OckerHazelbag/FunctionalSkin/Software/Arduino code/WhatsApp Image 2026-10-22 at 13.59.02 (2).jpeg

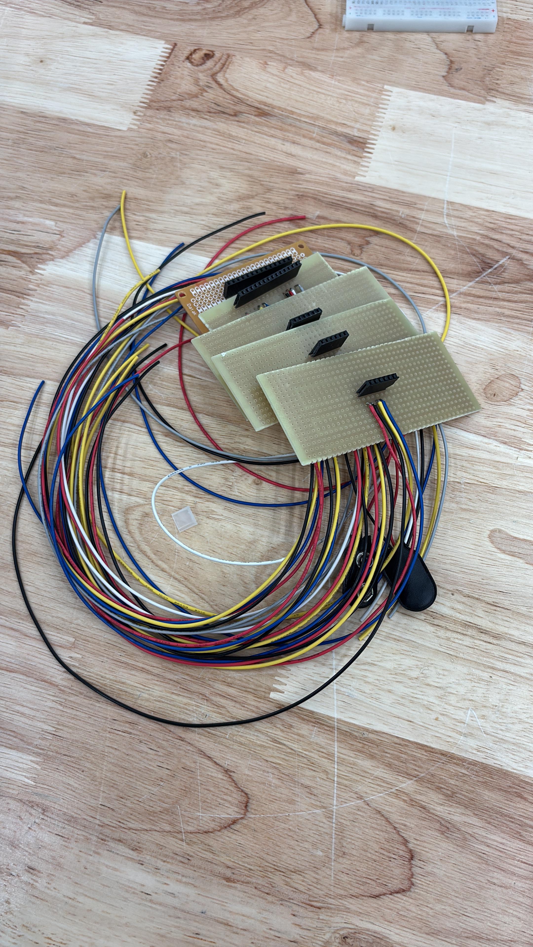
Software/Arduino code/WhatsApp Image 2026-10-22 at 13.59.02 (2).jpeg
