OckerHazelbag/FunctionalSkin/Documents/Functional Skin MIP FINAL REPORT-compressed.pdf

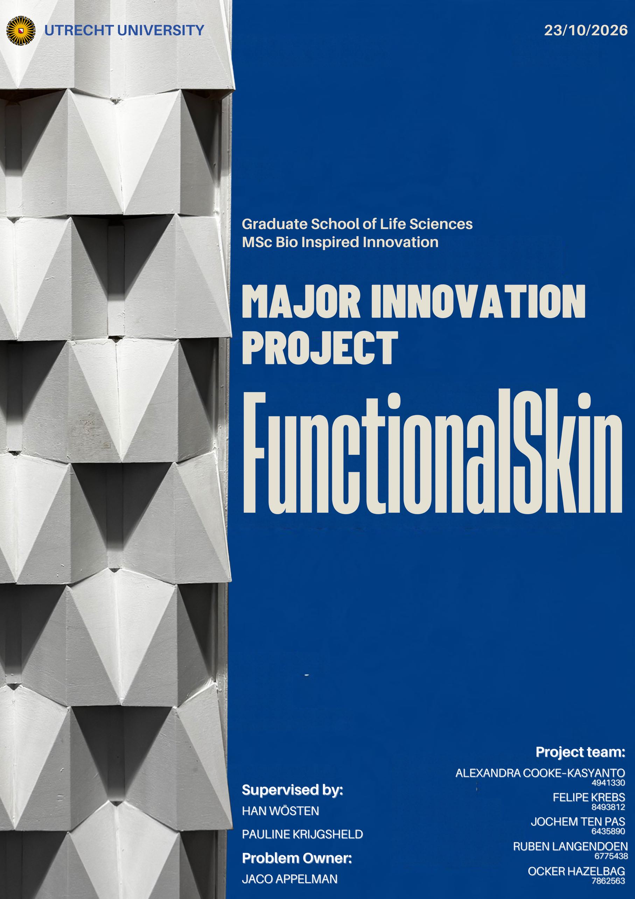
[picture p6: page 1]

FunctionalSkin | Major Innovation Project
MSc Bio Inspired Innovation | Utrecht University

## Layman summary

Urban heat stress is on the rise thanks to increasing global temperatures and inadequate cooling mechanisms in urban environments. To combat this, new methods are needed that are low energy, easy to implement and sustainable. We investigated how a modular panel installed on a building’s façade can help to passively cool the building’s outside and the immediate surrounding environment. It was found that a combination of a geometry that promotes air circulation, and a coating that combines solar reflection, with radiating its heat into space, can make for such a functioning panel.

Tests under simulated conditions of a hot Dutch summer day, showed that the temperature of the exterior wall of a building can be up to 30 °C lower with a passively cooling façade panel in front, than when fully exposed to the sunlight. The installation of such a panel could reduce active cooling energy demands and reduce temperatures in surrounding urban areas, which are the area’s most susceptible to extreme heat stress.

Furthermore, we investigated how this could be produced from biobased materials, like wood and fungal biomaterials. Some modifications, like coatings are needed to protect these natural materials from the outside conditions, like water and wind exposure. Nonetheless, it was shown through prototyping and experiments that a functioning passively cooling façade panel can be produced from these materials.

## Meet the FunctionalSkin team

We are the FunctionalSkin team from Utrecht University (left to right, top to bottom): Ruben Langendoen, Ocker Hazelbag, Jochem ten Pas, Felipe Krebs and Alexandra Cooke-Kasyanto. Our five backgrounds and perspectives come together in one shared goal: how can a building’s façade function like an urban living skin? Our façade panels help to cool buildings using similar techniques seen in nature, and do so completely passively – functioning without any need for energy!

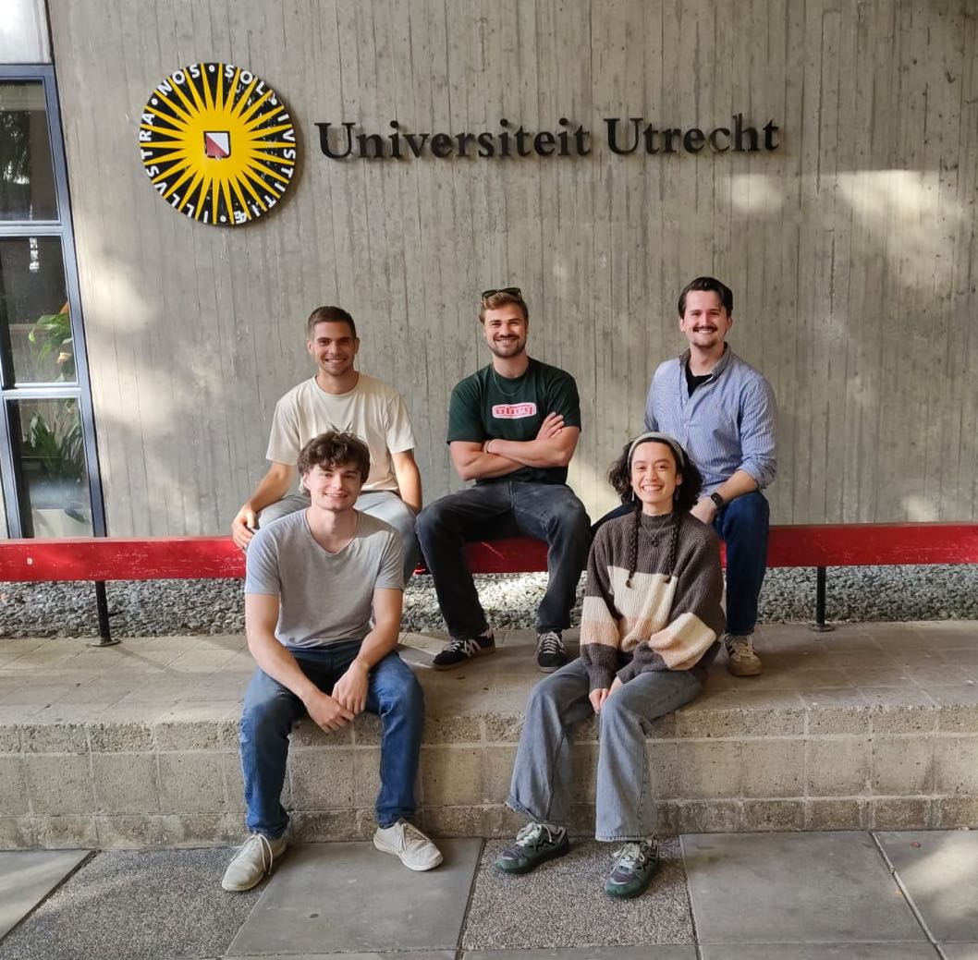
[picture p7: figure]

Index

## Abstract

Rising global temperatures intensify heat stress in urban environments and increase the need to cool down buildings in the Netherlands. This study investigates whether a façade panel can passively cool the outside of a building and its immediate surroundings. The panel combines a three-dimensional geometry, with cavities that remove hot air by convection, with a radiative cooling coating. Under simulated direct sunlight (800 W m⁻², 30 °C ambient temperature), we measured the temperature of the inner backwall behind the panel.

Compared with an unventilated bare backwall as a negative control, a flat panel with a radiative cooling coating already lowered the back-wall temperature from 64.0 °C to 46.2 °C. Adding the three-dimensional geometry and cavities reduced it further to 39.2 °C, and adding external airflow to simulate wind lowered it to 34.2 °C, only 4 °C above the ambient room temperature

Literature research and a Life Cycle Assessment (LCA) identified Douglas fir as the most suitable sustainable, biobased material, but plywood was chosen for prototyping purposes. We also tested heat-pressed mycelium-based composites (MBCs) as an alternative future material and showed that it can be formed into a three-dimensional shape. However, it needs more protection against outdoor weather conditions and less energy-intensive production before it could be implemented as a façade material.

## Graphical Abstract

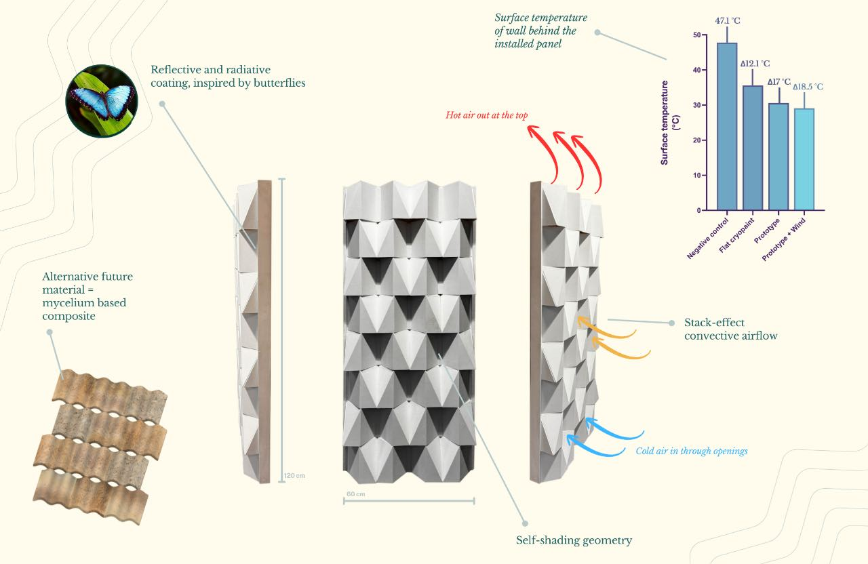
[picture p8: page 7]

## Theoretical background

Urban Heat Island effect
Rising global temperatures are impacting humanity and earth systems in many different ways. One of the challenges that arises in cities is the increasing severity of the Urban Heat Island (UHI) effect (Tong et al., 2021). This phenomenon is characterized by the difference in air-and surface temperatures between urban and rural environments. Several factors drive this mechanism, such as lack of greenery and elevated anthropogenic heat sources in cities (Jabbar et al., 2023; Masson et al., 2020). Another major contributor is the increased concentration of low-reflectivity (low-albedo) surfaces in urban areas (Andrés-Anaya et al., 2021).

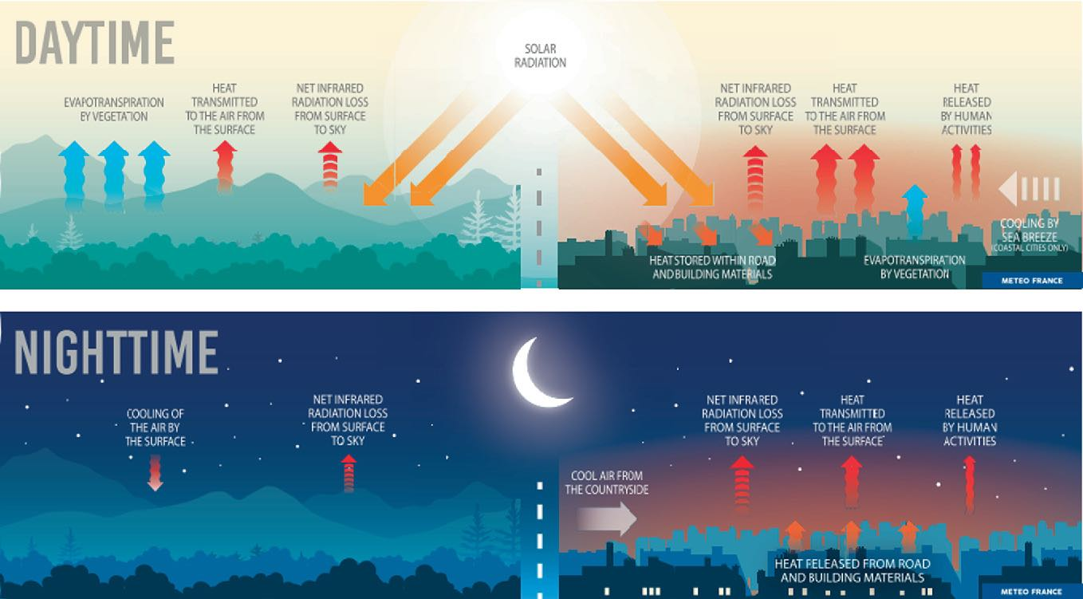
[picture p9: figure]

Figure 1: Processes driving urban heat islands during daytime and nighttime in rural (left) and urban (right) areas. Urban areas contain more surfaces that absorb solar energy during the day and release it at night, leading to higher temperatures at nighttime compared to the rural areas. Adapted from (Masson et al., 2020) Surfaces, such as roads, pavements, roofs and façades, have a low albedo, resulting in high absorption of incoming solar radiation (Ziaeemehr et al., 2023). These surfaces are often made from materials that possess a high heat capacity, such as asphalt and concrete, which can absorb more energy per degree of temperature rise than materials with a low heat capacity. This absorbed heat is then released at night, resulting in heated urban environments (Masson et al., 2020; Figure 1).

Researchers are conceptualising ways to mitigate the effects of UHIs, for example by reintroducing vegetation in urban areas, reducing the energy consumption of buildings and introducing high-albedo materials on roofs or façades (US EPA, 2014). The connection between building density and UHIs shows the opportunity that lies in redesigning buildings from drivers to barriers to elevated urban temperatures.

Retrofitting existing façades is one method to reduce the impact of buildings on urban heat, for example by introducing green walls, (retro)reflective coatings, phase change materials or thermochromic paints (Ahluwalia & Khurana, 2025; Han et al., 2015; Santamouris & Yun, 2020). A different way to approach it, is to design a façade cladding panel that also functions as a cooling panel. Currently, façade panels are mainly used for aesthetics, thermal regulation and weather protection (Thevega et al., 2022). However, by introducing an extra function within these panels, it is a possibility to create a multifunctional panel that is aesthetically pleasing, protects the building against weather conditions, and contributes to cooling the urban environment.
Passive cooling strategies
To design a panel that utilizes passive cooling strategies, it is necessary to know what passive cooling strategies exist. Nature serves as a useful guide to examine passive cooling methods. Organisms have to passively regulate their temperature, sometimes under energy constraints (Appendix B). Façade panels also have to deal with this constraint, which highlights the inspiration that can be gained from nature. Five passive cooling strategies of nature have been evaluated using scientific literature, namely evaporation, radiation, reflection, convection and conduction (Appendix B).

The most important findings from this literature research are the possible integrations of reflective, radiative and convective cooling strategies into the façade panel. An example of convection as a passive cooling strategy in nature can be found in termite mounds (King et al., 2015). Inside the mound, the air is warmer than the ambient air, resulting in the inside air rising by buoyancy while the cooler, more dense air sinks. This effect is called the stack (or chimney) effect and is already widely used in the construction industry in the form of ventilated façade systems (Girma & Tariku, 2021).

The potential integration of reflective and radiative cooling strategies into a façade panel also followed from the literature research (Appendix B). Reflection and radiation are closely related: for a surface to cool under direct sunlight, it must reflect most solar radiation, while simultaneously dissipating heat by emitting in the 8-13 µm atmospheric window. In this window, the atmosphere is almost transparent, absorbing close to zero thermal radiation (Pirvaram et al., 2022). Therefore, heat can be released to outer space without being retained in the atmosphere. Together, these two properties enable a net cooling effect during daytime.

Two other passive cooling strategies, conduction and evaporation, are present in nature, but were left out as strategy for cooling in this study. Evaporation has proven to be a successful strategy to cool buildings and the environment, as green walls and roofs have been widely implemented in architecture (Harbiankova & Manso, 2025). However, it often requires some type of active mechanism, such as watering, and is difficult to implement into a façade panel, combined with the other cooling strategies. Similarly, conduction was assessed to be outside of the scope of this project, and we therefore decided to focus on convection, reflection and radiation (Appendix B).

Previous students at Utrecht University and the HU University of Applied Sciences Utrecht have worked on creating a panel that passively cools buildings. This produced two outcomes: a conceptual design of panels inspired by tree bark (Pernice et al., 2022; Figure 2), and the design of a multi-layered panel with a specific three-dimensional geometry that employs convective cooling (Boer et al., 2025; Figure 2). However, what these projects did not assess is the possibility to combine convective cooling with radiative and reflective cooling.

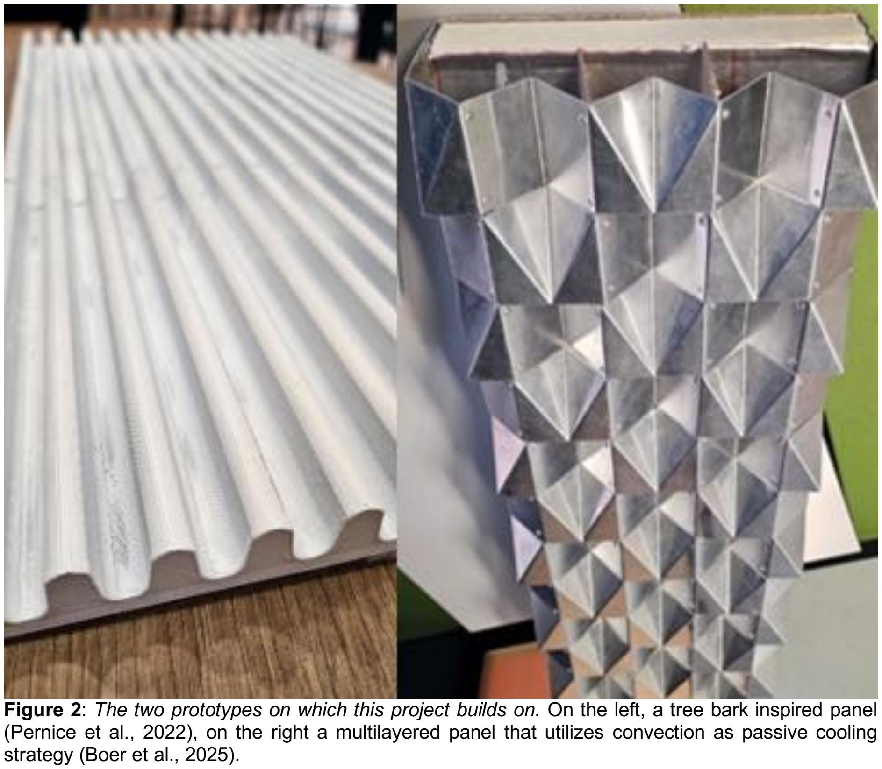
[picture p10: figure]
strategy (Boer et al., 2025).

Sustainable façade cladding materials
A cooling façade cladding panel can only contribute to a more sustainable urban environment if the material it is made from does not undo its benefits. Conventional façade systems carry a considerable environmental impact compared to their biobased alternatives (Alabdulrazzaq et al., 2026). Sustainable materials can reduce this impact, which is why their application in façade cladding is increasingly being researched (Sandak et al., 2019).

One of these materials is mycelium-based composite (MBC). MBCs consist of plant fibres, such as hemp or grass, bound together by a network of fungal hyphae, also called mycelium, which act as natural glue. MBCs have also been examined in combination with passive

Figure 2: The two prototypes on which this project builds on. On the left, a tree bark inspired panel (Pernice et al., 2022), on the right a multilayered panel that utilizes convection as passive cooling cooling. Soh et al. (2025) produced an MBC façade tile with a texture inspired by elephant skin, which retains water and thereby cools the surface.

However, this concept relies on evaporative cooling, which requires water, while moisture is precisely what limits the use of MBCs outdoors. Uncoated MBCs, such as those tested by Soh et al. (2025), have been shown to degrade after continuous exposure to weather and are therefore unsuitable for outdoor use (Ghazvinian & Gursoy, 2022; Motamedi et al., 2025). A possible intervention could be to grow a fungal skin on the MBC, which has been suggested to improve the hydrophobicity of the material (Appels et al., 2019). Moreover, the mechanical properties of MBCs can also be improved. Heat-pressing, for example, can improve the density, Young’s modulus and tensile strength of MBCs (Appels et al., 2019). Most heat-pressed MBC has resulted in flat panels and to our knowledge, heat-pressing MBCs into a three-dimensional shape has not been reported before (Andrade et al., 2026).
Research question and scope
Within our project, we set out to answer the following question: How can a façade panel, made from a sustainable material, passively cool buildings and their environment? One part of this project was therefore dedicated to producing a functioning panel with the highest cooling performance. In this part, we examined whether convection, radiation and reflection can be combined into one panel, starting with the geometry of Boer et al. (2025). We focused on innovating the outer skin by selecting a sustainable material, whose environmental impact was assessed in a Life Cycle Assessment (LCA), and by adding a reflective and radiative coating. The inner wall and insulation are considered outside the scope of this project.

The second part of our research focused on a sustainable material, MBC, and examined whether MBCs could potentially be used as a material for façade cladding panels in the future. By heat-pressing MBC into a three-dimensional shape, we investigated the possibility of producing individual MBC tiles which could be used for a façade panel. Furthermore, we tested what impact the three-dimensional shape had on the flexural strength and water resistance of the MBC. Lastly, we compared MBC to different types of wood to assess how long its lifespan should be to match their environmental performance.

The report is divided into three parts. Part A describes the design and prototyping of the panel and the choices made during this process. The first section of part B presents the outcome of the experiments which were conducted to assess the cooling performance of different panel configurations. The second section of B shows the research conducted on MBCs as a possible future façade cladding material. Part C addresses the implementation and business plan and analyses the intellectual property of our panel. Lastly, the general discussion evaluates the results of the experiments and discusses possible future integrations and research opportunities.

## Part A: Design and prototyping

In this part, the process that led to the design and development of our plywood prototype is described. This includes the requirements that were drafted for the design and material selection, the actual choice of material, the reasoning behind it and the chosen three-dimensional geometry of the panel. Lastly, the manufacturing method of the final prototype is described together with its dimensions and specifications. This part does not include the production of anything related to the MBC part of the project, which will be discussed in part B.3.
A.1. Design requirements and criteria
Façade cladding panels need to be multifunctional. As it is the outermost layer of a building, it needs to be both protective and aesthetically pleasing. In this project, we added an important functionality to the requirements: passive cooling. As convection was identified as the main passive cooling strategy, this impacted the design of the panel. The convective heat transfer is dependent on the geometry of the panel, as an increased and channelled surface area improves the buoyancy-driven airflow within the panel.

This led to three design requirements that were formulated in the Design Report (Appendix
D) (Figure 3). First, the cavity depth of the panel should be large enough to facilitate buoyancy-driven convection. The selected cavity depth ranges between 4 and 8 cm, similar to Boer et al. (2025). This is smaller than the depths of similar designs, such as solar chimneys (20 to 50 cm) or double-skin façades (70-120 cm). This reduced cavity depth offers the opportunity to examine whether convective cooling is also effective using smaller cavities.

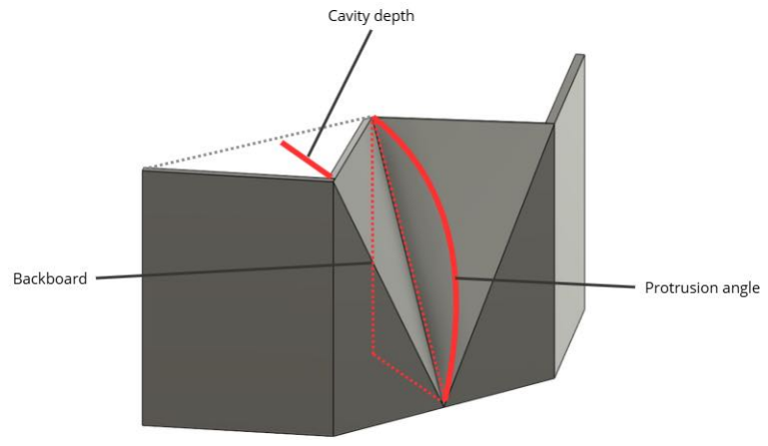
[picture p11: figure]

Second, the angle of geometric protrusions needs to improve the natural ventilation. No validated range for the angle has been established (Appendix D). The one study found, which looked different angles (0°, 30°, 45°, 60° and 80°) of venetian style blinds within a double-skin glass façade, reported that an angle of 80° promoted natural ventilation the most (by 35%) (Ji et al., 2007). The limitation of this study was that the blinds were behind glass and in windless conditions, so this study was mostly used as an indication. The precedent design by Boer et al. (2025) used an angle of 72°, which is close to the 80° found by Ji et al. (2007), and therefore also used in our design.

Figure 3: Visualization of geometric design requirements drafted in the Design Report. The protrusion angle is the angle between the protruding facet and the backboard. The cavity depth is the maximum distance between the backboard and the tile. The grey and red dashed lines indicate reference planes.

Lastly, the height of the panel must be sufficient to generate effective pressure differences to drive the chimney effect. For an optimised effect, the height of the façade should be more than two storeys (minimum of 6 m) (Appendix D). Therefore, it is important that the design of the panel allows continuous air movement through multiple panels.

These design requirements in turn impose a manufacturing requirement, namely that the individual tiles need to be formed into a specific three-dimensional geometry. Therefore, this became one of the defining criteria for the material selection, alongside several other requirements (Table 1; Appendix C). As a result of the drafted requirements, the material will need to be a thermal barrier, able to be painted or coated, lightweight and recyclable, as well as available to us and formable into the correct shape.

Table 1: Requirements on material properties. From left to right, the criterion, type of requirement (threshold or qualitative) and whether it is a hard constraint or ranking criterion. Reasoning behind certain thresholds or constraints can be found in the Material Selection Report (Appendix C).
Criterion | Threshold or qualitative | Hard constraint or ranking criterion

Thermal barrier

Thermal conductivity | Below 0.5 W m⁻¹ K⁻¹ | Hard constraint

Surface treatability

Paint/coating compatibility | Qualitative | Hard constraint

Weather resistance

UV resistance | Qualitative | Ranking criterion
Water absorption rate | Qualitative | Ranking criterion
Freeze-thaw resistance | Qualitative | Ranking criterion

Weight

Surface density | Below 10 kg m⁻² | Minimum requirement – Ranking criterion

Fire resistance

Fire resistance | Fire class B, s2, d0 | Ranking criterion

Sustainability

Recyclability | Qualitative | Hard constraint
Biodegradability | Qualitative | Ranking criterion

Biobased content | Qualitative | Ranking criterion

Formability & availability

Material availability | Qualitative | Hard constraint
Material formability | Qualitative | Hard constraint
Instrumentation availability | Qualitative | Hard constraint
Prototyping feasibility | Qualitative | Hard constraint

A.2. Material selection
The set of requirements in Table 1 was used to assess several materials that are commonly used in façade cladding systems (Appendix C). This included metals, glass, plastics, fibre-reinforced composites, Nabasco® (a commercially available bio-composite cladding material used in the Netherlands), mycelium-based composites (MBC) and wood. In the end, wood was selected as material to use for the panel, as it was available, recyclable and lightweight. Additionally, wood can be painted or coated and possessed the required thermal barrier properties (Table 2).

Table 2: Materials assessed based on the requirements from the Material Selection Report and the decisive criterion by which it was rejected.
Material / material class | Outcome | Decisive criterion
Metals | Rejected | Thermal conductivity
Glass | Rejected | Weight, formability and thermal conductivity
Plastics | Rejected | Recyclability
Fibre-reinforced composites | Rejected | Weight and recyclability
Nabasco® | Rejected | Weight, availability
Mycelium-based composites | Rejected | Weather durability
Wood | Selected | Passed all hard constraints

The next step was to assess which type of wood would then be most suitable for the façade panel. For this, the wood types most commonly used for façade cladding were assessed on natural durability classification, density, price and sustainability. Additionally, wood modification methods were discussed. Douglas fir was identified as most suitable regular wood type for the panel production, as it is durable, cheap, lightweight and available (Appendix C). A potential other type of wood was thermally modified spruce (TMS), which is more expensive but also more durable and dimensionally stable than Douglas fir (Appendix C).

At the prototyping stage, however, it became apparent that thicker cuts of wood would impose difficulties in manufacturing. The 20 mm thick planks made manufacturing with the computer numerical control (CNC) mill, which we selected for producing the grooves in the individual tiles, more time intensive and increased the weight of the façade significantly. Therefore, plywood was used to make the first prototype of the façade panel, as it is thin, cheap and available in large sheets. Although plywood (excluding exterior/marine plywood) is not suitable for outdoor conditions, the prototype was not tested on weather durability, making plywood a suitable and justified material for this prototype.

To decide on the final material for the design, the four considered types of wood (Douglas fir, indoor and outdoor plywood, TMS) were assessed on environmental impact in a cradle-to-gate LCA, where they were compared with MBCs (Appendix E). The functional unit (FU) of this LCA was 1 m² of façade coverage by the panels. This analysis was then related to the lifespan of each material to examine whether increased production impact is justified by longer durability of the material (Appendix E).

Douglas fir was calculated to have the lowest global warming potential (GWP), both in total (~ 4.02 kg CO₂e/FU) and per year (0.27-0.40 kg CO₂e/FU; Table 3). TMS had the second least yearly GWP, whilst having the highest CO₂e output in total (Appendix E). This is mainly because of the increased lifespan resulting from the thermal modification.

MBC had the second lowest GWP (~11.34 kg CO₂e/FU), less than both plywoods and TMS. This suggests that MBC has the potential to be an environmentally competitive construction material, in terms of production impact, if weather durability can be increased. As of yet, the lifespan in outdoor conditions of MBC has not been assessed (Lewandowska et al., 2025), which is why no estimation of the GWP per year is given in Table 3. MBCs need to last for 28-42 years to have the same GWP/year as Douglas fir, or 10-13 years to have a comparable yearly GWP as TMS.

Table 3: Comparison of global warming potential of each material relative to its service life. Derived from the LCA (Appendix E).
Material type | GWP (kg CO2e/FU) | Lifespan (in outdoor conditions) | GWP/year
Douglas fir | 4.02 | 10-15 years | 0.27-0.40
Indoor plywood | 13.53 | 1 year | 13.5
Outdoor plywood | 15.52 | 5-10 years | 1.55-3.10
TMS | 22.10 | 20-25 years | 0.88-1.11
Mycelium-based composite | 11.34 | Unknown | Unknown

The research on heat-pressed MBC and plywood as materials for the prototype were conducted in parallel. The development of the plywood panel is described in the next section, whereas the research on heat-pressed MBC is presented in part B.3.
A.3. Design development and selection
The concept and design of our panel started with the panel that was produced by Boer et al. (2025). This panel involved a faceted design incorporating small air gaps, or “chimneys”, to create a convective airflow that passively cools. This multifaceted design simultaneously resulted in a self-shading effect. The measured effect of this panel was small: an air speed of 0.3 m s⁻¹ in the cavity and a 3.4 °C reduction in temperature of the backwall was observed.

Studies using comparable designs showed that such faceted designs can have a cooling effect on buildings. A study in Dubai recorded a 10 °C temperature gradient between the upper and the lower part of a façade, indicating a temperature-driven airflow (Pujadas-Gispert et al., 2020). Similarly, Summa et al. (2025) found that a faceted design can reduce the temperature by 10 °C compared to a flat panel, as well as decreasing the temperature of the corresponding backwall by 1.3 °C, highlighting the self-shading effect of the design.

Based on these results, it was decided to develop a panel with the same shape. Inspiration to further innovate the design was acquired from the Cooling Mechanisms Report (Appendix B). For example, inspired by cacti, a ridged design was considered, as it could increase the self-shading potential of the panel and act as additional air channels to increase convection. When this iteration was modelled, it proved to be difficult to align the ridges at the points where they cross the facet edges (Figure 4). This could not be resolved within the timeframe into a form which could be cleanly cut by the CNC. Therefore, the ridged design was dropped from the project.

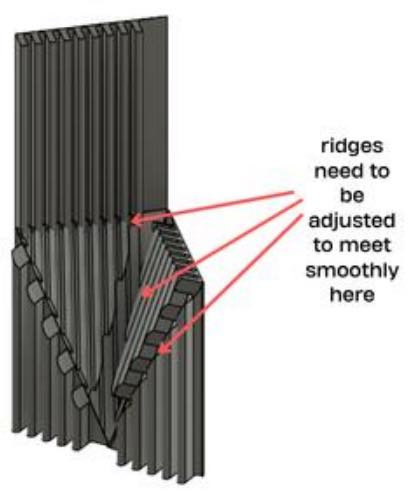
[picture p12: figure]

Additionally, reflective and radiative coatings which mimic the cooling capabilities of the Saharan silver ant were examined. The microstructures that this insect utilizes were too small to replicate at this scale, which is why different commercially available reflective and radiative coatings were tested. The outcomes of these experiments will be discussed in Part B.2.

The decision to make modular, 15 x 15 cm tiles, which together would form the larger panel, was inspired by Pujadas-Gispert et al. (2020). In this study, they created larger, 30 x 30 cm tiles of Nabasco®, which they installed onto a plywood backboard. This led us to the decision to make modular tiles of wood which we would then install on a wooden backboard.

To develop the modular, 15 x 15 cm tile, a laser-cut first prototype was assembled from scrap plywood and resulted in gaps between part of the tiles (Figure 5). Therefore, grooves were milled into individual cut plywood, while keeping the outer veneer of the plywood intact. This method, used in other woodworking practices, can result in a seamless outer layer (Steve Szell, timber specialist, personal communication, 24 April 2026). This resulted in tiles that were folded into the correct shape upon heat and steam pressure, resulting in a seamless outer layer.

Figure 4: The design of a ridged tile. The arrows indicate the points where the facet edges cross, which proved to

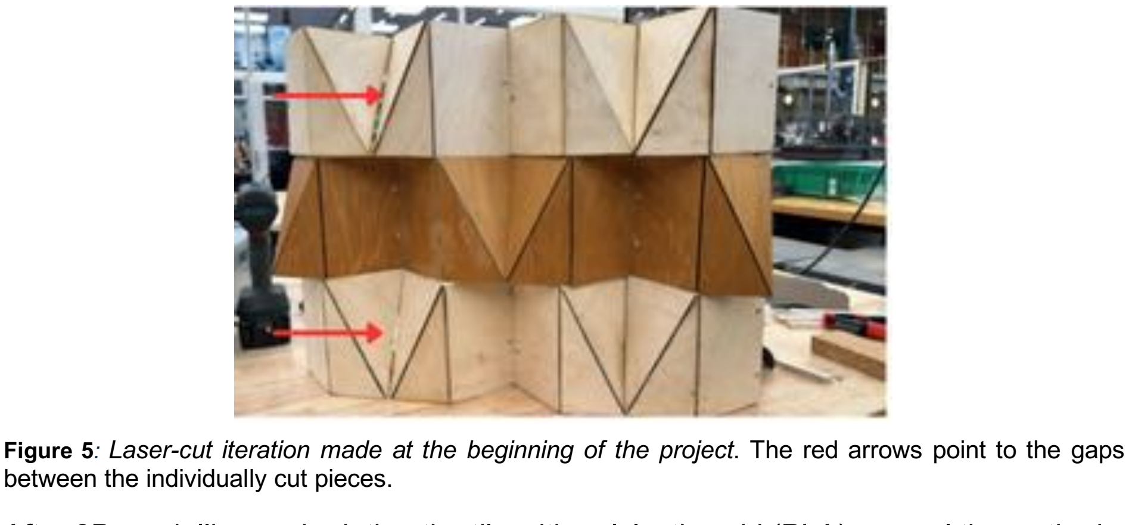
[picture p13: figure]
between the individually cut pieces.

After 3D-modelling and printing the tile with polylactic acid (PLA) several times, the best way to design the top corner joints, where the three facets meet, was determined. At first, the top corner joints did not align, which imposed difficulties with folding the tile into the correct shape. This led to a reorientation of the angles of the top corner joints, ensuring a clean fold and a 135° angle along the groove (Figure 6). These refinements resulted in the final design of the tile, which was created in Fusion 360 (Autodesk, San Rafael, CA, version 2704.1.15). From this, a toolpath to an open-source CNC router was generated, which could then be used to cut the tiles from plywood sheets using the CNC mill.

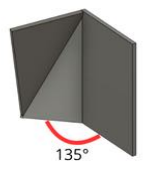
[picture p14: figure]
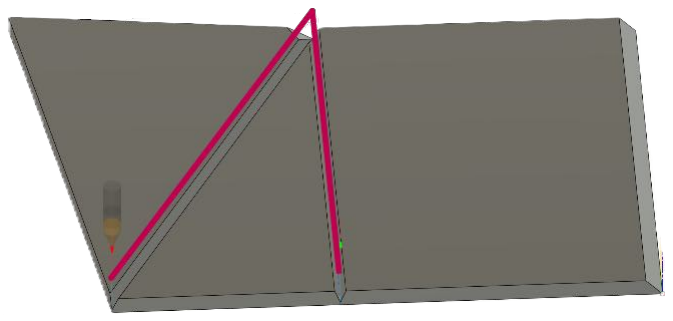
[picture p15: figure]

The final design that was used for the prototype was a 15 x 15 cm tile with the shape that was used by Boer et al. (2025). Two inverse versions of the tile were developed, sixteen of each, which would then be mounted onto a 120 x 60 cm backboard. The individual tiles were milled using the CNC and folded into the correct shape. The full manufacturing of the panel will be discussed in Part A.4.
A.4. Manufacturing and assembly
The tiles were produced using a CNC mill (CNC-Step, High-Z S720T). This ensured consistent cuts across all tiles and allowed the exact angles and depth of each groove to be set. It also could demonstrate the potential ability to scale up the production, if proven to be

Figure 6: Toolpath of 45-degree V-groove and the resulting 135° angles after folding

Figure 5: Laser-cut iteration made at the beginning of the project. The red arrows point to the gaps a successful method of manufacturing. The folding step, however, was completely manual, which could have impacted the accuracy of the folded geometry.

The created toolpath consisted of three milling operations, each with a different bit: to create the angle that needed to be mounted to the backboard, a 90° V-groove milling bit was used. A flat-top milling bit was used to trace the contour of the tiles; and a 45° V-groove milling bit was used to produce the 135° folds needed for the design (Figure 6). The 45° path was cut to a depth leaving approximately 1 mm of material, so that the plywood could be folded at that position while the outer veneer layer stayed intact.

For the two V-groove milling bits, a spindle speed of 26000 rpm was used, while for the flat-top milling bit, a spindle speed of 32000 rpm was used. By posting the toolpath in Fusion 360 (Autodesk, San Rafael, CA, version 2704.1.15) the file was converted into a G-Code file, which could be read by the CNC router. Using this G-code, six tiles at a time were milled out of 65 x 34 cm plywood sheets with a thickness of 5.5 mm (Figure 7). To get a seamless connection of the tiles on the backboard, a 5 mm strip was removed from each tile at the 45° angle by sawing.

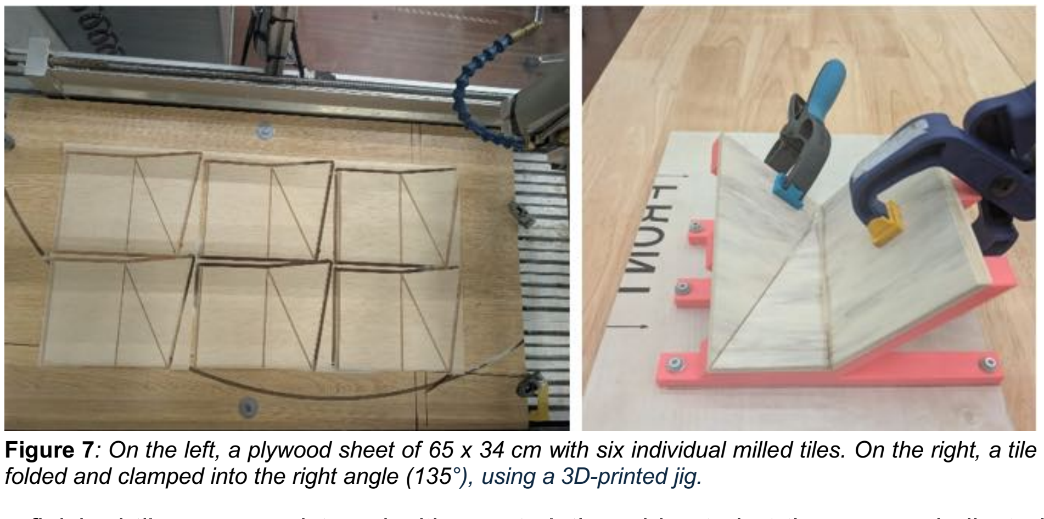
[picture p16: figure]

The finished tiles were moistened with a wet cloth and heated at the groove dedicated for bending with a handheld clothing steamer (Pure POP DT2022, Tefal) for ~ 2 min to induce flexibility of the wood fibres. Under continued heat application via the steaming iron they were folded to 135°, held in this position using a 3D-printed jig (Figure 7) and bonded using polyurethane construction adhesive (Bison Konstruktielijm, EN 204 class D4). Each tile was clamped for four hours, following the manufacturer’s manual. The exact dimensions of the panels as they were manufactured in the CNC as well as the dimensions of the 3D-printed jig can be found in the supplementary data (Appendix I).

The backboard was constructed using 48 x 22 mm spruce battens (KONSTA Vuren panlat ruw 22 x 48 x 2100 mm, Hornbach), joined with waterproof wood glue (Pattex, EN 204 class D3) and 35 mm nails using a nail gun (Bostitch Tacker SB-2IN1-E). Five battens run lengthwise and nine across, resulting in a 120 x 60 cm backboard.

Figure 7: On the left, a plywood sheet of 65 x 34 cm with six individual milled tiles. On the right, a tile folded and clamped into the right angle (135°), using a 3D-printed jig.

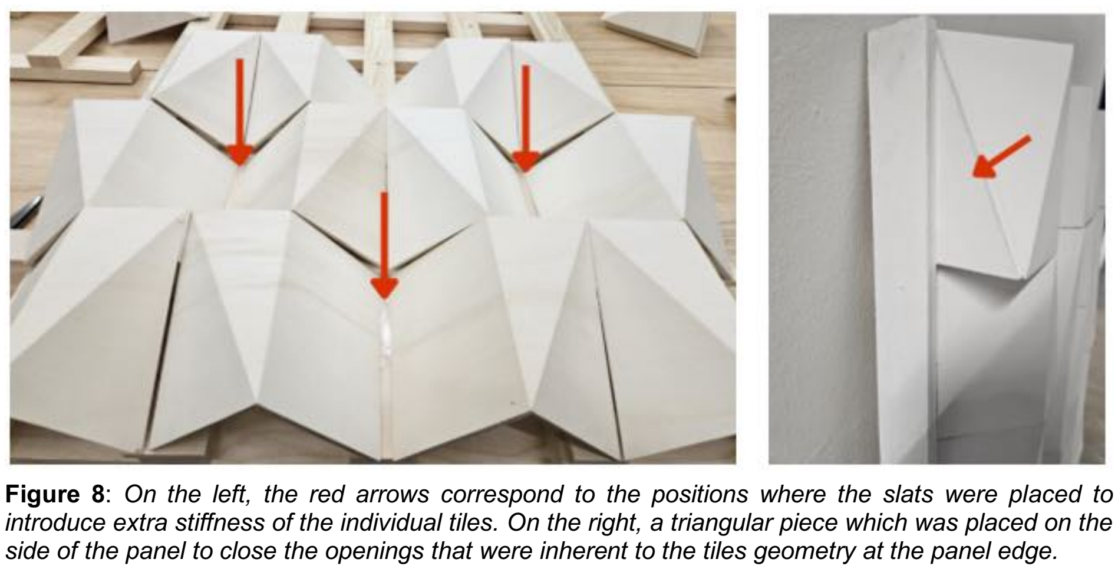
[picture p17: figure]

The tiles were attached to the backboard with wood glue (Pattex, EN 204 class D3) and 15 mm nails, using a nail gun (Bostitch Tacker SB-2IN1-E). Between each pair of inverse tiles, slats sawn at a 45° angle, were added to introduce extra stability (Figure 8). Wood glue and nails (15 mm) were also used for this application. At the sides, where the tiles left large openings, sawn triangular pieces of plywood were also added and adhered using construction glue (Bison Konstruktielijm, EN 204 class D4) (Figure 8). Seams that remained after tiles were mounted on the backboard were filled with a white acrylic sealant (Kelfort acrylkit anti-crack) (Figure 9).

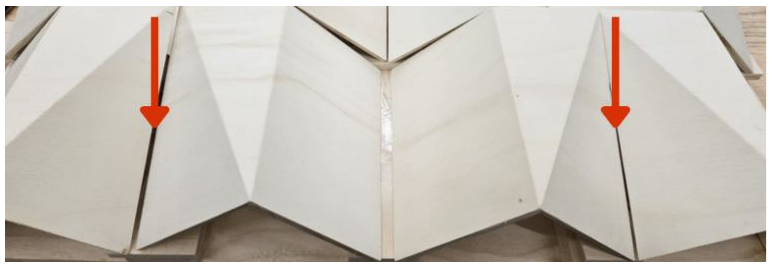
[picture p18: figure]

Finally, the panel was painted with a radiative cooling paint (CryoPaint®). This paint was selected based on the heat transfer and convection experiment reported in Section B.2. Three coating layers were applied with a brush to achieve full coverage. Every layer of applied paint was dried for at least 24 h before the next layer was applied. Only the outside facets of the panel and the sides were painted, leaving the inner cavity side uncoated.

Figure 8: On the left, the red arrows correspond to the positions where the slats were placed to introduce extra stiffness of the individual tiles. On the right, a triangular piece which was placed on the side of the panel to close the openings that were inherent to the tiles geometry at the panel edge.

Figure 9 : The seams which were caulked up using a white acrylic sealant after they

A.5. Final FunctionalSkin prototype
The process described in Part A.4 resulted in the final plywood panel (Figure 10). The maximum cavity depth was 8 cm. This closely corresponds to the design requirements drafted in Part A.1, where the desired cavity depth ranged between 4 and 8 cm. The protrusion angle in the final design was 75°. In the design requirements, it was stated that the most effective pressure differences to drive the chimney effect would be reached with a height of more than two storeys. Within the scope of this project, only one panel of 120 x 60 cm was manufactured, which is not high enough to reach the most effective pressure differences. However, if more panels are stacked onto each other, a continuous airflow could be facilitated, thereby reaching the desired effect.

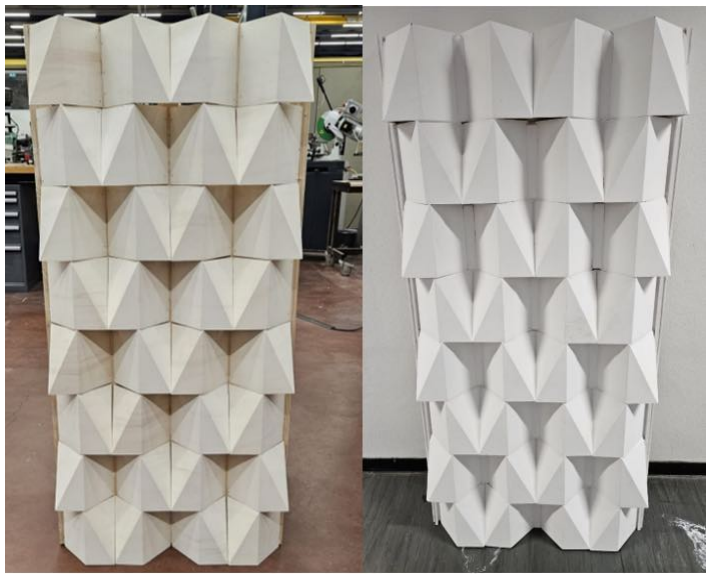
[picture p19: figure]

Figure 10: On the left, the 120 x 60 cm FunctionalSkin panel after mounting the individual tiles onto the backboard. On the right, the final panel with slats between the tiles, caulked up seams and painted with radiative cooling paint.

## Part B: Experiments and material testing

B.1. Introduction to experimental foci
To investigate the design, materials and functionality of the FunctionalSkin façade panel, the experimental procedure was undertaken two-fold. Firstly, a timber façade was tested for its ability to transfer heat via convective flows, with iterative tests to seek the best formulation of material and processing. Secondly, the novel 3D heat-pressing of MBC was explored as a potential future material to broaden the future scope of the project. Together, this multidimensional investigation explored the potential of biobased products while maintaining functional capabilities and pushing for boundary exploration.

B.2. Heat transfer and convection

B.2.1. Introduction
The objective of this study was to evaluate the thermal performance of several ventilated façade panel configurations under controlled laboratory conditions. The experimental work focused on quantifying the thermal behaviour of the FunctionalSkin façade panel by measuring surface temperature, cavity air temperature, airflow velocity and simulated solar irradiance. Attention was given to the influence of façade geometry, material thickness and surface treatment on the development of buoyancy-driven airflow within the ventilated cavity.

Each ventilated façade panel consisted of an exterior cladding layer, a naturally ventilated air cavity and an interior plywood wall. When exposed to simulated solar radiation, the exterior cladding absorbed thermal energy, increasing its surface temperature. Heat was subsequently transferred to the air inside the cavity, creating vertical temperature gradients. These temperature differences generated buoyancy forces that induced upward airflow through the cavity, drawing cooler ambient air into the lower opening while exhausting warmer air through the upper opening. This natural ventilation mechanism reduces heat transfer towards the inner wall and improves passive cooling performance (Moran et al., 2010; Picallo-Perez & Sala-Lizarraga, 2023).

To characterise these processes, air temperature was measured at multiple locations within the cavity, together with airflow velocity, at the cavity inlet and outlet. Surface temperature of the façade components was continuously monitored, while infrared thermography was used to visualise the spatial temperature distribution across the exterior façade surface. The resulting data were used to quantify temperature gradients, airflow characteristics, and transient thermal behaviour of the ventilated façade panels (Figure 11).

The insights gained from the rectangular shafts informed the design and testing of a full-scale bio-inspired prototype façade panel inside a walk-in environmental climate chamber. The climate chamber experiments evaluated the performance of the complex three-dimensional folded prototype panel, coated with CryoPaint®, against a flat CryoPaint® reference and a bare unventilated control. Additionally, this setup tested the façade under a fixed ambient summer temperature baseline (30 °C) both with and without the presence of an external airflow stream, resolving whether ambient wind reinforces internal cavity convection and enhances building skin cooling.

B.2.2. Materials and methods

B.2.2.1 Materials and methods: Rectangular shafts
A combination of contact sensors, air probes and non-contact thermal imaging equipment is used to measure airflow within the cavity, cavity air temperature and surface temperature of the outer façade panel and the inner layer.

Ventilated façade panels
Eight ventilated façade panel configurations were investigated (Table 4). Unless noted otherwise, all configurations had nominal dimensions of 600 mm (height) × 300 mm (width) with an 80 mm cavity depth and were mounted on an identical 12 mm plywood backboard.

Airflow velocity measurements
Airflow velocity within the ventilated cavity was measured using a Testo 410i vane anemometer (Testo, Titisee-Neustadt, Germany). Velocity measurements were performed near the lower and upper outlet openings of the ventilated cavity to quantify the magnitude of buoyancy-induced airflow generated during heating.

Table 4 Structural, Material, and Surface Specifications of the Evaluated Ventilated Façade Panel Configurations. Unless otherwise specified, all panels measured 600 mm × 300 mm and contained an 80-mm ventilated cavity mounted on a 12-mm plywood backboard. CryoPaint® refers to the radiative cooling surface treatment, whereas the albedo coating refers to the high-albedo reflective coating.

Ventilated facade panel configuration | Description of configuration
Standard panel | Constructed entirely from 5.5 mm plywood with an 80 mm ventilated cavity.
Deep cavity panel | Identical to the standard configuration except for an increased cavity depth of 160 mm.
9 mm panel | Identical geometry to the standard panel but manufactured from 9 mm plywood.
12 mm panel | Identical geometry to the standard panel but manufactured from 12 mm plywood
Negative control | Identical to the standard configuration except that the lower cavity opening was sealed, preventing natural air intake while maintaining the upper cavity opening.
albedo-coated panel | Standard panel coated with four layers of high-albedo reflective paint (Arcareflect 1198, Arcane Industries, Aubagne, France).
CryoPaint®-coated panel | Standard panel coated with three layers of radiative cooling paint (CryoPaint®, Cryo X Co., United States).

Air temperature measurements
Air temperature within the panel cavity was measured using two Testo 605i thermo-hygrometers (Testo, Titisee-Neustadt, Germany). Air temperature data were recorded using the Testo Smart App on an iPad Pro (Apple Inc., model 2020) and exported as comma-separated value (CSV) files. The probes were positioned at the lower and upper sections of the cavity to capture the vertical temperature profile associated with buoyancy-driven airflow. The lower sensor measured the incoming air temperature, and the upper sensor measured the outlet air temperature. These measurements enabled the determination of the cavity temperature gradient and the temperature increase experienced by the air while flowing through the cavity.

Surface temperature measurements
Temperature of the outer and inner surface of the exterior cladding (called STFO and STFI respectively), the inner backwall surface temperature (STBI) and the backwall surface of the plywood backwall (STBB) were measured using a Pico Technology TC-08 thermocouple data logger (Pico Technology Ltd., Cambridgeshire, United Kingdom) connected to Type K thermocouples. The thermocouples were attached to the measurement surfaces using thermally conductive adhesive to ensure good thermal contact and minimise contact resistance. Temperature data were recorded using PicoLog software (Pico Technology Ltd., Cambridgeshire, United Kingdom) on a MacBook Pro (Apple Inc., model 2019) and exported as CSV files for further analysis.

Spatial temperature distributions of the exterior façade surface were recorded using a Testo 860i infrared thermal camera (Testo Titisee-Neustadt, Germany). Infrared images were obtained during heating and after the heat source had been switched off to visualise temperature distributions and cooling behaviour of the different façade configurations (for schematic of sensor placement see Figure 11).

Simulated radiation measurements
Irradiation was simulated using two 1000 W halogen construction lamps (Fenon R7s, Keraf, Rotterdam, Netherlands) positioned at a distance from the façade panel to expose the surface of the cladding with 800 W m⁻² of light. The simulated solar irradiance on the façade surface was measured using a pyranometer (SL 200 Solarimeter, Kimo Instruments) prior to each experiment to verify light exposure.

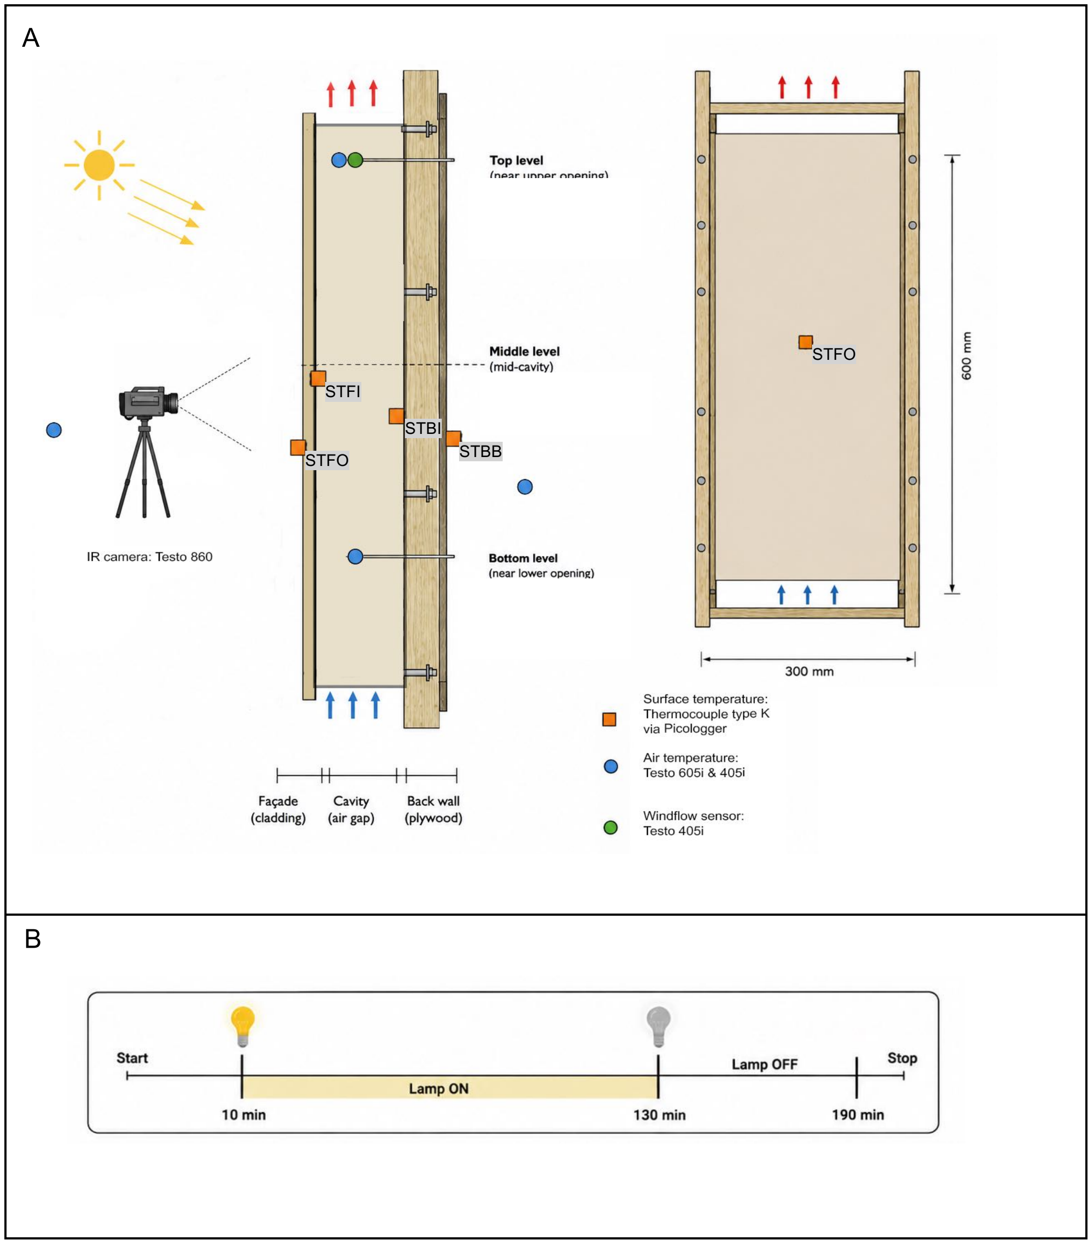
[picture p20: figure]
STFO; STBI; STFI; STBB

Figure 11: Schematic layout of the experimental set up and timeline. (A) Cross-sectional and front elevations of the ventilated façade test panel showing principal dimensions (600×300 mm) and sensor placement. Instrumentation includes Type K thermocouples for surface temperature (STFO, STFI, STBI, STBB), Testo 605i thermo-hygrometers for vertical cavity air temperature (Ttop, Tbottom), hot-wire anemometers (Testo 405i) for cavity airflow velocity, and an infrared thermographic camera. Red arrows denote buoyancy-driven convection. (B) Chronological protocol illustrating the initial ambient baseline (0–10 min), the active heating phase under simulated solar irradiance (10–130 min), and the post-exposure cooling phase (130–190 min).

Data preprocessing and time synchronisation
All data processing and statistical analyses were performed in R. Raw data exported from the Testo and PicoLog software were imported into R. Non-numeric metadata and summary rows contained in the exported files were automatically removed during preprocessing. Since the Testo logger recorded absolute timestamps whereas the PicoLog software stored elapsed measurement times, all datasets were synchronised using the Testo logger as the common temporal reference. Sensor measurements were subsequently converted to elapsed experimental time relative to the start of each experiment. To facilitate comparison between sensors with different sampling frequencies, all datasets were resampled onto a common 10-second time grid. For measurements recorded at higher sampling frequencies, observations within each 10-second interval were averaged before merging the datasets into a single time series.

Phase identification
The thermal response of each ventilated façade panel was divided into three phases: the heating phase, during which temperatures and airflow increased following activation of the heat source; the quasi-steady-state plateau phase, during which the measured variables approached stable values while the heat source remained active; and the cooling phase, which began after the heat source was switched off.

The onset of the plateau phase was identified independently for each sensor using the Kneedle knee-detection algorithm (Satopaa et al., 2011) the algorithm was applied to the transient heating segment, from the start of heating to the peak measured value to identify the knee point based on the deviation of the response curve from a linear reference. This approach accounts for the differences in the thermal response of individual measurement points arising from their location, thermal mass, and measurement principle. As a result, the identified onset of the plateau phase was sensor-specific and did not necessarily occur at the same time for surface temperatures, cavity air temperatures and airflow velocity.

For each measured variable, the mean value was calculated using the datapoints recorded during its identified plateau phase. These mean values were used to compare the thermal and aerodynamic performance of the different façade configurations. In addition, the time required for STBI to reach is identified plateau phase was displayed as tplateau in Table 5. The sensible heat transport rate (Q̇ air) was calculated using the mean values of the sensor measurement over their respective sensor-specific plateau phase intervals. Because the plateau phase was identified indecently for each sensor, this interval did not exactly coincide. The calculated sensible heat transport rates should therefore be interpreted as approximate comparative estimates.

Thermal analysis
The thermal measurements were combined with a dynamic energy and exergy analysis methodology adapted from Picallo-Perez et al. (2023). To this end, sensor data were used to quantify the following parameters that have an influence of the cooling capacity of the ventilated façade.

Vertical air temperature gradient was calculated using formula (1).

(1)

Where Tbottom and Ttop are the air temperatures (°C) measured at the lower and upper cavity openings, respectively. This change in air temperature was determined to evaluate whether a higher difference in air temperature along the vertical gradient of the tube would result in an increased wind speed.

The heat removed by natural ventilation within the cavity was estimated from the sensible heat transported by the airflow:

(2)

Where Q̇ air is the sensible heat transport rate (W), ṁair is the air mass flow rate (kg s⁻¹
), cp is
the specific heat capacity of the air (J kg⁻¹ K⁻¹), and ΔTcavity is the air temperature difference (°C) between the upper and lower cavity measurement points as described above.

The air mass flow rate (ṁair) was calculated as:

(3)

where vair is the measured air velocity (m s⁻¹), Acav is the cavity cross-sectional area (m²), and ρair is the air density (kg m⁻³).

B.2.2.2 Prototype panel
To evaluate convective cooling performance under representative summer ambient conditions, experiments were conducted inside a climate chamber (Lectoraat Nieuwe Energie in de Stad, HU University of Applied Sciences Utrecht) maintained at a constant dry-bulb temperature of 30.0 ± 0.5 °C and 50-60 % relative humidity. The testing frame accommodated three primary test configurations mounted vertically to a 12 mm plywood backwall: (i) an unventilated negative control representing an exposed bare wall without cladding, (ii) a flat panel coated with radiative cooling CryoPaint® and (iii) the prototype panel coated with CryoPaint®. This coated prototype was evaluated under natural convection

(quiescent chamber air, < 0.2 m s⁻¹) and forced convection with a continuous ambient wind field (2 - 4 m s⁻¹) directed across the façade surface.

Solar irradiation was provided by three fixed halogen lamps of the same type as those described in Section B.2.2.1. Irradiance at the exterior panel surface was maintained at approximately 800 W m⁻² and monitored using a calibrated solar pyranometer. Surface temperatures (STFO, STFI, STBI and STBB) was recorded using the thermocouple system described in Section B.2.2.1 to Type K thermocouples.

As shown in Figure 12, the climate-chamber setup differed from the rectangular-shaft setup (Figure 11) by incorporating the three-dimensional folded prototyped and paired airflow sensors positioned near the lower inlet and upper outlet of the prototype. These two testo 405i thermal hot-wire anemometers positioned recorded both airflow velocity and air temperature at these locations. Two additional testo 605i thermos hygrometers monitored the ambient air temperature in the climate chamber and the indoor-side air temperature behind the backwall.

Data logging, time synchronisation, resampling to a common 10-second time grid, and phase identification followed the procedures described in Section B.2.2.1.

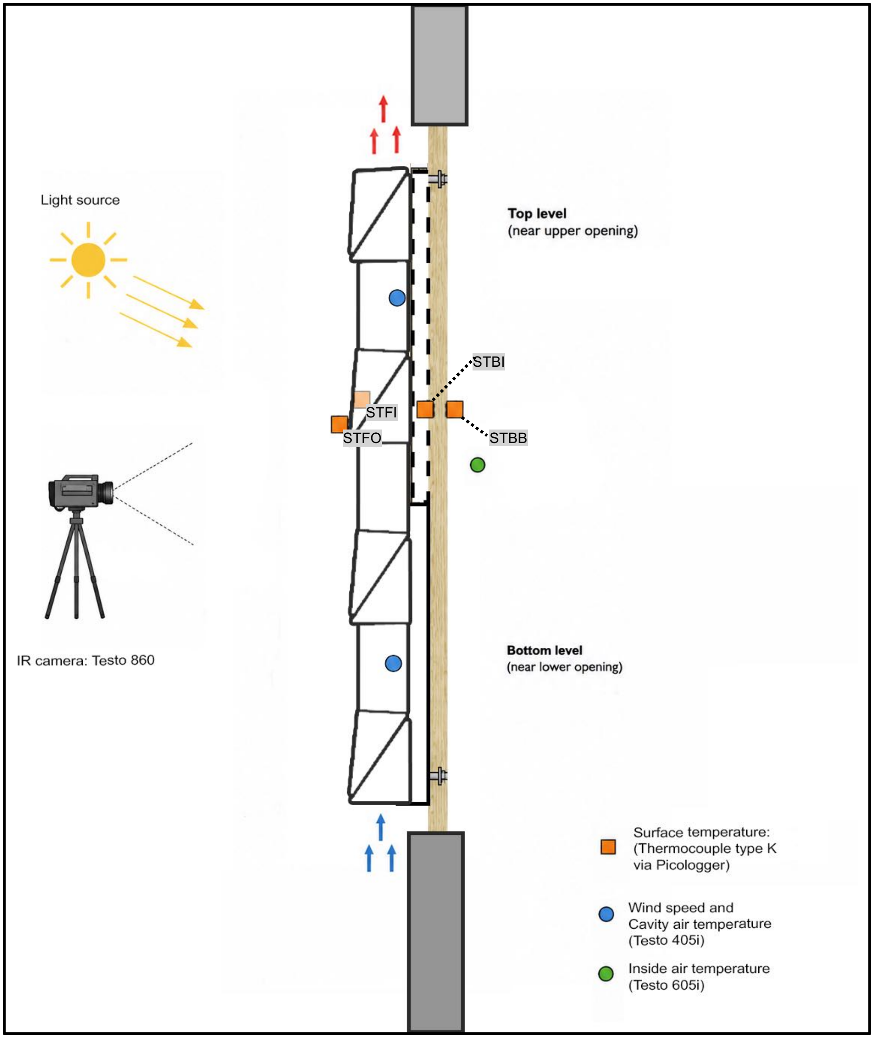
[picture p21: figure]
STFO; STBI; STFI; STBB

Figure 12: Schematic layout of the climate-chamber experimental setup for the prototype façade panel. The schematic shows the three-dimensional folded façade prototype mounted on a plywood backwall within the climate chamber. Type K thermocouples measured surface temperatures, while Testo 405i probes measured cavity airflow velocity and air temperature near the upper and lower openings. A Testo 605i probe measured indoor air temperature behind the backwall. Arrows indicate the expected direction of buoyancy-driven airflow, and the light source represents the simulated solar irradiance applied to the façade.

B.2.3. Results
B.2.3.1 Results: Rectangular shafts

Simulated solar Irradiance measurements
Simulated solar irradiance was broadly comparable across all experimental runs, ranging between 772 W m⁻² and 820 W m⁻² with an average value of 790.7 ± 17.6 W m⁻². The specific irradiance value during the plateau phase per experiment is shown in Table 5. Because solar input was held under near-identical boundary conditions, observed differences in thermal performance, airflow velocities, and temperature distributions can be attributed to the specific façade panel configurations rather than variations in incident solar radiation.

Airflow velocity
In the negative control, sealing the lower opening of the tube restricted air intake, yielding a lower mean velocity of 0.452 m s⁻¹ dominated by local turbulent recirculation rather than an upward movement of air. Once the lower opening was opened in the standard panel, a steady buoyancy-driven draft of 0.707 m s⁻¹ was established. Expanding the cavity depth to 160 mm in the deep cavity configuration resulted in the highest wind speed observed across all configurations, reaching 0.789 m s⁻¹ (an 11.6% increase relative to the standard panel). Modifications to cladding thickness and surface treatment had negligible influence on the chimney wind velocity; the 9 mm plywood panel (0.714 m s⁻¹), 12 mm plywood panel (0.701 m s⁻¹), albedo-coated panel (0.691 m s⁻¹), and CryoPaint® panel (0.721 m s⁻¹) all displayed velocity values that were within a narrow range of ±4% of the standard panel. Graphical representation of these results can also be found in Figure 13.

Thermal air gradient and inner backwall surface temperature

Table 5: Measured and calculated thermal, aerodynamic parameters during the quasi-steady-state plateau phase. Values represent the average of measurements (n = 1) obtained during the quasi-steady-state plateau phase. ΔTcavity = vertical cavity air temperature difference; vair = cavity exit air velocity; Q̇ air = sensible heat transport rate; STBI = inner backwall surface temperature; tplateau = elapsed time to reach thermal equilibrium.
Variable | Negative control | Standard panel | Deep cavity panel | 9 mm panel | 12 mm panel | albedo-coated panel | CryoPaint®-coated panel
(°C) | 0.6 | 7.2 | 7.4 | 9.3 | 8.1 | 7.3 | 8.1
(m s⁻¹) | 0.452 | 0.707 | 0.789 | 0.714 | 0.701 | 0.691 | 0.721
(W) | 5.9 | 111 | 254.8 | 143.4 | 123 | 109.5 | 126.4
(°C) | 44.3 | 39.8 | 33.9 | 37.9 | 35.0 | 37.5 | 36.3
(h) | 1.2 | 0.96 | 1.77 | 1.43 | 1.35 | 1.04 | 0.97
Irradiance (W m⁻²) | 800 | 778 | 774 | 820 | 804 | 772 | 787

The time required for STBI to reach the plateau phase varied considerably between configurations. The standard panel reached the plateau fastest (0.96h). The deep cavity panel showed the longest time to reach the plateau (1.77 h). Thus, the configuration with the highest calculated sensible heat transport rate, reached the plateau phase latest. The plateau phase STBI values showed clear differences between configurations. The negative control reached the highest STBI (44.3 °C), whereas the deep cavity panel showed the lowest value (33.9 °C).

The degree of passive cooling achieved by each façade panel was assessed through the vertical cavity air temperature differential (formula 1) and the plateau phase of STBI. Because ΔTcavity = Ttop – Tbottom, the positive value indicates that the upper cavity air temperature was higher than the lower cavity air temperature in all tested configurations (Table 5). In the sealed negative control, the absence of continuous wind flow suppressed the vertical air temperature gradient to 0.60 °C, leading to thermal accumulation and a backwall temperature of 44.3 °C. Enabling natural ventilation in the standard configuration generated a thermal air temperature gradient of 7.2 °C and reduced STBI to 39.8 °C, resulting in an immediate 4.54 °C benefit. The deep cavity configuration produced a comparable vertical air gradient of 7.4 °C but provided the most effective overall cooling, resulting in a STBI to 33.86 °C (a reduction of 10.48 °C compared to the negative control and 5.94 °C compared to the standard panel). Increasing cladding thickness also reduced backwall (STBI) heating, with the 9 mm and 12 mm panels recording backwall temperatures of 37.91 °C and 35.0 °C while sustaining high vertical gradients of 9.3 °C and 8.1 °C, respectively. Surface treatments similarly reduced backwall heating; the albedo coating and CryoPaint® yielded plateau phase STBI values of 37.5 °C and 36.3 °C alongside cavity gradients of 7.3 °C and 8.1 °C, respectively.

Sensible heat transport
The rate of heat removed by natural convection through the cavity (Q̇ air) exhibited divergence across the tested panel configurations. In the negative control, convective energy transport was negligible at 5.9 W due to the lack of mass throughput. The standard panel displayed a Q̇ air value of 111 W, representing an eighteen-fold increase over the sealed baseline. The deep cavity panel displayed the highest heat removal capacity of all tested assemblies at 254.8 W, representing an increase of 129.5% relative to the standard panel. This increase stemmed from the combined influence of an increased channel cross-sectional area and elevated airflow velocity, which together expanded the cavity mass flow rate (ṁair). Among the remaining assemblies, the 9 mm panel evacuated 143.4 W (+29.2% over standard), primarily driven by its pronounced ΔTcavity. The 12 mm panel extracted 123 W, while the CryoPaint® configuration evacuated 126.4 W (+13.9% over standard). The albedo coating evacuated 109.5 W, displaying convective cooling closely comparable to the standard configuration.

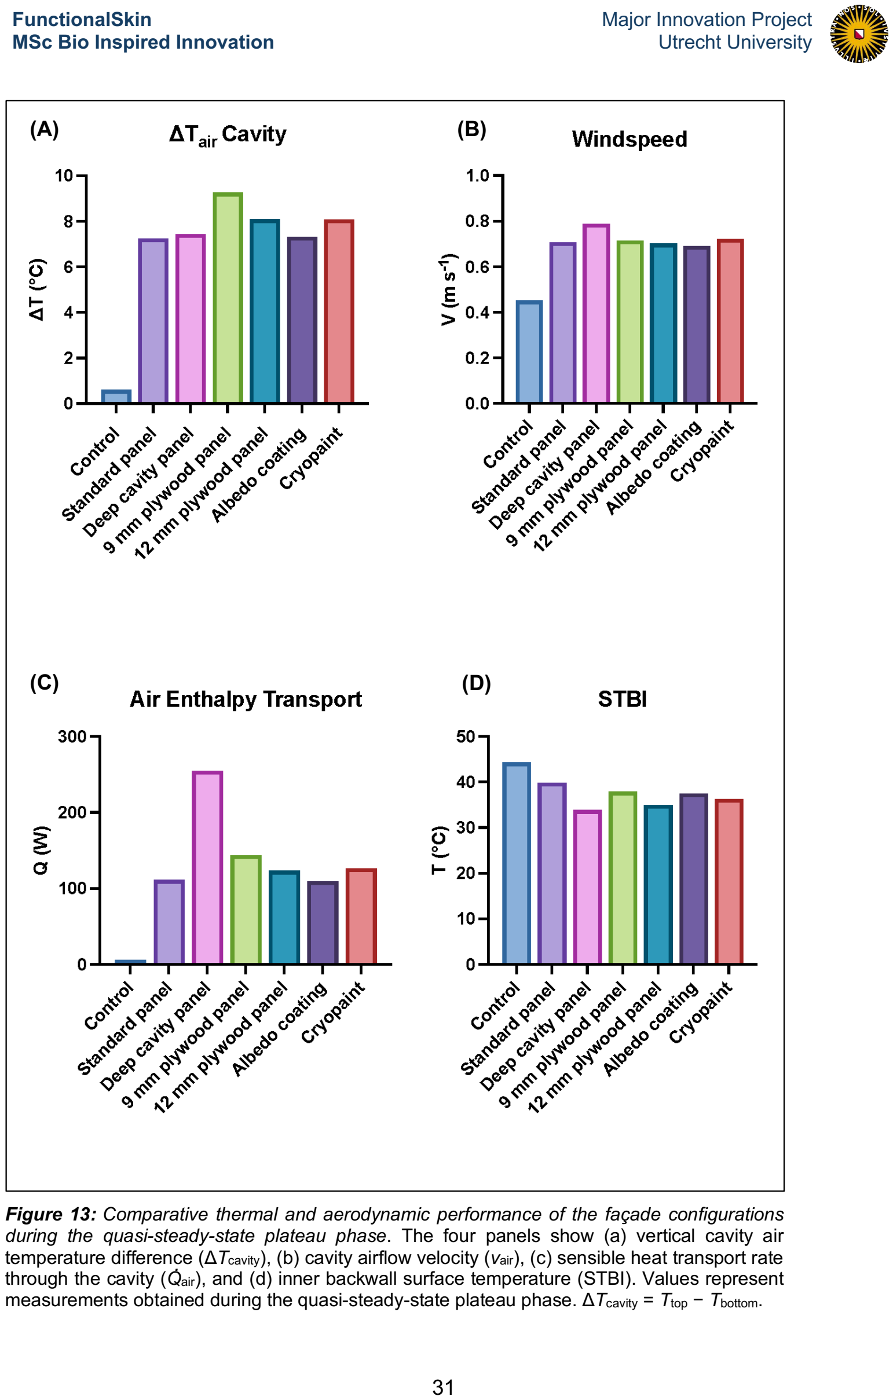
[picture p22: page 32]

Figure 13: Comparative thermal and aerodynamic performance of the façade configurations during the quasi-steady-state plateau phase. The four panels show (a) vertical cavity air temperature difference (ΔTcavity), (b) cavity airflow velocity (vair), (c) sensible heat transport rate through the cavity (Q̇ air), and (d) inner backwall surface temperature (STBI). Values represent measurements obtained during the quasi-steady-state plateau phase. ΔTcavity = Ttop − Tbottom.

(A) (B)
(C) (D)

B.2.3.2: Results: prototype in climate chamber
Thermal and aerodynamic parameters measured during the climate chamber experiment are summarized in Figure 14 and the individual time-series segmentation plots (Supplementary figures; Appendix I). Across all trials, steady-state plateau conditions were successfully achieved within 1.5 - 2 h of continuous irradiation in the controlled climate chamber.

In the prototype under natural convection, buoyancy forces produced an entry airspeed of 0.29 m s⁻¹ at the bottom and an exit velocity of 0.47 m s⁻¹ at the upper aperture. Cavity air entered at 40.0 °C and exited at 45.5 °C, establishing a vertical thermal gradient of ΔTcavity =5.5 °C. When external wind was introduced (Prototype + Wind), cavity aerodynamics were profoundly altered. The air velocity at the upper cavity exhaust accelerated nearly fourfold to 1.77 m s⁻¹, while the lower inlet registered 0.32 m s⁻¹. This increase in air movement in the cavity removed accumulated heat, depressing cavity air temperatures to 34.7 °C at the inlet and 35.5 °C at the outlet collapsing the vertical air gradient to ΔTcavity =0.8 °C.

The STBI served as the benchmark for building thermal protection. The unventilated negative control reached severe overheating at STBI=64.0 °C and a backwall backside surface temperature (STBB) of 47.5 °C. Installing the flat CryoPaint® panel lowered STBI to 46.2 °C (Δ=−17.8 °C vs. control) and STBB to 35.4 °C. The prototype panel under natural convection provided superior shielding, further depressing STBI to 39.2 °C (Δ=−24.8 °C vs. control; −7.0 °C vs. flat CryoPaint®) and STBB to 30.5 °C. Finally, the addition of external wind to the prototype suppressed STBI to 34.2 °C (approaching the 30 °C climate chamber baseline) and STBB to 29.0 °C.

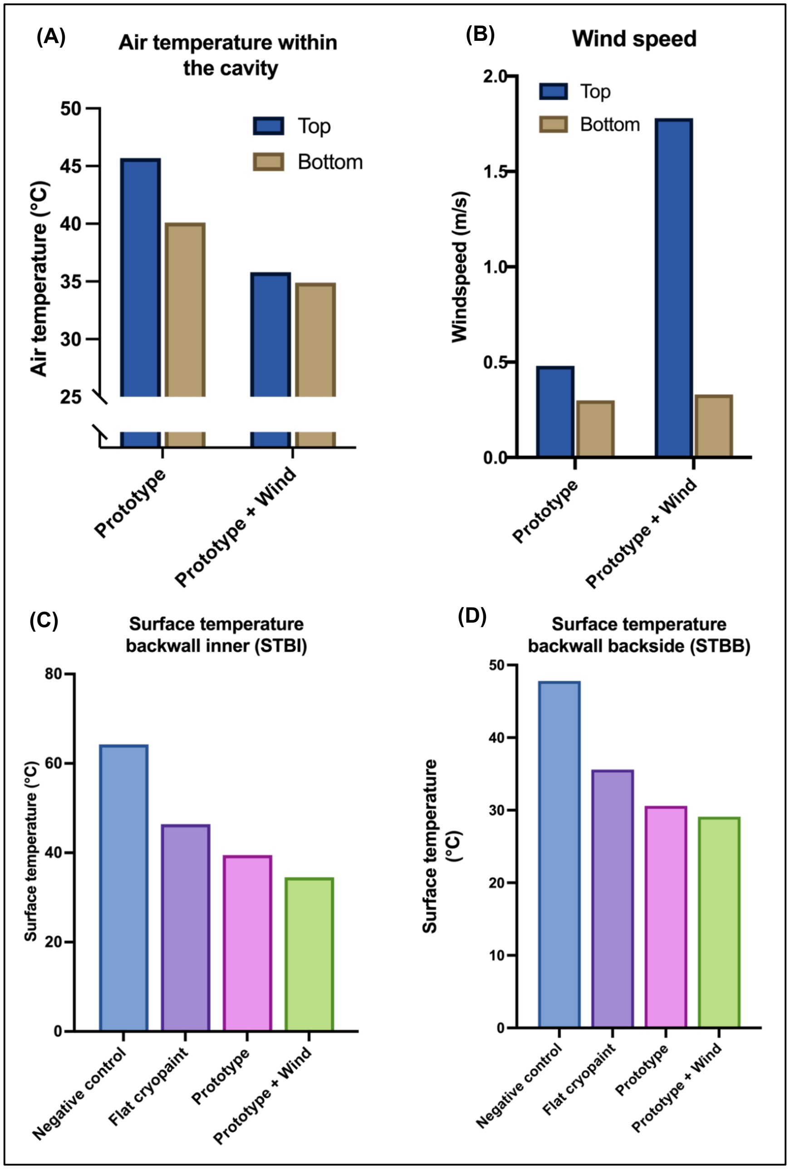
[picture p23: figure]

Figure 14: Thermal and aerodynamic performance of the folded prototype façade under natural and forced convection. The panels show (a) cavity air temperature at the upper and lower measurement locations, (b) airflow velocity at the upper and lower cavity openings, (c) inner backwall surface temperature (STBI), and (d) backside backwall surface temperature (STBB). Comparisons are shown for the folded prototype under natural convection and external wind conditions, together with the negative control and flat CryoPaint® reference where applicable. Cavity temperature and airflow measurements were obtained during the quasi-steady-state phase of the climate-chamber experiments.

B.2.4. Discussion
The findings of this study demonstrate the potential of integrating passive radiative coatings with a specific ventilated cavity geometry to limit heat transfer through a building envelope. Across both experimental campaigns, ventilation provided a mechanism for transporting sensible heat away from the façade cavity. In the rectangular shaft experiments, the ventilated configurations exhibited airflow velocities of approximately 0.69–0.79 m s⁻¹, with calculated sensible heat transport rates ranging from approximately 109 to 255 W. The deep cavity configuration achieved the highest calculated heat transport rate (254.8 W) and the lowest STBI (33.9 °C). These findings indicate that cavity geometry can strongly influence the thermal performance of ventilated façades. Previous research on naturally ventilated double-skin façades has similarly identified cavity geometry and external environmental conditions as important determinants of ventilation and thermal performance (Barbosa & Ip, 2014). However, although the dept cavity exhibited higher airflow velocity and calculated sensible heat transport than the standard configuration, the internal airflow distribution and pressure differences were not measured directly. Therefore, the results are consistent with reduced flow resistance in the deeper cavity, but this mechanism could not be confirmed.

The effects of cavity depth differed from those of cladding thickness and surface treatment. Increasing the plywood thickness reduced the inner backwall temperature, with STBI values of 37.9 °C for the 9 mm panel and 35.0 °C for the 12 mm panel, compared with 39.8 °C for the standard panel. In contrast, airflow velocities for the panels with different thicknesses and coatings remained within approximately 4% of the standard configuration. This suggests that the improved thermal performance of the thicker panels was primarily associated with increased conductive resistance rather than a substantial change in ventilation. Nevertheless, the relationship between material thickness and calculated sensible heat transport was not linear, because heat transport depends on both the air mass flow rate and the temperature difference between the inlet and outlet air. The results therefore indicate that airflow velocity alone is insufficient to describe the thermal performance of a ventilated façade.

Surface treatment also affected the observed thermal response. The albedo-coated and CryoPaint®-coated panels reached STBI values of 37.5 °C and 36.3 °C, respectively, while maintaining airflow velocities like that of the standard panel. The lower backwall temperature of the CryoPaint®-coated configuration suggests that its surface properties contributed to the observed thermal benefit. Research on radiative cooling identifies solar reflectance and thermal emittance as important properties affecting surface cooling performance (Mandal et al., 2020a). However, because the spectral reflectance and thermal emittance of the coatings used in this study were not independently measured, their individual contributions cannot be isolated. The observed differences may reflect the combined effects of radiative properties, heat transfer to the cavity air, and conductive resistance through the façade assembly.

The climate chamber experiments demonstrated that the specific three-dimensional geometry and external airflow can further influence façade thermal performance. Under quiescent chamber conditions, the folded prototype reduced STBI to 39.2 °C, compared with 46.2 °C for the flat CryoPaint® reference, corresponding to a difference of 7.0 °C. The addition of external wind further reduced STBI to 34.2 °C and STBB to 29.0 °C. These findings suggest that the folded geometry and wind-enhanced ventilation can provide complementary thermal benefits. The folds change the orientation of the external surfaces relative to incident radiation and increase the effective surface area available for heat transfer within the cavity. External wind also increased the measured outlet airflow velocity, while the cavity air temperature difference decreased from 5.5 °C under natural convection to 0.8 °C under forced convection. The smaller temperature difference should not, by itself, be interpreted as reduced cooling performance, because the amount of sensible heat transported also depends on the mass flow rate. Nevertheless, the individual contributions of surface orientation, increased heat-transfer area, buoyancy and wind-driven flow cannot be separated from the present experiments.

Research on termite mounds has demonstrated that mound geometry, porosity, internal structure and diurnal temperature fluctuations can interact to generate passive ventilation (King et al., 2015). The relevant similarity is the use of geometry and environmental temperature differences to facilitate airflow without relying exclusively on mechanical ventilation. However, termite mounds and building façades differ substantially in scale, material properties, opening configurations and environmental boundary conditions. Their absolute airflow velocities should therefore not be compared directly without a consistent basis for measurement. The biological system provides a useful design principle but does not by itself demonstrate that the prototype reproduces the same ventilation mechanism or achieves equivalent performance.

Several experimental and instrumentation limitations should therefore be considered when interpreting the results. First, the shaft experiments relied on a single-point velocity measurement at the upper outlet. This introduces uncertainty into estimates of the mean cavity velocity, air mass flow rate (ṁair), and consequently sensible heat transport (Q̇ air). In addition, the absence of measurements at the lower inlet prevented direct verification of mass continuity between the intake and exhaust streams. Although the observed increase in velocity and thermal performance with cavity depth is consistent with reduced flow resistance, the internal velocity distribution cannot be established from the available measurements. Future experiments should therefore employ multi-point or spatially resolved anemometry across both the inlet and outlet cross-sections, ideally complemented by measurements at several heights within the cavity. This would allow the development of the buoyant boundary layer and the relationship between cavity geometry, flow resistance, and mass transport to be quantified more directly.

Second, the upper cavity air temperature sensor (Ttop) in the shaft experiments may have been affected by radiation from the solar simulator. Radiative heating of the sensor body directly by the irradiance of the lamps could have caused an overestimation of the measured upper air temperature, thereby affecting the calculated cavity temperature difference and sensible heat transport. The magnitude of this bias cannot be determined retrospectively. Although the experimental conditions were maintained as consistently as possible between configurations, the extent to which this potential error influenced relative differences remains uncertain. Future experiments should use black-bulb temperature sensor to measure the air temperature and the radiant heat in the environment.
An additional limitation concerns the calculation of the sensible heat transport rate (Q̇ air) Because the mean temperature and airflow values were obtained from independently identified, sensor-specific plateau intervals, the values used in the calculation did not necessarily represent simultaneous measurements. This temporal mismatch introduces additional uncertainty into the calculated heat transport rates and limits the interpretation of their absolute magnitudes and differences between configurations. For future experiments, it is recommended to define a common plateau phase time interval based on one representative sensor, such as the plateau phase for STBI, which reflects the thermal response of the façade. The mean values of all relevant sensors, including cavity air temperatures and airflow velocity, should then be calculated over this same interval. This approach would ensure that the input variables used to calculate the sensible heat transport rate correspond to the same period of the experiment, reducing the uncertainty associated with combining averages from different sensor-specific plateau intervals.

Finally, the controlled climate-chamber conditions limit the direct applicability of the results to real building façades. A constant ambient temperature of 30 °C provides a controlled warm-condition baseline, but outdoor façades experience changing wind speeds, wind directions, solar irradiance and atmospheric turbulence. External wind pressure can either reinforce or oppose buoyancy-driven flow, depending on façade orientation and opening configuration. Future research should therefore examine the prototype under dynamic wind conditions and realistic outdoor exposure. Independent measurements of the optical properties, conductive resistance and airflow characteristics would also help separate the contributions of radiation, conduction and convection.

Among the rectangular shaft configurations, the deep cavity panel demonstrated the strongest overall thermal performance, combining the highest calculated sensible heat transport rate (254.8 W) with the lowest STBI (33.9 °C). However, it also required the longest time to reach the quasi-steady-state plateau (1.77 h). In the climate-chamber experiments, the folded prototype under external wind achieved the lowest STBI (34.2 °C) and STBB (29.0 °C) among the tested climate-chamber configurations. As the two experimental campaigns differed in geometry and boundary conditions, their best-performing panels cannot be ranked directly against one another. Further development should focus on optimising cavity depth, fold angle, and inlet and outlet geometry to improve ventilation while minimising material use and structural complexity. The prototype should also be tested under varying wind directions and outdoor conditions to establish whether the observed thermal benefits persist in realistic environments.

Further development should focus on optimising cavity depth, fold angle and inlet and outlet geometry to enhance ventilation while limiting material use and structural complexity. Ventilated rainscreen and double-skin façade systems provide relevant existing technologies against which the prototype could be benchmarked. However, the present experiments do not establish whether the proposed design is competitive with commercial alternatives. A meaningful comparison would require equivalent testing of thermal performance in the case of whole-wall coverage, ventilation effectiveness, durability, moisture management, structural integration, cost and life-cycle environmental impact.

Overall, the findings support the potential of passive ventilated façades as a means of limiting heat accumulation within the building envelope. Establishing their practical value requires validation of the calculated heat transport, further separation of the underlying heat-transfer mechanisms and testing under realistic outdoor conditions.

B.3. Mycelium-Based Composites: Heat-pressing and mechanical properties

B.3.1. Introduction
In the search for a sustainable material for the cooling panel, MBCs were tested as a possibility. For the plywood prototype, individual tiles were produced, which were assembled and formed a final panel. For MBCs, we examined whether we could form individual tiles by heat-pressing into a three-dimensional shape. In investigating this, there were two key questions to consider: can it be heat-pressed into shapes that mimic the bio-models (and timber prototype); and can it function as a material in an urban context?

The design of these tiles was different from the plywood tiles. The sharper angles that were included in the design of the plywood tile were suggested to cause major cracking during heat-pressing the MBC (dr. Jordi Pelkmans, dr. Pieter Kooijman). Therefore, a smoother, waved-shaped design was chosen for the MBC tiles, as it would allow a more evenly distributed pressure over the MBC and therefore have a greater chance of success - so a custom aluminium mould was made (Figure 15). The dimensions of the heat-press were 10 x 10 cm, which resulted in the production of MBC tiles of the same size. The wider angle of the waves also meant that a standard cubic MBC block could be pressed, rather than growing the blocks in a similar, predetermined 3D-shaped mould to match the aluminium press mould. This makes the tests easier to replicate and to scale up in the future. Additionally, heat-pressing was chosen over cold-pressing, as it has been shown that heat-pressing enhances the homogeneity and strength of MBCs (Appels, et al., 2019). After heat-pressing, signs of cracking, change in colour and thickness were assessed to determine what pressing temperature and duration are most effective in achieving the desired shape in a reproducible way.

After MBC blocks were successfully heat-pressed into shape, a series of experiments was conducted to determine flexural strength and water resistance of the material. These tests were undertaken to assess the potential of the tiles to be used for façade panels, which are exposed to wet, windy weather conditions. The outcome of these experiments was intended to indicate which coatings or maintenance might be necessary.

The change in white value (an indication of reflectivity) was also assessed to determine if the heat-pressing affects the natural cooling properties of the fungal skin. It is known that black coloured materials heat up more than their white counterparts because white reflects more wavelengths (visible and solar), and studies show that white roofs can stay cooler than darker roofs in direct sunlight (Berdahl & Bretz, 1997). Therefore, by measuring the change in white value of the MBC blocks after heat-pressing, the change in reflective ability can be estimated. However, white value only covers the visible light and is not a measured reflectivity.

B.3.2. Materials and methods
Species choice
The choice of mycelium species can be further understood in the Material Selection Report (Appendix C). Briefly, the similar Fomes fomentarius and Fomes inzengae (Cristini et al., 2025; Pohl et al., 2022) are relatively new and promising species used in MBC material research. Of which, Fomes inzengae was readily available for this project along with expert guidance.

Growth conditions
Fomes inzengae was first inoculated on Potato Dextrose Agar (PDA) plates and then grown in cellulose (Recell, Groningen). This was used to inoculate hemp shives (Welkoop, NL), in which it was grown for 13 days in acrylic moulds of 10 x 10 x 3 cm in an incubator set to 30°C. Following this, they were removed from the moulds to grow a skin in the same incubator. After 7 days the samples were set to air dry (unobstructed on 5/6 sides) at ambient room humidity (50-60%) and temperature (20-22 °C) over two and a half weeks. After this time the blocks were dry to the touch and slightly shrunken. This drying method was chosen due to its low energy (passive) demand and advice from fungal experts.

Heat-pressing
The MBC blocks were pressed for 5 or 20 min at 115 kN at 150 °C and 190 °C using a heat press (Carver, USA) and aluminium mould (Figure 15). The aluminium mould was used to heat-press a flat square shape, and additional aluminium, CNC milled, three-dimensional inserts (positive and negative parts, measuring 100 x 100 mm) were used to achieve the 3D-pressed MBC tiles. Digital callipers were used to measure thickness after heat-pressing at Ha and Hb (Figure 16). The two thicknesses vary slightly due to the geometry of the mould design.

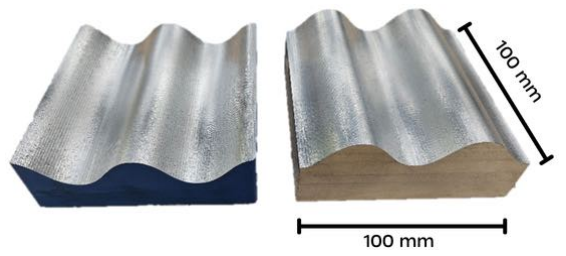
[picture p24: figure]

Figure 15: Aluminium press mould; left is the top, right is the bottom.

Figure 16: Side view of pressed block where the thickness was measured at Ha and Hb.

White value
The flat faces (underside) of the dried blocks were scanned (Epson Perfection V370 Photo) before and after heat-pressing (flat-pressed only) to determine any change in white value. ImageJ (Fiji, NIH Image) was used to measure this change after scanning. Measured region is within the boundaries of the block (avoiding the background interfering with the measurement).

Water contact angle
Six samples were tested for water contact angle. This included four 3D-pressed tiles (two each of 150 °C and 190 °C heat-pressed), and two flat-pressed tiles. Six drops of 5 µl demineralised water were placed on each of the 2 faces of the 3D-pressed tiles (four drops per face used on flat tiles due to their surface being more uniform). These 12 drops were placed one-by-one, and of which, a photo was taken at 1 sec, 1 min and 5 min following drop placement. The left and right angles were measured and averaged using ImageJ (plugin Drop Analysis – DropSnake).

Water absorption
Weight and thickness of six samples were recorded before submerging in demineralised water using a weight to keep them down. The weight and thickness were then recorded after 10, 30, and 60 min and after 2, 4, 24, 49 h. When measuring, the excess water was blotted with filter paper, and sample measured within 10 sec of removing from water.

Flexural strength testing
Twelve samples of heat-pressed tiles were tested for flexural strength in a tensile testing machine (Lloyd, Amtek) at the HU University of Applied Sciences Utrecht. Four tiles were heat-pressed flat, while eight had been 3D-pressed. Additionally, a 10x10 cm plywood tile (5.5 mm thickness) was tested to compare. The machine was set to 5 N mm⁻² s⁻¹. Each tile was separately loaded into the machine, and value was recorded at failure point. Failure criterion was indicated by a force drop right after achieving peak value (sample fail due to fracture). RStudio (Posit PBC) was utilised to analyse results by generating stress-strain curves and calculating Young’s modulus (= E = !
" where σ is stress, and ε is strain) after manually selecting for the linear region of each sample’s stress-strain curve.

Assembled panel prototype
A final prototype panel was assembled using heat-pressed MBCs (Fomes inzengae) which were initially waste from another student’s research (blocks provided courtesy of Zachary Leopold). This was due to the difficulty growing enough blocks needed, and priority was given to experimental testing for the ones grown during this project. Using the waste MBCs provided, they were heat-pressed for 10 min at 190 °C and assembled in a 3 x 3 tile configuration. These were then nailed and glued (polyurethane construction adhesive (Bison Konstruktielijm, EN 204 class D4)) to a pine timber frame.

B.3.3. Results
Heat-pressing
MBC blocks of Fomes inzengae and hemp shives were grown in 100 x 100 x 30 mm moulds. These blocks were allowed to grow a fungal skin before drying, after which the average thickness of the dried blocks was measured to be 25 mm (reduced from 30 mm due to shrinkage after drying). Important to note, is the choice of growing a fungal skin on all samples. This was decided after initial tests with MBC both with and without skin determined that samples held shape more effectively after heat-pressing when a fungal skin was present. Samples without skin were prone to crumbling edges of substrate and a less uniform surface after heat-pressing. It was however observed that after heat-pressing in a three-dimensional shape, tears along the surface occurred at points of stress at the “peaks” of the design. This was not observed in the flat-pressed MBCs (Figure 17).

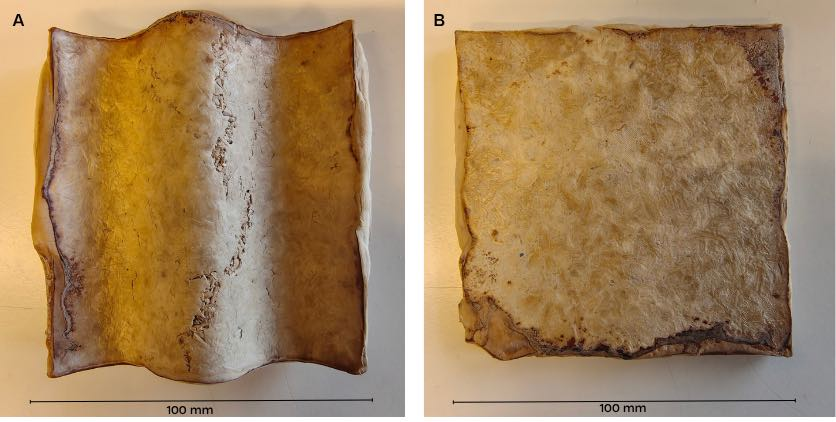
[picture p25: figure]

Using aluminium moulds (flat and 3D-shaped), it was observed that heat-pressing at a higher temperature of 190 °C resulted in thinner tiles, with the thinnest average measuring 4.5 mm (Standard Deviation (SD) = 0.3) after 20 min of heat-pressing and 4.8 mm (SD = 0.6) after only 5 min of heat-pressing (Table 6). This result is reflected in the 3D-pressed samples with the thinnest tile average of 4.3 mm (SD = 0.8) after heat-pressing for 20 min at 190 °C and the thickest measuring 5.3 mm (SD = 1.1) after 5 min at 150 °C (Table 8). For the flat tiles however, the thinnest average thickness of 4.8 mm was measured after heat-pressing for 190 °C for 20 min, and 150 °C for 5 min, and the thickest was after heat-pressing for 5 min at 190 °C (Table 7).

Figure 17: Fungal skin tear at peak of block #13 after pressing (A). This occurred on all 3D pressed samples and did not occur on the flat pressed samples, such as block #21 (B).

White value
After heat-pressing MBC blocks, the white value for every sample decreased. For samples heat-pressed at 150 °C there was an average decrease in whiteness of 14%, and for samples heat-pressed at 190 °C this was 22%. The mean change between pre and post heat-pressing is quite variable, however (Table 9). The visual change can clearly be identified in Figure 18 below.

Table 6: Comparison of temperature and time pressing (regardless of shape) on the MBC thickness after pressing.
Temperature (°C) | Minutes pressed | n | Thickness (mm) | SD
150 | 5 | 4 | 5.2 | 0.3
190 | 5 | 4 | 4.8 | 0.6
150 | 20 | 6 | 5.0 | 1.3
190 | 20 | 5 | 4.5 | 0.3

Table 7: Flat pressed MBC tiles and their thickness after heat pressing.

Temperature (°C) | Minutes pressed | n | Thickness (mm) | SD
150 | 5 | 1 | 4.8 | n/a
190 | 5 | 1 | 5.3 | n/a
150 | 20 | 3 | 4.9 | 1.3
190 | 20 | 2 | 4.8 | 0.0

Table 8: Thickness of 3D pressed MBC tiles only.

Temp (°C) | Mins pressed | n | (mm) Ha | SD | Hb (mm) | SD | Average (Ha & Hb) (mm) | SD
150 | 5 | 3 | 6.2 | 0.3 | 4.3 | 0.2 | 5.3 | 1.1
190 | 5 | 3 | 5.4 | 0.8 | 3.9 | 0.6 | 4.7 | 1.0
150 | 20 | 3 | 5.9 | 1.6 | 4.0 | 1.4 | 5.0 | 1.7
190 | 20 | 3 | 5.0 | 0.3 | 3.6 | 0.3 | 4.3 | 0.8

| Pre-pressing | Post-pressing

Block #2. -6% change

Block #6. -33% change

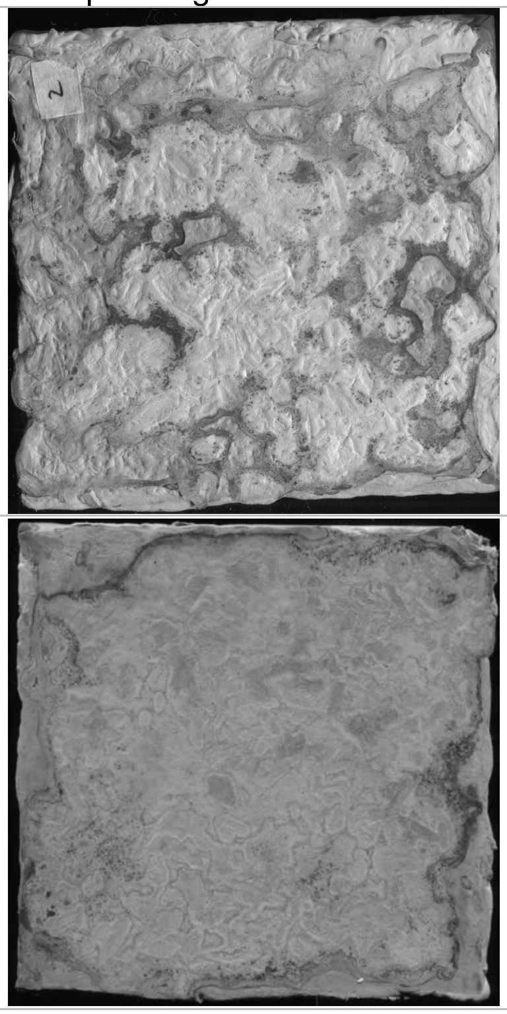
[picture p26: figure]
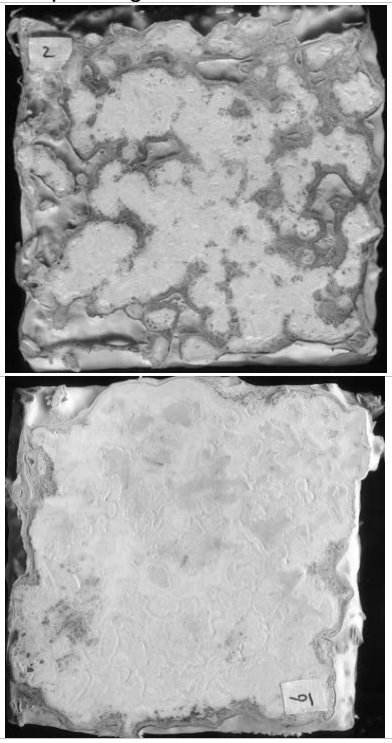
[picture p27: figure]

Figure 18: Scanned images showing biggest and smallest change in white value on MBC samples before and after heat-pressing. Note that black #2 began with less white area than block #6.

Table 9: Measurement of white value before and after heat-pressing MBC blocks (using ImageJ, value of 0 = black, 255 = white).
| Pre-pressed | Pressed
Temp pressed | Press time (min) | Block # | mean value | min | max | mean value | min | max | % change
150 | 20 | 2 | 164.15 | 36 | 255 | 154.03 | 33 | 255 | -6%
150 | 20 | 4 | 193.15 | 48 | 255 | 154.78 | 22 | 255 | -20%
150 | 20 | 5 | 194.31 | 35 | 255 | 168.22 | 32 | 255 | -13%
190 | 20 | 6 | 197.62 | 48 | 255 | 131.86 | 34 | 255 | -33%
190 | 5 | 19 | 198.24 | 37 | 255 | 171.69 | 50 | 255 | -13%
190 | 5 | 21 | 188.35 | 49 | 255 | 151.58 | 29 | 255 | -20%
190 | 20 | 3 | n/a | n/a | n/a | 131.83 | 19 | 255 | n/a

Water contact angle
The water contact angle on every sample recorded at 1 s were greater than 90° which can be defined as hydrophobic (Figure 19). However, every water drop was absorbed by the material (longest remained for ~30 min) eventually. The sample which retained the greatest number of drops after 5 min was block #9 3D-pressed at 150 °C for 5 min (Figure 20), which retained half of the drops placed. The sample which saw the absorption of the most drops at this point was block #15 3D-pressed for 190 °C for 5 min, of which only 1 of 12 drops remained. Block #12 (3D-pressed at 150 °C for 20 min) had the smallest contact angle compared with all other 3D-pressed tiles, and this was also consistent in both its peaks and valleys (see Figure 21). In the 3D-pressed samples, it was observed that there was a 3° difference in angle (at 1 sec) between the peaks (109.99°, SD = 17.75) and valleys (106.63°, SD = 20.29) (Table 11). It’s important to note that the material is curved, which may be the cause for this difference in contact angle. For this reason, the flat samples are not compared with the 3D-pressed samples as this discrepancy is again a likely influence on the data. The flat-pressed samples were very consistent with each other despite their different heat-pressing temperatures. Both samples had water contact angles of 114° (150 °C SD = 26, 190 °C SD = 12) and 13 % of drops were maintained at 5 min (Table 10).

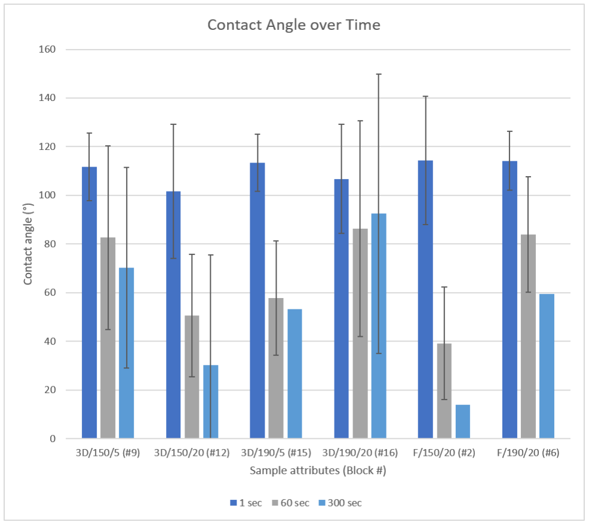
[picture p28: figure]

Figure 19: Water contact angle change over 5 min on heat-pressed MBCs.

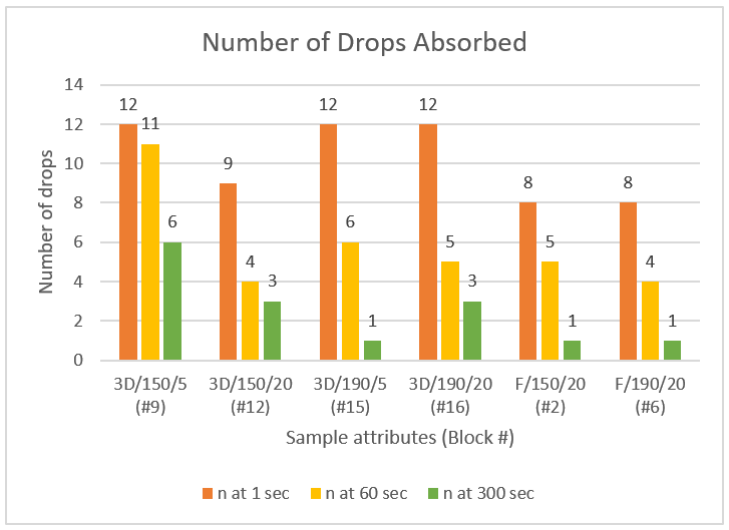
[picture p29: figure]

Figure 20: Number of water drops (n) absorbed over time for each sample. Tile attributes described as: shape (3D or flat) / temperature (°C) / Minutes heat-pressed.

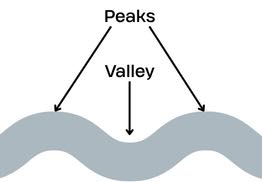
[picture p30: figure]

Figure 21: Grey object is the heat-pressed MBC block from the front view, showing where the measurements were taken as “peaks” and “valleys” of the design.

Table 10: Water contact angle of water drops per MBC sample at 1 second, 60 seconds and 300 seconds after placement. Data corresponding to Figure 19.

Block # | Attributes | 1 sec (°) | n | SD | 60 sec (°) | n | SD | 300 sec (°) | n | SD
9 | 3D/150/5 | 111.71 | 12 | 14 | 82.61 | 11 | 38 | 70.28 | 6 | 41
12 | 3D/150/20 | 101.54 | 9 | 28 | 50.57 | 4 | 25 | 30.15 | 3 | 45
15 | 3D/190/5 | 113.39 | 12 | 12 | 57.66 | 6 | 23 | 53.24 | 1 | n/a
16 | 3D/190/20 | 106.74 | 12 | 22 | 86.26 | 5 | 44 | 92.50 | 3 | 57
2 | F/150/20 | 114.36 | 8 | 26 | 39.18 | 5 | 23 | 13.92 | 1 | n/a
6 | F/190/20 | 114.18 | 8 | 12 | 83.89 | 4 | 24 | 59.34 | 1 | n/a

Water absorption
The starting thickness of the heat-pressed MBC blocks was somewhat variable, with the thinnest being ~ 4.3 mm and the thickest ~ 6.7 mm. The 3D-pressed sample at 150 °C for 20 min maintained the largest thickness throughout the experiment, having a thickness of 19.17 mm after 49 h submerged in water. The sample heat-pressed flat at 190 °C for 20 min (block #6) maintained a smaller thickness over the duration of the experiment and saw a change in thickness less than its thicker counterparts (increase of 85% over 49 h in water), the largest increase in thickness was seen in the 3D-pressed sample at 150 °C for 5 min (block #9) of which an increase of 214% (Figure 24) thickness was observed. In assessing the change of thickness over time, the largest changes were seen in the initial 10 min of the experiment (Figure 22) which slowed considerably after 2 h.

Table 11: Water contact angle of 3D-pressed samples only at 1 sec, comparing the peak and valley.
Block # | Attributes | Peak (°) | SD | Valley (°) | SD
9 | 3D/150/5 | 109.12 | 13.43 | 114.31 | 15.14
12 | 3D/150/20 | 100.13 | 26.06 | 102.67 | 31.76
15 | 3D/190/5 | 119.89 | 7.70 | 106.89 | 11.81
16 | 3D/190/20 | 110.81 | 23.81 | 102.66 | 22.45
| Average | 109.99 | 17.75 | 106.63 | 20.29

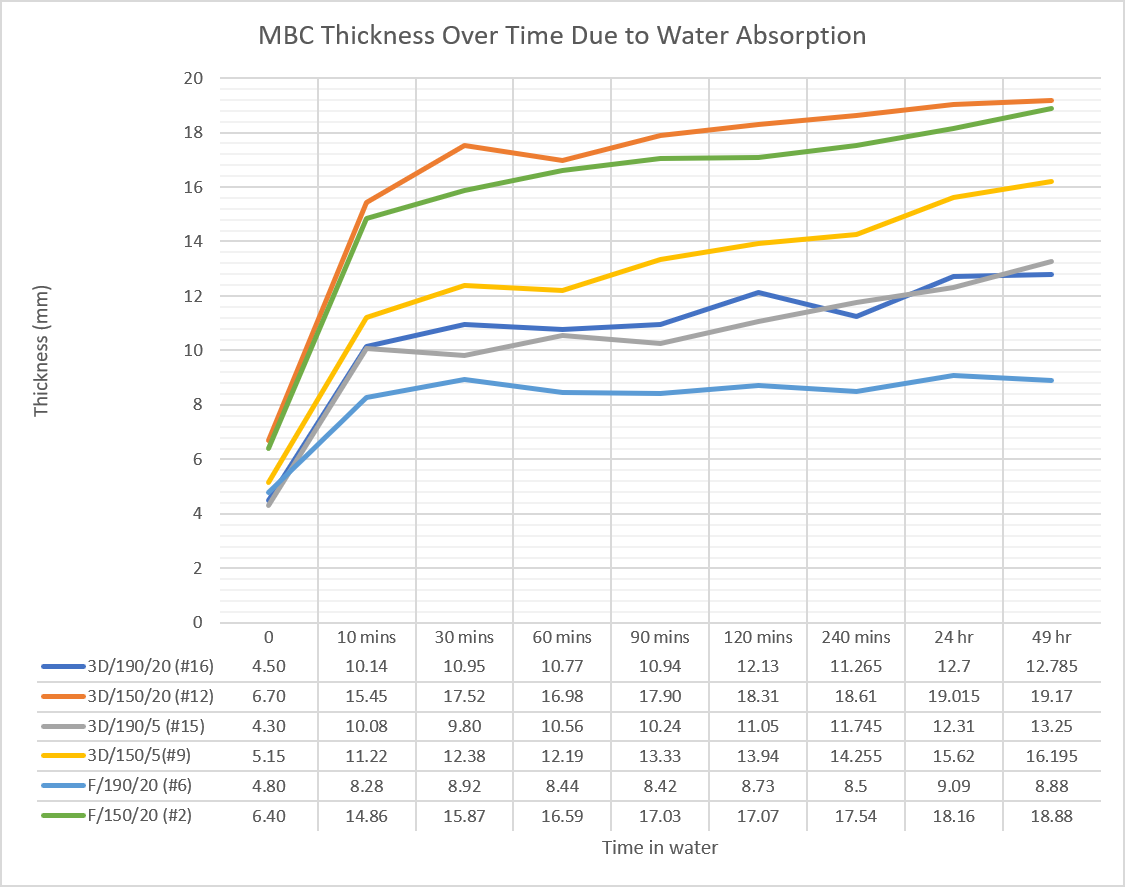
[picture p31: figure]

Figure 22: MBC thickness in mm over time due to water absorption.

Weight change of samples while submerged in water was also assessed. The highest increase in weight was observed in the first 10 min of submersion (Figure 23). The largest increase in weight was observed in the sample that was flat-pressed at 150 °C for 20 min (block #2) which saw an increase of 890 % since its dry measurement (Figure 24). The smallest change in weight was observed in the sample heat-pressed flat at 190 °C for 20 min (block #6). The three samples heat-pressed at 190 °C (#16, #15, #6) increased in weight collectively less than the three samples heat-pressed at 150 °C. During the experiment, it was observed that block #16 took on water weight at a slower pace than blocks #9 and #15 after initially absorbing more than them in the first 10 min. Comparing #16 and #15, the block which was heat-pressed for a shorter time took on more weight.

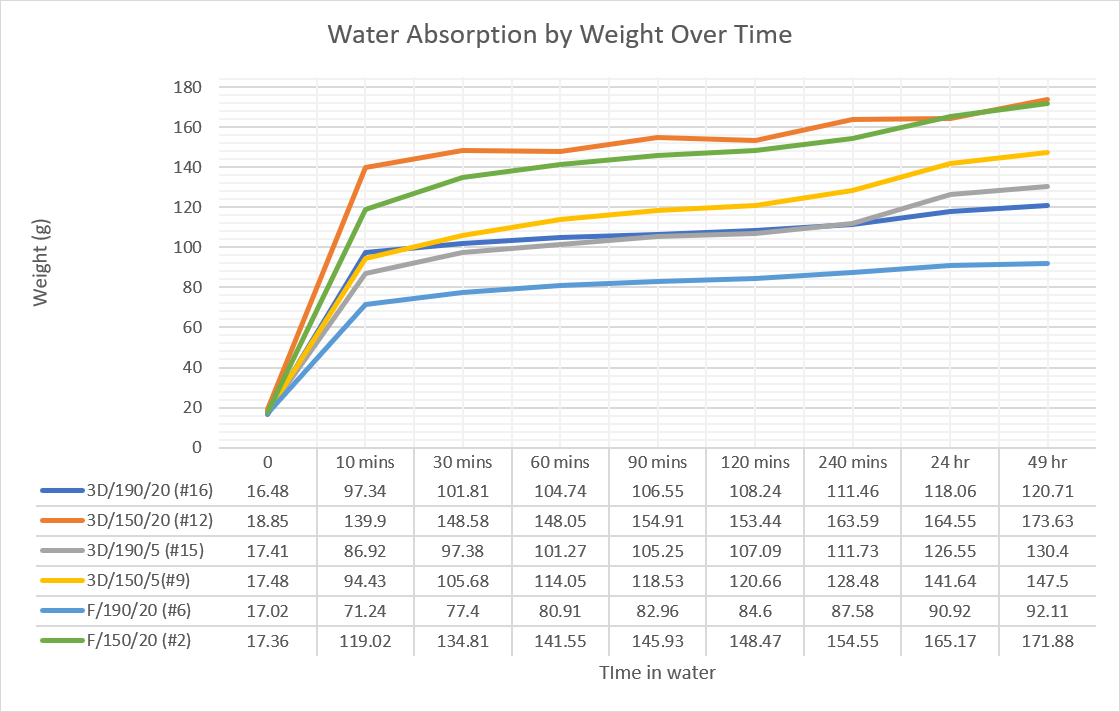
[picture p32: figure]

Figure 23: Water absorption by weight in g over 49 hours.

Comparing the uptake of water by the heat-pressed MBC samples via weight and thickness showed some variations (Figure 24). Block #9 had a higher (in comparison with the other samples) change in thickness but a lower change in weight. This was observed contrarywise in block #2 which saw the highest weight increase of 890% yet only 195% increase in thickness. A trend can also be identified in that the samples heat-pressed at a lower temperature absorbed more water weight, and samples heat-pressed for only 5 min saw the largest increases in thickness. The sample heat-pressed flat at 190 °C for 20 min showed the smallest change in both weight and thickness, additionally it also had the smallest difference between the two changes (difference of 356%).

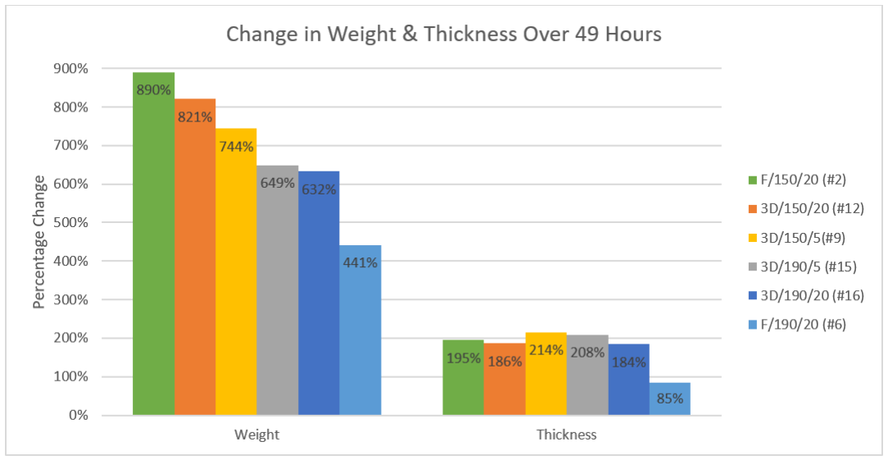
[picture p33: figure]

Figure 24: Change in weight and thickness of heat-pressed MBC blocks from 0 min to 49 h while submerged in water.

Maintenance of shape from water absorption was observed despite the increase in thickness of all samples. Every 3D-pressed MBC did maintain their shape, including the sample heat-pressed for only 5 min at 150 °C (Figure 25). However, in handling the samples, it was observed that the now thicker MBCs were more delicate and prone to breaking into two pieces, especially along the tear lines that were formed during heat-pressing.

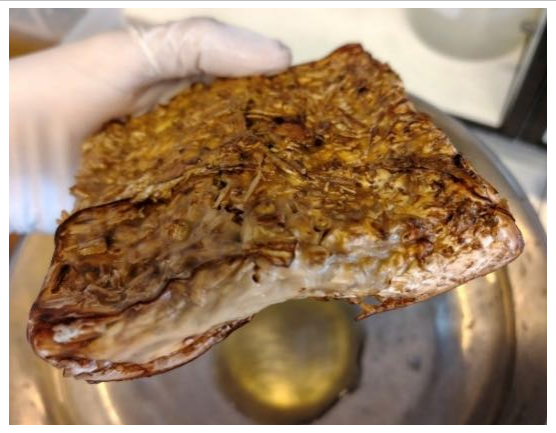
[picture p34: figure]
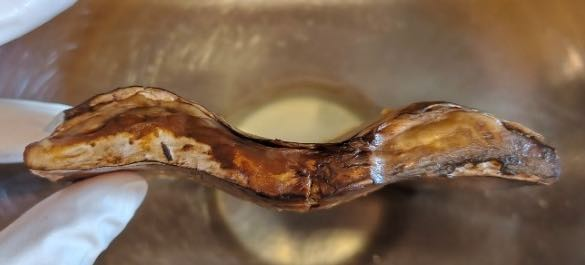
[picture p35: figure]

Block #16 (3D/190/20) | Block #9 (3D/150/5)

Figure 25: The shape of the 3D-pressed MBC blocks after 24 h of water absorption.

Flexural strength
The way that each 3D-pressed tile deformed was consistent amongst samples. The middle peak which took force from above (Figure 26) deformed whilst the sides of the sample slid outwards and upwards. The skin on the underside tore underneath the failure point but the whole sample remained in one piece. After the test, the blocks also maintained their changed state indicating plastic deformation.
A | B

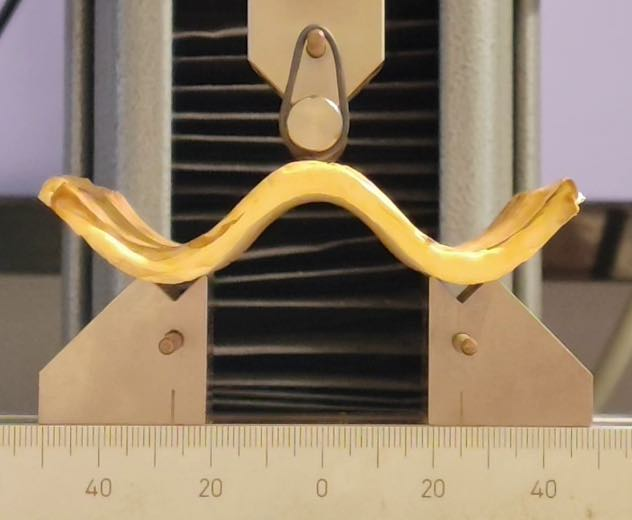
[picture p36: figure]
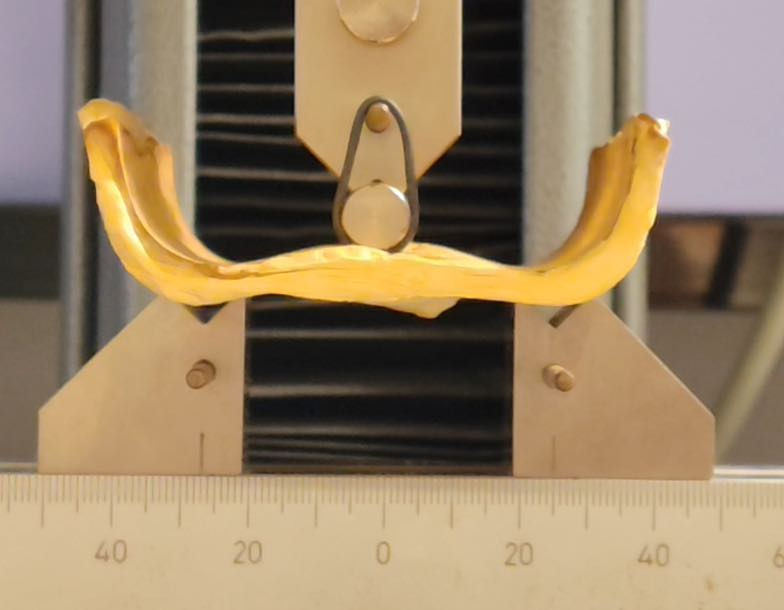
[picture p37: figure]

C | D

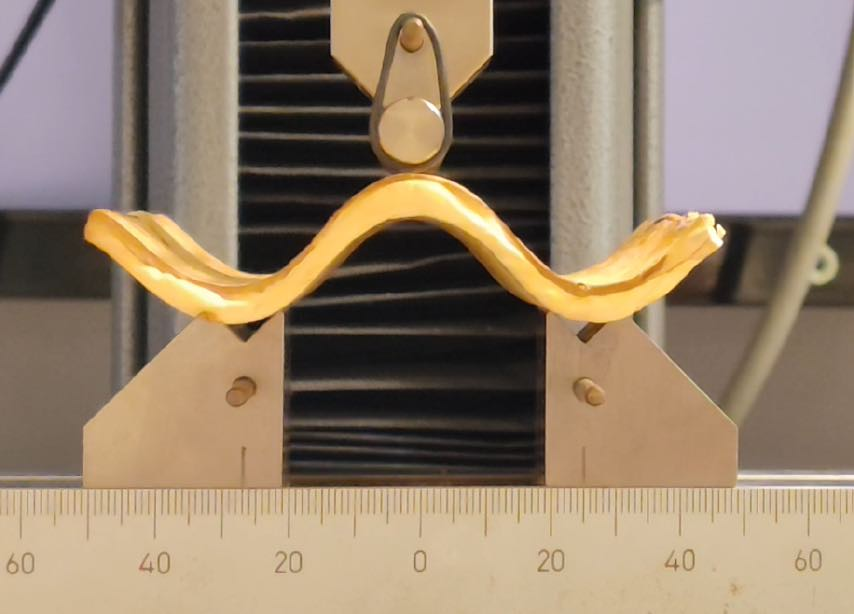
[picture p38: figure]
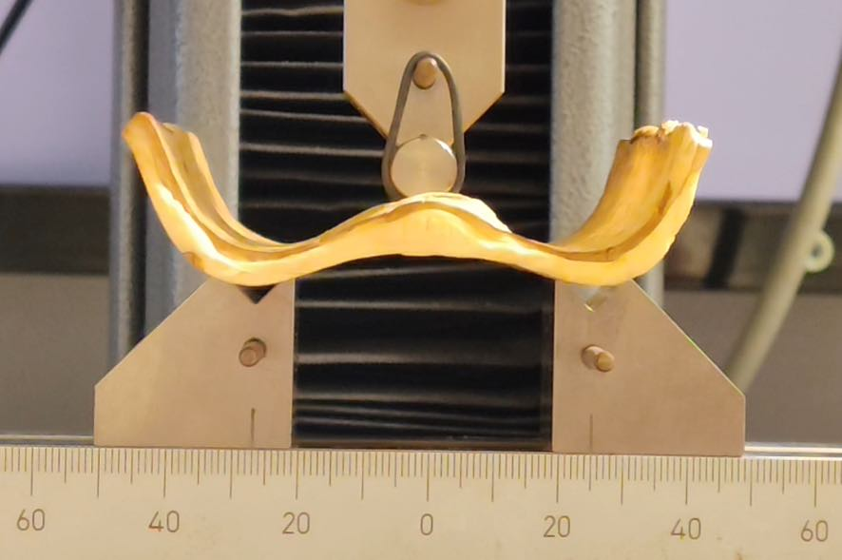
[picture p39: figure]

E | F

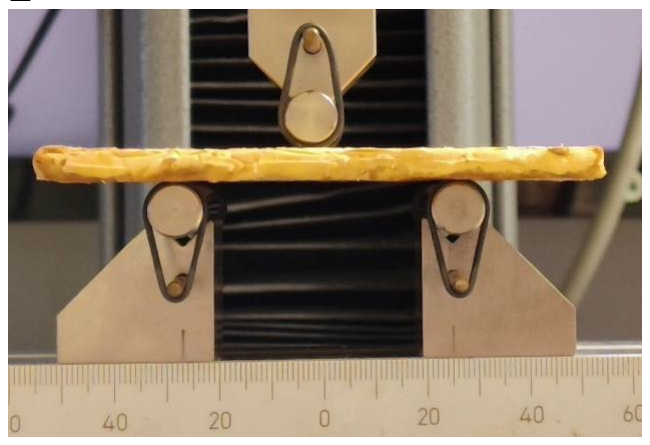
[picture p40: figure]
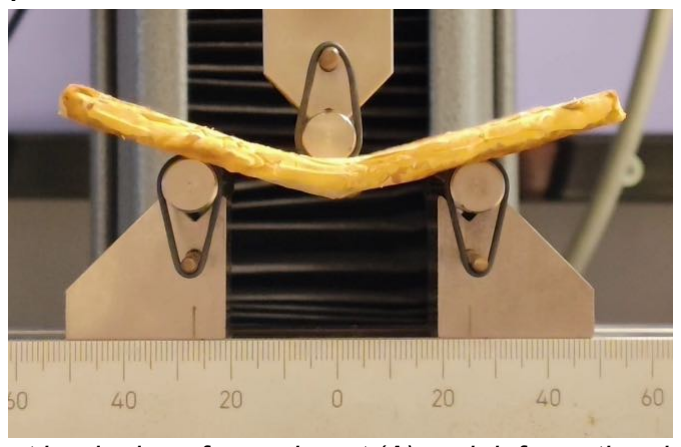
[picture p41: figure]

Figure 26: Images showing block#18 (3D/190/20) at beginning of experiment (A) and deformation during failure (B); block #14 (3D/190/5) before test (C) and at failure point (D); also block #3 (Flat/190/20) at beginning of experiment (E) and deformation at failure (F).
Of the 3D-pressed samples, the highest flexural strength was 2.88 MPa (pressed at 190 °C for 5 min (Figure 27)). Whilst amongst the flat samples, the highest flexural strength was achieved by the sample heat-pressed at 150 °C for 20 min. Interestingly, the 3D-pressed sample (pressed 190 °C for 5 min) which achieved the best flexural strength has a lower

Young’s modulus (54.65 MPa) than its runner up (sample 3D/150/20 with Young’s modulus of 84 MPa). The sample 3D-pressed at 190 °C for 20 min had a similar result: flexural strength was in a similar range to its flat-pressed counterpart (3D = 1.89 MPa, flat = 2.04 MPa), whereas the Young’s modulus was then lower in comparison (3D = 41.1 MPa, flat = 59 MPa).

The maximum load that could be applied before fracture were lowest for samples heat-pressed both in 3D and flat at 150 °C for 5 min (Table 12), however important to note is the unreliability of the 3D-pressed sample in this instance (3D/150/5), whereby the sample initially slipped during the run and needed repositioning (that is, some force had been applied before this measured result was recorded). Table 12 also shows the number of samples per test which is lower than initially planned for due to hurdles growing the MBC. Therefore, these results are only indicative and further testing is required. Looking at the extension, the 3D-pressed samples are each larger than the flat-pressed, indicating much more movement/deformation before failure of the material.

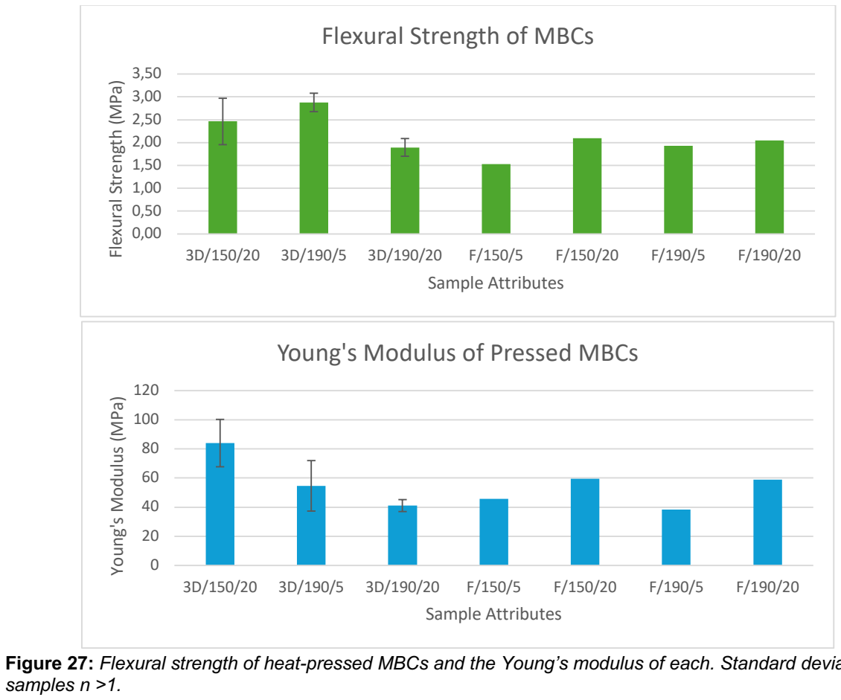
[picture p42: figure]
samples n >1.; Flexural Strength (MPa); Sample Attributes; Flexural Strength of MBCs; Young's Modulus (MPa); Young's Modulus of Pressed MBCs

Figure 27: Flexural strength of heat-pressed MBCs and the Young’s modulus of each. Standard deviation for

Flexural strength can be further investigated using the below stress-strain curves (Figure 28). Looking at the graphs below, samples 10 and 11 seem to have an obvious initial yield in the material, before failure under a slightly higher stress. The flat samples have a very clean curve, achieving maximum stress before decline. The 3D-pressed samples experience a prolonged strain with the deformation of the material and its shape. The overlapping stress-strain curves in Figure 29 depict a similar linear incline amongst samples until about 0.5 MPa, at which point the samples begin to behave differently from each other. It’s interesting to note that there looks to be some grouping of when the flexural stress begins to increase, however no correlation with sample types can be reasonably determined from this set of data.

Table 12: Three-point flexural test results for heat-pressed MBCs, showing highest load (N), flexural strength (MPa) and the maximum extension (mm), and Youngs Modulus (MPa). Highest load value, flexural strength and extension was recorded directly from calibrated testing machine/computer. Young’s modulus calculated using RStudio. *Note, data missing from sample 3D/150/5 due to unreliability of sample.

Tile Attributes | n | Highest Load (N) Value & (SD) | Flexural Strength (MPa) & (SD) | Extension At Max Load (mm) & (SD) | Young’s Modulus (MPa) & (SD)
3D/150/5 | 1 | 43.95 | n/a* | 10.60 | n/a*
3D/150/20 | 2 | 78.91 (16.26) | 2.46 (0.51) | 11.47 (1.85) | 84 (16.26)
3D/190/5 | 2 | 92.26 (6.46) | 2.88 (0.2) | 13.68 (1.26) | 54.65 (17.32)
3D/190/20 | 2 | 60.72 (6.21) | 1.89 (0.19) | 14.34 (0.67) | 41.1 (4.1)
F/150/5 | 1 | 48.99 | 1.53 | 8.59 | 45.8
F/150/20 | 1 | 67.28 | 2.10 | 8.21 | 59.4
F/190/5 | 1 | 61.69 | 1.92 | 8.30 | 38.3
F/190/20 | 1 | 65.45 | 2.04 | 6.25 | 59

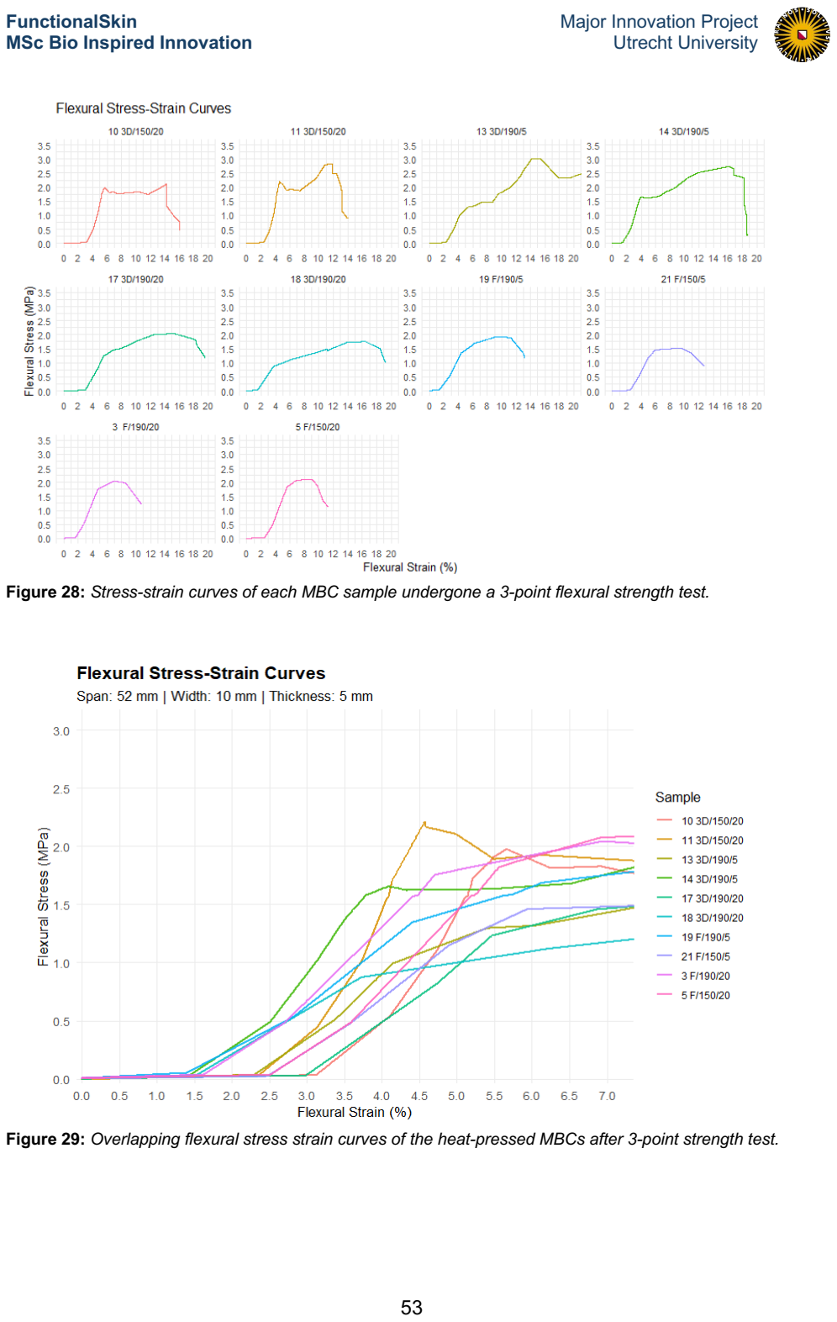
[picture p43: page 54]

Figure 28: Stress-strain curves of each MBC sample undergone a 3-point flexural strength test.

Figure 29: Overlapping flexural stress strain curves of the heat-pressed MBCs after 3-point strength test.

Assembled panel prototype
The heat-pressed MBC tiles were assembled in a 3 x 3 tile configuration and attached to a timber frame to determine how they would look and fit together as a panel prototype. This proved successful as the tiles provide air spaces thanks to the curved design allowing airflow to pass through, and the construction conveys a much more biophilic aesthetic (Figure 30). However, this prototype is uncoated and as such would require storage/display indoors in dry environments to avoid moisture absorption.

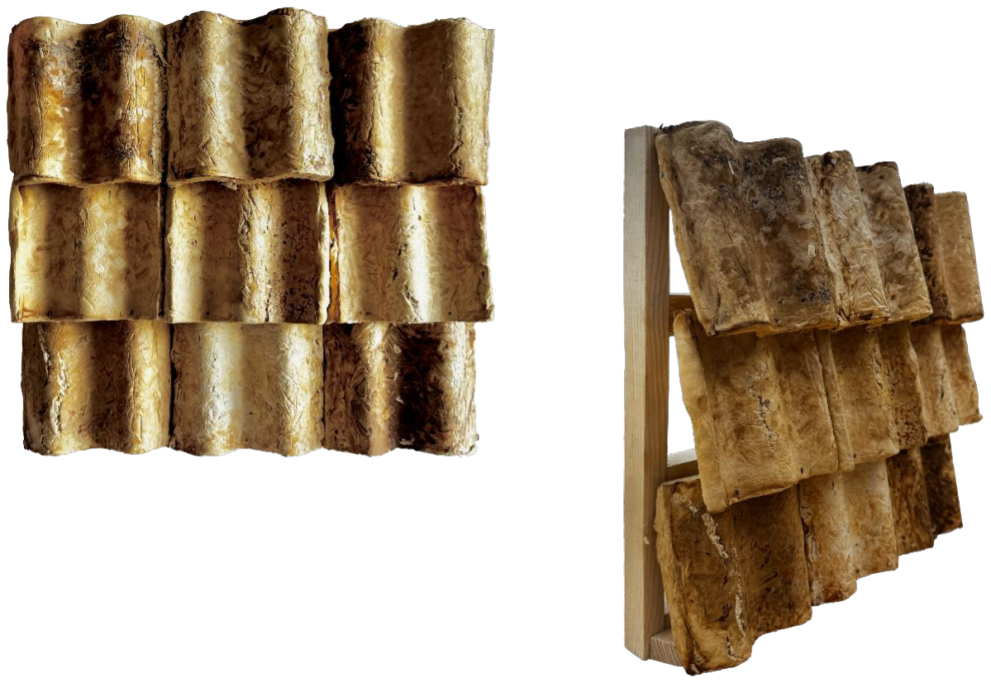
[picture p44: figure]

Figure 30: Final prototype made from assembled heat-pressed MBC tiles on a timber frame (approx. 30 x 30 cm). Left: front view, right: angled side view with timber frame visible.

B.3.4. Discussion
Material tests performed on the MBC blocks garnered some indications of the weatherability of the material, as well as proved that they can be heat-pressed into a three-dimensional shape from a cubic starting shape. Heat-pressing the MBC blocks at a higher temperature of 190° and for a longer time of 20 min reduces the average thickness of the material considerably (from 25 mm pre-pressing to 4.5 mm after heat-pressing). Therefore, depending on the desired outcome, one could tailor the method of heat-pressing to achieve it. More importantly, the blocks held the shape they were heat-pressed into, even with observed tearing of the skin at the peak area of the block. This is likely because the block was grown in a cubic shape, which requires some deformation of the surface to meet the three-dimensional form. This could be avoided by either growing the block in a matching three-dimensional form or heat-pressing into a three-dimensional shape with smaller deviations from the initial cubic form and surface.

Heat-pressing did reduce the white value of all samples which was to be expected (average decrease across samples of 20%). This would indicate a reduction in reflectivity which detracts from the desired cooling function this project is aiming towards but highlights this aspect as a topic for further study as there are other factors such as differing white values before heat-pressing per sample. Additionally, since the surface does not maintain a white colour after heat-pressing, a coating is necessary to optimise reflective cooling. In an outdoor context, the heat-pressed blocks would likely have difficulty maintaining form and function due to wet weather, as indicated by the water tests. Water contact angle tests showed that the untreated material is initially hydrophobic, but this is short lived - after 5 min all samples saw the absorption of drops occur, with the best performing attributes being seen on the sample 3D-pressed at 150 °C for 5 min. This is likely due to the least change of the natural mycelium surface (which is normally quite hydrophobic) in comparison with the other samples.

Interestingly, the opposite effect was seen when investigating water absorption of the heat-pressed MBC blocks. On all accounts, these samples absorbed more than what has been seen in previous studies , however this is likely due to the method of testing and difference in density/thickness. This highlights the need for density tests to be undertaken in conjunction with absorption tests; as well as a more standardised method of comparison testing as also outlined by Andrade, et al. (2026). Due to these samples being three-dimensional (without a flat surface), they were submerged in water – this method was undertaken to achieve an even water exposure over the entire sample. The subsequent tests revealed that the sample heat-pressed flat at 190 °C for 20 min showed the smallest change in both weight and thickness (441% weight increase, 85% thickness swelling). The same can be said for the block heat-pressed into a three-dimensional shape for the same time and temperature in comparison with the other 3D-pressed blocks. These observations indicate the material is better able to resist water absorption if it is heat-pressed under these conditions, likely due to the improved bonding during the heat-pressing process .

In testing the material’s flexural strength and deformation behaviour there was much to observe. Among the 3D-pressed samples, the strongest was heat-pressed at 190 °C for 5 min and showed a lower Young’s modulus; while among the flat samples, the strongest sample was heat-pressed for 150 °C for 20 min and maintained a higher Young’s Modulus than its counterparts. This indicates a potential effect of the geometry of the heat-pressed MBCs for enhancing the flexibility of the material while maintaining strength. More broadly, the flexural strength of the flat samples is similar to the range seen in other studies with various species/substrate combinations (Appels, et al., 2019; Liu et al., 2019; Shakir, et al., 2020). Due to the nature of the 3-point test, it is difficult to distinguish the relationship between the three-dimensional shape bending with the force applied, and the strength of the material itself. Nonetheless, it did give insight into the deformation behaviour, as it could be observed how the shape changed, and in what directions. For the design of the façade panel, it can now be predicted that the tile can deform in one central area, while the adjoining sides maintain shape (which can in turn affect neighbouring tiles in the larger panel configuration) which was observed in every sample tested. Interestingly, recent researched has indicated semi-wet (30-50%) heat-pressing of MBC has improved flexural strength (Song, et al., 2025), highlighting a possible improved method. However, there is still a lack of research into 3D-pressed forms beyond the variation of flat-pressed studies (Andrade, et al., 2026) due to the large variation in species, substrate and testing protocols. To form a conclusive answer to which heat-pressing methods are best in the context of 3D-shaped pressed samples, more tests of this kind should be undertaken in combination with necessary discussions amongst fellow researchers in this field to improve standardisation for the long-term progress of this biomaterial.

Regarding the tests performed on these MBC blocks, it must be concluded that further testing is required. Results are also influenced by species and substrate choice (Appels et al., 2019; Liu et al., 2019; Shakir et al., 2020). Further research could include tests of reflectivity, UV degradation, long term testing in context, and large-scale prototype testing (convection) in synchronicity with the broader goal of this project. For the purposes of this project, the key goal of determining if heat-pressing into a three-dimensional shape is possible was indeed achieved. And the accompanying tests performed indicate that there are certainly differences in material quality based on how the material is processed. MBC could be integrated into the project panel as heat-pressed MBC in the future, but not in the current state. These experiments revealed that the three-dimensional shape is indeed a viable option and can be assembled into a larger panel, but the importance of surface treatment for outdoor conditions is currently lacking in these samples. These tests proved the concept of heat-pressing rectangular MBC blocks into a three-dimensional shape, which paves the way for a variety of applications beyond this project scope (such as packaging, building materials, and more). Investigating the range of shapes possible would reveal to what extent these applications might be, and improving the strength of the material in these shapes would also enhance this.

## Part C: Product Development and Implementation

To successfully translate an innovation into a product that produces real- world change a concrete business and implementation plan is necessary. The following section examines how the façade panel can be turned into a product, which through its technological features reduces energy consumption and mitigates the UHI effect.

To achieve said goal a possible business model, Intellectual property (IP) strategies and implementation strategies are analysed. The section is a summary of three individual reports, all of which can be found in greater detail in their respective reports (Appendices F-H).

C.1. Business Model Analysis
The primary customer base for the FunctionalSkin is believed to be professional clients (Appendix F2), rather than individual homeowners. Based on this customer profile it is possible to create a value proposition canvas which highlights how the products and services provided translate into created gains and relieved pains for the customer (Figure 31).

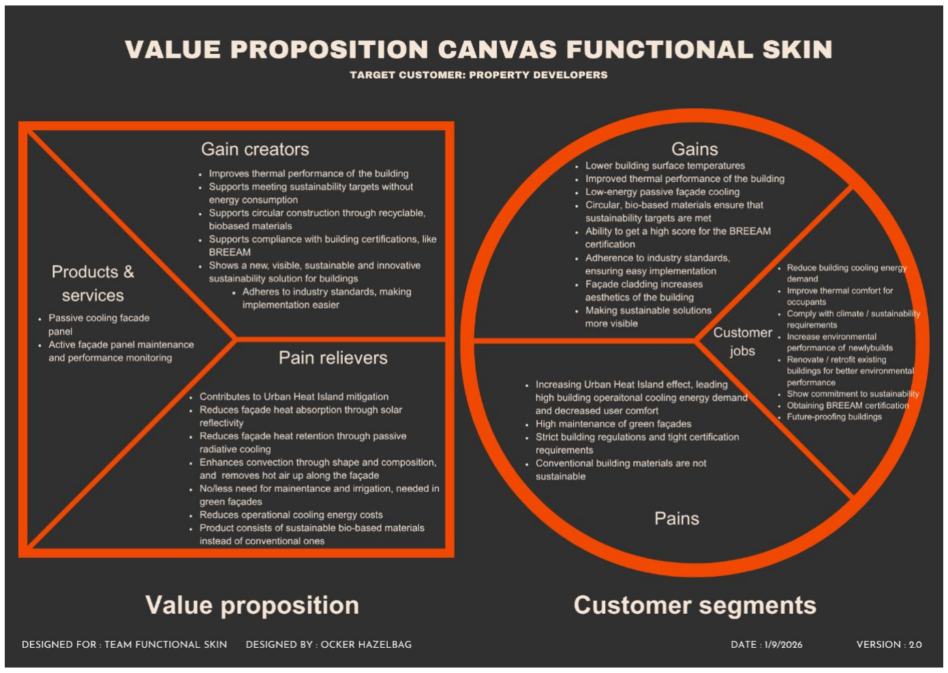
[picture p45: figure]

Figure 31: Value Proposition Canvas with property developers represented as target customer group
Apart from the primary customers there are other groups whose interest are indirectly represented through the customer. The residents as well as architects or construction workers tasked with installing the panel each give demands to the target customer which he needs to comply with. To fulfil the target customer’s needs, it is therefore important to address the needs of these additional stakeholder groups as well.

In the industry of façade cladding systems with a market share of 270.5 billion USD (Grand View Research, 2026), ventilated façade make up a share of 21.74 billion USD (WiseGuyReports, 2026). The biggest market advantages the FunctionalSkin has in this industry is its reliance on sustainable building materials and the passive cooling mechanism. They allow the panel to pass sustainable building regulations and reduce the time and costs needed for maintenance, compared to an active cooling mechanism.

When compared to other passive cooling façades, the FunctionalSkin would rank somewhere between a conventional ventilated façade and a living green wall in terms of both instalment and maintenance costs. Its cooling function is more sophisticated than that of a conventional ventilated façade panel. Similar to a Living green wall, its embodied carbon is low if biobased materials are used for its production (Table 13).

Table 13: Market comparison of the FunctionalSkin panel, a conventional ventilated façade, and a Living Green Wall.
Criterion | FunctionalSkin | Ventilated Façade | Living Green Wall
Installed cost | €150 - € 200 (assumption) | €50 - €120 (Kurian & | €450 - €1500 (Cost
per m² | | Karthi, 2022) | Comparison of Different
Types of Green Facades,
z.d.)
Maintenance
costs per m² per
year
€4 - €6 (assumption) | Low, optional cleaning | €50 - €150
Cooling function | Reflects solar heat, | Cavity ventilation | Shading and
| radiates absorbed heat into | | evapotranspiration by plants
space, channels warm air
upwards
Energy and
water input
None | None | Irrigation system required
Embodied | Low (biobased materials in | Higher (often non- | Low
carbon | use) | biobased materials in
use)

The main revenue streams for the product is the sale of façade panels to the customers. Maintenance services and performance monitoring services can generate additional revenues. IP Licensing is not a viable revenue stream for our product (Appendices F, G). The business model canvas combines activities, interactions with partners and customers, created values as well as costs and revenues into a concise infographic (Figure 32).

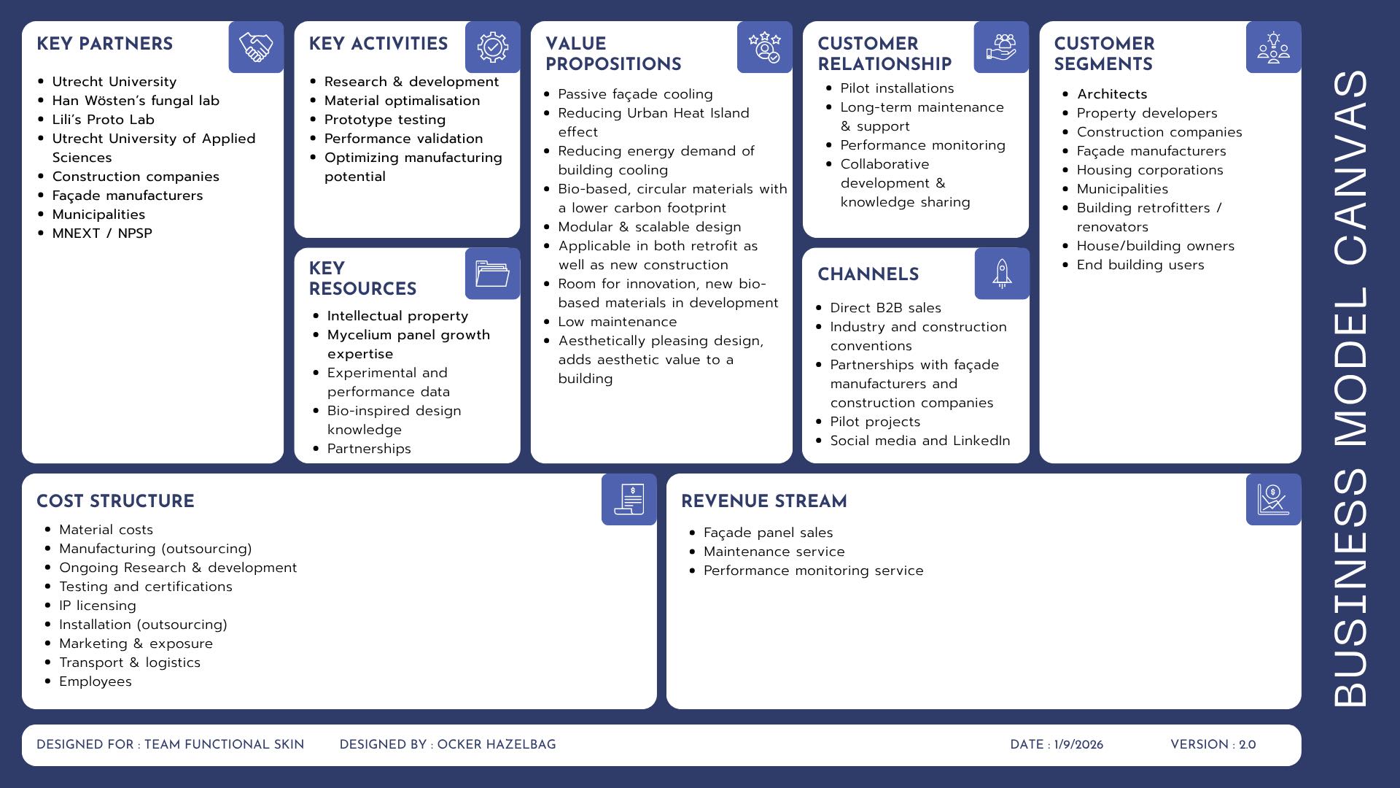
[picture p46: figure]

Figure 32: Business Model Canvas
C.2. Intellectual Property Analysis
One potential resource that was paid particular attention to is Intellectual Property (IP). An IP analysis serves the purpose of both identifying risks of IP infringement and chances of obtaining IP of our own. A preliminary search has not revealed IP infringements from the FunctionalSkin. However, this preliminary search is not equal to a full freedom to operate analysis, which could be used in communication with investors.

The relevance of our product components within the patent landscape are underlined in the quantitative patent analysis findings. Over the observed time of twenty years almost all categories which apply to the FunctionalSkin have seen a continuous increase in patent activity - with the sole exception of wood and wood based cladding systems, which had slightly less patents published in from 2022 to 2025 than during the previous four-year period (Appendix G). The highest increase in patent publications over the observed periods were patents on mycelium materials and forms of passive cooling, each having a three to fourfold increase in patents filed from 2022 to 2025 compared to the baseline of 2006 to 2009. Nonetheless, especially in the application of façade panels, wood-based inventions number almost 500 times higher than patent publications using mycelium materials. Most passive cooling façades focused on cooling via convection, while reducing solar heat gain via reflection and radiative cooling (also included in our prototype) were sparsely represented in new patent publications (Appendix G).

From a business model perspective these gaps can be interpreted as unoccupied niches in the market giving us opportunity to set our product apart and obtain an advantage over competitors. On the other hand, using wood as a material and utilising natural convection for passive cooling offers more established alternatives, while maintaining the sustainability advantages of using biomaterials and energy free cooling mechanisms (Appendix G).

For our own IP strategy, we decided not to invest money and time into obtaining a patent of our own. This decision is based on consultancy with an expert in IP, Maud Kerstholt and a representative of a company active in the field, Naud van der Padt from Leafy. Both experts suggested that obtaining and enforcing a patent is in many cases not a viable option for small startups (Appendix A). Furthermore, the developed product likely would not meet the requirements needed for a patent, as the design is not new (Pujadas-Gispert et al., 2020). Instead, the focus will be to obtain forms of IP that can be obtained by default. While copyright does not apply for our technologically defined product, information we do not publish can constitute a trade secret if we take some protective measures (Appendix G). Nonetheless we consider our commitment to open science and scientific transparency as more important than an optimal IP strategy.
C.3. Implementation Plan
On a technological level there are also multiple hurdles that need to be addressed to convert the prototype into a finished, commercial product. One of the steps required is an attachment mechanism to the façade. The attachment mechanism needs to support the structural load of the panel, which is primarily influenced by wind pressure and secondarily influenced by the weight of the panel. It also needs to be flexible to the dimensional changes of wooden panels which occur through moisture and temperature changes. It should leave the outer portion of the panel uninterrupted to ensure optimal functioning of the cooling mechanisms, resulting in a continuous reflective surface and unobstructed airflow. Lastly for maintenance purposes, the panel should be easily (de-) mountable.

Façade panels which leave the outer portion of the panel uninterrupted are classified as concealed systems. Point fixing systems are generally suitable for thin wall panels, as they do not create areas at which pressure on the panels becomes too great and support movement of the panel, without risk of breaking. The NV3 system by NVELOPE (SFS Benelux) is such a point fixed concealed system and fulfils all given requirements and can therefore be treated as a general recommendation. However, depending on local conditions like higher wind speeds, different mechanisms might be needed.

Another hurdle is the longevity of the product. The current prototype is made only of indoor plywood, which would have a lifespan of around one year in outdoor conditions (Van den Bulcke et al., 2010). For a commercially viable product a longer lifespan is needed, which can be achieved by using more resistant wood and treating the wood. For the FunctionalSkin douglas fir will be used (Appendices C, E). Viable treatment options for increased longevity include thermal modification and acetylation (Aro et al., 2014; Candan et al., 2012; Lovrić et al., 2017; Slabohm et al., 2022). The most ecofriendly alternative is impregnation with natural oils or waxes; however, this protective layer would need to be reapplied regularly (Jebrane et al., 2017). In general, to make the product attractive for customers, some form of maintenance should be offered as a service (Appendices C, F, H). This can also serve as an additional revenue stream for us. In the case of a wooden panel, gentle washing instead of high-pressure cleaning is required (Gustavsen et al., 2026).

A key hurdle that must be addressed is ensuring fire safety, otherwise, the entire panel would be unusable. For application in a high rise building the panel needs to adhere to the Euro-fire class B and in any case at the minimum fire class D has to be reached (EOTA, 2012). This poses a challenge, as the FunctionalSkin has multiple features which make it susceptible to fire. Both materials of wood and mycelium are flammable (M. Jones, Bhat, Kandare, et al., 2018; X. Li et al., 2024) and the chimney-like structure that utilizes upward convection of warm air to remove heat from the façade, could serve to supply a fire with more oxygen and transport it upward the façade quickly (Appendix H). Therefore, fireproofing mechanisms like fireproof coatings and fire barriers will be necessary (Fire Protection Association, 2023), as the in the end the whole façade needs to adhere to the fire class, even if components of the façade would have different individual classifications (Kaukanen, 2026).

Other considerations to be measured for the final panel is degree of thermal and acoustic insulations, which according to the Besluit Bouwwerken Leefomgeving (BBL), should insulate at least 20 dB of sound and have an Rc value of at least 4.7 (Rijkswaterstaat, n.d.). Lastly the manufacturing process needs to be scaled up to reduce the cost of a single panel, and an eco-friendly end of life plan should be provided (Appendix H).

Each technological challenge requires additional time and money to develop and produce a solution. Furthermore, for each technology introduced there is an additional risk of patent infringement. From a business perspective it might therefore be an attractive option to either license another company’s technology or collaborate with another company to arrange for parts of the product preproduced by them.

C.4. Technological Readiness Level and Development Roadmap
At the beginning of this project the client expressed the wish of bringing the product to a Technology Readiness Level (TRL) 5. This following section will investigate to which extent we succeeded in this endeavour, and which steps would be necessary to advance the product further on the technological readiness scale.

The TRLs are a scale originally developed by NASA used to define the status of technological products. There are multiple iterations of the TRL scales, the definitions that will be used for this paper are taken from the European Commission’s criteria to evaluate EU funded projects (Bruno et al., 2020). It ranges from the observation of basic principles (TRL 1) all the way to a fully established product on the market, proven in an operational environment (TRL 9).

This project continued a previous project initiated in 2025 by another group of students, who established an experimental proof of concept for the technology (Boer et al., 2025), corresponding to a TRL 3 product. Due to differences in testing methodology, it was not possible to continue working on the same prototype and advance it to higher TRL stages. Instead, building on their work, the design was improved further, effectively returning the project to TRL 2. Subsequently, an experimental proof of concept, using temperature and wind-speed measurements in simplified chimney models was established, thereby advancing the project to TRL 3. Finally, a functioning prototype was developed and tested under laboratory conditions, advancing the project to TRL 4.

The goal of a TRL 5 product, according to the European Commission’s definition, is a functioning prototype of a product component that has been tested in a relevant environment. What this translates to in the context of the FunctionalSkin would be a panel installed to an outside wall of a building. Testing in outdoor conditions can be a realistic goal for future research groups continuing the FunctionalSkin project. It would not require the covering of an entire façade, as this would already correspond to TRL 6. Finally, successfully carrying out all of the propositions of the implementation plan and integrating the product in the proposed business model is what would allow the product to reach the final TRLs of 7-9 (Bruno et al., 2020).

## General Discussion and Conclusion

This Major Innovation Project investigated how a façade panel can passively cool buildings and the surrounding urban environment, using nature as a source of inspiration. Several literature studies have been carried out, finding bio-models for passive cooling, analysing material properties and choosing materials, and finding the most suitable shape and design. Also, experiments were carried out to address the research question and validate the performance of the panel, consisting of modular 15 x 15 cm tiles made of 5.5 mm thick plywood, coated in CryoPaint®. Lastly, the business case was strengthened by developing a business model, assessing intellectual property options, and drafting an implementation plan

The panel demonstrated passive cooling properties in the experiments, demonstrating that the design, and material functioned as hypothesized under experimental conditions. Analysing the results, convective airflow was observed within the test setup with the simplified shaft, as well as the final design, being substantially higher than the negative controls. Both a greater panel thickness (5.5 – 9 mm vs 12 mm) and a radiative cooling coating lowered the temperature of the backwall. Thus, subject to conditions, indicating the highest passive cooling properties.

When testing the final design in the climate chamber under a 30 °C summer baseline, the CryoPaint®-coated prototype lowered the STBI to 39.2 °C under natural convection. This is a 24.8 °C reduction compared to the unventilated control (64.0 °C) and 7.0 °C lower than the flat CryoPaint® reference (46.2 °C), which substantiates the effect of the added geometry. When introducing an external wind field (2–4 m s⁻¹), the upper cavity exhaust velocity accelerated nearly fourfold, from 0.47 m s⁻¹ to 1.77 m s⁻¹, suppressing STBI further to 34.2 °C and backwall backside temperature (STBB) to 29.0 °C, below the 30 °C ambient chamber baseline. This demonstrated the feasibility of integrating multiple complementary passive cooling strategies into a single façade panel. Although these strategies contribute to UHI mitigation, the effect of the panel on building cooling demand and local urban air temperature was not quantified in this project and requires further real-world assessment.

Currently, heat-pressed MBCs as a façade material are only at TRL 3, as its main value lies in its potential as a future material. The MBC blocks can be heat-pressed into a rounded, three-dimensional shape using a mould, but the current mechanical and moisture-related properties prevent the material from being considered for façade application. The heat-pressed blocks were tested for white value, water contact angle, water absorption and flexural strength. These tests revealed the need for a surface coating for use in wet weather and to optimise surface reflectivity. An added coating could also improve the flexural strength of the material, which showed improvements in comparison with its flat-pressed counterparts, potentially due to the rounded three-dimensional shape.

Thermal performance

In previous research, the thermal performance of façades with the same geometry was assessed using different materials (Nabasco® 8010 and aluminium), under both experimental and real-world conditions (Boer et al., 2025; Pujadas-Gispert et al., 2020).

Pujadas-Gispert et al. (2020) evaluated the thermal performance of their ventilated façade in Dubai, finding that the temperature and air velocity in real-world measurements showed upward airflows that contributed to heat dissipation along the façade during the daylight hours. Upward airflow velocities of up to 8 m s⁻¹ were achieved within the façade during daytime hours, with a difference of about 4 m s⁻¹ between the top and bottom. In addition, a relation between outdoor wind speeds and cavity air velocity was found. This relation was tested under Dutch climate conditions in the climate chamber. The addition of a wind stream (2–4 m s⁻¹) increased cavity air velocity from 0.47 m s⁻¹ to 1.77 m s⁻¹, moving accumulated thermal energy out of the cavity, reducing the vertical cavity temperature differential from 5.5 °C to 0.8 °C, and lowering STBI from 39.2 °C to 34.2 °C. This agrees with the results of Boer et al. (2025) and Pujadas-Gispert et al. (2020): both indicate that ambient wind adds to buoyancy forces to drive upward convective airflow within the façade cavity, rather than causing aerodynamic blockage or stagnation.

Pujadas-Gispert et al. (2020) found a temperature difference of up to 15 °C between the outer panel and apartment outside wall in 40 °C weather. This was attributed to the shading, insulation and airflow provided by the façade layers. But the airflow claim was not evaluated using negative controls, leaving room for further research. In this Major Innovation Project (MIP), the effect of convective airflow on the panel’s cooling properties was evaluated using a simplified shaft, showing that sealing the lower intake in the negative control resulted in stagnant recirculation, a vertical air gradient of only 0.60 °C, and an elevated backwall temperature (STBI) of 44.3 °C. By contrast, opening the bottom inlet to allow natural buoyancy-driven airflow established a vertical cavity gradient of 7.2 °C and reduced the backwall temperature by 4.54 °C (to 39.80 °C) in the 8 cm deep panel, and by 10.48 °C (to 33.86 °C) in the 16 cm deep panel.

However, Pujadas-Gispert et al. (2020) showed a variation in air velocity between lower and upper parts of the façade, claiming that the airflows within the façade were disjointed and non-continuous. This is likely because the individual tiles were mounted directly onto a backboard, closing off an extra cavity behind that wall. In the final prototype in the MIP, a framework was constructed that ensured that a continuous flow of air could be generated along the façade, in the cavity between the panel and the backwall, leading to larger air velocities throughout the whole cavity. Boer et al. (2025) support this choice, as they showed experimentally that air velocity, and thus the passive cooling capacity, was highest when lamellae were placed and shafts were formed. This suggests that continuous vertical shafts reduce flow disruption within the panel and sustain higher air velocities than segmented cavities.

Although these previous experiments by other universities were done under different conditions, they support the panel’s expected thermal performance, even in the Middle Eastern climate of Dubai (Pujadas-Gispert et al., 2020). However, the findings in this project in the first setup, as well as the climate chamber, cannot directly be translated to performance on an existing façade.

First, different temperatures, humidity levels, wind speeds, rain, and UV exposure should all be tested in real-world installations as well as controlled environments. It can then be determined what effect the application of such a façade panel actually has over the course of a whole year, and whether it only offers benefits in summer under ideal conditions. Furthermore, the weather resistance of the final chosen material should be evaluated over longer periods of time, finding out if the performance of the panel deteriorates as the panel wears down. The panel has so far only been tested under conditions simulating a hot summer day, so its performance in other seasons or weather conditions remains unknown.

Compared to Boer et al. (2025), who reported a 3.4 °C reduction in the STBI temperature comparing a configuration with the panel to one without it, the prototype tested in this MIP achieved a reduction of up to 24.8 °C under natural convection alone, rising to almost 30 °C with added wind. While a direct comparison with Pujadas-Gispert et al. (2020), who reported a 15 °C difference between the panel’s outer layer and inner wall in Dubai, is limited by differing metrics and climates, the scale of reduction in this MIP indicates that the design’s passive cooling capacities are at least competitive with, or even exceed, those of previously studied panels.

Material requirements

Based on the panel’s requirements and the Material selection report findings, plywood was selected as the prototyping material (Appendix C). Its possible use was also included in the LCA (Appendix E). However, the Material selection report concluded that Douglas fir would be the most suitable wood type for the project. Further analysis and expert interviews showed that Douglas fir would be too thick for the design of the prototype, which is why plywood was chosen (Appendices A, C). Increasing the panel dimensions from 15 x 15 cm to 30 x 30 cm (following the tile size used by Pujadas-Gispert et al., 2020), could already enable the use of thicker, solid timber replacing the plywood. Plywood should therefore be regarded as a prototyping material, rather than the final optimal material for the panel, as it is not suitable for outdoor façade applications without an extra durable coating. At higher TRLs, the required thickness, durability and manufacturing process may instead favour solid timber or a biobased composite.

In addition, the results of the LCA showed a GWP of 4.02 kg CO₂e/FU for Douglas fir, while outdoor plywood had a GWP of 15.52 kg CO₂e/FU (Appendix E). When corrected for annual lifespan, the difference increased further. This suggests that the environmental impact of the panel made from plywood could potentially be reduced significantly by replacing it with raw Douglas fir timber, if the required panel thickness increases. The potential of a thicker panel was substantiated in the simplified shaft experiments, where the 12 mm thick panel showed substantially higher thermal insulation and delayed thermal breakthrough, reducing the inner backwall temperature to 35.0 °C (compared to 39.80 °C for the 5.5 mm standard panel) while extending the time to reach thermal equilibrium (tplateau = 1.35 vs. 0.96 h) and dissipating 123 W of convective heat.

Additionally, heat-pressed MBCs were chosen as a possible future biomaterial for the panel. Literature review in the Material selection report showed that heat-pressed MBCs have not yet been extensively tested for outdoor durability, which presented a research gap that could be investigated (Appendix C). The literature review also showed that a cubical MBC had not yet been heat-pressed in a three-dimensional shape, using a mould. Through testing and consultation of mycelium experts dr. Jordi Pelkmans and Fran Ortega Exposito (Appendix A), it was shown that heat-pressing into a desired shape was possible using only a heated aluminium mould and 115 kN of force for 5 min. However, the cubical blocks repeatedly showed signs of tearing at the middle bulge, implying that the flexural strength of the MBC was too low in this area. Future development could involve growing the MBCs directly into the required shape, decreasing the flexural tension in these locations. Another option could be to repair the torn MBCs after heat-pressing, by regrowing that part. However, this option seems less viable at larger manufacturing scale.

To test the properties needed for possible panel application, the whiteness, flexural strength, water contact angle and water absorption were tested. From these tests, the materials were observed to darken in colour and show inadequate water resistance indicating the need for a coating for outdoor weather exposure due to the material deforming and swelling with water. Upon flexural strength testing, the 3D-pressed MBCs had similar or higher strengths than their flat counterparts (and broader literature (Appels, et al., 2019; Liu, et al., 2019; Shakir, et al., 2021)) and gave insight into the behaviour of the three-dimensional shape under bending stress. With the 3D-samples showing similar flexural strengths with larger material deformations, this could indicate a more durable material under bending stress thanks to the geometry of the round design (due to distribution of pressure). The prototypes show potential as a façade panel, however further testing and iterations are necessary to determine further applicability especially in an outdoor context, as well as more standardised methods in accordance with the highly variable, broader literature (Andrade, et al., 2026) especially in terms of opening a new avenue of research into novel heat-pressing into three-dimensional shapes.

MBCs have also been included in the LCA, with a GWP of 11.34 kg CO₂e/FU, which is slightly lower than indoor plywood and about three times as high as Douglas fir. The GWP of the MBC was not corrected per year of the lifespan, as the outdoor durability is currently unknown. Recent research has shown that MBCs can be grown over diurnal temperature cycles, eliminating the need for an incubator (Livne et al., 2024). Livne et al. (2024) found that the incubator accounts for 73% of the embodied energy and more than 40% of the CO2 emissions, this type of production could drastically reduce the GWP of MBCs.

Scalability and manufacturability

The current production process is developed primarily for prototype production and therefore does not reflect the requirements for large-scale manufacturing. Currently, the prototypes are cut into shape using a small-scale CNC mill, and must be steamed, curved and glued one by one. Realistically, this process is not suitable for large-scale production, as building one 120 x 60 cm panel already took more than a full day of labour.

At larger production volumes, the fabrication time per panel could be decreased by processing in larger batches, reducing average setup time per panel, and increasing process refinement. However, the steps to be carried out for each individual panel would still take the same amount of time even when upscaling. By identifying the bottlenecks, the process could be streamlined for large-scale production. For example, the process of CNC milling is well suited to the current stage of prototyping, as it allows the plywood to be cut with high precision. However, the use of a CNC mill for processing a high number of panels becomes a limiting factor. As CNC milling is a subtractive process, each panel must be cut individually. The steaming, curving and gluing are likewise done one at a time, which means that this part of the processing time will increase linearly with the production volume.

Pujadas-Gispert et al. (2020) used an alternative manufacturing approach, heat-pressing the raw material (Nabasco® 8010) directly into a mould. This type of manufacturing would be more suited for large-scale production, as the wanted geometry of the panel can be made in one step, instead of several. In addition, the number of panels that can be made at once is limited by the size of the press and the number of moulds that are available. Within that constraint, however, several panels can be pressed simultaneously. This can both reduce the processing time per panel and make the manufacturing process easier to scale. Naturally, future research should investigate the manufacturing process together with the final material, rather than optimising these independently.

Bio-models / bio-inspiration

At the start of the project an analysis was carried out, where nature’s passive cooling strategies were listed (Appendix B). Next, suitable bio-models were analysed and evaluated for application in the façade panel. The bio-models of the Archaeoprepona demophon butterfly, silkworm and Saharan silver ant seemed most promising because of the nanostructures that can perform radiative cooling (Lee et al., 2022; Ling et al., 2023; Shi et al., 2015). Moreover, a combination of the simplified Insubark corrugated prototype and the cactus bio-model inspired the implementation of ridges onto the design, but it was decided that this fell outside the scope of the project (Henrion & Tributsch, 2009; Lewis & Nobel, 1977).

Looking back, the bio-models served mostly as a source of inspiration rather than as direct blueprints for the final solution. This is an important distinction, as the resulting cooling strategies may have been developed through conventional engineering solutions. This shows the risk of forced or backwards bio-inspiration, where biological analogies are applied to solutions that are already there, or could have been identified without the use of bio-models.

The bio-models for a bio-inspired radiative cooling coating showed most potential for integration in the product. Although it can be hypothesized that this coating could be used in the final product, CryoPaint®, a commercial radiative cooling coating was purchased for the experiments, as the bio-model could not be recreated within the scope of the project. This allowed the same passive cooling principle to be tested, but without implementing the bioinspired solution, leaving open whether bio-inspiration would offer any advantage over the conventional coating. It would require evaluating whether the biological mechanism could then be translated into a scalable, durable and weather-resistant material, instead of simply sourcing the non-bioinspired coating from another company.

Sustainability

At the start of the project, a number of sustainability objectives were set out for the panel: the panel must passively cool building façades without any operational energy required, the panel must be made from recyclable, biobased and eventually circular materials, the panel must be made out of modular, easily replaceable components, and the panel must have reduced environmental impact in comparison to its (in)direct competitors. Although design choices were made with the intention to improve the sustainability of the product, meeting these objectives does not necessarily result in lower environmental impact. This leads to the central question: To what extent does the proposed panel represent an environmentally sustainable solution when considering both its environmental impact and its potential cooling benefits?

In the LCA, it is addressed that the cooling power, or reduction in cooling energy demand of the product, is not included in the analysis. This represents a significant limitation, as this would provide a direct way to justify the environmental impact of its production. Future research should try to calculate under what conditions the operational benefits of the façade panel could outweigh its environmental impacts. Susca & Pomponi (2020) propose two approaches to incorporate the interactions between the built environment and the local climate, such as the passive cooling properties of a façade panel, into an LCA. The paper proposes site specific climate modelling (Approach A) or simplified physical relationship calculations (Approach B). Approach A seems promising, but would require the use of site-specific climate data, which would mean that the product’s LCA needs to be assessed for each specific location of use. However, Approach B would be less demanding, but also less accurate, because of the simplified nature of the calculation. Approach A would be more suitable, as the passive cooling effect of the panel is extremely dependent on local environmental conditions, such as solar radiation, surrounding buildings, and local wind speeds. Future services offered by the company could therefore include modelling the panel’s performance for a specific location and conducting an environmental cost-benefit analysis. This enables the company to communicate the sustainable nature and benefits of the panel to future customers in a transparent manner.

Consequently, the central question asked at the start of this paragraph cannot yet be answered conclusively. Although the LCA quantifies the environmental costs, it remains unclear if the cooling benefit can offset these costs. Whether the panel is truly an environmentally sustainable option, should be determined in future research through the ways described above.

## Recommendations for future product development

Future product development should primarily focus on further optimalisation of the panel under realistic real-world conditions. Outdoor testing across different weather conditions and seasons would provide more insight into the long-term thermal performance and the weather resistance. Future research could use urban-scale UHI mitigation modelling to generate more data on the panel’s performance in different scenarios. Afterwards, including the urban cooling benefits into the LCA would allow the environmental impacts of the panel to be weighed against the potential operational and urban cooling benefits.

Simultaneously, long-term weathering tests of the different wood species and MBCs, together with further investigation in heat-press and mould manufacturing of eventual other biobased materials, and investigation of larger panel dimensions to enable the use of a thicker solid timber, are needed to assess the durability, manufacturability and scalability. And, to make a final choice on the optimal material of the panel.

At last, future research should investigate whether the panel geometry could be simplified while maintaining the convective cooling capacities, and if a bio-inspired alternative to CryoPaint® can provide comparable radiative cooling performance.

## AI Statement

This paper used GenAI (ChatGPT, Claude & Gemini) responsibly for the following components: brainstorming, grammar correction, sentence reforming, calculations, feedback. DeepL was used for translation purposes.

## Acknowledgments

We would like to express our gratitude to dr. Pauline Krijgsheld and prof. dr. Han Wösten for their guidance during the project. We extend this appreciation to dr. Jordi Pelkmans and the fungal lab, and Lili’s Proto Lab from Utrecht University, who provided access to essential instrumentation and facilities needed for our project.

Additionally, we would like to specifically thank Marcel de Reeder, who gave us the opportunity to test our prototype in a climate chamber, Zachary Leopold, who gifted us waste MBC blocks to make our fungal prototype with, and Jeroen van den Brandhof, who provided valuable insights on the working and possibilities of Arduino.

We would also like to acknowledge financial support from Utrecht University that made this project possible.

## Statement of Contribution

This report was co-authored and as such both their contributions here and throughout the project can be described and attributed below.

- Alexandra Cooke-Kasyanto:
research and reporting on convection-based cooling mechanisms and their bio-models research and writing of design report; digital modelling of heat-pressing mould and previous prototype iterations; CNC assistance for aluminium mould fabrication at LPL (with Felipe); mycelium experimental planning and design; conducting fungal experiments at the UU fungal laboratories with Ruben (and consulting with expert dr. Jordi Pelkmans when needed); mycelium experimental results analysis and writing of mycelium section; research and writing parts of implementation plan (with Ruben); interviews with experts Arne Hendriks and Naud van der Padt (together with Felipe).
- Felipe Krebs:
Research and reporting on conduction and evaporation based cooling mechanisms; data collection, analysis and reporting on the Life cycle assessment for mycelium materials; data collection and reporting on the Intellectual property analysis; writing of report section C, abstract and Lay summary; expert interviews with Maud Kerstholt, Naud van der Padt; 3D-modelling in Autodesk Fusion, for models such as the basic façade panel, the ridge design, the source file for CNC milling, and other designs featured in the design report, such as a simplified block design; manufacturing of the aluminum mould used for heat-pressing the mycelium panel, milling and folding, gluing of the individual wooden tiles needed to produce the wooden panel.
- Jochem ten Pas:

Literature research on radiative cooling and its biomimetic models, and writing the corresponding mini-report (WP1); developing, constructing and carrying out simplified shaft and climate chamber experimental setups together with Ocker (WP4); writing the complete experimental report on the simplified shaft and climate chamber experiments (WP6), including developing the theoretical framework for data analysis and performing the data analysis in R; booking and coordinating workspace for the duration of the MIP; 3D-modelling in Fusion 360 of jigs to aid prototype construction; learning to program Arduino-based sensors, including system setup and soldering, for the experimental setup, although it was ultimately not used; assisting with mycelium-based composite laboratory work under Alex's lead; contributing to the construction of both the wooden and mycelium-based prototypes, including constructing the wooden batten framework and assembling the prototype onto it, designing and laser-cutting mycelium moulds, laser-cutting components for the first proof-of-concept wooden panel, and heat-pressing mycelium into a corrugated shape for the mycelium panel; preparing and conducting an interview with Peter Oei on MBCs; preparing and conducting interviews with Willem Böttger and Fran Ortega Exposito together with Ocker.
- Ocker Hazelbag:
Literature research on and writing about natural and conventional reflective cooling mechanisms, the possible integration section and the conclusion (WP1); literature research on and writing the section about mycelium-based composites (WP2); thorough analysis of all sections and writing a discussion and the final recommendations for the final report (WP6); writing most of the expert interview section in final report; final formatting and layout, title page, Zotero check final report; developing, constructing and carrying out simplified shaft & climate chamber experimental setups together with Jochem (WP4); finishing final prototype for climate chamber testing together with Jochem; thinking out an Arduino-based sensor setup, learning (simple) Arduino code, system design, troubleshooting and soldering of the final setup, although it was ultimately not used; conducting a business model analysis, including a value proposition and business model canvas (WP5); preparing and delivering final presentation together with Ruben; preparing and conducting interviews with Willem Böttger together with Jochem and Fran Ortega Exposito.
- Ruben Langendoen:
Literature research on and writing the material report, besides the MBC part (WP2); Conducting and writing the four types of wood part of the LCA (WP2); Researching and writing of parts of the implementation plan (Attachment requirements, attachment methods and recommendations, weathering of timber, timber treatment, maintenance) (WP5); Writing the theoretical background and part A of the final report; do terminology check of the final report(WP6); preparing and delivering all three presentations during the project (with Felipe, Alex and Ocker respectively); Assembling and constructing the final panel together with Felipe and Jochem; involved in the process of growing the fungal blocks and heat-pressing them into a three-dimensional shape; helped conducting the fungal experiments (Alex had the lead).

## References

Abid, U., & Abid, A. (2023). A parametric analysis of wind effects on tall buildings according to European, American, and Australian standards. TechRxiv. https://doi.org/10.31224/3183
Adhikari, S., & Ozarska, B. (2018). Minimizing environmental impacts of timber products through the production process “From Sawmill to Final Products”. Environmental Systems Research, 7(1), Article 6.https://doi.org/10.1186/s40068-018-0109-x
Ahluwalia, J., & Khurana, L. (2025). Building envelopes and the urban heat island effect: A review of mitigation strategies through advanced façade and roofing materials. Journal of Interior Designing and Regional Planning, 10(1),25–31. https://doi.org/10.46610/JoIDRP.2024.v010i01.003
Alabdulrazzaq, H., Gasparri, E., Attia, S., & Brambilla, A. (2026). Comparative study of conventional and emerging façade systems: Pathways to reducing embodied carbon and enhancing circularity in buildings. Energy and Buildings,367, Article 117778. https://doi.org/10.1016/j.enbuild.2026.117778 Aldana, J. A., Kope, H. H., & Hawkins, B. J. (2023). Western redcedar—Natural history and pathosystems, with
emphasis | on | cedar | leaf | blight. Canadian | Journal | of | Plant | Pathology, 45(4), 377–
390.https://doi.org/10.1080/07060661.2023.2198489
Alemu, D., Tafesse, M., & | Mondal, A. K. (2022). Mycelium-based | composite: The | future | sustainable
biomaterial.International | Journal | of | Biomaterials, 2022, Article
8401528. https://doi.org/10.1155/2022/8401528
Altamimi, M. M. S., Saeed, U., & Al-Turaif, H. (2023). BaSO4/TiO2 microparticle embedded in polyvinylidene
fluoride-co-hexafluoropropylene/polytetrafluoroethylene | polymer | film | for | daytime | radiative
cooling. Polymers, 15(19),Article 3876. https://doi.org/10.3390/polym15193876
Altgen, M., & Militz, H. (2017). Thermally modified Scots pine and Norway spruce wood as substrate for coating
systems. Journal | of | Coatings | Technology | and | Research, 14(3), 531–
541. https://doi.org/10.1007/s11998-016-9871-8
Andrade, L., Costa, L., & Wedderhoff Herrmann, L. (2026). Heat-pressing of mycelium-based composites: An integrative review of processing parameters and mechanical properties. Biofunctional Materials, 1– 36.https://doi.org/10.55092/bm20260003
Andrady, A. L., Heikkilä, A. M., Pandey, K. K., Bruckman, L. S., White, C. C., Zhu, M., &
Zhu, L. (2023). Effects of UV radiation on natural and synthetic materials. Photochemical & Photobiological Sciences, 1–26.https://doi.org/10.1007/s43630-023-00377-6
Andrés-Anaya, P., Sánchez-Aparicio, M., del Pozo, S., & Lagüela, S. (2021). Correlation of land surface temperature with IR albedo for the analysis of urban heat island. Engineering Proceedings, 8(1), Article 9.https://doi.org/10.3390/engproc2021008009
Appels, F. V. W., Camere, S., Montalti, M., Karana, E., Jansen, K. M. B., Dijksterhuis, J., Krijgsheld, P., & Wösten, H.A. B. (2019). Fabrication factors influencing mechanical, moisture- and water-related
properties | of | mycelium-based | composites. Materials | & | Design, 161, 64–
71. https://doi.org/10.1016/j.matdes.2018.11.027
Appels, F. V. W., & | Wösten, H. A. B. (2021). Mycelium | materials. In Encyclopedia | of
mycology (Vol. 2, pp. 710–718).Elsevier. https://doi.org/10.1016/B978-0-12-809633-8.21131-X Arepolage, T., Verdy, C., Sylvestre, T., Leray, A., & Euphrasie, S. (2024). Controlling heat capacity in a thermal concentrator using metamaterials: Numerical and experimental studies. International Journal of Heat and Mass Transfer, 220, Article 124909. https://doi.org/10.1016/j.ijheatmasstransfer.2023.124909 Armstrong, J., Armstrong, W., & Beckett, P. M. (1992). Phragmites australis: Venturi- and humidity-induced pressure flows enhance rhizome aeration and rhizosphere oxidation. New Phytologist, 120(2), 197– 207.https://doi.org/10.1111/j.1469-8137.1992.tb05655.x
Aro, M., Brashaw, B., & Donahue, P. (2014). Mechanical and physical properties of thermally modified plywood
and | oriented | strand | board | panels. Forest | Products | Journal, 64(7–8), 281–
289. https://doi.org/10.13073/FPJ-D-14-00037
Aryal, S. (2022, August 10). Potato dextrose agar (PDA)—Principle, uses, composition, procedure and colony characteristics. Microbiology Info. https://microbiologyinfo.com/potato-dextrose-agar-pda-principle-uses-composition-procedure-and-colony-characteristics/

Asare, S., Stoescu, M., Balmori, L., Allena, S., Kidando, E., & Owusu-Danquah, J. (2024). Freeze-thaw effect on the mechanical properties of different wood species: Impact of moisture content variations, microscopic morphology, and thermal modification in a selected species. Journal of Infrastructure Preservation and Resilience, 5(1), Article 14.https://doi.org/10.1186/s43065-024-00108-w
AskNature. (2017). Cactus ribs keep them cool. https://asknature.org/strategy/shape-shades-and-enhances-heat-radiation/
AskNature. (2020). Asymmetric | burrow | openings | create | passive
ventilation. https://asknature.org/strategy/asymmetric-burrow-openings-create-passive-ventilation/AskNature. (2022). How wetland plants get air to waterlogged roots. https://asknature.org/strategy/wetland-plants-get-air-to-waterlogged-roots/
Assink, P., van der Grift, A., Poelman-Kraak, B., van Weert, O., & Willemen, M. (2022). Hout heeft de
toekomst.Algemene | Vereniging | Inlands
Hout.https://www.avih.nl/administration_uploaded/80/1/Boek_AVIH_compleet_240x320mm_WEB_pdf_light.pdf
Atiganyanun, S., & Kumnorkaew, P. (2023). Effects of pigment volume concentration on radiative cooling properties of acrylic-based paints with calcium carbonate and hollow silicon dioxide
microparticles. International | Journal | of | Sustainable | Energy, 42(1), 612–
626. https://doi.org/10.1080/14786451.2023.2221082
Auffhammer, M., Baylis, P., & Hausman, C. H. (2017). Climate change is projected to have severe impacts on the frequency and intensity of peak electricity demand across the United States. Proceedings of the National Academy of Sciences, 114(8), 1886–1891. https://doi.org/10.1073/pnas.1613193114 Augustina, S., Dwianto, W., Wahyudi, I., Syafii, W., Gérardin, P., & Marbun, S. D. (2023). Wood impregnation in relation to its mechanisms and properties enhancement. BioResources, 18(2), 4332– 4372.https://doi.org/10.15376/biores.18.2.Augustina
Austin, E., Geisler, A. N., Nguyen, J., Kohli, I., Hamzavi, I., Lim, H. W., & Jagdeo, J. (2021). Visible light part I:Properties and cutaneous effects of visible light. Journal of the American Academy of Dermatology, 84(5), 1219–1231.https://doi.org/10.1016/j.jaad.2021.02.048
Bahaideen, F. B., Saleem, A. M., Hussain, M. T. K., Mohd. Ripin, Z., Ahmad, Z. A., Samad, Z., & Badarulzman, N. A.(2009). Fatigue behaviour of aluminum alloy at elevated temperature. Modern Applied Science, 3(4), 52–60.https://doi.org/10.5539/mas.v3n4p52
Baker, M. C. (1964). Thermal and moisture deformations in building materials (Canadian Building Digest No. CBD-56). National Research Council Canada. https://doi.org/10.4224/20325075
Barbosa, S., & Ip, K. (2014). Perspectives of double skin façades for naturally ventilated buildings: A
review.Renewable | and | Sustainable | Energy | Reviews, 40, 1019–
1029. https://doi.org/10.1016/j.rser.2014.07.192
Barbhuiya, S., & | Das, B. B. (2023). Life | cycle | assessment | of | construction
materials: Methodologies, applications and future directions for sustainable decision-making. Case Studies in Construction Materials, 19, Article e02326.https://doi.org/10.1016/j.cscm.2023.e02326 Barcík, Š., Gašparík, M., & Horejš, P. (2014). Influence of thermal modification on nail withdrawal strength of spruce wood. BioResources, 9(4), 5963–5975. https://doi.org/10.15376/biores.9.4.5963-5975 Bazzocchi, F., Ciacci, C., & Di Naso, V. (2022). Rainscreen system. In Sustainable buildings: Development of
low | energy | and | eco-friendly | constructions (pp. 85–104). Bialystok | University | of
Technology. https://doi.org/10.24427/978-83-67185-24-0_5
Bedon, C. (2016). Review on the use of FRP composites for façades and building skins. American Journal of Engineering and Applied Sciences, 9(3), 713–723. https://doi.org/10.3844/ajeassp.2016.713.723 Berdahl, P., & Bretz, S. E. (1997). Preliminary survey of the solar reflectance of cool roofing materials. Energy and Buildings, 25(2), 149–158. https://doi.org/10.1016/S0378-7788(96)01004-3
Bogas, J. A., de Brito, J., & Ramos, D. (2016). Freeze–thaw resistance of concrete produced with fine recycled
concrete | aggregates. Journal | of | Cleaner | Production, 115, 294–
306. https://doi.org/10.1016/j.jclepro.2015.12.065

Bonenberg, A., Sydor, M., Cofta, G., Doczekalska, B., & | Grygorowicz-Kosakowska, K. (2023). Mycelium-
based | composite | materials: Study | of | acceptance. Materials, 16(6), Article
2164. https://doi.org/10.3390/ma16062164
Born, M., Wolf, E., Bhatia, A. B., Clemmow, P. C., Gabor, D., Stokes, A. R., Taylor, A. M., Wayman, P. A., & Wilcock,W. L. (1999). Principles of optics: Electromagnetic theory of propagation, interference and diffraction of light (7th ed.).Cambridge University Press.
Bose, S. (1994). Planck’s law and the light quantum hypothesis. Journal of Astrophysics and Astronomy, 15(1), 3–7.https://doi.org/10.1007/BF03010400
Brelid, P. L. (2016). Benchmarking and state of the art for modified wood. SP Technical Research Institute of Sweden.
Britannica. (2026). Convection. In Encyclopædia Britannica. https://www.britannica.com/science/convection Bruno, I., Donarelli, A., Marchetti, V., & Schiavone Panni, A. (2020, March 11). Technology readiness revisited: A proposal for extending the scope of impact assessment of European public services. ICEGOV.https://ec.europa.eu/isa2/sites/isa/files/technology_readiness_revisited_-_icegov2020.pdf
Cabral, M. R., & Blanchet, P. (2021). A state of the art of the overall energy efficiency of wood buildings—An overview and future possibilities. Materials, 14(8), Article 1848. https://doi.org/10.3390/ma14081848
Cameron | Pimperl, L. (2009). Radiation. In Clinical | neurotoxicology (pp. 543–
565). W.B. Saunders.https://doi.org/10.1016/B978-032305260-3.50054-X
Candan, Z., Büyüksarı, U., Korkut, S., Unsal, O., & Çakıcıer, N. (2012). Wettability and surface roughness of
thermally | modified | plywood | panels. Industrial | Crops | and | Products, 36(1), 434–
436.https://doi.org/10.1016/j.indcrop.2011.10.010
Cardinali, M., Di Giuseppe, A., Castellani, B., Filipponi, M., Nicolini, A., & Rossi, F. (2022). An investigation towards the optimum design of retro-reflective materials as building envelopes for the enhancement of
optical | performance.Construction | and | Building | Materials, 358, Article
129466. https://doi.org/10.1016/j.conbuildmat.2022.129466
Carey, V. P., Chen, G., Grigoropoulos, C., Kaviany, M., & Majumdar, A. (2008). A review of heat transfer
physics.Nanoscale | and | Microscale | Thermophysical | Engineering, 12(1), 1–
60. https://doi.org/10.1080/15567260801917520
Castanié, B., Peignon, A., Marc, C., Eyma, F., Cantarel, A., Serra, J., Curti, R., Hadiji, H., Denaud, L., Girardo n, S., & Marcon, B. (2024). Wood and plywood as eco-materials for sustainable mobility: A review. Composite Structures, 329,Article 117790. https://doi.org/10.1016/j.compstruct.2023.117790 Čekovská, H., Gaff, M., Osvald, A., Kačík, F., Kubš, J., & Kaplan, L. (2016). Fire resistance of thermally modified spruce wood. BioResources, 12(1), 947–959. https://doi.org/10.15376/biores.12.1.947-959
Centrum | Hout. (n.d.-a). Houtdatabase. Houtinfo. Retrieved | April
16, 2026, from https://www.houtinfo.nl/toepassingen/houtdatabase
Centrum Hout. (n.d.-b). Houtinfo | Dennen. Houtinfo. Retrieved April 22, 2026, from https://houtinfo.nl/node/285
Centrum | Hout. (n.d.-c). Houtinfo | | | Douglas/Oregon | pine. Houtinfo. Retrieved | April
16, 2026, from https://houtinfo.nl/node/283
Centrum | Hout. (n.d.-d). Houtinfo | | | Western | red | cedar. Houtinfo. Retrieved | April
17, 2026, from https://houtinfo.nl/node/122
Chau, T., Ma, E., & Cao, J. (2015). Moisture adsorption and hygroexpansion of paraffin wax emulsion-treated
Southern | pine | (Pinus spp.). BioResources, 10(2), 2719–
2731. https://doi.org/10.15376/biores.10.2.2719-2731
Chen, H. (2026). Fungal mycelium processing: Heat pressing and additive manufacturing for enhanced material properties [Doctoral dissertation, Technische Universität Berlin]. DepositOnce. https://depositonce.tu-berlin.de/handle/11303/26264
Chen, J., Wang, Y., Cao, J., & Wang, W. (2020). Improved water repellency and dimensional stability of wood
via | impregnation | with | an | epoxidized | linseed | oil | and | carnauba | wax | complex
emulsion. Forests, 11(3), Article 271.https://doi.org/10.3390/f11030271

Cheng, X., Huang, G., Yan, B., Yang, Q., Wang, C., Li, B., & Liang, S. (2025). Influences and optimizations of vertical facades on the aerodynamic loadings for high-rise buildings. Buildings, 15(7), Article 1093.https://doi.org/10.3390/buildings15071093
Chessa, C., & Susca, T. (2023). Development of an LCA characterization factor to account UHI local effect on terrestrial ecosystems damage category: Evaluation of European Bombus and Onthophagus genera
heat-stress | mortality.Science | of | The | Total | Environment, 897, Article
165183. https://doi.org/10.1016/j.scitotenv.2023.165183
Chiticaru, E. A., & Ionita, M. (2022). Graphene toxicity and future perspectives in healthcare and biomedicine.FlatChem, 35, Article 100417. https://doi.org/10.1016/j.flatc.2022.100417
Chu, D., Hasanagic, R., Fathi, L., & Humar, M. (2023). Water absorption capacity and coating adhesion on thermally modified and not-modified spruce wood (blue stained or free of blue stained). Journal of Renewable Materials, 11(12),4061–4078. https://doi.org/10.32604/jrm.2023.043657
Collins, C. M., & | Safiuddin, M. (2022). Lotus-leaf-inspired | biomimetic | coatings: Different | types, key
properties, and | applications | in | infrastructures. Infrastructures, 7(4), Article
46. https://doi.org/10.3390/infrastructures7040046
Colmer, T. D. (2003). Long-distance transport of gases in plants: A perspective on internal aeration and radial oxygen loss from roots. Plant, Cell & Environment, 26(1), 17–36. https://doi.org/10.1046/j.1365-3040.2003.00846.x
Cordier, S., Blanchet, P., Robichaud, F., & Amor, B. (2022). Dynamic LCA of the increased use of wood in buildings and its consequences: Integration of CO2 sequestration and material substitutions. Building and Environment, 226,Article 109695. https://doi.org/10.1016/j.buildenv.2022.109695
Cristini, V., Tomšovský, M., Baar, J., Brabec, M., Rousek, R., Paschová, Z., Trifković, M., Weiss, J., & Čermák, P.(2025). A comparative study of mycelium films from nine fungal species for biocomposite applications. BioResources,20(4), 10209–10227. https://doi.org/10.15376/biores.20.4.10209-10227 Cryo X. (2024). Safety data sheet P-1340. https://www.cryox.co
Davis, K., Leavengood, S., & Morrell, J. J. (2021). Performance of exterior wood coatings in temperate climates.Coatings, 11(3), Article 325. https://doi.org/10.3390/coatings11030325
De Boer, K., Borst, M., Goedhart, R., Groeneveld, T., & Verweij, B. (2025). Adviesrapport multifunctionele gevelelementen. Hogeschool Utrecht.
De | Jonge, W. (2024). Gevelbekleding—Algemeen. Rijksdienst | voor | het | Cultureel
Erfgoed.https://kennis.cultureelerfgoed.nl/index.php/Gevelbekleding_-_algemeen
Designing | Buildings. (2022). Convection | in
buildings.https://www.designingbuildings.co.uk/wiki/Convection_in_buildings
Didari, A., & Mengüç, M. P. (2018). A biomimicry design for nanoscale radiative cooling applications inspired by Morpho didius butterfly. Scientific Reports, 8(1), Article 16891. https://doi.org/10.1038/s41598-018-35082-3
Dincer, I., & Siddiqui, O. (2018). 1.10 Heat transfer aspects of energy. In Comprehensive energy systems (pp. 422–477).Elsevier. https://doi.org/10.1016/B978-0-12-809597-3.00109-7
Dong, Y., Han, H., Wang, F., Zhang, Y., Cheng, Z., Shi, X., & | Yan, Y. (2022). A | low-cost | sustainable
coating:Improving passive daytime radiative cooling performance using the spectral band
complementarity | method. Renewable | Energy, 192, 606–
616. https://doi.org/10.1016/j.renene.2022.04.093
Dong, Y., Wang, K., Li, J., Zhang, S., & Shi, S. Q. (2020). Environmentally benign wood modifications: A
review. ACS | Sustainable | Chemistry | & | Engineering, 8(9), 3532–
3540. https://doi.org/10.1021/acssuschemeng.0c00342
Dougoud, M. (2018). Mycelium infrastructures for impermanent futures [Master's thesis, University of Washington].ResearchWorks Archive. http://hdl.handle.net/1773/41701
Dunningham, E. A., Plackett, D. V., & Singh, A. P. (1992). Weathering of chemically modified wood. Holz als Roh- und Werkstoff, 50(11), 429–432. https://doi.org/10.1007/BF02662780
ECHEMI. (2023). Understanding | the | solubility | of | barium | sulfate | in
water. https://www.echemi.com/cms/1417368.html

Effing, M. (2018). Expert insights in Europe’s booming composites market. Reinforced Plastics, 62(4), 219– 223.https://doi.org/10.1016/j.repl.2017.06.086
Elsacker, E., Vandelook, S., Brancart, J., Peeters, E., & Laet, L. D. (2019). Mechanical, physical and chemical characterisation of mycelium-based composites with different types of lignocellulosic substrates. PLOS ONE, 14(7),Article e0213954. https://doi.org/10.1371/journal.pone.0213954
EOTA. (2012). Guideline for European technical approval of kits for external wall claddings (ETAG 034, Part
1).European | Organisation | for | Technical
Assessment. https://www.eota.eu/sites/default/files/uploads/ETAGs/etag-034-1-ec-version-april-2012.pdf
Esteves, B., & Pereira, H. (2008). Wood modification by heat treatment: A review. BioResources, 4(1), 370– 404.https://doi.org/10.15376/biores.4.1.370-404
Faheem, M., & Khan, K. A. (2025). Harnessing sustainable biocomposites: A review of advances in greener
materials | and | manufacturing | strategies. Polymer | Bulletin, 82(14), 8827–
8870. https://doi.org/10.1007/s00289-025-05916-y
Falchetta, G., Cian, E. D., Pavanello, F., & Wing, I. S. (2024). Inequalities in global residential cooling energy use to 2050. Nature Communications, 15(1), Article 7874. https://doi.org/10.1038/s41467-024-52028-8 Fan, T.-T., Xue, C.-H., Guo, X.-J., Wang, H.-D., Huang, M.-C., Zhang, D.-M., & Deng, F.-Q. (2022). Ecofriendly preparation of durable superhydrophobic porous film for daytime radiative cooling. Journal of Materials Science,57(22), 10425–10443. https://doi.org/10.1007/s10853-022-07292-8
Farrahnoor, A., Sazali, N. A. A., Yusoff, H., & Zhou, B. T. (2024). Effect of beeswax and coconut oil as natural coating agents on morphological, degradation behaviour, and water barrier properties of mycelium-based composite in modified controlled environment. Progress in Organic Coatings, 196, Article 108763.https://doi.org/10.1016/j.porgcoat.2024.108763
Fartash Naeimi, E., Selvi, K. Ç., & Ungureanu, N. (2025). Exploring the role of advanced composites and biocomposites in agricultural machinery and equipment: Insights into design, performance, and sustainability.Polymers, 17(12), Article 1691. https://doi.org/10.3390/polym17121691
Fassadengrün. (2026). Cost | comparison | of | different | types | of | green
facades. https://www.fassadengruen.de/en/cost-comparison.html
Ferreira, C., Barrelas, J., Silva, A., de Brito, J., Dias, I. S., & Flores-Colen, I. (2021). Impact of environmental exposure conditions on the maintenance of facades’ claddings. Buildings, 11(4), Article 138.https://doi.org/10.3390/buildings11040138
Ferreira, C., Dias, I. S., Silva, A., de Brito, J., & Flores-Colen, I. (2021). Criteria for selection of cladding
systems | based | on | their | maintainability. Journal | of | Building | Engineering, 39, Article
102260.https://doi.org/10.1016/j.jobe.2021.102260
Fire | Protection | Association. (2023). What | is | fire | compartmentation? Fire | Protection
Association.https://www.thefpa.co.uk/advice-and-guidance/advice-and-guidance-articles/what-is-fire-compartmentation-Flamro. (2024). Fire protection for facades. https://flamro.com/no/en/fire-protection-for-facades/
Frihart, C. R., Brandon, R., Beecher, J. F., & Ibach, R. E. (2017). Adhesives for achieving durable bonds with acetylated wood. Polymers, 9(12), Article 731. https://doi.org/10.3390/polym9120731
Gagliano, A., & Aneli, S. (2020). Analysis of the energy performance of an opaque ventilated façade under
winter | and | summer | weather | conditions. Solar | Energy, 205, 531–
544. https://doi.org/10.1016/j.solener.2020.05.078
Geotti-Bianchini, F., & | Lohrengel, J. (1993). Thermal | conductivity | of | float | glass | at | room
temperature. Glastechnische Berichte, 66(6), 25–29. https://doi.org/10.34657/14011
George, K., Rodríguez-Grau, G., Manikandan, V. S., Molina, P., Sancy, M., &
Thirumurugan, A. (2026). Engineering functional mycelium-based composites: Innovations in thermal
and | acoustic | insulation. Composites | Part | B: | Engineering, 315, Article
113470. https://doi.org/10.1016/j.compositesb.2026.113470
Gérard, J., Guibal, D., Paradis, S., Vernay, M., Beauchêne, J., Brancheriau, L., Châlon, I., Daigremont, C., Dé tienne, P.,Fouquet, D., Langbour, P., Lotte, S., Thévenon, M.-F., Méjean, C., &

Thibaut, A. (2011). Tropix | 7 (Version | 7.5.1) | [Computer
software]. CIRAD. https://doi.org/10.18167/74726f706978
Ghazvinian, A., & Gursoy, B. (2022). Basics of building with mycelium-based bio-composites. Journal of Green Building, 17(1), 37–69. https://doi.org/10.3992/jgb.17.1.37
Ghosh, S. (2023). Engineering biocomposites [Doctoral dissertation, Delft University of Technology]. TU Delft Repository. https://repository.tudelft.nl/record/uuid:d9aed074-85ab-4aba-b350-afd938fbb4c4
Girma, G. M., & Tariku, F. (2021). Experimental investigation of cavity air gap depth for enhanced thermal
performance | of | ventilated | rain-screen | walls. Building | and | Environment, 194, Article
107710.https://doi.org/10.1016/j.buildenv.2021.107710
González-García, S., Krowas, I., Becker, G., Feijoo, G., & Moreira, M. T. (2013). Cradle-to-gate life cycle inventory and environmental performance of Douglas-fir roundwood production in Germany. Journal of Cleaner Production, 54,244–252. https://doi.org/10.1016/j.jclepro.2013.05.012
González-García, S., Moreira, M. T., Dias, A. C., & | Mola-Yudego, B. (2014). Cradle-to-gate | life | cycle
assessment of forest operations in Europe: Environmental and energy profiles. Journal of Cleaner Production, 66, 188–198.https://doi.org/10.1016/j.jclepro.2013.11.067
Gordon, K. (2020). 5 | principles | of | visual | design | in | UX. Nielsen | Norman
Group.https://www.nngroup.com/articles/principles-visual-design/
Grand View Research. (2026, June). Cladding market size, share & growth report, 2026– 2033.https://www.grandviewresearch.com/industry-analysis/cladding-market
Guo, N., Zhao, Z., Yan, H., & | Chen, M. (2023). Dynamic | thermal | radiation | regulation | for thermal
management. Next Energy, 1(4), Article 100072. https://doi.org/10.1016/j.nxener.2023.100072
Gustavsen, G. W., Van | Niekerk, P. B., Niklewski, J., Brischke, C., & | Alfredsen, G. (2026). Maintenance
perceptions of coated timber cladding in Norway, Sweden and Germany. Wood Material Science & Engineering, 1–11.https://doi.org/10.1080/17480272.2026.2701370
Han, Y., Taylor, J. E., & Pisello, A. L. (2015). Toward mitigating urban heat island effects: Investigating the thermal-energy impact of bio-inspired retro-reflective building envelopes in dense urban settings. Energy and Buildings, 102,380–389. https://doi.org/10.1016/j.enbuild.2015.05.040 Harbiankova, A., & Manso, M. (2025). Integrating green roofs and green walls to enhance buildings thermal
performance: A | literature | review. Building | and | Environment, 270, Article
112524.https://doi.org/10.1016/j.buildenv.2025.112524
Henrion, W., & Tributsch, H. (2009). Optical solar energy adaptations and radiative temperature control of green
leaves | and | tree | barks. Solar | Energy | Materials | and | Solar | Cells, 93(1), 98–
107. https://doi.org/10.1016/j.solmat.2008.08.009
Hernández-Pérez, I., Álvarez, G., Xamán, J., Zavala-Guillén, I., Arce, J., & | Simá, E. (2014). Thermal
performance of reflective materials applied to exterior building components—A review. Energy and Buildings, 80, 81–105.https://doi.org/10.1016/j.enbuild.2014.05.008
Hill, C., Hughes, M., & Gudsell, D. (2021). Environmental impact of wood modification. Coatings, 11(3), Article 366.https://doi.org/10.3390/coatings11030366
Hill, C., Kymäläinen, M., & Rautkari, L. (2022). Review of the use of solid wood as an external cladding material
in | the | built | environment. Journal | of | Materials | Science, 57(20), 9031–
9076. https://doi.org/10.1007/s10853-022-07211-x
Holbrook, N. M., & Zwieniecki, M. A. (2008). Transporting water to the tops of trees. Physics Today, 61(1), 76– 77.https://doi.org/10.1063/1.2835167
Hong, C., Wang, Y., Gu, Z., & Yu, C. W. (2022). Cool facades to mitigate urban heat island effects. Indoor and Built Environment, 31(10), 2373–2377. https://doi.org/10.1177/1420326X221115369
Hopperstad, O. S., Langseth, M., & Tryland, T. (1999). Ultimate strength of aluminium alloy outstands in
compression:Experiments | and | simplified | analysis. Thin-Walled | Structures, 34(4), 279–
294. https://doi.org/10.1016/S0263-8231(99)00013-0
Hossain, Md. M., & | Gu, M. (2016). Radiative | cooling: Principles, progress, and | potentials. Advanced
Science, 3(7),Article 1500360. https://doi.org/10.1002/advs.201500360
Houthandel | Jan | Sok. (n.d.). 18x145mm | Douglas | dakbeschot | (3,00mtr). Retrieved | October
15, 2026, from https://houthandeljansok.nl/producten/18x145mm-douglas-dakbeschot-300mtr

Houthandel Online. (n.d.). Multiplex Okoumé B/BB 6mm WBP Komo geschuurd. Retrieved October 15, 2026, from https://www.houthandelonline.nl/okoume-multiplex-wbp-bbb-6
Hrázský, J., & Král, P. (2014). Analysis of causes of warping the plywood sheets. Acta Universitatis Agriculturae et Silviculturae Mendelianae Brunensis, 59(3), 59–72. https://doi.org/10.11118/actaun201159030059 Huanbutta, K., Chuttong, B., Danmek, K., Sriamornsak, P., Suwanpitak, K., & Sangnim, T. (2026). Beeswax in pharmaceutical sciences: A comprehensive review of its chemical composition, functional applications, types, and formulation roles. International Journal of Molecular Sciences, 27(8), Article 3486.https://doi.org/10.3390/ijms27083486
Humar, M., Vek, V., Oven, P., Lesar, B., Kržišnik, D., Keržič, E., Hočevar, M., & Brus, R. (2022). Durability and moisture dynamics of Douglas-fir wood from Slovenia. Frontiers in Plant Science, 13, Article 860734.https://doi.org/10.3389/fpls.2022.860734
İlerisoy, Z. Y., & Çolak, B. (2018). Discovery of innovative materials in structural system design: Glass structures. In Proceedings of the 4th International Conference on Architecture and Civil Engineering (pp. 1225–1237).
Impershield. (n.d.). Bioseal | mycelium. Retrieved | October
15, 2026, from https://impershield.eu/product/bioseal-mycelium/
Intergovernmental Panel on Climate Change. (2014). Buildings. In Climate change 2014: Mitigation of climate change. Contribution of Working Group III to the Fifth Assessment Report of the Intergovernmental Panel on Climate Change(pp. 671–738). Cambridge University Press.
Ivanović-Šekularac, J., Čikić-Tovarović, J., & Šekularac, N. (2016). Application of wood as an element of façade cladding in construction and reconstruction of architectural objects to improve their energy efficiency. Energy and Buildings, 115, 85–93. https://doi.org/10.1016/j.enbuild.2015.03.047
Jabbar, H. K., Hamoodi, M. N., & Al-Hameedawi, A. N. (2023). Urban heat islands: A review of contributing factors,effects and data. IOP Conference Series: Earth and Environmental Science, 1129(1), Article 012038.https://doi.org/10.1088/1755-1315/1129/1/012038
Jančíková, V., & | Jablonský, M. (2025). Thermal | modification | of | wood—A | review. Sustainable
Chemistry, 6(3), Article 19. https://doi.org/10.3390/suschem6030019
Jandaghian, Z., Arasteh, H., Heidari, D., Ghobadi, M., Lacasse, M., & Gover, B. (2025). Cool wall claddings for a sustainable future: A comprehensive review on mitigating urban heat island effects and reducing
carbon | emissions | in | the | built | environment. Energy | and | Buildings, 336, Article
115600. https://doi.org/10.1016/j.enbuild.2025.115600
Jebrane, M., Franke, T., Terziev, N., & Panov, D. (2017). Natural weathering of Scots pine (Pinus sylvestris L.) wood treated with epoxidized linseed oil and methyltriethoxysilane. Wood Material Science & Engineering, 12(4), 220–227.https://doi.org/10.1080/17480272.2016.1160954
Jebrane, M., Pockrandt, M., Cuccui, I., Allegretti, O., Uetimane Jr., E., & Terziev, N. (2018). Comparative study of two softwood species industrially modified by ThermoWood® and thermo-vacuum process. BioResources, 13(1), 715–728.https://doi.org/10.15376/biores.13.1.715-728
Ji, Y., Cook, M., Hanby, V. I., Infield, D., Loveday, D., & Mei, L. (2007). CFD modelling of double-skin facades with venetian blinds. Building Simulation. https://strathprints.strath.ac.uk/12352/1/p753_final.pdf
Jirouš-Rajković, V., & | Miklečić, J. (2021). Enhancing | weathering | resistance | of | wood—A
review. Polymers, 13(12),Article 1980. https://doi.org/10.3390/polym13121980
Jones, D., Sandberg, D., Goli, G., & Todaro, L. (2020). Wood modification in Europe: A state-of-the-art about processes, products and applications. Florence University Press.
Jones, M., Bhat, T., Huynh, T., Kandare, E., Yuen, R., Wang, C. H., & John, S. (2018). Waste-derived low-cost mycelium composite construction materials with improved fire safety. Fire and Materials, 42(7), 816– 825.https://doi.org/10.1002/fam.2637
Jones, M., Bhat, T., Kandare, E., Thomas, A., Joseph, P., Dekiwadia, C., Yuen, R., John, S., Ma, J., &
Wang, C.-H.(2018). Thermal degradation and fire properties of fungal mycelium and mycelium— biomass composite materials.Scientific Reports, 8(1), Article 17583. https://doi.org/10.1038/s41598-018-36032-9

Joshi, K., Meher, M. K., & Poluri, K. M. (2020). Fabrication and characterization of bioblocks from agricultural waste using fungal mycelium for renewable and sustainable applications. ACS Applied Bio Materials, 3(4), 1884–1892.https://doi.org/10.1021/acsabm.9b01047
Juanicó, L. E., & González, A. D. (2017). Thermal insulators with multiple air gaps: Performance, cost and
embodied | impacts. Journal | of | Building | Engineering, 12, 188–
195. https://doi.org/10.1016/j.jobe.2017.06.005
Kapilan, N., Isloor, A. M., & | Karinka, S. (2023). A | comprehensive | review | on | evaporative | cooling
systems. Results in Engineering, 18, Article 101059. https://doi.org/10.1016/j.rineng.2023.101059 Kariuki, S. W., Wachira, J., Kawira, M., & Murithi, G. (2019). Formaldehyde use and alternative biobased
binders | for | particleboard | formulation: A | review. Journal | of | Chemistry, 2019, Article
5256897.https://doi.org/10.1155/2019/5256897
Karthäuser, J., Raskop, S., Slabohm, M., & | Militz, H. (2024). Modification | of plywood | with | phenol–
formaldehyde resin: Substitution of phenol by pyrolysis cleavage products of softwood kraft lignin. European Journal of Wood and Wood Products, 82(1), 1–11. https://doi.org/10.1007/s00107-023-02029-z
Kaukanen, K. (2026, February 27). EN 13501-1 standard for fire classification of construction materials: Overview of performance classes & criteria. Measurlabs. https://measurlabs.com/blog/en-13501-1-fire-classification-performance-classes-and-criteria/
Kellert, S. R., Heerwagen, J. H., & Mador, M. L. (2008). Biophilic design: The theory, science and practice of bringing buildings to life. John Wiley & Sons.
Kiehl, J. T., & Trenberth, K. E. (1997). Earth’s annual global mean energy budget. Bulletin of the American
Meteorological | Society, 78(2), 197–208. https://doi.org/10.1175/1520-
0477(1997)078<0197:EAGMEB>2.0.CO;2
Kijo-Kleczkowska, A., & Gnatowski, A. (2022). Recycling of plastic waste, with particular emphasis on thermal methods—Review. Energies, 15(6), Article 2114. https://doi.org/10.3390/en15062114
King, H., Ocko, S. A., & Mahadevan, L. (2015). Termite mounds harness diurnal temperature oscillations for
ventilation. Proceedings | of | the | National | Academy | of | Sciences, 112(37), 11589–
11593.https://doi.org/10.1073/pnas.1423242112
Klaassen, R., Tjeerdsma, B., & Hillebrink, R. (2018). Monitoring the performance of Accoya in different applications.SHR.
Kocaman, H. (2025). Stack | effect: | The | invisible | force | of | air | flow | in | buildings. Alkazar
Technology.https://alkazar.com.tr/blog/stack-effect-cfd/
Korb, J. (2003). Thermoregulation and ventilation of termite mounds. Naturwissenschaften, 90(5), 212– 219.https://doi.org/10.1007/s00114-002-0401-4
Korb, J., & Linsenmair, K. E. (2000). Ventilation of termite mounds: New results require a new model. Behavioral Ecology, 11(5), 486–494. https://doi.org/10.1093/beheco/11.5.486
Kurian, J., & Karthi, L. (2022). Building integrated photovoltaics—An overview. Sustainability, Agri, Food and Environmental Research, 10(1). https://doi.org/10.7770/safer-V10N1-art2495
Kutnik, M., Lepetit, S., & Nevé, S. (2011, May 9). Performance of Douglas fir in real outdoor use conditions(Document No. IRG/WP 11-10756). The International Research Group on Wood Protection.
Lalrinfela, P., Vanlalsangi, R., Lalrinzuali, K., & | Babu, P. J. (2024). Microplastics: Their effects | on | the
environment,human health, and plant ecosystems. Environmental Pollution and Management, 1, 248– 259.https://doi.org/10.1016/j.epm.2024.11.004
Laver, J., Clifford, D., & Vollen, J. (2008). High performance masonry wall systems: Principles derived from
natural | analogues. WIT | Transactions | on | Ecology | and | the | Environment, 114, 243–
252. https://doi.org/10.2495/DN080251
Lee, J., Jung, Y., Lee, M., Sik | Hwang, J., Guo, J., Shin, W., Min, J., Rok
Pyun, K., Lee, H., Lee, Y., Shiomi, J., Kim, Y.-J., Kim, B.-W., & | Hwan | Ko, S. (2022). Biomimetic
reconstruction of butterfly wing scale nanostructures for radiative cooling and structural coloration. Nanoscale Horizons, 7(9), 1054–1064. https://doi.org/10.1039/D2NH00166G
Levinson, R., Berdahl, P., Akbari, H., Miller, W., Joedicke, I., Reilly, J., Suzuki, Y., &
Vondran, M. (2007). Methods of creating solar-reflective nonwhite surfaces and their application to

residential | roofing | materials. Solar | Energy | Materials | and | Solar | Cells, 91(4), 304–
314. https://doi.org/10.1016/j.solmat.2006.06.062
Lewandowska, A., Sydor, M., & Bonenberg, A. (2025). A review of mycelium-based composites in architectural and design applications. Sustainability, 17(24), Article 11350. https://doi.org/10.3390/su172411350 Lewis, D. A., & Nobel, P. S. (1977). Thermal energy exchange model and water loss of a barrel cactus, Ferocactus acanthodes. Plant Physiology, 60(4), 609–616. https://doi.org/10.1104/pp.60.4.609 Li, H., Xian, G., Lin, Q., & Zhang, H. (2012). Freeze–thaw resistance of unidirectional-fiber-reinforced epoxy
composites. Journal | of | Applied | Polymer | Science, 123(6), 3781–
3788. https://doi.org/10.1002/app.34870
Li, L., Ye, Z., Zou, Z., Zhou, X., & Wang, J. (2025). Passive evaporative cooling performance of building walls under typical wind-driven rain of hot-humid climates. Energy and Buildings, 345, Article 116048.https://doi.org/10.1016/j.enbuild.2025.116048
Li, W., Van | Den | Bulcke, J., De | Windt, I., Dhaene, J., Mannes, D., Lehmann, E., & | Van
Acker, J. (2016). Investigating plywood behaviour in outdoor conditions. International Wood Products Journal, 7(4), 220–224.https://doi.org/10.1080/20426445.2016.1261235
Li, W., Van den Bulcke, J., De Windt, I., Dhaene, J., & Van Acker, J. (2016). Moisture behavior and structural changes of plywood during outdoor exposure. European Journal of Wood and Wood Products, 74(2), 211–221.https://doi.org/10.1007/s00107-015-0992-z
Li, X., Yue, K., Zhu, L., Lv, C., Wu, J., Wu, P., Li, Q., Xu, C., & Sun, K. (2024). Relationships between wood properties and fire performance of glulam columns made from six wood species commonly used in
China. Case | Studies | in | Thermal | Engineering, 54, Article
104029. https://doi.org/10.1016/j.csite.2024.104029
Li, Y., Lin, C., Huang, J., Chi, C., & Huang, B. (2020). Spectrally selective absorbers/emitters for solar steam
generation | and | radiative | cooling-enabled | atmospheric | water | harvesting. Global
Challenges, 5(1), Article 2000058.https://doi.org/10.1002/gch2.202000058
Liang, X., Gu, X., Myint | Paing | Hsu, M., He, Y., Zhang, R., Cai, C., & | Wang, Z. (2023). Design | and
development of composite plywood that integrates fire resistance, water resistance and wear
resistance. Journal | of | Renewable | Materials, 11(5), 2333–
2344. https://doi.org/10.32604/jrm.2023.026137
Ling, X., Osotsi, M. I., Zhang, W., Wu, Y., Jin, Q., & Zhang, D. (2023). Bioinspired materials: From distinct dimensional architecture to thermal regulation properties. Journal of Bionic Engineering, 20(3), 873– 899.https://doi.org/10.1007/s42235-022-00314-w
Lingam, D., Narayan, S., Mamun, K., & | Charan, D. (2023). Engineered | mycelium-based | composite
materials:Comprehensive study of various properties and applications. Construction and Building Materials, 391, Article 131841.https://doi.org/10.1016/j.conbuildmat.2023.131841
Liu, J., Wang, S., Peng, Y., Zhu, J., Zhao, W., & Liu, X. (2021). Advances in sustainable thermosetting resins: From renewable feedstock to high performance and recyclability. Progress in Polymer Science, 113, Article 101353.https://doi.org/10.1016/j.progpolymsci.2020.101353
Liu, J., Zhang, Y., Li, S., Valenzuela, C., Shi, S., Jiang, C., Wu, S., Ye, L., Wang, L., &
Zhou, Z. (2023). Emerging materials and engineering strategies for performance advance of radiative
sky | cooling | technology. Chemical | Engineering | Journal, 453, Article
139739. https://doi.org/10.1016/j.cej.2022.139739
Liu, R., Long, L., Sheng, Y., Xu, J., Qiu, H., Li, X., Wang, Y., & Wu, H. (2019). Preparation of a kind of novel sustainable mycelium/cotton stalk composites and effects of pressing temperature on the
properties. Industrial | Crops | and | Products, 141, Article
111732. https://doi.org/10.1016/j.indcrop.2019.111732
Livne, A., Pearlmutter, D., Gal, E., & Wösten, H. A. B. (2024). Increased CO2 fixation and reduced embodied energy of mycelium bio-composite materials grown on a mixed substrate over diurnal temperature
cycles. Construction | and | Building | Materials, 421, Article
135566. https://doi.org/10.1016/j.conbuildmat.2024.135566

Livne, A., Wösten, H. A. B., Pearlmutter, D., & Gal, E. (2022). Fungal mycelium bio-composite acts as a CO2-
sink | building | material | with | low | embodied | energy. ACS | Sustainable | Chemistry &
Engineering, 10(37), 12099–12106.https://doi.org/10.1021/acssuschemeng.2c01314
Lizana, J., Miranda, N. D., Sparrow, S. N., Wallom, D. C. H., Khosla, R., & McCulloch, M. (2026). Global gridded dataset of heating and cooling degree days under climate change scenarios. Nature Sustainability, 9(3), 470–480.https://doi.org/10.1038/s41893-025-01754-y
Lovrić, A., Zdravkovic, V., Popadić, R., & Milić, G. (2017). Properties of plywood boards composed of thermally
modified | and | non-modified | poplar | veneer. BioResources, 12(4), 8581–
8594. https://doi.org/10.15376/biores.12.4.8581-8594
Madureira, S., Flores-Colen, I., de Brito, J., & Pereira, C. (2017). Maintenance planning of facades in current
buildings.Construction | and | Building | Materials, 147, 790–
802. https://doi.org/10.1016/j.conbuildmat.2017.04.195
Malinarič, S. (2025). Measurement of the thermal conductivity and diffusivity of steel and glass using transient methods. International Journal of Thermophysics, 46(6), Article 86. https://doi.org/10.1007/s10765-025-03564-y
Mandal, J., Yang, Y., Yu, N., & Raman, A. P. (2020). Paints as a scalable and effective radiative cooling technology for buildings. Joule, 4(7), 1350–1356. https://doi.org/10.1016/j.joule.2020.04.010
Manu, T., Nazmi, A. R., Shahri, B., Emerson, N., & Huber, T. (2022). Biocomposites: A review of materials and
perception. Materials | Today | Communications, 31, Article
103308. https://doi.org/10.1016/j.mtcomm.2022.103308
Mark, M. (n.d.). Barrel | cactus [Photograph]. Encyclopædia | Britannica. Retrieved | April
2, 2026, from https://www.britannica.com/plant/barrel-cactus
Martins, A. F., Bennett, N. C., Clavel, S., Groenewald, H., Hensman, S., Hoby, S., Joris, A., Manger, P. R., & Milinkovitch, M. C. (2018). Locally-curved geometry generates bending cracks in the African elephant skin. Nature Communications, 9(1), Article 3865. https://doi.org/10.1038/s41467-018-06257-3
Mason, J. A., Smith, S., & Wasserman, D. (2011). Strong absorption and selective thermal emission from a
midinfrared | metamaterial. Applied | Physics | Letters, 98(24), Article
241105. https://doi.org/10.1063/1.3600779
Masson, V., Lemonsu, A., Hidalgo, J., & Voogt, J. (2020). Urban climates and climate change. Annual Review of Environment and Resources, 45, 411–444. https://doi.org/10.1146/annurev-environ-012320-083623 Mauri, A., de Rigo, D., & Caudullo, G. (2016). Abies alba in Europe: Distribution, habitat, usage and threats. In European atlas of forest tree species (pp. 50–52). Publication Office of the European Union. Mbang, J.-J. A. (2013). Gabon corridors performance evaluation: New strategic approach based-supply chain and transport logistics efficiency [Doctoral dissertation, Shanghai Maritime University].
Menon, R. R., Luo, J., Chen, X., Zhou, H., Liu, Z., Zhou, G., Zhang, N., & Jin, C. (2019). Screening of fungi for
potential | application | of | self-healing | concrete. Scientific | Reports, 9(1), Article
2075. https://doi.org/10.1038/s41598-019-39156-8
Mick | Pearce | Architects. (n.d.). Eastgate | Building | Harare. Retrieved | April
8, 2026, from https://www.mickpearce.com/Eastgate.html
Ministerie van Binnenlandse Zaken en Koninkrijksrelaties. (2026, March 27). Besluit bouwwerken leefomgeving.Wettenbank Overheid.nl. https://wetten.overheid.nl/BWBR0041297/2026-03-27 Mishra, B. R., Sundaram, S., & Sasihithlu, K. (2024). Cooling performance of TiO2-based radiative cooling
coating | in | tropical | conditions. ACS | Omega, 9(50), 49494–
49502. https://doi.org/10.1021/acsomega.4c07223
Moran, M. J., Shapiro, H. N., Boettner, D. D., & | Bailey, M. B. (2010). Fundamentals | of | engineering
thermodynamics(7th ed.). John Wiley & Sons.
Motamedi, S., Rousse, D. R., & Promis, G. (2025). A review of mycelium bio-composites as energy-efficient sustainable building materials. Energies, 18(16), Article 4225. https://doi.org/10.3390/en18164225 Mubarok, M., Hadi, Y. S., Hermawan, D., Arrasuli, M. H., Ramadhan, V. A., Lubis, M. A. R., Abdillah, I. B., Ilmi awati,A., Darmawan, W., Gérardin, P., & Militz, H. (2025). Adhesion performance of furfurylated plywood bonded with polyurethane and epoxy adhesives. Journal of Adhesion Science and Technology, 39(7), 971–992.https://doi.org/10.1080/01694243.2024.2433692

Mundekkad, D., & Mallya, A. R. (2025). Biomimicry at the nanoscale—A review of nanomaterials inspired by nature.Nano Trends, 10, Article 100119. https://doi.org/10.1016/j.nwnano.2025.100119
Naderi | Kalali, E., Lotfian, S., Entezar | Shabestari, M., Khayatzadeh, S., Zhao, C., & | Yazdani
Nezhad, H. (2023). A critical review of the current progress of plastic waste recycling technology in
structural | materials. Current Opinion | in | Green | and Sustainable | Chemistry, 40, Article
100763. https://doi.org/10.1016/j.cogsc.2023.100763
Nazmul, R. T., Sainsbury, B.-A., Garcez, E. O., Al-Deen, S., & Ashraf, M. (2023). Characterisation of the effects of hemp shives for internal curing of concrete. Construction and Building Materials, 409, Article 133916.https://doi.org/10.1016/j.conbuildmat.2023.133916
Nederlands Normalisatie-instituut. (2016). Duurzaamheid van hout en houtachtige producten - Beproeving en classificatie van de duurzaamheid tegen biologische aantasting van hout en houtachtige materialen (NEN-EN 350:2016 en). https://www.nen.nl/nen-en-350-2016-en-224409
Negro, F., Cremonini, C., Zanuttini, R., Properzi, M., & Pichelin, F. (2011). A new wood-based lightweight composite for boatbuilding. Wood Research, 56(2), 257–266.
Netherlands | Enterprise | Agency | (RVO). (2024, November | 20). Design | right—Intellectual
property. Business.gov.nl.https://business.gov.nl/regulations/design-right/
Netherlands | Enterprise | Agency | (RVO). (2025). Registering | a
trademark. Business.gov.nl.https://business.gov.nl/regulations/register-trademark/
Netherlands | Patent
Office. (2019). Copyright. Business.gov.nl. https://business.gov.nl/regulations/copyright/#art:when-does-copyright-apply
Nguyen, Q., Ngo, T., Mendis, P., & Tran, P. (2013). Composite materials for next generation building façade systems.Civil Engineering and Architecture, 1(3), 88–95. https://doi.org/10.13189/cea.2013.010305 Nguyen, T.-D., Sierra, E., Eguiraun, H., & Lizundia, E. (2018). Iridescent cellulose nanocrystal films: The link between structural colour and Bragg’s law. European Journal of Physics, 39(4), Article 045803. https://doi.org/10.1088/1361-6404/aab598
Nobel, P. S. (1978). Surface temperatures of cacti—Influences of environmental and morphological factors. Ecology,59(5), 986–996. https://doi.org/10.2307/1938550
NPSP. (2025a). Classification of reaction to fire performance in accordance with EN 13501-1:2018.
NPSP. (2025b, March | 26). Bio-composietafval | heroverwegen. https://www.npsp.nl/nl/news-item/Bio-
composietafval-heroverwegen
Nuclear Power. (2026). Newton’s law of cooling. https://www.nuclear-power.com/nuclear-engineering/heat-transfer/convection-convective-heat-transfer/newtons-law-of-cooling/
Oldenburger, J. (2009). Het | juiste | hout | op | de | juiste
plaats. Probos.https://www.probos.nl/images/pdf/rapporten/Rap2009_Het_juiste_hout_op_de_juiste_p laats.pdf
Op | Maat | Zagen. (n.d.). Plywood | marine | B/BB. Retrieved | October
15, 2026, from https://www.opmaatzagen.nl/en-nl/plywood-marine-b-bb?thickness=131
Ortega Exposito, F., van der Burgh, F., & Böttger, W. (2023). Biobased façade materials in Europe. In
S. Amziane, I.Merta, & J. Page (Eds.), Bio-based building materials (pp. 123–143). Springer Nature Switzerland.https://doi.org/10.1007/978-3-031-33465-8_11
Park, J., Lee, K. H., Lee, S. H., & Hong, T. (2024). Benefits assessment of cool skin and ventilated cavity skin: Saving energy and mitigating heat and grid stress. Building and Environment, 247, Article 111027.https://doi.org/10.1016/j.buildenv.2023.111027
Pawelzik, P., Carus, M., Hotchkiss, J., Narayan, R., Selke, S., Wellisch, M., Weiss, M., Wicke, B., &
Patel, M. K.(2013). Critical aspects in the life cycle assessment (LCA) of bio-based materials— Reviewing methodologies and deriving recommendations. Resources, Conservation and Recycling, 73, 211–228.https://doi.org/10.1016/j.resconrec.2013.02.006
PEFC. (n.d.). Reference density values of wood species and wood-based panels. Retrieved April 15, 2026, from https://cdn.pefc.org/furniture.pefc.org/media/2023-10/784c9eb4-2f65-4465-be6e-131b0c1d5dea/84952881-7f2f-5308-8a03-99f31860c423.pdf

Peintner, U., Pöder, R., & Pümpel, T. (1998). The iceman’s fungi. Mycological Research, 102(10), 1153– 1162.https://doi.org/10.1017/S0953756298006546
Pelaz, B., Blanco, J. M., Cuadrado, J., Egiluz, Z., & Buruaga, A. (2017). Analysis of the influence of wood cladding on the thermal behavior of building façades; characterization through simulation by using
different | tools | and | comparative | testing | validation. Energy | and | Buildings, 141, 349–
360. https://doi.org/10.1016/j.enbuild.2017.02.054
Pernice, A., Pearson, M., de Rooij, T., & Szabo-Hemmings, T. (2022). A regenerative solution for the urban heat island effect. Utrecht University.
Petcu, C., Hegyi, A., Stoian, V., Dragomir, C. S., Ciobanu, A. A., Lăzărescu, A.-V., &
Florean, C. (2023). Research on thermal insulation performance and impact on indoor air quality of
cellulose-based | thermal | insulation | materials.Materials, 16(15), Article
5458. https://doi.org/10.3390/ma16155458
Picallo-Perez, A., & Sala-Lizarraga, J. M. (2023). Energy and exergy analysis of an experimental ventilated façade.Energy and Buildings, 280, Article 112737. https://doi.org/10.1016/j.enbuild.2022.112737 Pirvaram, A., Talebzadeh, N., Leung, S. N., & O’Brien, P. G. (2022). Radiative cooling for buildings: A review of techno-enviro-economics and life-cycle assessment methods. Renewable and Sustainable Energy Reviews, 162, Article 112415. https://doi.org/10.1016/j.rser.2022.112415
Pohl, C., Schmidt, B., Nunez | Guitar, T., Klemm, S., Gusovius, H.-J., Platzk, S., Kruggel-
Emden, H., Klunker, A.,Völlmecke, C., Fleck, C., & | Meyer, V. (2022). Establishment | of | the
basidiomycete Fomes fomentarius for the production of composite materials. Fungal Biology and Biotechnology, 9(1), Article 4. https://doi.org/10.1186/s40694-022-00133-y
Pomaranzi, G., Amerio, L., Schito, P., Lamberti, G., Gorlé, C., & Zasso, A. (2022). Wind tunnel pressure data analysis for peak cladding load estimation on a high-rise building. Journal of Wind Engineering and Industrial Aerodynamics,220, Article 104855. https://doi.org/10.1016/j.jweia.2021.104855 Pujadas-Gispert, E., Alsailani, M., van Dijk, K. C. A., Rozema, A. D. K., ten Hoope, J. P., Korevaar, C. C., & Moonen,S. P. G. (2020). Design, construction, and thermal performance evaluation of an innovative
biobased | ventilated | façade.Frontiers | of | Architectural | Research, 9(3), 681–
696. https://doi.org/10.1016/j.foar.2020.02.003
Pulkrab, K., Sloup, M., & Zeman, M. (2014). Economic impact of Douglas-fir (Pseudotsuga menziesii [Mirb.]
Franco) | production | in | the | Czech | Republic. Journal | of Forest | Science, 60(7), 297–
306. https://doi.org/10.17221/27/2014-JFS
Pylkkänen, R., Werner, D., Bishoyi, A., Weil, D., Scoppola, E., Wagermaier, W., Safeer, A., Bahri, S., Baldus,
M.,Paananen, A., Penttilä, M., Szilvay, G. R., & | Mohammadi, P. (2023). The | complex | structure
of Fomes fomentariusrepresents an architectural design for high-performance ultralightweight materials. Science Advances, 9(8), Article eade5417. https://doi.org/10.1126/sciadv.ade5417
Qureshi, J. (2022). A | review | of | recycling | methods | for | fibre | reinforced | polymer
composites. Sustainability, 14(24),Article 16855. https://doi.org/10.3390/su142416855
Rabe, S., Klack, P., Bahr, H., & Schartel, B. (2020). Assessing the fire behavior of woods modified by N-
methylol | crosslinking, thermal | treatment, and | acetylation. Fire | and | Materials, 44(4), 530–
539. https://doi.org/10.1002/fam.2809
Radhi, H., Sharples, S., & Fikiry, F. (2013). Will multi-facade systems reduce cooling energy in fully glazed
buildings?A | scoping | study | of | UAE | buildings. Energy | and | Buildings, 56, 179–
188. https://doi.org/10.1016/j.enbuild.2012.08.030
Radu, I.-C., Cozorici, D.-E., Blanzeanu, E., & Zaharia, C. (2026). Exploring the recyclability of sustainable polymer composites. In L. Ravindran, A. Babu, S. Meyyarappallil Sadasivan, M. Mozetič, & S. Thomas (Eds.), Macro, micro and nanocomposites from sustainable sources: Shrinking environmental footprints (pp. 679–716). Springer Nature.https://doi.org/10.1007/978-981-95-2469-3_21
Rather, J. A., Akhter, N., Ashraf, Q. S., Mir, S. A., Makroo, H. A., Majid, D., Barba, F. J., Khaneghah, A. M., & Dar, B.N. (2022). A comprehensive review on gelatin: Understanding impact of the sources, extraction methods, and modifications on potential packaging applications. Food Packaging and Shelf Life, 34, Article 100945.https://doi.org/10.1016/j.fpsl.2022.100945

Riahinezhad, M., Hallman, M., & Masson, J.-F. (2021). Critical review of polymeric building envelope
materials:Degradation, durability | and | service | life | prediction. Buildings, 11(7), Article
299.https://doi.org/10.3390/buildings11070299
Rijkswaterstaat. (n.d.). Inhoud | Besluit | bouwwerken | leefomgeving. Informatiepunt | Leefomgeving
(IPLO). Retrieved October 15, 2026, from https://iplo.nl/regelgeving/omgevingswet/inhoud/besluit-bouwwerken-leefomgeving/
Ritchie, H., Rosado, P., & Roser, M. (2020). Breakdown of carbon dioxide, methane, and nitrous oxide emissions by sector. Our World in Data. https://ourworldindata.org/emissions-by-sector
Romano, L. (2023). Three-dimensional cladding with bio-based materials [Master's thesis, Delft University of
Technology]. TU | Delft | Repository. https://repository.tudelft.nl/file/File_340e9f92-9a3e-44a0-9f89-
d7d835868cd4
Rovers, I. C. A., & Wösten, H. A. B. (2026). Fungal diversity used to produce mycelium materials. Materials Today Communications, 52, Article 115164. https://doi.org/10.1016/j.mtcomm.2026.115164
Rowell, R., & | Bongers, F. (2015). Coating | acetylated | wood. Coatings, 5(4), 792–
801.https://doi.org/10.3390/coatings5040792
Roy, E., Pronk, M., Agugiaro, G., & Ledoux, H. (2023). Inferring the number of floors for residential
buildings.International | Journal | of | Geographical | Information | Science, 37(4), 938–
962.https://doi.org/10.1080/13658816.2022.2160454
Sailesh, R., Yuvaraj, L., Doddamani, M., Babu Mailan Chinnapandi, L., & Pitchaimani, J. (2022). Sound absorption and transmission loss characteristics of 3D printed bio-degradable material with graded
spherical | perforations. Applied | Acoustics, 186, Article
108457. https://doi.org/10.1016/j.apacoust.2021.108457
Saluena Martin, J., Wösten, H. A. B., & Pelkmans, J. F. (2026). Reclaimed cellulose as alternative spawn for the production of mycelium insulating materials. Bioresource Technology Reports, 33, Article 102592.https://doi.org/10.1016/j.biteb.2026.102592
Sandak, A., Földvári-Nagy, E., Poohphajai, F., Diaz, R. H., Gordobil, O., Sajinčič, N., Ponnuchamy, V., & Sandak, J.(2021). Hybrid approach for wood modification: Characterization and evaluation of
weathering | resistance | of | coatings | on | acetylated | wood. Coatings, 11(6), Article
658. https://doi.org/10.3390/coatings11060658
Sandak, A., Sandak, J., Brzezicki, M., & | Kutnar, A. (2019). Biobased | building | skin. Springer
Singapore.https://doi.org/10.1007/978-981-13-3747-5
Sandberg, D. (1999). Weathering | of | radial | and | tangential | wood | surfaces | of | pine | and
spruce. Holzforschung, 53(4), 355–364. https://doi.org/10.1515/HF.1999.059
Sandberg, D., Kutnar, A., & Mantanis, G. (2017). Wood modification technologies—A review. iForest -Biogeosciences and Forestry, 10(6), 895–908. https://doi.org/10.3832/ifor2380-010
Sang, Y., Liu, H., & Umar, A. (2015). Photocatalysis from UV/Vis to near-infrared light: Towards full solar-light spectrum activity. ChemCatChem, 7(4), 559–573. https://doi.org/10.1002/cctc.201402812 Santamouris, M. (2019). Mitigating the local climatic change and fighting urban vulnerability. In Minimizing energy consumption, energy poverty and global and local climate change in the built environment: Innovating to zero (pp.223–307). Elsevier. https://doi.org/10.1016/B978-0-12-811417-9.00008-8 Santamouris, M., & Yun, G. Y. (2020). Recent development and research priorities on cool and super cool
materials | to | mitigate | urban | heat | island. Renewable | Energy, 161, 792–
807. https://doi.org/10.1016/j.renene.2020.07.109
Satopaa, V., Albrecht, J., Irwin, D., & Raghavan, B. (2011). Finding a “kneedle” in a haystack: Detecting knee points in system behavior. In 2011 31st International Conference on Distributed Computing Systems Workshops (pp. 166–171).IEEE. https://doi.org/10.1109/ICDCSW.2011.20
Schultz, N., Fazli, A., Piros, S., Barranco-Origel, Y., DeLa | Cruz, P., &
Schneider, D. Y. (2024). Characterization of mycelium biocomposites under simulated weathering conditions. ACS Applied Bio Materials, 7(12), 8408–8422.https://doi.org/10.1021/acsabm.4c01192 Seim, A., Marquer, L., Bisson, U., Hofmann, J., Herzig, F., Kontic, R., Lechterbeck, J., Muigg, B., Neyses-Eiden, M.,Rzepecki, A., Rösch, M., Walder, F., Weidemüller, J., & Tegel, W. (2022). Historical spruce abundance in Central Europe: A combined dendrochronological and palynological approach. Frontiers in Ecology and Evolution, 10, Article 909453. https://doi.org/10.3389/fevo.2022.909453
SFS | Group. (n.d.-a). NV3 | installation | guide (Version | 2). Retrieved | July
23, 2026, from https://uk.sfs.com/content/files/7082%20-%20UK/Downloads%20PDFs/NVELOPE/NV3%20installation%20guide%20V2.pdf
SFS | Group. (n.d.-b). NV3 | rainscreen | subframe | system. Retrieved | July
23, 2026, from https://uk.sfs.com/systems/nvelope/nv3
Shakir, M. A., Ahmad, M. I., Yusup, Y., & Rafatullah, M. (2025). From waste to wealth: Converting rubber wood sawdust into green mycelium-based composite. Biomass Conversion and Biorefinery, 15(1), 739– 757.https://doi.org/10.1007/s13399-023-05113-9
Shakir Abbood, I., Odaa, S. aldeen, Hasan, K. F., & Jasim, M. A. (2021). Properties evaluation of fiber reinforced polymers and their constituent materials used in structures—A review. Materials Today: Proceedings, 43, 1003–1008.https://doi.org/10.1016/j.matpr.2020.07.636
Shelly, D., Lee, S., & Park, S. (2025). Hemp fiber and its bio-composites: A comprehensive review part I— Characteristics and processing. Advanced Composites and Hybrid Materials, 8(3), Article 252.https://doi.org/10.1007/s42114-025-01314-0
Shi, N. N., Tsai, C.-C., Camino, F., Bernard, G. D., Yu, N., & | Wehner, R. (2015). Keeping | cool: Enhanced
optical reflection and radiative heat dissipation in Saharan silver ants. Science, 349(6245), 298– 301.https://doi.org/10.1126/science.aab3564
Shi, N. N., Tsai, C.-
C., Carter, M. J., Mandal, J., Overvig, A. C., Sfeir, M. Y., Lu, M., Craig, C. L., Bernard, G. D.,Yang, Y., & Yu, N. (2018). Nanostructured fibers as a versatile photonic platform: Radiative cooling and waveguiding through transverse Anderson localization. Light: Science & Applications, 7(1), Article 37.https://doi.org/10.1038/s41377-018-0033-x
Shrivastava, R., & Sahu, D. L. (2024). Advancements in facade systems: A comprehensive review and analysis.International Journal of Innovative Research in Technology and Science, 12(2), 300–308. Siddique, R. H., Diewald, S., Leuthold, J., & Hölscher, H. (2013). Theoretical and experimental analysis of the structural pattern responsible for the iridescence of Morpho butterflies. Optics Express, 21(12), 14351– 14361.https://doi.org/10.1364/OE.21.014351
Silva, A., & de Brito, J. (2021). Service life of building envelopes: A critical literature review. Journal of Building Engineering, 44, Article 102646. https://doi.org/10.1016/j.jobe.2021.102646
Sivalbp. (n.d.). Wood cladding prices per square metre: Guide by wood type. Retrieved October 13, 2026, from https://www.sivalbp.fr/en/news/wood-cladding-news-what-is-the-price-of-wood-cladding/
Slabohm, M., Brischke, C., & Militz, H. (2023). The durability of acetylated beech (Fagus sylvatica L.) laminated veneer lumber (LVL) against wood-destroying basidiomycetes. European Journal of Wood and Wood Products, 81(4),911–921. https://doi.org/10.1007/s00107-023-01962-3
Slabohm, M., Mai, C., & Militz, H. (2022). Bonding acetylated veneer for engineered wood products—A review.Materials, 15(10), Article 3665. https://doi.org/10.3390/ma15103665
Smit, Y., Cameron, M., Venter, P., & | Witthuhn, R. C. (2011). Alicyclobacillus spoilage | and | isolation—A
review. Food Microbiology, 28(3), 331–349. https://doi.org/10.1016/j.fm.2010.11.008
Soh, E., Loh, N., Teoh, J. H., Jain, A., & Le Ferrand, H. (2025). Biodegradable mycelium tiles with elephant skin inspired texture for thermal regulation of buildings. Energy and Buildings, 328, Article 115187.https://doi.org/10.1016/j.enbuild.2024.115187
Sonderegger, W., & Niemz, P. (2009). Thermal conductivity and water vapour transmission properties of wood-
based | materials. European | Journal | of | Wood | and | Wood | Products, 67(3), 313–
321. https://doi.org/10.1007/s00107-008-0304-y
Song, S., Li, X., Shen, C., Li, M., Hu, X., Jin, Z., & Huang, Z. (2025). Graphene-modified C/C composites for enhanced directional thermal conductivity. Journal of Materials Research and Technology, 36, 4043– 4052.https://doi.org/10.1016/j.jmrt.2025.04.089
Song, X., Chen, S., Cai, Z., Wu, J., Zhang, Y., Na, R., Lv, H., He, C., Wu, T., & Wang, X. (2025). Optimization of semi-wet hot-pressing conditions for Salix psammophila-based mycelium-bound boards via response

surface | methodology.European | Journal | of Wood | and | Wood | Products, 83(3), Article
106. https://doi.org/10.1007/s00107-025-02259-3
SSIM. (2022). LCA of wood. Sustainability Impact Metrics. https://www.ecocostsvalue.com/lca/wood-lca-issues/
Stelzer, L., Hoberg, F., Bach, V., Schmidt, B., Pfeiffer, S., Meyer, V., & | Finkbeiner, M. (2021). Life | cycle
assessment | of | fungal-based | composite | bricks. Sustainability, 13(21), Article
11573. https://doi.org/10.3390/su132111573
Stephens, G. L., O’Brien, D., Webster, P. J., Pilewski, P., Kato, S., & | Li, J. (2015). The | albedo | of
Earth. Reviews of Geophysics, 53(1), 141–163. https://doi.org/10.1002/2014RG000449
Štěrbová, I., Oberhofnerová, E., Panek, M., Dvořák, O., & Pavelek, M. (2021). Influence of different exposition of larch wood facade models on their surface degradation processes. Central European Forestry Journal, 67(1), 45–53.https://doi.org/10.2478/forj-2020-0023
Subramaniam, S. (n.d.). Building skins: Where buildings connect with environment, people, and
culture. Rethinking | The | Future. Retrieved | October | 15, 2026, from https://www.re-
thinkingthefuture.com/architectural-community/a13609-building-skins-where-buildings-connect-with-environment-people-and-culture/
Suleiman, B. M., Larfeldt, J., Leckner, B., & Gustavsson, M. (1999). Thermal conductivity and diffusivity of wood.Wood Science and Technology, 33(6), 465–473. https://doi.org/10.1007/s002260050130
Summa, S., Tomassoni, E., Marchione, F., Di | Perna, C., & | Stazi, F. (2025). Sustainable | façade
design: Prototyping and evaluating self-shading and flat modules for thermal performance and
environmental | impact. Journal | of | Building | Engineering, 99, Article
111619. https://doi.org/10.1016/j.jobe.2024.111619
Sun, W., Tajvidi, M., Howell, C., & | Hunt, C. G. (2022). Insight | into | mycelium-lignocellulosic | bio-
composites: Essential factors and properties. Composites Part A: Applied Science and Manufacturing, 161, Article 107125.https://doi.org/10.1016/j.compositesa.2022.107125
Susca, T., & Pomponi, F. (2020). Heat island effects in urban life cycle assessment: Novel insights to include the effects of the urban heat island and UHI-mitigation measures in LCA for effective policy making. Journal of Industrial Ecology, 24(2), 410–423. https://doi.org/10.1111/jiec.12980
Svensson Meulmann, S., & Sjökvist, T. (2023). The potential of uncoated Norway spruce as a façade material— A review. Forests, 14(6), Article 1153. https://doi.org/10.3390/f14061153
Tangellamudi, S., Radhakrishnan, V., Vikraman, A., Maiti, S., & Kundu, P. (2025). Urbanization and plywood demand:Evaluating air quality, waste, and health concerns in the Indian context. Journal of The Institution of Engineers (India): Series A, 106(4), 1297–1309. https://doi.org/10.1007/s40030-025-00925-6
Teeuwen, S., Oldenburger, J., & Beerkens, G. (2023). Houtproductie en -gebruik in Nederland. Probos.
Teeuwen, S., Velthuis, J., & | Zwijgers, R. (2025, February | 24). Houtproductie | en | -gebruik | in
Nederland. Probos.https://www.probos.nl/en/publications/key-data/3849-key-data-2023-timber-production-and-consumption-in-the-netherlands-2
Thevega, T., Jayasinghe, J. A. S. C., Robert, D., Bandara, C. S., Kandare, E., & Setunge, S. (2022). Fire compliance of construction materials for building claddings: A critical review. Construction and Building Materials, 361, Article 129582. https://doi.org/10.1016/j.conbuildmat.2022.129582
Thermory. (n.d.). Spruce | cladding | | | Benchmark | series. Retrieved | September
23, 2026, from https://thermory.com/benchmark-thermo-spruce-cladding/
360 Research Reports. (2025, May 11). Thermowood market trends, size, share & growth forecast | CAGR
4.07%.https://www.360researchreports.com/market-reports/thermowood-market-200076
Tong, S., Prior, J., McGregor, G., Shi, X., & Kinney, P. (2021). Urban heat: An increasing threat to global health. The BMJ, 375, Article n2467. https://doi.org/10.1136/bmj.n2467
Trenberth, K. E., Fasullo, J. T., & Kiehl, J. (2009). Earth’s global energy budget. Bulletin of the American Meteorological Society, 90(3), 311–324. https://doi.org/10.1175/2008BAMS2634.1
Turner, J. S., & Soar, R. C. (2008). Beyond biomimicry: What termites can tell us about realizing the living building. In First International Conference on Industrialized, Intelligent Construction (I3CON) (pp. 1– 18). Loughborough

University.https://www.researchgate.net/publication/255650482_Beyond_biomimicry_What_termites_can_tell_us_about_realizing_the_living_building
Ulpiani, G., Di Perna, C., & Zinzi, M. (2020). Mist cooling in urban spaces: Understanding the key factors behind
the | mitigation | potential. Applied | Thermal | Engineering, 178, Article
115644.https://doi.org/10.1016/j.applthermaleng.2020.115644
Ulvcrona, T., Lindberg, H., & Bergsten, U. (2006). Impregnation of Norway spruce (Picea abies L. Karst.) wood by hydrophobic oil and dispersion patterns in different tissues. Forestry, 79(1), 123– 134.https://doi.org/10.1093/forestry/cpi064
US | EPA. (2014, June | 23). Guide | to | reducing | heat | islands [Reports | and
Assessments].https://www.epa.gov/heatislands/guide-reducing-heat-islands
van Blokland, J. (2020). Thermally modified timber: Novel aspects of bending behaviour towards grading and
structural | applications [Doctoral | dissertation, Linnaeus
University]. DiVA. https://urn.kb.se/resolve?urn=urn:nbn:se:lnu:diva-98135
van Blokland, J., Adamopoulos, S., & Ahmed, S. A. (2020). Performance of thermally modified spruce timber in outdoor above-ground conditions: Checking, dynamic stiffness and static bending properties. Applied Sciences, 10(11),Article 3975. https://doi.org/10.3390/app10113975
Van den Bulcke, J., Wong, A., Kim, Y., & Van Acker, J. (2010). Improved analysis of field test data related to service life prediction of tropical wood species (Document No. IRG/WP 10-20447). The International Research Group on Wood Protection.
Vancso, D., Verspreek, S., van der Laan, C., & van der Burgh, F. (2024). Agrodome EPD report: NPSP
| Nabasco | | | Facade | | | 8012
Reed. Agrodome.https://cdn.shopify.com/s/files/1/0506/2456/1325/files/20241128_EPD_EN_Agrodome_BV_Nabasco_Facade_8012_Reed.pdf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
Vašatko, H., Gosch, L., Jauk, J., & Stavric, M. (2022). Basic research of material properties of mycelium-based composites. Biomimetics, 7(2), Article 51. https://doi.org/10.3390/biomimetics7020051
Veloso, R. C., Souza, A., Maia, J., Ramos, N. M. M., & Ventura, J. (2021). Nanomaterials with high solar reflectance as an emerging path towards energy-efficient envelope systems: A review. Journal of Materials Science, 56(36), 19791–19839. https://doi.org/10.1007/s10853-021-06560-3
Verspeek, S., & van der Burgh, F. (2019). Performance of biobased facade panels. Academic Journal of Civil Engineering, 37(2), 678–683. https://doi.org/10.26168/icbbm2019.98
Virta, J., Koponen, S., & Absetz, I. (2005). Cupping of wooden cladding boards in cyclic conditions—A study of boards made of Norway spruce (Picea abies) and Scots pine sapwood (Pinus sylvestris). Wood Science and Technology,39(6), 431–438. https://doi.org/10.1007/s00226-005-0023-z
Vogel, S., Ellington, C. P., & Kilgore, D. L. (1973). Wind-induced ventilation of the burrow of the prairie-
dog, Cynomys | ludovicianus. Journal | of | Comparative | Physiology, 85(1), 1–
14. https://doi.org/10.1007/BF00694136
Volk, R., Schröter, M., Saeidi, N., Steffl, S., Javadian, A., Hebel, D. E., & Schultmann, F. (2024). Life cycle
assessment | of | mycelium-based | composite | materials. Resources, | Conservation | and
Recycling, 205, Article 107579.https://doi.org/10.1016/j.resconrec.2024.107579
Vukusic, P., Sambles, J. R., Lawrence, C. R., & Wootton, R. J. (1999). Quantified interference and diffraction in single Morpho butterfly scales. Proceedings of the Royal Society of London. Series B: Biological Sciences, 266(1427), 1403–1411. https://doi.org/10.1098/rspb.1999.0794
Wang, F., Li, C., Yang, Z., Xie, W., Li, X., Xu, Z., Yan, Y., & Cheng, Z. (2024). A double-layer radiative cooling coating that utilizes the refractive index difference between layers to achieve extremely high solar
reflectivity. Science | China | Technological | Sciences, 67(10), 3182–
3189. https://doi.org/10.1007/s11431-023-2603-2
Wang, H., Wang, W., Tao, J., Liu, S., Hou, X., & He, C. (2024). Anchoring mycelium on CNTs to make strong and smart self-regenerative composite materials. Composites Part B: Engineering, 287, Article 111861.https://doi.org/10.1016/j.compositesb.2024.111861
Wang, J., Liu, S., Meng, X., Gao, W., & Yuan, J. (2021). Application of retro-reflective materials in urban
buildings: A | comprehensive | review. Energy | and | Buildings, 247, Article
111137. https://doi.org/10.1016/j.enbuild.2021.111137

Wang, Q., Zhang, G., Li, W., & Shi, L. (2020). External wind on the optimum designing parameters of a wall solar chimney in building. Sustainable Energy Technologies and Assessments, 42, Article 100842.https://doi.org/10.1016/j.seta.2020.100842
WIPO. (2025). World intellectual property indicators 2025: Highlights—Patents highlights. World Intellectual Property Organization. https://www.wipo.int/web-publications/world-intellectual-property-indicators-2025-highlights/en/patents-highlights.html
WiseGuyReports. (2026). Ventilated | facades | market | size | & | future | growth
2035.https://www.wiseguyreports.com/reports/ventilated-facades-market
Wong, A., & Singh, A. (2005). Natural durability of tropical species with emphasis on Malaysian hardwoods— Variations and prospects (Document No. IRG/WP 05-10565). The International Research Group on Wood Protection.
Wu, Y., Liao, H., & Tang, Y. (2021). Enhanced high-cycle fatigue strength of Al–12Si–4Cu-1.2Mn-T6 cast aluminum alloy at room temperature and 350 °C. Materials Science and Engineering: A, 825, Article 141917.https://doi.org/10.1016/j.msea.2021.141917
Xiang, B., Xu, P., Chang, Y., Zhang, Y., Wu, Y., Zhong, W., Lei, W., & Zhang, R. (2023). Biodegradable radiative cooling membrane based on electrospun silk fibroin fiber. Polymers for Advanced Technologies, 34(5), 1716–1722.https://doi.org/10.1002/pat.6005
Xiao, M., Tang, L., Zhang, X., Lun, I. Y. F., & Yuan, Y. (2018). A review on recent development of cooling
technologies | for | concentrated | photovoltaics | (CPV) | systems. Energies, 11(12), Article
3416.https://doi.org/10.3390/en11123416
Xie, D., Yang, Z., Liu, X., Cui, S., Zhou, H., & Fan, T. (2019). Broadband omnidirectional light reflection and radiative heat dissipation in white beetles Goliathus goliatus. Soft Matter, 15(21), 4294– 4300.https://doi.org/10.1039/C9SM00566H
Yang, F., Ge, Q., Qin, F., Zheng, J., & Zhao, H. (2024). Analysis of thermal expansion effects and thermodynamic control strategies for super high-rise building structures. International Journal of Heat and Technology, 42(3), 886–896.https://doi.org/10.18280/ijht.420317
Yang, Y., Roderick, M. L., Guo, H., Miralles, D. G., Zhang, L., Fatichi, S., Luo, X., Zhang, Y., McVicar, T. R., T u, Z.,Keenan, T. F., Fisher, J. B., Gan, R., Zhang, X., Piao, S., Zhang, B., &
Yang, D. (2023). Evapotranspiration | on | a | greening | Earth. Nature | Reviews | Earth | &
Environment, 4(9), 626–641. https://doi.org/10.1038/s43017-023-00464-3
Zeidler, A., Borůvka, V., Černý, J., & Baláš, M. (2022). Douglas-fir outperforms most commercial European
softwoods.Industrial | Crops | and | Products, 181, Article
114828. https://doi.org/10.1016/j.indcrop.2022.114828
Zelinka, S. L., Altgen, M., Emmerich, L., Guigo, N., Keplinger, T., Kymäläinen, M., Thybring, E. E., &
Thygesen, L.G. (2022). Review | of | wood | modification | and | wood | functionalization
technologies. Forests, 13(7), Article 1004.https://doi.org/10.3390/f13071004
Zhang, J., Li, J., Jin, X., Du, S., Kaur, J., & Wang, X. (2017). Natural and highly protective composite
structures—Wild | silkworm | cocoons. Composites | Communications, 4, 1–
4. https://doi.org/10.1016/j.coco.2017.02.005
Zhang, M., Zhang, Z., Zhang, R., Peng, Y., Wang, M., & | Cao, J. (2023). Lightweight, thermal
insulation, hydrophobic mycelium composites with hierarchical porous structure: Design, manufacture
and | applications. Composites | Part | B: | Engineering, 266, Article
111003. https://doi.org/10.1016/j.compositesb.2023.111003
Zhao, X., Copenhaver, K., Wang, L., Korey, M., Gardner, D. J., Li, K., Lamm, M. E., Kishore, V., Bhagia, S., T ajvidi,M., Tekinalp, H., Oyedeji, O., Wasti, S., Webb, E., Ragauskas, A. J., Zhu, H., Peter, W. H., & Ozcan, S. (2022).Recycling of natural fiber composites: Challenges and opportunities. Resources, Conservation and Recycling, 177,Article 105962. https://doi.org/10.1016/j.resconrec.2021.105962 Ziaeemehr, B., Jandaghian, Z., Ge, H., Lacasse, M., & Moore, T. (2023). Increasing solar reflectivity of building envelope materials to mitigate urban heat islands: State-of-the-art review. Buildings, 13(11), Article 2868.https://doi.org/10.3390/buildings13112868
Zoofy. (2026, July 22). Facade cleaning costs. https://zoofy.nl/en/price-guides/facade-cleaning-costs/

## Appendix

Appendix A. Expert Meetings and their Outcomes
Interviews and informal discussions with experts from many different fields have continually shaped and guided the direction of the project. They helped to define the question behind the question, informed the final material choices and progressively refined the design. This has proven to be a continuously evolving process, moving the emphasis from trying to reinvent the wheel, to going back to the fundamental principles behind the panel’s passive cooling and its shape and trying to understand the material behaviour. During the expert talks, a few reoccurring themes came back across the different conversations: refining the scope of the project, material orientation, outdoor applicability of MBCs, coatings, shape and prototyping, and the experimental testing setup.
Name | Profession | Discussed topic
Dr. Joris Remmers | Associate professor of Composite Materials – TU Eindhoven | Mechanical Engineering
Peter Oei | Program manager Biobased materials & Circular economy – Ministry of agriculture | Constructing and shaping MBCs
Willem Böttger | Director - NPSP | Possibility of using Nabasco 8010
Dr. Pieter Kooijman | Lab Manager – Lili’s Proto Lab | Prototyping
Nico van Hijningen | Project Support – Lili’s Proto Lab | Prototyping
Dr. Jordi Pelkmans | Lab Manager and Researcher –
| Microbiology Utrecht University | Growing and heat-pressing MBCs
Steve Szell | Architect & Interior designer –
| Freelance
| Guitar builder – Szephyr guitars | Prototyping, Woodworking

Fran Ortega
Exposito

Junior researcher biobased
construction – Avans Hogeschool / MNEXT

MBC limitations and opportunities

Naud van der Padt | Founder - Leafy | Implementation plan for the panel
Maud Kerstholt | Advisor Intellectual Property –
| Netherlands Patent Office | Intellectual Property Analysis
Arne Hendriks | Artist with existing MBC
| sculptures outdoors | Building/sculpting with MBC, long
| | term material behaviour, social
| | perception with MBCs

Scoping of the project
At the start of the Major Innovation Project, there were several key areas of the panel that could be reinvented and explored. This made it more difficult to define and formulate a clear scope for the project and led to several possible approaches for the project: redesigning the original shape, changing the material, test different coatings for durability and reflection, getting the product to TLR5, and growing mycelium panels and try to get the heat-pressed mycelium into the original shape. This led to a lack in clarity on where to focus the limited time and resources of the project.

This was also reflected in the feedback that multiple experts gave throughout the first months of the project. Joris Remmers, associate professor at the department of mechanical engineering at TU Eindhoven, was the first expert to point out that the combination of figuring out different shapes, configurations and materials at once was too much, and told us to focus on one of those and really dive into that one. However, this advice was not immediately acted upon, as the scope was not refined immediately. Willem Böttger of NPSP repeated this statement, questioning if the team would be able to act out two projects simultaneously, and suggested that growing and heat-pressing the mycelium should be more of a side project and that we should focus more on currently feasible façade panel materials. This led to the mycelium project being put more on the back burner in the beginning. Lastly, Nico van Hijningen also added to this idea, emphasising that we should first shift the focus to fully understand the method of heat transfer and convection in a simplified tube, before testing on the more complex final shape.

Material orientation
At the start of the project, the MaterialDistrict convention showed how many different companies are currently developing new sustainable biobased materials for façade panels. Also notable was that mycelium materials are currently hot in the field of material innovation but are still a luxury product and mostly for indoor use, like furniture or acoustic panels. This opens up a potential niche for the development of mycelium panels for outdoor use. During the many talks with experts, there were broad explorations of many different biobased materials that could be used in façade panel context. Peter Oei introduced the broadness of biobased materials that could be used in the project, with additions of biobased binders and even a C5 sugar resin that could be a sustainable alternative to the petroleum resins currently in use. However, Nico casted doubt about the use of Douglas fir wood in 5 mm thick panels, indicating that the wood would warp, while 16 mm thick panels would probably become too thick and heavy for the wall attachment. Steve, in contrast, was very enthusiastic about the use of wood in the specific shape and context. He gave options on what types of plywood could be used and information on how individual grains of wood interact with each other in plywood.

Outdoor applicability of MBCs
There is a great deal of scepticism surrounding the use of MBCs in outdoor environments, yet there were also experts who had a much more positive view on the topic. Experts on biobased materials like Willem Böttger and Peter Oei both expressed their doubts on the topic, claiming that the panels do not handle humidity well. Willem talked about a solution, using epoxy coatings to improve the lifespan and mechanical properties of the panels. But they would still not last long. Fran Ortega, expert on façade materials and MBCs at MNEXT and the Avans Hogeschool, sees the potential of MBCs in the construction sector and façade panel usage. Fran explained that while lifespan is the most difficult property to manage in outdoor context, as the panel is highly susceptible to microbial attack and will mould when it cannot dry out anymore, that these challenges can be overcome with the right approach. He explained that heat-pressing improves the properties, and makes it less susceptible to moulding, while he strongly advised against cold-pressing for outdoor use. In addition, he pointed at UV degradation to be a concern, as prolonged exposure causes the heat-pressed to delaminate and change colour.

Despite these problems, Fran remained optimistic: “There are always ways to overcome the downsides, whether they're feasible or not is a separate question, but there are ways to protect mycelium and make it more durable. It's done with wood, and mycelium composites aren't fundamentally that different. It really depends on the production process and whether there can be more investigation into substrate combinations that would improve water resistance.”

Artist Arne Hendriks remarked that when working with living mycelium as a construction material, it is incredibly unpredictable and highly prone to changes in outdoor settings. However, it can act as a great “bio reactor” as it can attract life and increase biodiversity, as well as sparking debate and narrative amongst local community in regard to what it means to have nature as part of the urban environment. In our context, the mycelium would no longer be living, but it is an interesting point about the social aspects.

Coatings
Another topic that came up many times during interviews was the use of coatings to improve the outdoor applicability of MBCs and wooden planks. Fran Ortega explained that certain coatings can make heat-pressed and non-pressed MBCs sustain outdoor conditions, but these are often epoxy and not biobased. However, there are a few up and coming biobased coatings that come close to matching the performance of epoxy. He gave the example of the Impershield coating that is used on the Growing Pavilion. However, Fran explained that the biggest current knowledge gap in the field of MBCs is in biobased coatings that actually perform as well as non-biobased epoxies. Xyhlo was another coating that came up several times during the meetings, with Fran, Willem and Peter all mentioning the promising biobased coating. Willem indicated that the coating doesn’t work on Nabasco, as it cannot penetrate the material for the fungus to live in. Fran explained that it works on heat-pressed MBC boards and that they’re currently in advanced testing, needing to be tested still in the outdoor environment.

Another interesting option that Fran suggested is the use of pure mycelium itself as a coating. At MNEXT they are developing mycelium-based coatings using white rot fungi. If successful, this could offer a fully biobased solution that mimics the natural skin that grows on mycelium.

Prototyping
There were also tips for the prototyping part of the project, coming from multiple experts. Steve mostly helped with understanding different types of wood and their properties, explaining that grain direction is extremely important while using thin plates of wood. As non-processed woods warp because of the grain direction, plywood does not, as it’s thin slices of wood with the grains working against each other. He explained that you can CNC plywood not all the way through, so the thin outer layer acts as a membrane keeping the pieces together and it aids the convection leaving no crevices.

Fran helped with mycelium prototyping, indicating that using a positive, as well as a negative mould during heat-pressing will yield the best results, and recommended using borders in the mould for better results. Additionally, he suggested trying CNC’ing heat-pressed boards, as he had never tried it. He also noted that that heat-pressed boards can easily be stapled or nailed together.

Artist Arne Hendriks also advised getting familiar with the mycelium materials, as the there is usually diversity in the biomaterial naturally (it’s difficult to make every sample exactly the same) which was also mentioned by dr. Jordi Pelkmans. Getting more familiar would increase embodied knowledge, problem solving and foresight. Therefore, replicates would be ideal, and experiential knowledge will enhance the process along the way.

Implementation plan
To get an idea of how to get from a simple prototype to a fully developed product that is commercially viable we talked to an expert who already achieved this step: Naud van der Padt, Cofounder of the company “Leafy” based in Amsterdam.

Naud stressed the importance of collaborating with other companies, in particular other startups, when trying to establish your product on the market. For a product as complex as a building façade doing every step by yourself is in his opinion not feasible.

He gave examples of collaborations with companies focused on materials and suggested that aspects like mounting mechanisms or fire safety mechanisms, could both be solved more easily by collaborating with another company. In his experience many startups would be eager to collaborate on joint projects as it also gives them the opportunities to get their product out on the market. Façade specific challenges he told us to look out for were lifespan of the product and the end-of-life scenario, which in his opinion is best solved by making the panels modular, as a whole façade is harder to dispose of.

Intellectual property
To understand more about how Intellectual property matters work in the Netherlands, we consulted with Maud Kerstholt, an expert from the Dutch Patent Office. She gave us a breakdown of the different types of Intellectual properties there are in the Netherlands, and how we could use them for our project. She also informed us about the possibility of a freedom to operate (FTO) analysis and how we could perform a shortened version thereof to have some indication of which types of patents we need to look out for. This recommendation was given because a full FTO analysis would not be possible for us as according to her they would need to be conducted by professionals and would cost between 10000 and 50000€ depending on the scope. She urged us to pay attention to patents with general claims about mycelium materials. Sometimes patent claims can cover the use of a biological organism as a material entirely, or a common mode of growing mycelium. Even if that process used is common practice in the fungal lab of UU, it might be protected from commercial use.

A piece of advice Naud van der Padt gave us on IP is to not focus on obtaining patents in the starting phase of developing a company, as realistically a start up in that stage does not possess the resources to successfully enforce a patent, as the legal cost required to prevent competitors to use patent technology is too great. Instead, we should focus on distinguishing our product through its quality. The talk with Maud Kerstholt added the insight that with the prior published literature, obtaining a patent for our design would not be possible, which confirmed our IP strategy of not trying to obtain patents at the current stage of the project.

# Biological Cooling Mechanisms

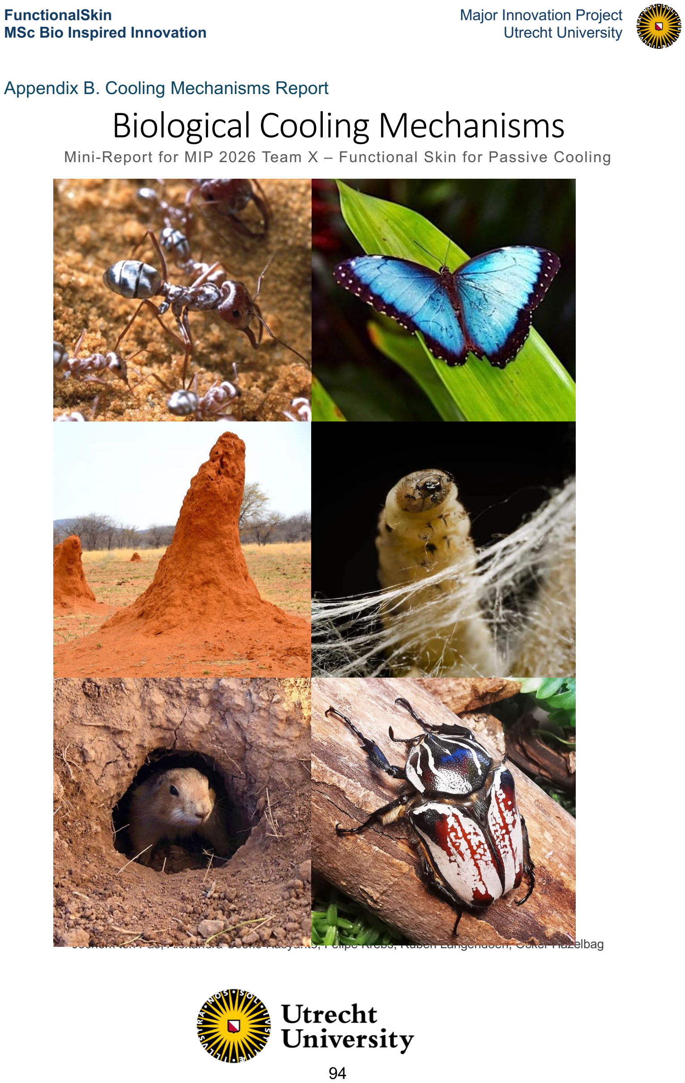
[picture p47: page 95]

Appendix B. Cooling Mechanisms Report

Mini-Report for MIP 2026 Team X – Functional Skin for Passive Cooling

Jochem ten Pas, Alexandra Cooke-Kasyanto, Felipe Krebs, Ruben Langendoen, Ocker Hazelbag

Inhoudsopgave

## Introduction

Rising global temperatures and ongoing urbanization have led to an increase in the demand for artificial cooling inside of buildings, as well as urban environments. The global population has been facing an increasing demand for cooling energy, as traditional cooling technologies, like air-conditioning, use large amounts of electricity (Auffhammer et al., 2017). Cooling systems account for nearly 20% of the global building energy use (Falchetta et al., 2024). In addition, global warming in combination with the Urban Heat Island (UHI) effect further increases the need for sustainable cooling strategies that minimize energy use (Hong et al., 2022).
To understand how cooling can be achieved more sustainably and passively, it is essential to understand how heat is transferred, dissipated and lost. Heat transfer can occur through several mechanisms in nature: reflection, radiation, convection, conduction and evaporation. The balance between these mechanisms ultimately determines the thermal state of a system (Carey et al., 2008). In urban environments, this balance is often disrupted. Urban materials, like concrete, asphalt and steel absorb and retain heat, while the dense urban environment limits airflow and thus reduces heat dissipation (Hong et al., 2022). In addition, the limited presence of vegetation in urban areas reduces the passive cooling through evapotranspiration and decreases the availability of shading. This contributes to the UHI, where heat becomes trapped in these so-called urban canyons, and accumulates there due to a lack of effective thermoregulation. One way to tackle this problem is by using façade panels on buildings that can contribute to the passive cooling of the building and its urban environment, while also reducing the amount of heat that is absorbed in the first place. Existing designs (see Appendix A) could be optimised through the exploration of mechanisms that exist in nature.
Through evolution, nature has evolved many ways to keep organisms cool, even in harsh environments. For example, in the Sahara desert, termites construct their mounds in such a way, that convective airflows cool the inside, even in the extremely hot and arid climate (Korb, 2003). Secondly, the Saharan silver ant, Cataglyphis bombycine, is able to forage during the middle of the day at harsh temperatures, due to their triangular hairs that reflect solar radiation and emit infrared light. In addition, plants cool their surrounding environment through the mechanism of evapotranspiration, which is the process where plants lose water vapor to the atmosphere though their stomata (Y. Yang et al., 2023). These biological models highlight the potential of bio-inspired or biomimetic approaches for sustainable cooling. This mini report explores how the key heat transfer strategies, reflection, radiative cooling, convection, conduction and evaporation are utilized in nature as strategies to passively cool organisms and the environment. Additionally, the underlying mechanisms of these strategies are examined to gain a deeper understanding of both the strategies and the biological models, enabling their application in the façade panel.

## Reflection

Reflection is one of the primary passive cooling mechanisms within the façade panel. Solar reflection aims to minimize solar heat gain, by reducing the fraction of incoming radiation¹ that is absorbed by a material (Hernández-Pérez et al., 2014). Solar reflectance can be expressed as ρ, or ρsolar. The ability of a surface to release the heat that is absorbed in the form of thermal radiation is called thermal emittance, or ε. Solar radiation is the primary source of heat input for solar reflection, so the ability to emit absorbed energy back to space as thermal radiation is crucial for its net cooling performance (Hossain & Gu, 2016). High values of ρ and ε enable surfaces to remain cooler under prolonged solar exposure, because less energy is absorbed and more is dissipated (Hernández-Pérez et al., 2014). These parameters play critical roles in the overall performance of the material of the façade panel.

Spectral selectivity
In addition to overall reflectance, the spectral selectivity of reflection plays a crucial role in the overall passive cooling performance of a material (Y. Li et al., 2020). Solar radiation consists of radiation in the ultraviolet (UV), visible light spectrum (Vis) and near-infrared (NIR) spectra (Sang et al., 2015). Out of all the solar energy, UV light accounts for 5% of the energy, visible light for 45% of the energy, and NIR for 50% of the energy. So, for the most efficient reflection over the full spectrum of solar radiation, the emphasis should be placed on the NIR range, as this account for the largest portion of the total solar energy. While visible light accounts for the perception of colour, high reflection in the NIR region is most important for thermal management, as it directly influences the heat gain without affecting the aesthetics of the material (Levinson et al., 2007) This is also the reason why radiative cooling has proven to be such an efficient passive cooling strategy in nature (Didari & Mengüç, 2018).
Therefore, the application of spectrally selective materials is extremely important in the field of reflection and passive cooling in facades. These materials are designed to exhibit the highest reflection in the NIR region, while also maintaining the optical properties that are desired to preserve the colour and aesthetics (Y. Li et al., 2020).

Energy balance of a surface
The thermal behaviour of a façade surface can be understood through a simplified surface energy balance (Kiehl & Trenberth, 1997; Trenberth et al., 2009). The absorbed solar energy can be expressed as:
(1 − ρ) · Iₛₒₗₐᵣ | (1)

In this equation (1 − ρ) is the solar absorption, as ρ is the fraction of the incoming energy that is reflected. The remainder is what is absorbed. The average reflection on earth is about 0.3, meaning that 70% of the solar energy is absorbed (Trenberth et al., 2009). Iₛₒₗₐᵣ is the incident solar irradiance, most often expressed in W/m².

1 Radia=on generally refers to the energy that is transmi@ed through space in the form of par=cles and waves (Cameron Pimperl, 2009).

While the emitted thermal radiation follows the Stefan-Boltzmann law:
ε · σ · T4 | (2)
In this equation, ε is the thermal emittance of the surface, as mentioned before. In addition, σ is the Stefan-Boltzmann constant (5,67 × 10⁻⁸ W·m⁻²·K⁻⁴), while T is the temperature in Kelvin of the surface that is emitting the radiation.

Cool materials
Reflective materials, also referred to as cool materials, are designed to reflect a large amount of the incoming solar radiation, while also emitting thermal radiation (Hernández-Pérez et al., 2014). These materials have been shown to reduce surface temperatures by 10 – 25 °C, in comparison to other conventional building materials. The application of these materials is therefore essential in the passive cooling of our façade panel. For these reflective materials, two main categories can be distinguished. Cool white materials exhibit high reflectance across both the visible light spectrum, as well as the near-infrared spectrum. The solar reflectance value (ρ) of these materials can reach up to 0.9, resulting in large surface temperature reductions compared to non-coated materials. By contrast, cool coloured materials might offer a more aesthetically appealing option, as they can provide colour to the façade panel. However, they reflect a smaller fraction of the visible light while reflecting a larger fraction of the NIR spectrum, when compared to a white panel. These materials can reduce the surface temp by 5 – 13 °C, in comparison to the 10 - 25 °C of cool white materials.

Reflection and albedo
Another term is often used in the concept of reflectivity is albedo. Albedo, often expressed as α, can be defined as the fraction of solar radiation that is reflected by a particular surface (Stephens et al., 2015). In theory, albedo and solar reflectance are equivalent concepts, but albedo is often used on larger scale (e.g., earth, urban surfaces), while solar reflectance is often used to describe the solar spectral reflectance of materials in construction and material science (Hernández-Pérez et al., 2014; Veloso et al., 2021). However, reflection is not solely determined by the material composition or its colour. While the average conventional material rely mostly on pigments, more recent research has shown that reflection can also be caused by micro- and nanoscale structures (Mundekkad & Mallya, 2025; Veloso et al., 2021). These materials, often inspired by biology and nature, can scatter the light that would otherwise be reflected. These mechanisms are particularly relevant for the bio-inspired design, as natural models can achieve high reflectance through structure rather than solely colour.

Retro-reflectivity
In addition to conventional reflective materials, retro-reflective materials also present another approach to improving solar reflection in the urban environment. These retro-reflective materials redirect incoming solar radiation back directly towards the original source, instead of scattering the light back in several directions, like conventional reflective materials

(Fig. 1) (J. Wang et al., 2021). This difference in reflection trajectory has large consequences for UHI mitigation, as the conventional counterparts can cause secondary heating, which is the mechanism where the reflected solar radiation is absorbed by the surrounding urban materials. This merely shifts the problem, rather than solving it.

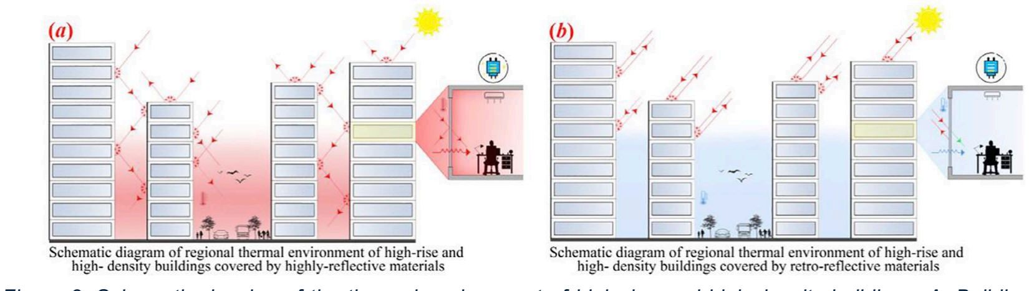
[picture p48: figure]

Figure 3: Schematic drawing of the thermal environment of high rise and high density buildings. A. Buildings covered in conventional reflective materials. B. Buildings covered in retro-reflective materials (Wang et al., 2021).
Retro-reflectivity in materials and surfaces is most often achieved through structural designs, like the application of glass beads, prism geometry or saw-tooth reflective films (Fig. 2) (J. Wang et al., 2021). When these are applied to building facades and roofs, they increase the upward solar reflection to 60-70%, in comparison to 45-55% for conventional glass. This results in reduced solar energy being trapped in the urban canyons that cause UHI. In addition, they increase the overall urban albedo by up to 36% by reducing the uptake of solar heat in these urban environments. However, these materials still have some limitations. The effectiveness depends heavily on the solar angle, the structure of the surface its is applied to and the material weathering and degradation over time (J. Wang et al., 2021). In addition, the performance of the material is hard to assess, as the reflected light is directed in the same direction as the light source.

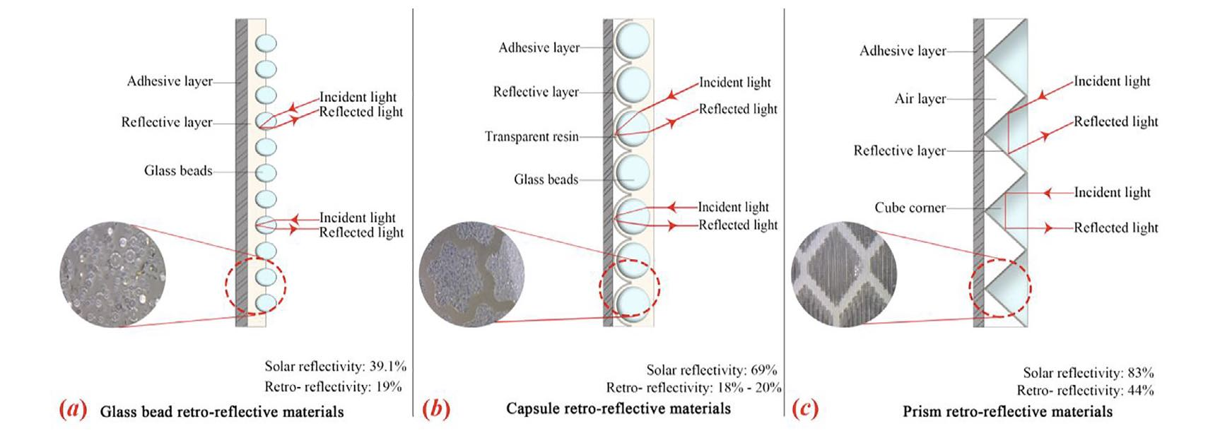
[picture p49: figure]

Figure 4: Optical mechanism and structure of the different retro-reflective materials. A. Glass beads. B. Capsulated glass beads. C. Prism-shaped saw-tooth shaped (Wang et al., 2021).
Cardinali et al. (2022) investigated the optimum design of retro-reflective materials as building envelopes, to enhance optical performance. This paper provides a framework on how to construct retro-reflective materials manually, using a combination of glass beads and a highly reflective (high albedo) paint. In this method, white pain is applied as a coating for an exterior building plaster sample (Fig. 3). The glass beads are deposited manually over the wet paint, dried and then the excess beads are removed. This would prove to be a relatively easy way to construct these retro-reflective materials ourselves. Results further show that both the size and surface density of the glass beads strongly influence the optical performance of the coating. Among the configurations that were tested, beads with a diameter of 200 μm – 300 μm proved to have the best balance between maintaining solar reflection, as well as providing the retro-reflectivity. This size range showed the most favourable angular distribution² of the reflected radiation, making it the optimal choice.

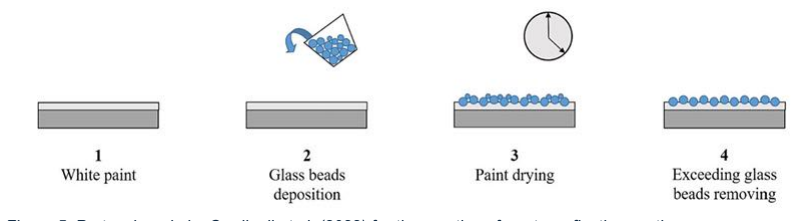
[picture p50: figure]

Figure 5: Protocol made by Cardinali et al. (2022) for the creation of a retro-reflective coating.

### Bio-models

In addition to the current conventional solutions for reflective materials, biological systems provide other interesting design principles for passive cooling, mostly through micro- and nanoscale structures that were developed through natures intricate ways in 3.8 billion years of evolution.

Archaeoprepona Demophon
One of those bio-models is the butterfly Archaeoprepona Demophon, which provides a clear example on how structures at nanoscale can achieve radiative cooling, as well as provide colour through structural colouration (Lee et al., 2022). The dorsal side of the wing of this butterfly consists of a hierarchical structure, consisting of a nanoporous matrix, combined with a periodically structured nanograting structural colouration ridge on the surface (Fig. 4). This combination of nanostructures provides the material with high visible light reflectance, reducing the heat gain by the solar rays, as well as high emissivity on the infrared spectrum, which enhances heat dissipation through the mechanism of radiative cooling. Additionally, the nanograting ridge structure provides iridescent colouring through Bragg diffraction³ (T.-
D. Nguyen et al., 2018). Because this type of colouration is structure-based rather than pigment-based, the colours do not degrade over time, and contribute to the camouflage of the butterfly in natural environments (Lee et al., 2022). By controlling the spacing of this structure, specific wavelengths can be constructively reflected, which enables structural

2 This describes how the reflected light is spread over different direc=ons, and shows how much light is actually sent back in the direc=on of the source (Cardinali et al., 2022). 3 This describes the principle where the incident light sca@er of a material in specific angles, which determines the

reflected wavelength (T.-D. Nguyen et al., 2018).

colouration that is tuneable to desire. The porous matrix is what gives the dorsal wing its radiative cooling abilities. This matrix contains nanopores that are randomly distributed and range in sizes from 200 to 800 nm, which includes the wavelengths of light in the visible spectrum, which range from 400 to 700 nm (Austin et al., 2021). These pores scatter the incoming solar radiation, which increases the overall reflection of the butterfly wings, and reduce the solar heat absorption (Lee et al., 2022).

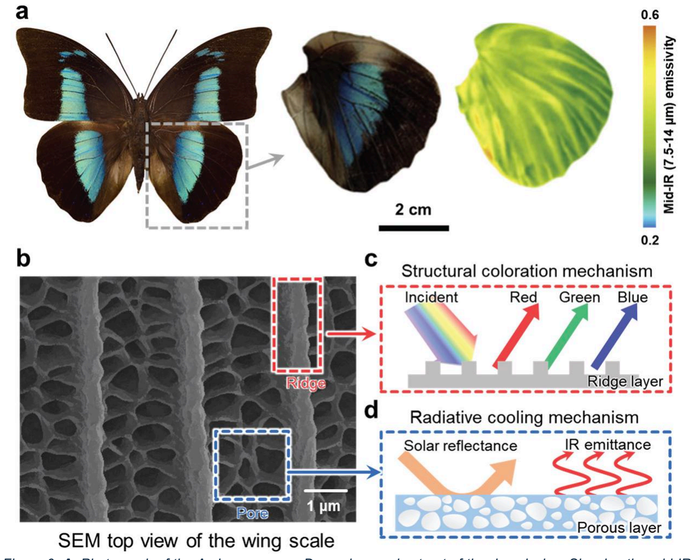
[picture p51: figure]

Figure 6: A. Photograph of the Archaeoprepona Demophon and cut-out of the dorsal wing. Showing the mid-IR emissivity of the wing structure. B. Scanning Electron Microscopy image of the Archaeoprepona demophon wing, consisting of the pores and ridges. C. Schematic figure of the structural colouration mechanism. D. Schematic image of the radiative cooling properties of the dorsal wing, caused by the nanoporous properties of the wing (Lee et al., 2022).
To replicate these functionalities, a biomimetic film was constructed by Lee et al. (2022). By drop-casting, a solution from SiO2 was transformed into a random porous structure, mimicking the pores of the dorsal wing of the A. demophon (Fig. 5). Laser interference lithography was applied to produce the nanograting structural colouring ridge. The resulting material, which was placed onto a PVDF-HFP polymer, exhibits both extremely high solar reflectance (ρ ≈ 0.94), as well as high infrared emissivity (ε ≈ 0.96). This biomimetic nanofilm achieves up to 8.45 °C reduction in temperature, compared to conventional materials, under full solar exposure. Along with the radiative cooling capability, the biomimetic film produces the structural colouring of a large colour gamut (91.8% of sRGB⁴). This shows the potential of this material in combining radiative cooling with functional colouration and aesthetics in one multifunctional film for the passive cooling façade panel.

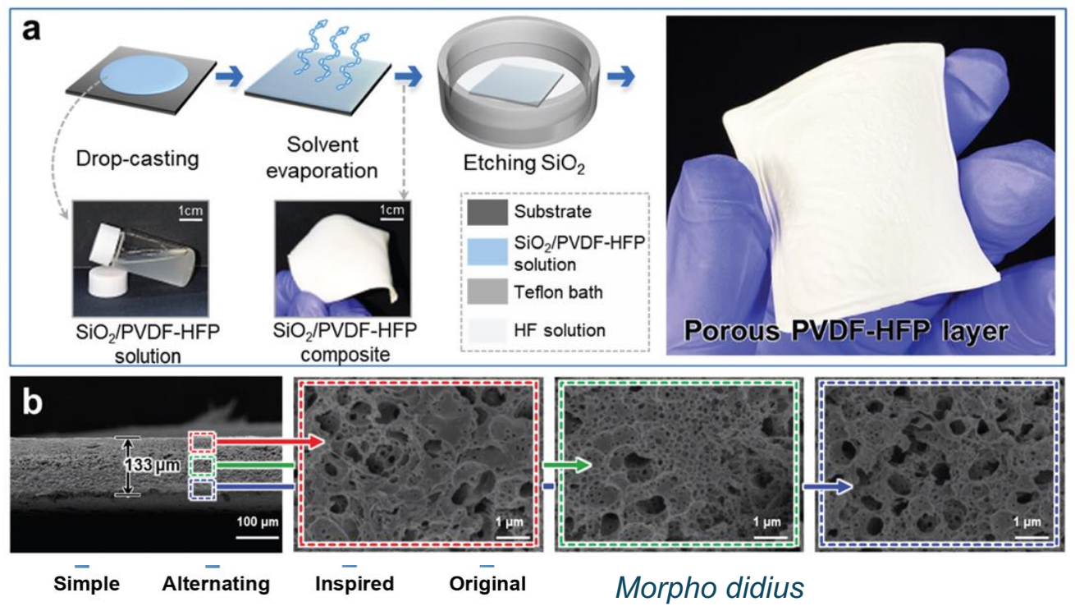
[picture p52: figure]
Morpho didius

Morpho didius is another case of biomimicry for structural colouring. This butterfly is widely known for its bright iridescent colouration. Similarly to the A. Demophon, the butterfly does not rely on pigments for its bright colour, but on the structural colouration nanostructures that manipulate and reflect the incoming light (Didari & Mengüç, 2018; Siddique et al., 2013). The wing scales of M. didius consist of these tree-like ridge structures, with a periodic arrangement of lamellae (Fig. 6). These structures act like multilayered reflectors, where variations in the refractive index between the layers cause the reflection of certain wavelengths, mostly in the blue region of the visible colour spectrum (450 - 495 nm) (Vukusic et al., 1999).

4 Interna=onal standardized colour space created for consistent colour representa=on.

Figure 7: A. The formation of the biomimetic film. B. The nanoporous structure of the man-made butterfly-inspired optical film.

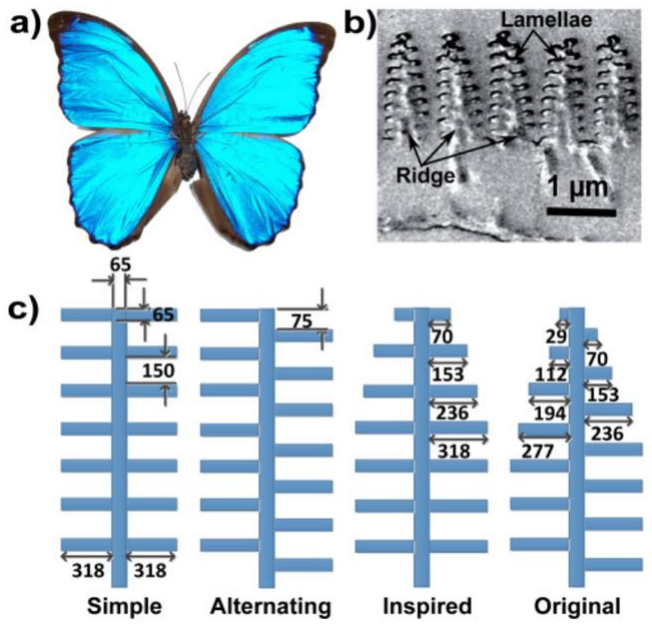
[picture p53: figure]

Next to the ordered structure of the lamellae, small irregularities within the wing and the tree-like structure diffuse reflection, which allows the colour to be visible from different angles (Didari & Mengüç, 2018). This combination of order and disorder in the wings provides both colour stability and selectivity for specific broadbands of the spectrum. In addition to the A. demophon model, this model demonstrates how these nanostructures can be optimized for specific light reflection, thus for specific colours and how to recreate them.

Silk worm fibre

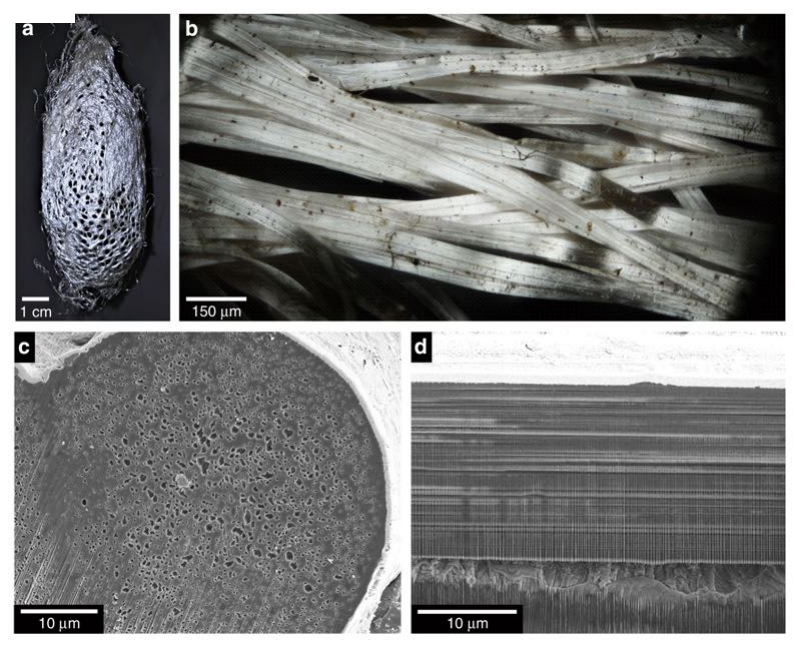
[picture p54: figure]

In nature, many other nano- and microstructures have evolved to enhance reflective properties. The silk worm, for example, constructs a cocoon made out of silk fibres to protect its pupae from the rapid temperature fluctuations and solar
radiation | from | the | environment,
allowing them to develop safely in the protective cocoon (J. Zhang et al., 2017). These cocoons can be 6-10 cm in length, and conduct optical properties that are unique from any other optical materials constructed in nature (Shi et al., 2018). The optical
properties from this material are a
result of the air voids inside of the
separate silk fibres, which have diameters similar to the wavelengths of visible and NIR light, thereby scattering incoming radiation and enhancing solar reflectance (Fig. 7). In addition, the open, randomly stacked nanofibrous network within the silk fibres, combined with the specific molecular bonds (N-H, C=O, C-O and C-O-C), maximize both the reflection of solar heat and the emission of excess thermal energy to the surrounding environment (Xiang et al., 2023). These chemical bonds exhibit strong vibrational absorption in the mid-infrared region: incident infrared radiation excites quantized stretching and bending modes of the bonds allowing them to efficiently absorb thermal energy at characteristic wavelengths. According

Figure 9: A. The silk worm cocoon, constructed out of silk fibres.
B. Image of individual silk fibres. C. Image of the air voids inside of the silk fibres that cause the solar rays to be reflected. D. Cross-section of silk fibre (Xiang et al., 2023).

Figure 8: A. Morpho didius butterfly. B. Electron microscopy image of the ridges and lamellae that provide the structural colouring. C. Simplified figure of the different configurations of the structural colouring that were tested in the paper (Siddique et al., 2013).

to Kirchhoff’s Law⁵, the absorbed energy is subsequently re-emitted as IR radiation, resulting in high MIR emissivity.
In Xiang et al. (2023), this randomly ordered nanostructure was recreated, and filaments of several nano- and microstructures were compared. In the paper, a series of procedures, including degumming, dialysis and electrostatic spinning create silk fibres which are also biodegradable. The average fibre diameter averaged from 320 nm to 2850 nm in these tests, and the silk fibres were randomly distributed and stacked on a membrane. The tests showed that loosely stacked nano fibres exhibited better daytime radiative cooling than more densely stacked micro-sized ones. Additionally, nano-sized fibres showed solar reflectance up to 96% (ρ = 0.96) and infrared immittance of up to 97% (εIR = 0.97). These optical properties led to a 6 °C decrease in surface temperature, even under high solar irradiance.

5 Kirchhoff’s Law states that a material’s emissivity (ελ) equals its (vibra=onal) absorp=vity (αλ) at thermal equilibrium. Experimentally, emissivity can therefore be obtained by accoun=ng for all incident solar radiated light. These contain the por=ons that are reflected, sca@ered (Mason et al., 2011)

## Radiative cooling

Radiative cooling is a mechanism that essentially uses the cold vacuum of outer space (3 Kelvin) as a massive heat sink. In the context of the Urban Heat Island (UHI) effect, where cities become significantly hotter than their rural surroundings due to the inability of heat to dissipate, employment of this mechanism shows potential. This cooling mechanism relies on two key principles of thermodynamics. First, Planck’s Law⁶ is relevant as it describes that every object at terrestrial temperatures (around 300 Kelvin) emit heat in the mid-infrared (MIR) spectrum (Fig. 8). The second principle is the atmospheric window, which is a wavelength interval (8-13 µm), where radiation emitted within this interval passes through the atmosphere into the cold vacuum of space. The atmospheric gases, like CO2 and water vapor, do not absorb this infrared radiation at this interval, which reduces the amount of heat that is trapped in the atmosphere.
The main challenge in obtaining passive radiative cooling is that it can only happen during the day, when sunlight is present. This is where two functions come into play: solar reflectivity and selective emissivity. In this section selective emissivity will be discussed.

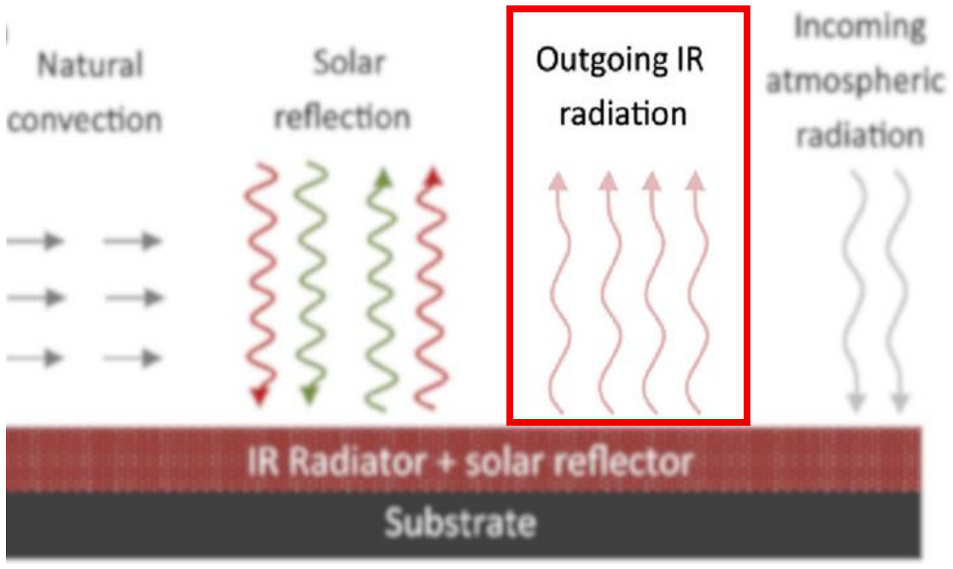
[picture p55: figure]

Selective and broadband radiators
A broadband radiator, like a blackbody, emits within the entire emission band of the atmosphere (Fig. 9), except for the main solar spectral band (AM1.5; from 300 nm to 2.5 µm) (Hossain & Gu, 2016). Broadband radiators are highly beneficial for above-ambient cooling (removing heat from objects that are already hotter than their environment), as their high emissivity across the entire infrared spectrum facilitates efficient radiative heat exchange with the ambient environment (Pirvaram et al., 2022).
To achieve temperatures below the surrounding air (sub-ambient cooling), a radiator must release heat as infrared (IR) radiation specifically through the atmospheric window, where

6 Planck’s law defines the spectral distribu=on of radia=on emi@ed by a blackbody as a func=on of temperature, showing that objects around 300k predominantly emit energy in the mid-infrared MIR range (Bose, 1994).

Figure 10: Schematic image of outgoing infrared radiation of a solar reflector.

the atmosphere allows it to escape into space. However, broadband radiators also emit heat outside of this window, where the atmosphere is opaque. In these wavelength regions, CO2 and water vapor in the atmosphere absorb the radiator’s heat and partially reflects it right back down (Hossain & Gu, 2016) This counteracts the cooling effect and prevents the broadband radiator from reaching temperatures significantly below the ambient temperature. By contrast, a selective radiator features high emissivity specifically within the 8-13 µm wavelength range and low emissivity everywhere else (Pirvaram et al., 2022). This selective property is critical for below-ambient cooling, as it maximizes the heat radiation into the cold vacuum of space, simultaneously minimizing the amount of radiation absorption and reflectance by the atmosphere.

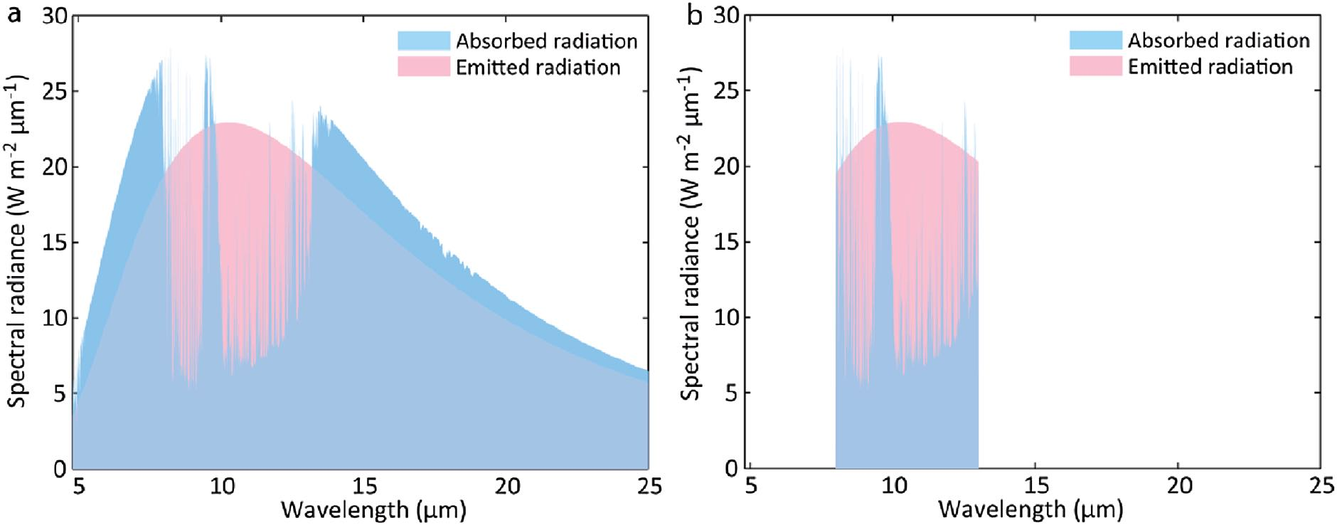
[picture p56: figure]

Figure 11: Comparison of absorbed atmospheric radiation and emitted thermal radiation for (a) broadband and (b) spectrally selective radiators, both operating at a temperature 16 °C below the ambient temperature (Tₐ) (Hossain & Gu, 2016).

### Commercial products utilizing radiative cooling (RC)

Below different commercial products will be discussed that employ radiative cooling on a surface.

Inorganic pigment paints
Traditional cooling paints have heavily relied on titanium dioxide (TiO2) due its high refractive index⁷ (n > 2.5). However, TiO2 inherently absorbs ultraviolet (UV) radiation, which limits its maximum solar reflectance to approximately 95% (ρ = 0.95) (Mandal et al., 2020b; Mishra et al., 2024). To surpass this limit, researchers have shifted to “wide-bandgap” dielectric materials (materials that become polarized when exposed to an electric field) like barium sulphate (BaSO4), aluminium oxide (Al2O3) and calcium carbonate (CaCO3). (Atiganyanun & Kumnorkaew, 2023; Dong et al., 2022). For instance, BaSO4-based acrylic paints can achieve an ultrahigh solar reflectance of 98.1% (ρ = 0.981) and high atmospheric window

7 A refrac=ve index (n) is a dimensionless quan=ty that describes how strongly a material slows down and bends (refracts) light compared to its speed in a vacuum. It is defined as the ra=o of the speed of light in vacuum to that in the material, with high values indica=ng stronger light sca@ering and reflec=on at interfaces (Born et al., 1999).

emissivity (ε = 0.89) yielding remarkable sub-ambient cooling even under direct sunlight, where a theoretical radiative cooling power at nighttime and daytime could reach 119.3 W m-2 and 94.3 W m⁻² (Dong et al., 2022). In textbox 1, the experimental setup for testing the cooling performance of a self-manufactured radiative cooling by Dong et al. (2022) is explained.

Textbox 1: Protocol Dong et al. (2022)
The outdoor cooling performance of the manufactured PDRC coating was evaluated using an experimental test system established on the rooftop of a laboratory building in Weihai, China. The characterization was based on maintaining an overall thermal balance across four distinct components: solar radiation absorption, atmospheric radiation absorption, heat dissipation to deep space via electromagnetic waves within the atmospheric transmission window, and parasitic heat losses caused by the temperature differential between the coating and the environment. The experimental apparatus consisted of a data logger, a laptop, a custom-designed test cavity, and an outdoor weather station. To minimize extraneous heat dissipation, the main body of the test cavity was constructed from polystyrene foam, with the exterior surfaces covered in aluminium foil to reflect incident solar radiation and the top aperture sealed with a transparent polyethylene (PE) film to suppress convective heat transfer. The PDRC coating was applied to an aluminium substrate with dimensions of 10 x 10 cm. Given the high thermal conductivity of the aluminium plate (237 W m⁻¹ K -1), a thermocouple was secured to the rear surface of the plate to record representative temperature variations. The cooling efficacy of the PDRC coating was demonstrated by comparing its temperature profile against both a commercial white coating and the air temperature within an empty control cavity over a continuous multi-day testing period. Furthermore, environmental variables including solar radiation intensity, relative humidity, and wind speed were monitored in real-time via the integrated weather station to correlate thermal performance with localized atmospheric conditions.

Porous polymer coatings
Polymers such as polyvinylidene fluoride (PVDF), poly(methyl methacrylate) (PMMA), and polydimethylsiloxane (PDMS) contain functional groups (e.g., C-O, C-F, Si-O) that naturally emit strongly in the mid-infrared (MIR) region (Guo et al., 2023). By introducing micro- and nano-scale air voids these polymers form sponge-like porous structures that strongly scatter and reflect sunlight without the need for metallic reflectors. These porous structures can achieve a solar reflectance of 96% (ρ = 0.96) and an IR emissivity of 97% (εIR = 0.97), thereby delivering a radiative cooling power of 93 W m⁻² (J. Liu et al., 2023a).

Bilayer and multilayer stacking
Coating performance can be further optimized by stacking layers with distinct optical properties. For example, a bouble-layer system consisting of a PVDF upper layer and a PDMS lower layer exploits the refractive index difference between the layers to enhance the backscattering of the solar spectrum, reaching 98% solar reflectance (ρ = 0.98) (F. Wang et al., 2024). Other bilayer configurations use a thick TiO2-PMMA base paint combined with a thin UV-reflective topcoat (such as BaSO4 with polyvinylideenfluoride (PVDF)) to overcome TIO2’s inherent UV absorption limitations (Altamimi et al., 2023).

Colored and fluorescent paints
Because brilliant white or silver coatings can cause severe glare and limit aesthetic architectural choices, coloured passive daytime radiative cooling (PDRC) paints have been developed. Bilayer coloured designs use a thin visible-absorbing top layer for coloration and a highly reflective underlayer to maximize NIR to SWIR (short wave infrared) reflection, significantly mitigating the heat typically absorbed by dark or coloured surfaces (Altamimi et al., 2023). Furthermore, embedding photoluminescent materials allows the coating to convert absorbed high-energy UV (visual light) into lower-energy fluorescence, thereby actively shedding heat as light rather than thermal energy (Liu et al., 2023).

Thermochromic coatings
To prevent the “winter penalty” of overcooling buildings during cold seasons, temperature-adaptive coatings utilize thermochromic materials; most notably vanadium dioxide (VO2) (Guo et al., 2023). VO2 undergoes a metal-insulator phase transition that changes its emission and absorption profiles based on the ambient temperature, passively switching the surface from a radiative cooling mode in the summer to a solar heating mode in the winter.

Superhydrophobic and self-cleaning coatings
In real-world environments, dirt, dust and rainwater can quickly degrade a coatings’ solar reflectance and PDRC’s performance (Fan et al., 2022). Applying superhydrophobic surface treatments (e.g. using PTFE composites, modified silica) imparts self-cleaning capabilities, allowing water droplets to easily roll off and carry away contaminants, which ensures long-lasting cooling efficiency of the coating (Fan et al., 2022; J. Liu et al., 2023b). This inspired by the lotus effect. This effect refers to the natural water-repellent properties of lotus leaves which arise from microscopic structures on their surface. These structures cause water to form droplets that roll off rather than adhere, preventing accumulation. As the droplets move across the surface, they pick up and remove dirt and other contaminants, resulting in a self-cleaning effect that maintains an optimal surface condition (Collins & Safiuddin, 2022).

Using structure to employ radiative cooling
This section examines the role of nano- and microstructures in facilitating radiative cooling, drawing on two biological models that are briefly introduced here (with further detail provided in the dedicated section on biological models). It then explores the biomimetic mechanisms inspired by these models.

Saharan silver ant
The Saharan silver ant forages in extreme desert environments, enduring surface temperatures up to 70 °C (Shi et al., 2015). In these extreme conditions the ant can cool its body temperature by utilizing a dense array of specialized, triangularly shaped hairs that cover the top and sides of its body. These hairs feature two corrugated top facets and a flat bottom facet facing the ant’s cuticle (Fig. 10). In the visible and NIR spectrum, where solar radiation peaks, this geometric shape significantly enhances solar reflectivity through Mie scattering and total internal reflection occurring at the flat bottom facets of the hairs. Concurrently, in the MIR range, the hair layer acts as a broadband antireflection coating that enhances the ant’s thermal emissivity. This dual-effect allows the ant to reflect intense solar heat while efficiently unloading its own excess body heat through the atmospheric window via radiative cooling (Shi et al., 2015).

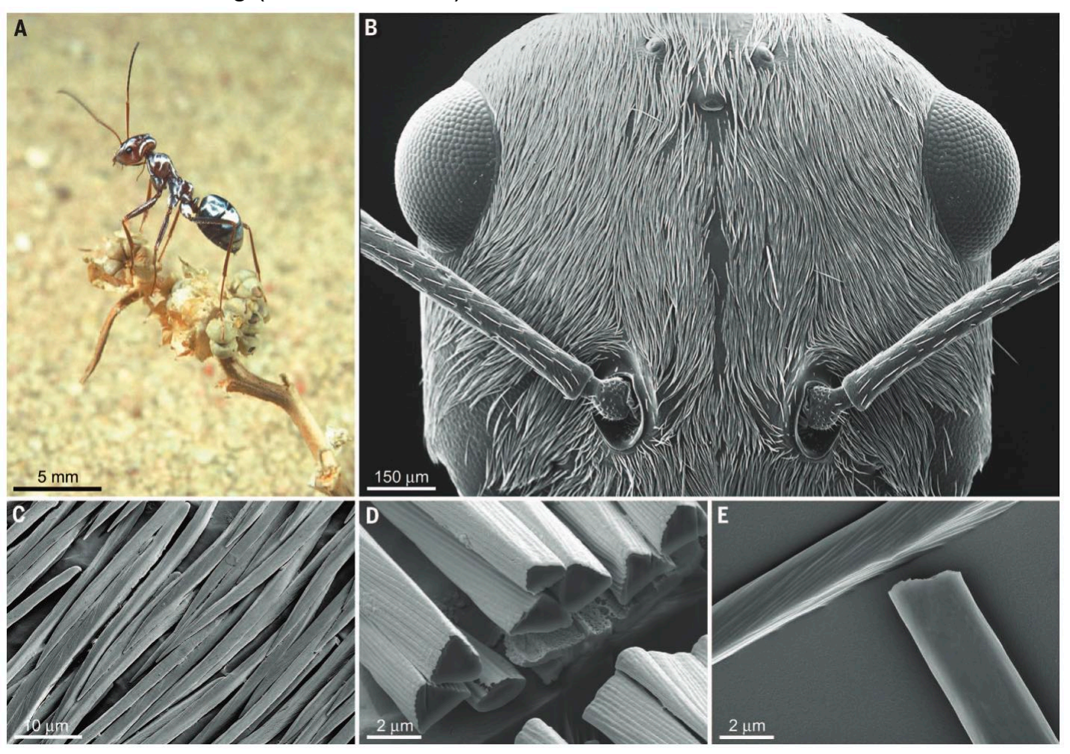
[picture p57: figure]

Figure 12: Image of the Saharan silver ant in its natural habitat. B. Scanning electron microscopy image of the head. C. SEM image of zoomed in hairs. D. FIB image where the triangular shape of the hairs is clearly visible. E. SEM image of two separate hairs (Shi et al., 2015).

Goliathus goliatus
The white beetle (Goliathus goliatus) survives high temperatures in equatorial forests by employing a unique shell/hollow cylinder structure within its dense epidermal scales (fig. 11) (Xie et al., 2019). The scales consist of an outer chitin cortex that encloses an interior packed with randomly distributed hollow cylinders and major air voids. This complex architecture achieves brilliant whiteness and broadband omnidirectional reflection in the visible spectrum.

The outer shell induces thin-film interferences for shorter wavelengths, while the internal hollow optimizes Mie resonance and total internal reflections for longer wavelengths. To facilitate heat dissipation, the scale arrays possess a sub microscopic nipple-like contour that provides a continuous refractive index gradient, acting as an antireflective layer that significantly enhances MIR emissivity and enables the beetle to passively radiate heat into the atmosphere (Xie et al., 2019).

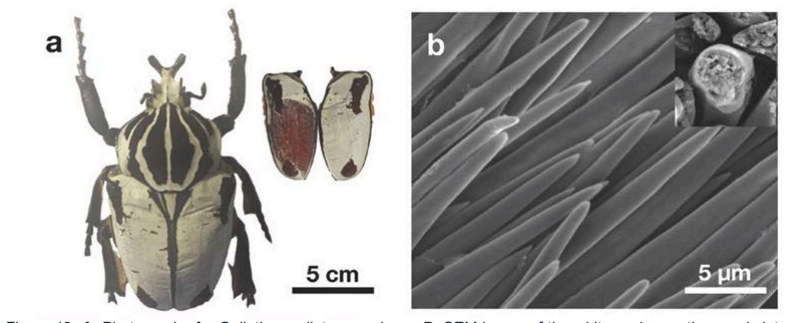
[picture p58: figure]

Figure 13: A. Photograph of a Goliathus goliatus specimen. B. SEM image of the white scales on the exoskeleton of the Goliathus goliatus (Xie et al., 2019).

## Convection

The phenomenon of convection is found throughout nature in either a forced or passive capacity. Particularly of interest is the way in which convection is utilised for cooling purposes that does not require the expenditure of energy so that it may inspire a similar mechanism in an urban setting.

Mechanism
Convection is broadly defined as the transfer of heat by movement, this occurs in a fluid such as water or air (Britannica, 2026). It is the combination of two key mechanisms: passive (diffusive) or active (advective). Passive convection refers to the natural behaviour of molecules at different temperatures. Most fluids⁸ expand when heated and thus become less dense, this means they become more buoyant and can rise in elevation. This can also happen in reverse, where the cooler molecules sink towards the ground. In the context of air, this is seen in hot air ballons, or the rising of moist air to form clouds in the sky. In an active convection context, the movement is forced by more than the buoyancy of the molecules themselves, but rather the pressure differences (or viscous entrainment (see Appendix C)) caused by factors such as wind in air, the running water of a river (imagine silt being pulled by the current of the water), or a powered mechanism such as an electric fan.

In the context of air and built structures, there are a few common effects seen when it comes to convection, one of them is the Venturi effect, which can be explained by Bernoulli’s principal (See Appendix C). The Venturi effect is the observed circulation of air in a system based on the air pressure differences; whereby warm air will move from an area of high pressure to an area of low pressure by diffusion (Design Buildings, 2022). We see examples of this when fast wind speeds up high can pull the air upwards from lower areas where the air is slow moving. In relation to this, the stack (or chimney) effect, is the passive convection of air in or around a structure that happens based only on the density (buoyancy) of the air molecules themselves (Design Buildings, 2022). Circulation of heat in air occurs due to this principle - the warm air travels up while the cool air sinks, often this is cyclical because the air cools as it gets higher with increase in density and a resultant sinking is then observed.

Measuring convection
Convection is measured by determining the difference in temperature between two points of a system such as between a fluid and a solid (e.g. a material and the air) (Newton’s Law of Cooling, 2026). The rate of heat transfer (Q) can be calculated by determining the temperature difference between the surface and the surrounding fluid (air) (T2-T1) multiplied

8 Gases in this context also behave like a fluid in terms of how heat moves around, as such the air around the material is also considered a fluid.

by the surface area (A) through which the heat is transferred and multiplied by the convective heat transfer coefficient (h). This is described in equation 3:
Q = hA(T2 − T1) | (3)

Looking at equation 3, we can deduce that there is a positive correlation between the rate of heat transfer and the other factors, whereby the higher the temperature difference, or the convection coefficient, or the surface area, the higher the rate of heat transfer. The convective heat transfer coefficient for air is usually around 1-10W/m².K for passive convection, or about 20-100 W/m².K for forced convection (Xiao et al., 2018). There are numerous factors that can affect convective heat transfer, such as geometry of the surface, properties of the fluid or solid (such as their thermal conductivity), as well as the fluid’s viscosity and velocity.

Methods of experimental testing
The rate of heat flux can be calculated using equation 3. Additionally, heat mapping of the façade can be performed using a thermal camera or thermometer to record temperature at different locations to locate hot and cold spots of the design, and changes over time influenced by convective heat movement. In a 1977 study on convection in cacti (Lewis & Nobel, 1977) the local convection coefficient was determined for each nodal level using a regression equation involving the measured change in wind speed with height. Additionally, the behaviour of airflow over designs can be observed using either an air flow mapper (clean room fogger), or by utilising computational fluid dynamics when a physical model is not possible.

Bio-Models
Looking at nature for examples of convection can be quite broad, as it is a mechanism that exists almost everywhere. When researching ways to optimise or utilise the mechanism for the benefit of cooling, there were some key examples that show promise. These are highlighted below.

Cycling air in wetland plants Wetlands plants that are tall and have hollow spaces, can utilise the flow of air and differences in pressure to passively cycle fresh and stagnant air throughout its system (Colmer, 2003). This occurs by the tall and broken stalks of the plant providing openings to the air up high, where the air is traveling at faster speeds. Meanwhile there are also broken stems down low where the air is not moving very fast. This pressure difference draws air into the lower open stalks whereby also forcing air out of the taller stalks. This process does not require any energy expenditure by the plant and is completely passive, all the while providing fresh and oxygen rich air to the lower areas of the plant such as the roots and living

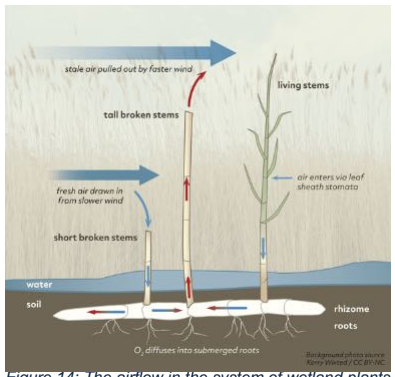
[picture p59: figure]

stems. (Colmer, 2003) (Fig. 12).

Asymmetric burrow openings

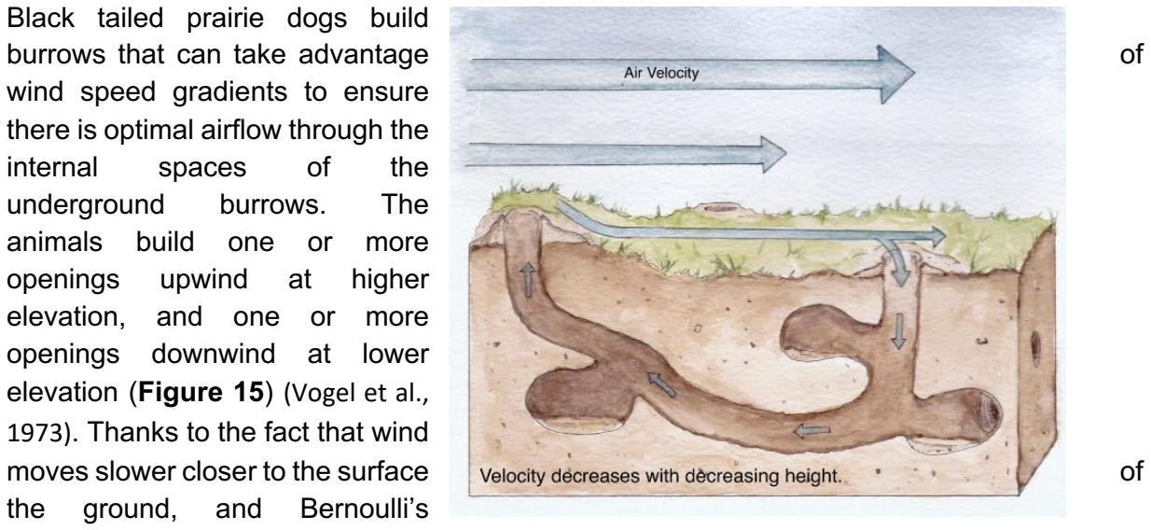
[picture p60: figure]
burrows that can take advantage; wind speed gradients to ensure there is optimal airflow through the; internal; spaces; the; underground; burrows.; The; animals build one or more; openings; upwind; higher; elevation, and one or more openings downwind at lower elevation (Figure 15) (Vogel et al., 1973). Thanks to the fact that wind; moves slower closer to the surface; ground,; and; Bernoulli’s

Black tailed prairie dogs build

principle, this results in a one-way | air
flow through the underground
tunnels. The air can rush out of the higher opening while being pulled into the lower opening, much like the wetland plants seen above.

Figure 14: The airflow in the system of wetland plants (How Wetland Plants Get Air to Waterlogged Roots, 2022)

Figure 15: Burrow openings and airflow (Asymmetric Burrow Openings Create Passive Ventilation, 2020)

Termite mounds
One of the more well-known bio models for passive cooling are termite mounds that are seen in warm environments around the world, such as Africa and Australia. Large cathedral termite mounds found in the savanna house the best examples of convective cooling (Korb & Linsenmair, 2000). Convection occurs thanks to contrasting temperature differences (between the outside ambient air, the internal spaces, and the thinner walls of the mound) and the dissipation tendencies of the warmer air molecules as described earlier. The tendency of this mechanism to work better on larger mounds is also due to the role the sun plays in heating the outer faces of the mound, providing a larger temperature gradient, thus increasing the rate of convection (Korb & Linsenmair, 2000).

In terms of design, termite mounds can either be open at the top with openings at the base of the mound (an “open chimney mound” where mounds can allow warm air to naturally rise to the top of the mound, while cool air near the base is drawn inside) or completely closed at the top, but with porous walls (“capped chimney mounds”) that allow the air exchange to occur all over the mound’s surface via small inlets (Fig. 14) (Turner & Soar, 2008). They can also be likened to a human lung, in that the convection methods used are a mix of small-scale diffusion and larger scale, forced (wind) convection as well (see appendix C). Termite mounds can also reduce unwanted convection in areas of the mound thanks to bumps and dimples to trap air on the surface, acting essentially as insulation. With all these factors in mind, termite mounds are a complicated thermoregulatory system, with a multitude of interacting mechanisms at play.

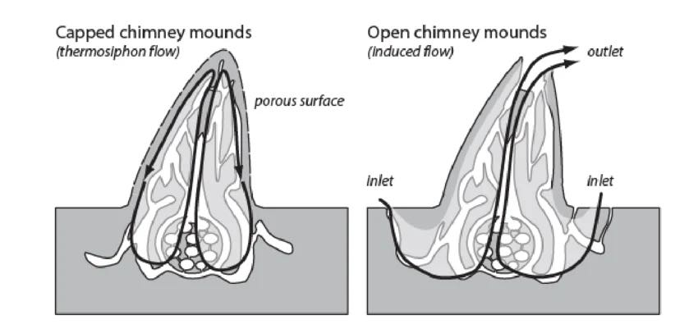
[picture p61: figure]

From what has been discussed, we can say that for a large structure, convection certainly plays a role but will not be the only driver of heat dissipation because both the solar and wind driven enhancing factors can be variable throughout the day and seasons. Therefore, the diversity of mechanisms in fact works in favour of thermoregulation in this instance. Additionally, thanks to the prevalence of these structures, easily available research and

Figure 16: Different types of termite mounds (Turner & Soar, 2008).

recent history in human-made structures, we can see current realisations of this bio-model in the construction industry in such buildings as the well-known Eastgate building in Zimbabwe by the architect Mick Pearce in 1996, and the common stack effect seen in architecture.

As a fascinating, additional mechanism, Turner and Soar (2008) also highlight the ability of some termite mounds to make use of resonant frequencies (a mound is usually between 20-30Hz) that are attuned to that of turbulent winds (10-100Hz) which, if achieved, can activate the mixing of air inside the mound, promoting gas exchange at a small scale.
Cacti
The mascot for warm environments is often the cactus, with its sharp spines and ribs. These surface qualities allow the cactus to maintain optimal temperature despite the harsh environment. Vertical ribs on the body of a cactus allow for surface shading, increased surface area to dissipate heat, and increase turbulence to enhance convective heat removal (Lewis & Nobel, 1977). The troughs of the ribs are shaded and thus cooler, allowing for more heat to be drawn out from the body of the cactus, which is turn rises towards the peaks where it can waft away (Fig. 15). Lewis & Nobel (1977) also note that with the ribs present, the convection coefficient is 44% higher than its theoretical smooth counterpart. Noting as well, that the warmer tip of a rib is 3-fold higher in convective coefficient than the cooler trough. In this assessment, the ribs can be morphologically described: rib depth ~1.9 cm; diameter of cactus at mid-height 26 cm; number of ribs 26 (see additional information in Appendix C). Additionally, they can be spaced differently on different sides of the cactus (e.g. closer together on the southwest side) for different temperature regulations based on the orientation to the sun (Lewis & Nobel, 1977).

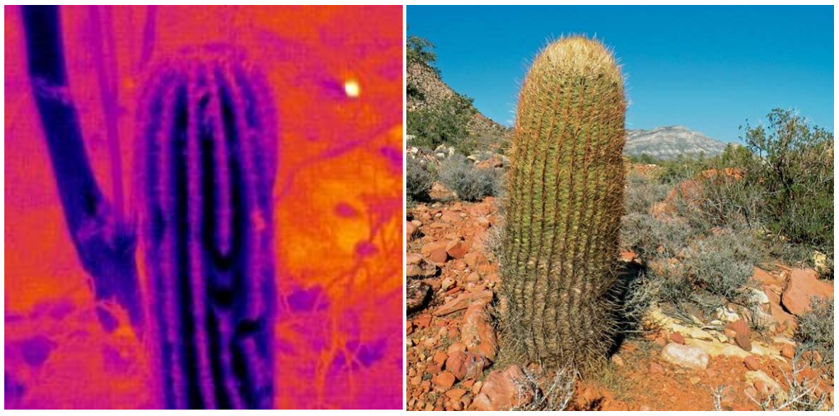
[picture p62: figure]

In species such as the barrel cactus, spines serve multiple functions: they hold back predators, collect moisture and reduce convective heat loss on the plant’s surface. Without these spines,

Figure 17: Thermal image of a cactus from Cactus Ribs Keep Them Cool, 2017; a barrel cactus photographed in
Nevada (Marketa Mark, n.d.).

the convection coefficient is 13% higher, meaning that the spined reduce convection along the surface of the plant (Lewis & Nobel, 1977). The presence of spines reduces h (heat transfer coefficient), increasing the thickness of the air boundary layer of the cactus. The barrel cactus has a higher density of spines at the apex to make for more shading and effectively eliminating convective air transport. However, lower on the cactus there is less density of the spines and wider spacing of the ribs, which does allow for convective heat transfer. In studies of barrel cacti with spines, reduced daytime temp by 2-6 °C were observed (compared to without). These spines were 1-2 cm long and shades ~62% of the surface of the cactus (for the mammillaria species) (Nobel, 1978). Therefore, it is generally concluded that the spines’ role in cooling is primarily based on shading from shortwave irradiation and reducing the outgoing net longwave radiation during the night (Lewis & Nobel, 1977). There is, however, very little empirical research on the topic of cactus and spines for the purpose of thermal regulation. Many of the other papers on this topic refer to these two key papers mentioned so far, so it is important to keep this in mind. However, there have been buildings designed after this bio-model since then, which take advantage of increased surface area and jutting shade structures like spines, for example the well-known Eastgate building in Zimbabwe with concrete “teeth” aiding in cooling the external air by 3°C (Eastgate Building Harare, z.d.).

## Conduction

Conduction is the transfer of heat within a material from one molecule to the other, without the movement of molecules themselves. In metals, which are generally among the most conductive materials, the energy is transferred mostly by free electrons in the material, but phonons are also efficient carriers of energy between the molecules of a material, especially in non-metals (Dincer & Siddiqui, 2018). Other material properties making a material highly conductive are an ordered crystal structure, tight packing off atoms and strong bonding between atoms (Dincer & Siddiqui, 2018). To reduce a building’s energy consumption by limiting heat gain from warm outdoor air and solar radiation, an effective strategy is to minimize heat conduction by selecting a material with low thermal conductivity.
Air has a low thermal conductivity, making it essential for insulation in the construction sector. In fact, without the conductive properties of air, almost all conventional insulation materials would fail (Juanicó & González, 2017). Wool, rock/ glass wool, fiberglass, EPS, and even biobased materials, including straw or mycelium materials all rely on air pockets within to material to prevent heat being conducted through the material.
With the panel, the aim is to achieve more than just insulation and cooling down the building. Therefore, relying solely on low-conductivity materials is not sufficient. Unlike the other mechanisms, conduction does not remove heat from the façade, as the net thermal energy of the object stays the same. However, by adjusting the thermal conductivity of the materials, it is possible to influence how the heat is distributed through the façade, which in turn affects where and how it can be released. An example of the use of conductivity to increase infrared emissivity, is the usage of graphene on top, or directly under, the surface of a façade. Graphene is highly conductive along the plane of the coating, but less conductive through the plane (Fig. 16) (Song et al., 2025).

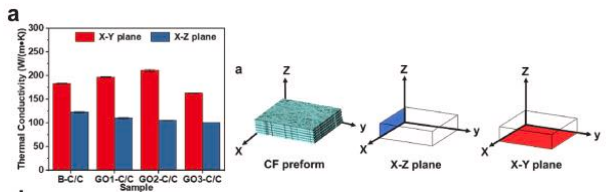
[picture p63: figure]

Figure 18: Demonstration of conductivity differences along and through a graphene sheet from (Song et al., 2025).
This means that heat can easily dissipate along the surface but not enter the core of the material. This results in the heat being concentrated at the surface, meaning the emissivity at the surface is increased. The biocompatibility and biodegradability of graphene based materials varies based on number and size of graphene layers. In many biomedical applications the material has been found to be non-hazardous, but that does not mean it is a biobased and easily degradable material (Chiticaru & Ionita, 2022).

Alternatively, to heat dissipation, it is also possible to concentrate heat at a few local hot spots, by guiding the heat flux within a material. This can be done by using so called metamaterials, usually composite materials consisting of a highly conductive material, usually a metal, and an insulative material. This allows heat to be conducted unevenly, creating local temperature differences and hotspots (Arepolage et al., 2024). Furthermore, the reliance on highly conductive materials, like metals, which need to be intricately integrated into the material, means that the entire material will not be biodegradable.

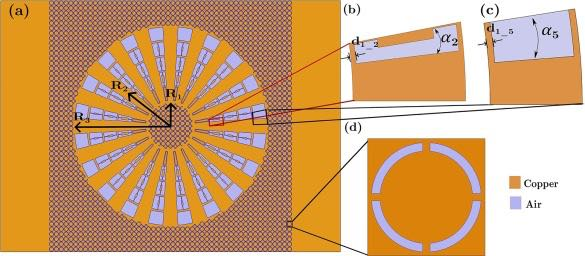
[picture p64: figure]

Figure 19: Two- dimensional design of the heat concentrator, from: (Arepolage et al., 2024).
Figures 17 and 18 demonstrate the design and resulting heat flow of a possible thermal concentrator. Because highly conductive metal components of the material point towards the centre, the heat also moves faster into the centre of the circle relatively to how it moves through the rest of the material (Arepolage et al., 2024). As the direction of heat flow cannot be changed, it also moves more easily away from the centre, which is the reason that the dark blue area is also distorted towards the centre. Nonetheless the arrangement leads to local temperature differences inside the circle even at equal distance to the heat source. Next to the possible application in radiative cooling, heat concentrators could be useful in facilitating convective cooling. As in the example of the biological model, the barrel cactus, convective airflows are shaped largely by temperature differences in the air immediately surrounding the material (Laver et al., 2008). These differences could be created if parts of the material are naturally hotter than its surroundings, as these areas would naturally emit more heat to the surrounding air layers, which creates temperature differences along the material, facilitating airflow. In the example of the barrel cactus having enhanced the relative temperature difference between the ridges and groves, by steering conductive heat flow towards the already hotter ridges, could increase the speed of

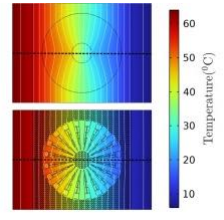
[picture p65: figure]

Figure 20: Heat distribution after heat source is applied on the left side, from: (Arepolage et al., 2024).

convective airflow around the cactus and remove even more heat from the material. To do so a simple design of spacing vertically oriented metal rods on the ridge part separated by non-conductive groves can already achieve this function. If the metal rods absorb more solar energy than the groves the heat will be dissipated mostly via the conductive material, so mostly vertically, meaning the temperature difference between ridges and grove remains. This difference in absorption is achieved by the same self-shading principle as in the cactus and can be enhanced further by using a reflective coating in the groves and absorptive material for the ridges. As long as parts of the material are exposed to solar radiation this effect would work even on parts of the panel where sunlight does not directly reach as the heat will reach these parts via conduction through the metal rod.

## Evaporative cooling

Evaporative cooling is a very effective cooling mechanism that can be used on the facades of buildings. At normal building temperatures evaporating 1 kg water results in the removal of 2,450kJ of energy, meaning that 2000 m³ air can be cooled by 1 degree from just the evaporation of one kg water (Santamouris, 2019). In real life simple evaporative cooling walls, such as walls using porous bricks can achieve temperature reductions of 1.45°C in hot humid regions (L. Li et al., 2025a). Evaporative cooling is also believed to be the main contributor to the cooling effect that green walls have (Kapilan et al., 2023). However, the dependence on water creates design problems which often jeopardize the feasibility of evaporative cooling facades. The first challenge is to obtain the water that can evaporate from the wall. In regions with high rainfall, this can be achieved by relying solely on rainwater, however that means the panels will not cool after extended periods without rain (L. Li et al., 2025b). Alternatively, water can be purposely added with irrigation mechanisms to the wall, however this method is not passive and consumes water and energy. A work around would be to use irrigation from sources that already leak water, like condensed water from air conditioning units, or other types of greywaters that form in the building. A third option to source water is to use groundwater, which can be transported upwards, without the use of external energy, thanks to the physical effect of capillary action. With the pull created from evaporation porous materials with very small pore sizes could transport water 10 meters above the ground, without energy input (Holbrook & Zwieniecki, 2008).
Another downside of evaporative cooling is that the inevitable exposure to water can drastically shorten the lifespan of the panel, especially if it is produced from a biodegradable material. Biodegradation would be more likely to already occur during use of the product if it is continuously exposed to water (Soh et al., 2025b). Coatings can be applied to mitigate this, however, they might then reduce the materials capability to take up water and would make the panel less biodegradable, if they are not also sourced from a biodegradable material. Hydrophobic coatings would also drastically reduce the water holding capacity of the material, which would then reduce evaporative cooling of the façade.
Existing bioinspired applications of evaporative cooling include elephant skin inspired tiles. Cracks on elephant skin increase the amount of water that can be held on a surface. Elephants bathe daily if they have access to water and if not usually cover themselves in cooling mud, which means evaporative cooling regulates their body temperature throughout the entire day (Martins et al., 2018). A research team from Nanyang Technological University, Singapore used this inspiration to create Mycelium based façade tiles, which, like the biological inspiration, can store five to tenfold more water than a flat surface could (Fig. 19) (Soh et al., 2025a). Nonetheless, despite applying a waterproof coating made from beeswax these biobased tiles still face the problem of biodegradation during exposure to outside weather conditions.

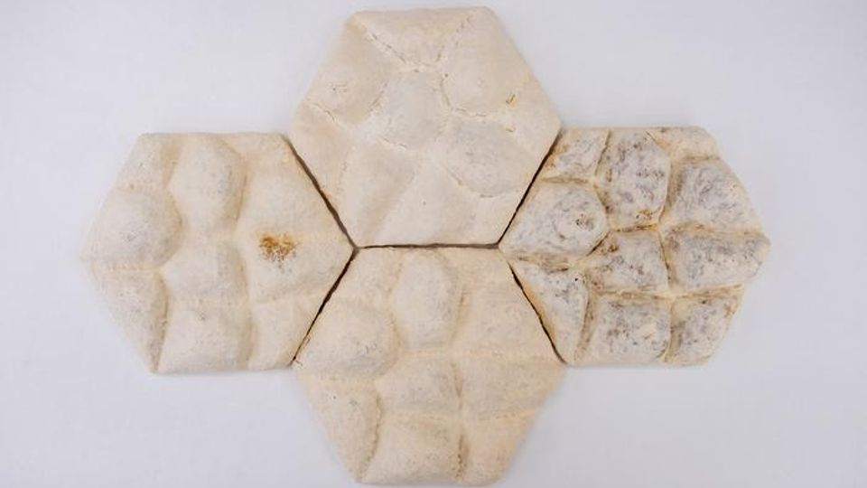
[picture p66: figure]

Figure 21: Elephant tiles by Nanyang Technological University to increase water holding capacity (Soh et al., 2025).
Another biological model that has not yet been applied in a bioinspired context is that of ants, which release bursts of water mist that evaporate almost instantly, since the tiny water droplets in air together have a much higher total surface area than just a flat surface could have. Mist driven evaporative cooling has already been tested and utilized as a possible strategy to mitigate urban heat. A study conducted in Italy showed a reduction of outside temperature surrounding the mist by as much as 7.4°C (Ulpiani et al., 2020). However, these systems are not passive as they require water to be squeezed through a small nozzle at high pressures to create the mist. While it is possible to generate pressure without additional energy supply, e.g. via air expanding when heated in a closed space, this would require a highly complex control mechanism, which would be too difficult to install in a simple façade panel. In general mist formation and droplet size are determined by the nozzle size and the pressure and speed at which water is ejected (Ulpiani et al., 2020).

## Possible integrations

In practice for the façade panel, these passive cooling mechanisms will not operate on their own, but rather as one connected system where different heat transfer mechanisms will work together to passively cool the façades of buildings. The effectiveness of the panel will therefore depend on the intertwined function of reflection, radiative cooling, convection, conduction and optionally evaporation into a coherent design.

The most obvious interaction between the mechanisms lies in the link between reflection and radiative cooling. As explained in this report, radiative cooling consists of the reflective properties, as well as the infrared emissive properties of a surface. High solar reflectance (ρ) reduces the heat gain of a surface during initial contact with the solar rays, while the thermal emissivity (ε), mostly in the 8-13 µm atmospheric window, enables the heat dissipation to the sky. These two functions should be optimized simultaneously, and several coatings and materials were named in this mini report that could be used. The bio-inspired options, like the
A. demophon inspired coating could prove to be efficient but might be hard to acquire or to recreate. Additionally, spectrally selective coatings could be used in this context as they reflect strongly over the whole solar spectrum, as well as emit in the mid-infrared range. Lastly, a retro-reflective coating could be applied, but its performance in the mid-infrared range must also be evaluated. A possible approach would be to test these three coatings against each other to determine whether the bio-inspired option performs the best.

Conduction can control heat distribution within the material and facade while it’s heating up. This mechanism creates the necessary conditions to carry heat away from the panel and the building, by distributing thermal energy within the material. Moreover, if we were to increase the heat dissipation over the surface of the material and limit the dissipation through the material (with graphene for example) this could result in a concentration of heat at the surface, meaning that the heat emissivity at the surface is increased as well, allowing for the heat to leave the building. Convection can further add to this mechanism by moving the heat that is conducted through the material into the cavity of the panel and dispersing it into the surrounding air.

Key to utilizing the mechanism of convection is increasing the material surface area or increasing the temperature gradient - promoting the heat flux away from the material and the building. Airflow should also be encouraged rather than restricted to prevent the heat from being trapped on the surface of the building. The efficiency of this mechanism will be influenced strongly by the geometry of the panel. Textured and corrugated surfaces, inspired by the biological model of the cactus and the earlier prototypes from the client, can increase surface area, create local temperature gradients and enhance the airflow and turbulence and thus enhance the convective air removal when the inside of the panel gets hot by conduction. Additionally, the macro-structure of the panel, inspired by the design challenge years ago by the biological model of bark, promotes airflow through the chimney effect and additional shading. These channels and cavities function in the same way as they do in the biological models of the termite mound and the prairie dog burrows, where the natural, buoyancy-driven convection can also be enhanced by wind. Geometry that allows for shading can also be helpful to reduce the building temperatures. In addition, the incorporation of wind to encourage more active transport of heat away from the building will be beneficial. Without this, there will still be a small amount of passive convection, based on the temperature gradients mentioned. Current designs seen in the built environments provide many possible examples and inspirations, such as the Eastgate building, solar chimneys in architecture, and the façade design seen in Appendix C by Laver et al. (2008).

Lastly, evaporation has been proven to be an effective strategy to cool buildings and the environment, both with green walls and roofs, as well as transpiring bricks and mist-driven evaporative cooling. However, all these strategies require some type of active mechanism, or active storage of water, which leaves evaporation out of scope for this project. Investigating how mist evaporative cooling can be integrated into a façade panel can nonetheless pose an interesting research question for future research. For our panel the technological restraints around water supply to the panel and the challenges around waterproofing the material, while purposely exposing it to water led us to choose against incorporating evaporative cooling in our design.

## Conclusion

The heat transfer mechanisms are highly interdependent. From a design perspective, it will be important to focus on multi-scale integration of all the mechanisms into one panel. At the micro- and nanoscale, coating composition, (structural) colour and structure determine the solar reflectance and infrared emissivity. The biological models of the Archaeoprepona demophon, Silk worm and Saharan silver ant seem most promising for the application of possible bio-inspiration into our panel. At the macroscale, panel composition and geometry cause convective airflow, heat exchange with the environment, and insulation of the façade. For most efficient convection, the biological models of the prairie dog burrows and termite mounds should be further analysed. Additionally, the application of cacti-like spikes to the surface of the existing panel could be investigated to improve convective airflow and shading. A successful passive cooling panel should therefore be designed using a holistic approach, in which material selection, structural design, and interaction with the environment are optimized harmoniously. The façade design should work together with existing relationships in urban context, such as using materials that are locally accessible and sustainable; make the city more liveable for humans, wildlife, and plant species; reduce the energy demand of the city by enabling passive thermoregulation; and enhance other cooling strategies such as increasing the airflow from green spaces thanks to increased convection capabilities, enabling the city to function as a resilient interconnected system.

For the façade panel in this project, these are the requirements for a holistic, hybrid design, combining all the heat exchange mechanisms:
- High solar and NIR reflection, together with a MIR emissivity coating or outer layer (reflection + radiative cooling)

- Controlled (and steered) thermal conductivity to guide heat towards heat dissipative structure (conduction)
- Surface geometry structures that enhance the heat transporting airflow and shading of the façade (convection)

By integrating these principles, the façade can function as a passive, adapting, cooling interface, minimizing the heat gain, maximizing the reflection, and removing the trapped heat out of the urban canyons, aiding passive mitigation of the Urban Heat Island effect.

Appendix A.
Photographs of the original façade panel designs which are to be improved upon based on this research.

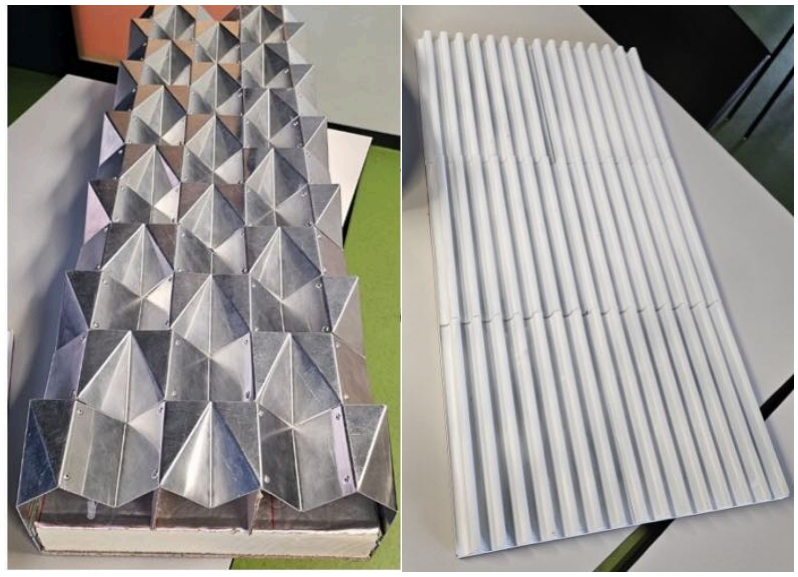
[picture p67: figure]

Appendix B.

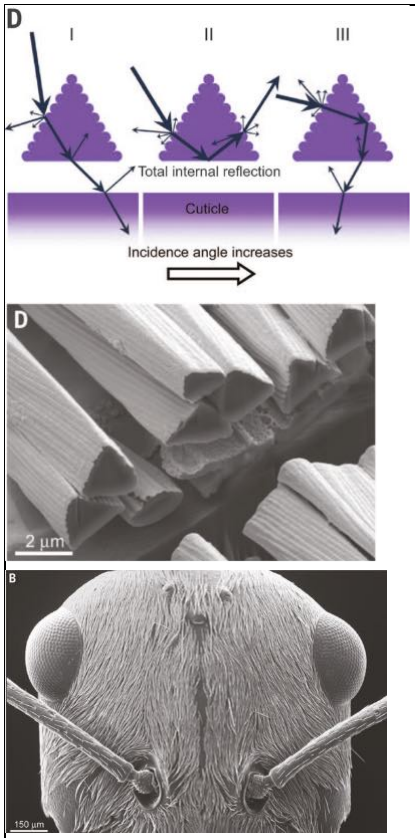
[picture p68: figure]

Triangular hairs in saharian silver ant and the solar reflection.

Mechanism
The dorsal and lateral sides of the Saharan silver ant (Cataglyphis bombycina) are covered in a dense array of hairs that gradually taper off at the tips and are locally aligned in the same direction.
These | hairs possess a | highly | specialized
triangular cross-section characterized by two corrugated top facets and a flat bottom facet facing the ant's body. This unique structural geometry protects the ant from overheating through three physical mechanisms:
- Visible and Near-Infrared (NIR) reflectivity: The triangular hairs act as a highly reflective coating against solar radiation. This is achieved through Mie scattering, where light gets trapped within the hairs and reradiates out in all directions, combined with total internal reflection occurring at the flat bottom facets of the hairs.
- Mid-Infrared (MIR) emissivity: The hair cover significantly enhances the ant's thermal emissivity in the MIR range. At wavelengths much larger than the hair dimensions, the hair structure acts as a gradient refractive index layer, giving the surface broadband, antireflective properties that allow the ant to efficiently offload excess heat back to its environment via blackbody radiation.
- Reduced absorption from the ground: The bottom surface of the ant is completely bare, which effectively reduces the radiative energy transfer between the hot desert sand and the ant, reflecting MIR radiation from the ground better than a hair-covered
| surface would.
Function | Strategy
Maintain a lower steady-state body temperature and prevent overheating beyond the ant's critical thermal maximum (53.6°C) while foraging in extreme desert temperatures. | Use precisely shaped micro-structural features (triangular hairs) to simultaneously reduce solar heat absorption and maximize the dissipation of excess body heat to the surrounding environment.

Design principles
A surface-integrated micro-structure composed of dense, triangularly shaped elements featuring corrugated upper facets and flat bottom facets can passively cool an object. This is achieved by maximizing visible and near-infrared optical reflection through Mie scattering and total internal reflection, while simultaneously acting as an antireflection layer that enhances mid-infrared thermal emissivity for highly efficient radiative heat dissipation.

Mechanism
The elytra (wing covers) of the white beetle (Goliathus goliatus) are covered in dense scales that feature a shell/hollow cylinder structure, consisting of an exterior chitin shell and an interior of packed hollow cylinders (air pockets). This specialized micro-structure protects the beetle from overheating via two mechanisms:
- Broadband omnidirectional light reflection
The scales significantly enhance reflection and minimize the absorption of solar energy (of wavelengths in the visible spectrum). High reflection of short wavelengths is achieved by the
exterior | shell | through thin-film
interference. The interior system of hollow cylinders enhances the reflection of longer
wavelengths | | through Mie
scattering (resonance).
- Mid-infrared (MIR) emissivity
The scale array significantly increases the thermal emissivity of the elytra in the MIR range. The exterior layer of shell arrays consist of a submicroscopic nipple-like contour that acts as a continuous refractive index that allows the beetle to dissipate excess heat to the cooler outer space via passive radiative cooling.

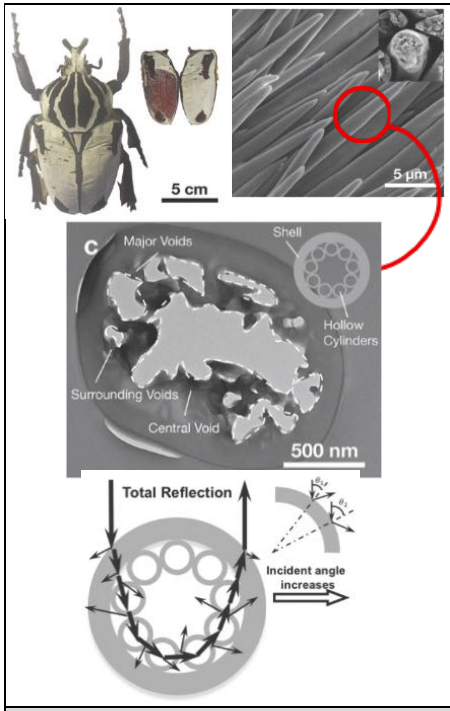
[picture p69: figure]

Function | Strategy
Maintain a lower equilibrium body temperature and prevent overheating (reducing temperature by up to 7.8 °C in air) while resting exposed to direct sunlight in high-temperature equatorial forests. | Use a specifically optimized shell/hollow cylinder micro-structure to simultaneously minimize solar energy absorption and maximize the radiation of excess body heat to the surrounding environment (passive radiative cooling).

Design principles
A surface-integrated dual functional microstructure composed of an outer thin-film shell and an interior array of hollow cylinders that can passively cool an object. This is achieved by combining the mechanisms of thin-film interference, Mie resonance and total internal reflection to maximize visible light reflection. This while simultaneously acting as an antireflective gradient-index layer that enhances MIR emissivity for highly efficient radiative heat dissipation.

Appendix C.
Relevant terms & principles (and other points of interest)
- Advection/advective transport: transfer of heat or matter by the flow of a fluid (esp. horizontally). E.g. flow of water in a river taking silt along the riverbed. Essentially another term for viscous entrainment.
- Diffusion (molecular): movement of particles from high concentration to low concentration.
- Viscous entrainment: the process where a moving viscous fluid or solid surface drags, traps, and transports surrounding fluid (usually gas) along with it. Used in leaf cutter ant nests (air moving outside pulls the still air of the nest along with it = ventilation) (Design Buildings, 2022).
- Bernoulli’s principle is a general principle of fluid dynamics based on the theory of conservation of energy, whereby an increase in pressure will mean a decrease in speed of a fluid (and vice versa) à it is that increased pressure = decreased speed and vice versa. Bernoulli’s equation
∆P = − $
% pV% | (4)
(Armstrong et al., 1992)
- Venturi effect is the demonstration of bernoulli’s principle physically.
- The stack effect (aka chimney effect) the use of convection in a building setting; making use of the differences in temperature and density of air in/outside of buildings, whereby hot air wants to rise and escape (Design Buildings, 2022).
- The Nusselt number (Nu) is defined as the ratio between convective and conduction heat transfer, indicating the efficiency of heat transfer in a fluid.
- Bonus mechanism: Resonant Acoustic Mixing (biomodel = termite mounds). The resonant frequency of a space can cause the air particles to mix quite thoroughly. Termites use this with the resonant frequency of their mound, to mix stagnant air. Could we make a panel like a flute that makes the frequency when the wind goes through it?
- Phase change materials (PCMs). Substances that absorb and release high amounts of latent heat during phase transition (usually freezing and melting) to provide thermal management. E.g. when it’s hot the material melts and stores energy, when it’s cold it then freezes and releases that energy to the microenvironment (material example is wax).

Other convection considerations

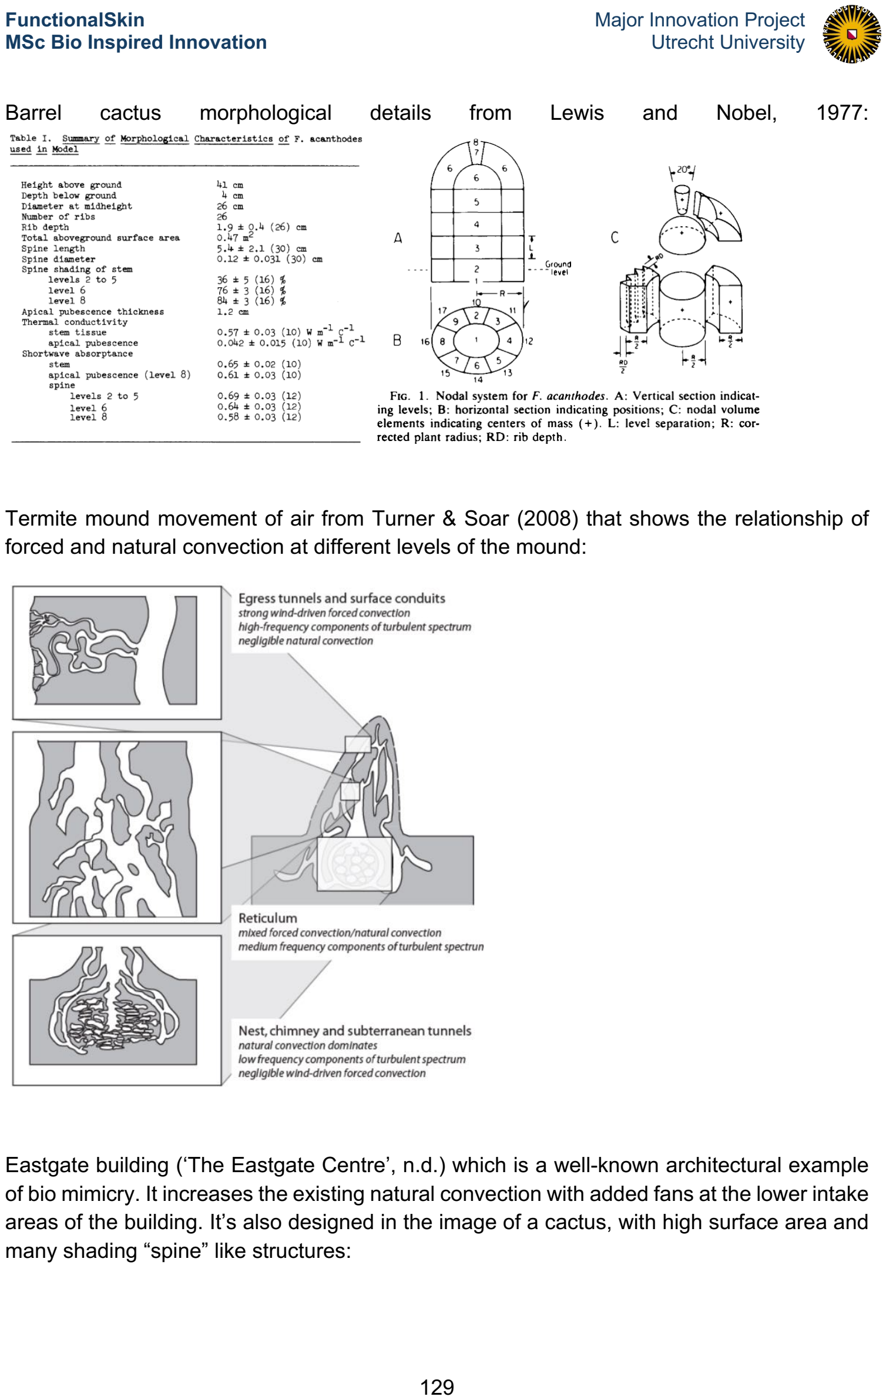
[picture p70: page 130]

Barrel | cactus | morphological | details | from | Lewis | and | Nobel, | 1977:

Termite mound movement of air from Turner & Soar (2008) that shows the relationship of forced and natural convection at different levels of the mound:

Eastgate building (‘The Eastgate Centre’, n.d.) which is a well-known architectural example of bio mimicry. It increases the existing natural convection with added fans at the lower intake areas of the building. It’s also designed in the image of a cactus, with high surface area and many shading “spine” like structures:

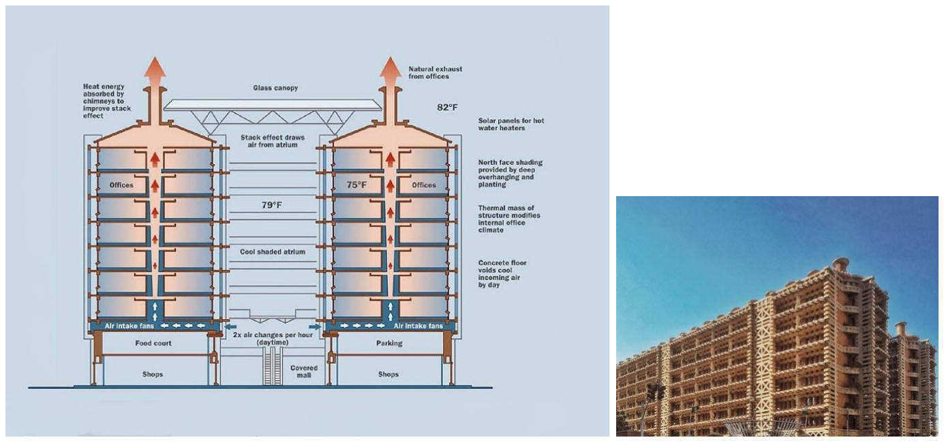
[picture p71: figure]

Stack effect can also be reversed in summer due to difference in pressure (based on ventilation design of the whole building, not just the facade) (Kocaman, 2025). Interesting detail to note is the neutral pressure plane of the building which is an especially relevant characteristic of tall buildings. Above and below this plane is the different pressure (positive or negative) whereby air always wants to travel to the low pressure side due to diffusion. Generally speaking, the area of high pressure is the warmer area because of the accumulation of air from the mentioned diffusion:

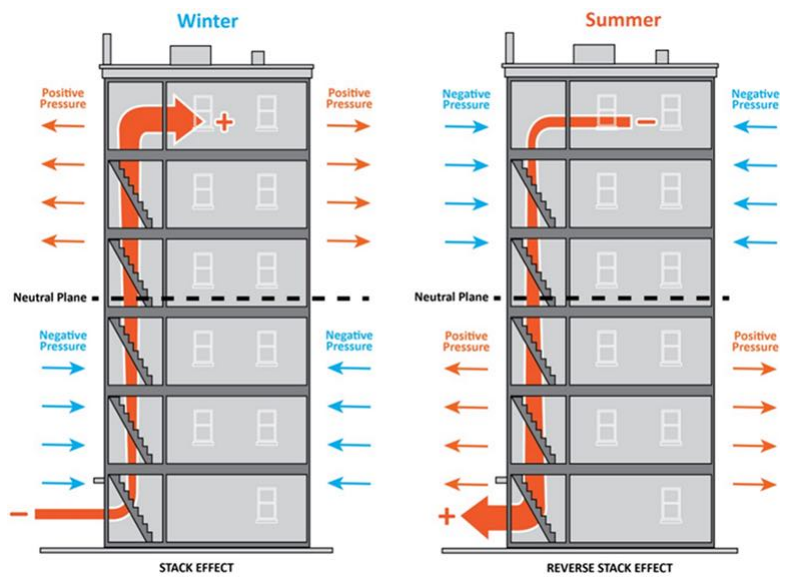
[picture p72: figure]

Other interesting designs
Modular and biophilic design from Laver et al., (2008) which incorporates both shading and air inlets:

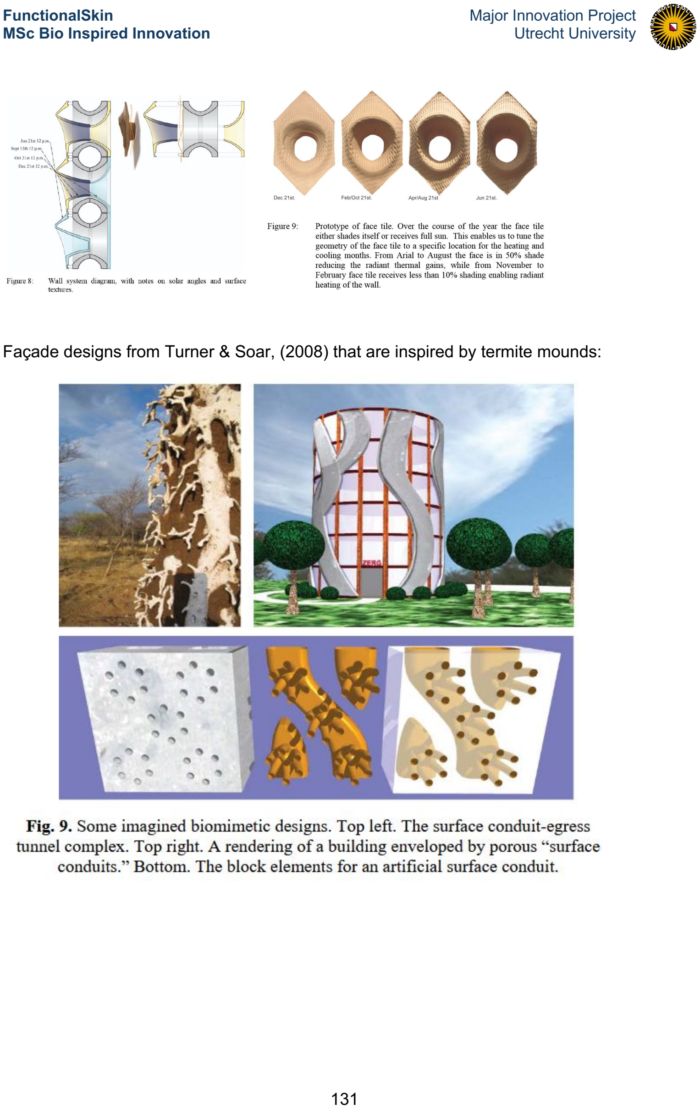
[picture p73: page 132]

Façade designs from Turner & Soar, (2008) that are inspired by termite mounds:

# Material selection: façade cooling panel

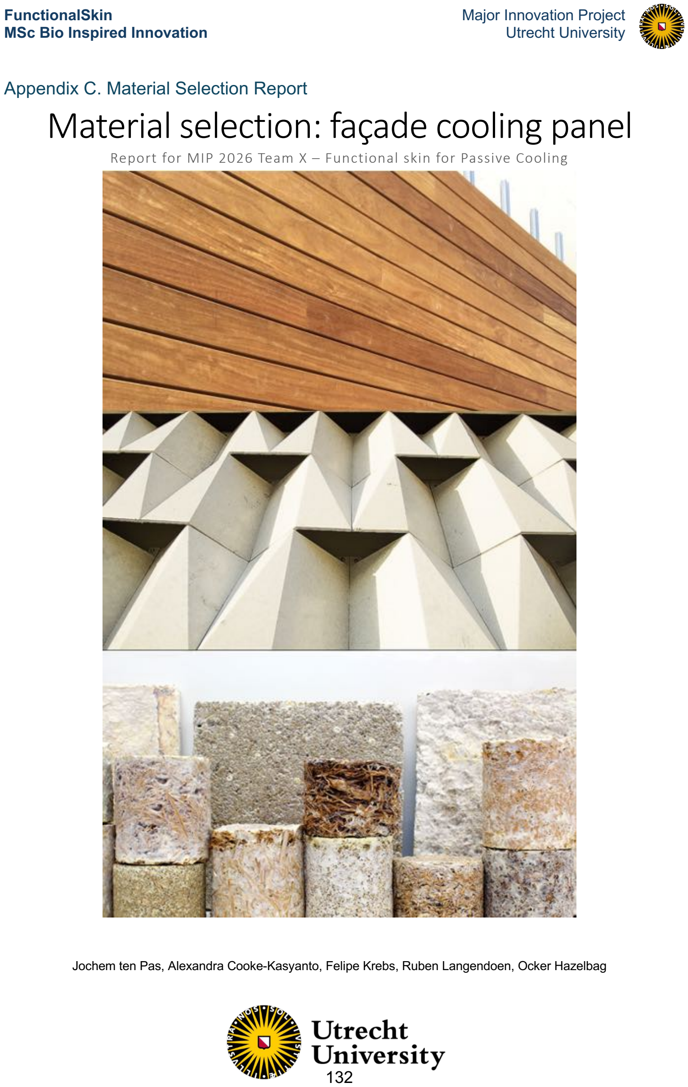
[picture p74: page 133]

Appendix C. Material Selection Report

Report for MIP 2026 Team X – Functional skin for Passive Cooling

Jochem ten Pas, Alexandra Cooke-Kasyanto, Felipe Krebs, Ruben Langendoen, Ocker Hazelbag

Table of contents

## Introduction

Façades are the barrier between the interior and exterior of a building, like a skin separating the internal body to the outside environment (Sandak et al., 2019). In the past, a façade just consisted of one layer and therefore only one material, as the inside was the same material as the outside. However, over time, façades have become more refined with multiple layers that each have their own function, showing analogy with the human skin (Fig. 1).

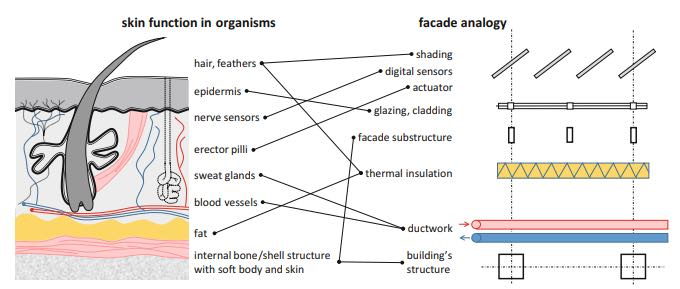
[picture p75: figure]

Façade
cladding is the outer, non-load-bearing layer of a building skin (Fig. 2). Consequently, it is exposed to all types of weather and one of its main purposes is to protect the control and structural layers against these environmental elements. Besides its protective role, façade cladding serves aesthetic purposes, as it determines the building’s appearance. Next to those

Figure 22: A comparison between the different layers of an animal skin and a building façade (Sandak et al., 2019).

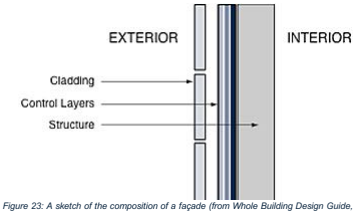
[picture p76: figure]

Figure 23: A sketch of the composition of a façade (from Whole Building Design Guide, z.d.).

two main functions, it can improve thermal or sound insulation and fire resistance (Thevega et al., 2022).

Façade cladding comes in all different type of forms, shapes and materials, depending on the façade system and its requirements. Traditionally, walls were constructed with locally resourced materials, such as stone and mud bricks. In more northern areas of Europe they started to use wood which had higher availability and offered better insulating properties (Sandak et al., 2019). In the Netherlands this was also the case and façades were a load-bearing part of a building. However, in the 1930s, concrete frame structures started to become the building standard and façades were no longer part of the load-bearing structure. In addition, other requirements started to arise for the exterior of a building (De Jonge, 2024). Aesthetics became more important and with the development of new building techniques and materials, façade systems evolved to become more advanced.

The material selection of façade cladding is vital as it impacts the aesthetic look of a building as well as its functions (Shrivastava & Sahu, 2024). The most common materials used for façade cladding are stone/brick(slips), metals, aluminium, fibre-reinforced composites (FRPs), ceramics and wood. However, there is increasing interest in biobased materials as sustainability is gaining importance in the building industry. However, most biobased materials do not yet withstand the environmental conditions these are exposed to when used as a façade cladding. Therefore, it is important to assess the different types of conventional and biobased cladding materials that are commonly used for façades. In the following section, these materials will be discussed, and their material properties will be assessed against the requirements established for these materials.

## Material requirements

Choosing the right material for façade cladding is a multi-criteria decision problem (Ferreira, Dias, et al., 2021). The façade cladding should not only have an aesthetic appeal and protect the underlying layers (Shrivastava & Sahu, 2024). Designers also consider durability and cost, need for maintenance, thermal and acoustic properties, weight, formability (the ability of a material to be formed into a desired three-dimensional shape), fire safety, and sustainability of the material (Ferreira, Dias, et al., 2021; Thevega et al., 2022). The number of criteria that need to be considered shows that material selection depends on the project context and which functionalities are the most important.

Thermal conductivity
In this project it is therefore important to narrow down the number of material properties for our cooling panel to make an informed decision on the material selection. First, the panel must have a passive cooling effect on the building as well as the environment. However, as assessed in work package 1 (WP1), the cooling properties of the panel will mainly result from the geometric design of the panel enabling convective cooling. Moreover, we aim to apply a reflective and/or radiative coating/paint. Additionally, the thickness of the panel will likely not exceed 20 mm, which limits the thermal mass contribution regardless of the specific heat capacity. Thermal mass and heat capacity will therefore be excluded from the material requirements for this project (Table 1).

However, it is still important that the material has low thermal conductivity, ideally below 0.5 W/(m∙K), as materials with high thermal conductivity would counteract the convective cooling mechanism. Thermal insulation materials typically have thermal conductivity values below 0.07 W/(m∙K) (Petcu et al., 2023), whereas the thermal conductivity values of wood, concrete and plastics, which are considered poor thermal conductors, range from 0.1-0.57 W/(m∙K) (Cabral & Blanchet, 2021; Kijo-Kleczkowska & Gnatowski, 2022). Materials that are considered thermally conductive, such as steels or metals, typically have values ranging from 50 to over 200 W/(m∙K). Together, a material with a thermal conductivity < 0.5 W/(m∙K) is preferred.

Adhesive properties
The material should have adhesive properties for applying reflective or radiative paints and/or coatings. These requirements are difficult to quantify with a specific threshold value and therefore will be considered as qualitative screening criteria: the material should be compatible with paints and/or coatings or rather, the material should not have properties that inherently prevent compatibility with paints and/or coatings.

Durability
Exterior façade cladding has an average estimated service life of 12 to 60 years, which requires the material of these panels to degrade minimally over the duration of this use phase (Silva & de Brito, 2021). As it is exposed to all the weather elements, several material properties are important for the durability. Solar radiation is one of the factors impacting materials, specifically from UV exposure, resulting in colour degradation, material brittleness or biodegradation (Andrady et al., 2023).

Additionally, moisture, especially in the Dutch climate, impacts the durability of materials (Ferreira, Barrelas, et al., 2021). Water absorption is one of the metrics to assess the moisture resistance of materials. Although there is no defined standard threshold for water absorption at material level, water resistance of façade constructions is regulated at systems level in the Dutch Besluit bouwwerken leefomgeving (Bbl), which is crafted by the Dutch government (article 4.118) (Koninkrijksrelaties, 2026). Testing procedures for this are defined in NEN 2778. As there is no standard threshold for water absorption rates for materials, a material-level threshold can not be constructed in the requirements table. Therefore, this metric will be assessed as a ranking criterion, where lower water absorption rate is preferred. However, compliance with NEN 2778 should ultimately be demonstrated in later developmental stages of the panel.

Freeze-thaw resistance
The Dutch climate also undergoes freeze-thaw cycles during winter, which can impact the mechanical properties of a material. Water can infiltrate the pores of materials and expand when it freezes, putting internal pressures on the material which can result in cracks or deformation. Upon thawing, the water leaves the material that is now deformed and has a reduced strength (Asare et al., 2024; Bogas et al., 2016; H. Li et al., 2012). Cycles of this process can lead to significant strength loss in materials, depending on their porosity and water adsorption and content (Bogas et al., 2016).

Thermal expansion
Materials also expand during exposure to high temperatures. The degree of expansion of a material is called the thermal expansion coefficient. If a material has a high thermal expansion coefficient, it can affect the appearance and structural integrity, which can lead to safety hazards in high-rise buildings (Yang et al., 2024). Ideally, a façade cladding material has a low thermal expansion to minimize the chance of deformation or degradation, however, there are ways to circumvent deformation as a result of thermal expansion in the form of fixing and jointing techniques or reinforcement (Baker, 1964). Therefore, it will not be included in the list of requirements.

Weight
Façade cladding elements are non load-bearing but should generally still be able to hold their own weight. Lightweight materials are easier to install and transport, resulting in reduced costs and environmental impact. Therefore, a lightweight material for the façade panel in this project is preferred. The weight of façade cladding panels is assessed by their density (kg/m³). However, in the construction industry, surface density (kg/m²) is used as comparing metric, as it incorporates the thickness of a panel into the weight. Some materials have a high density but can be thin, thereby reducing the overall weight of a panel. Therefore, surface density will be used as comparative metric regarding the weight.

By comparing different panels that are made from materials that are considered lightweight, such as aluminium (3 mm thick, 8.1 kg/m²), Rockpanel (stone, 8 mm thick, 9.4 kg/m²), plastic (Keralit, 17 mm thick, 7.7 kg/m²) or Thermowood (18 mm thick, 7.2 kg/m²), a surface density < 10 kg/m² can be considered a realistic target for our material.

Fire safety
According to the Bbl, new buildings or renovations should comply with EN 13501-1 that describes the fire safety of facades (Koninkrijksrelaties, 2026). Façades of a single-family home should be fire class B (very limited contribution to fire), whereas high-rise buildings have more complicated regulations. Façades between the height of 2.5 and 13 meter of a building should be fire class D (medium contribution to fire), whereas facades below 2.5m and above 13 meters should fire class B (Fig. 3). For smoke production, all materials should comply with smoke class 2 (s2, limited contribution to smoke production), as well as burning droplet production class d0 (does not produce flaming droplets). For our project, ideally a material that is inherently fire resistant is selected. However, materials that do not comply with these standards can be modified with coatings to improve their fire safety. Therefore, fire safety is considered a ranking criterion in this list of requirements.

Sustainability
Recyclability, biobased content and biodegradability are important properties that can impact the material choice. A biodegradable material would be preferred for our project, however, biodegradability often significantly impacts the durability of a material, therefore recyclability is the preferred baseline. As by ISO 140121, a material is considered recyclable if it can be recovered from a waste stream through existing processing, separating and reprocessing methods, and then converted into new products. Choosing a material that is recyclable therefore improves circularity. Biobased content is another metric of sustainability. Choosing

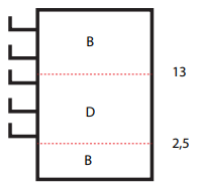
[picture p77: figure]

a material that is at least 100% biobased is preferable, however, it is considered a ranking criterion where higher biobased content is preferred.

Formability
The panel that we are planning to make has a certain 3D-geometry including cm-scale structures incorporated into it. Therefore, it is important that the material can be formed in this shape or that these structures can be easily introduced into the material.

Cost and availability
Some materials are easier to obtain given the costs, availability and contacts that we have. Apart from this, availability of equipment to shape a certain material will influence the choice of a material.

Figure 24: Visualisation of the fire resistance regulations (Bbl) for high-rise buildings.

Table 1: Overview of requirements on material properties, describing the type of requirement (threshold or qualitative) and whether it is a hard constraint or ranking criterion.

Criterion | Threshold or qualitative | Hard constraint or ranking criterion | Does the material comply

Cooling function

Thermal conductivity | Below 0.5 W/(m∙K) | Hard constraint

Paint/coating

Paint/coating compatibility | Qualitative | Hard constraint

Weather resistance

UV resistance | Qualitative | Ranking criterion
Water absorption rate | Qualitative | Ranking criterion
Freeze-thaw resistance | Qualitative | Ranking criterion

Weight

Surface density | Below 10 kg/m² | Minimum requirement – Ranking criterion

Fire resistance

Fire resistance | Fireclass B, s2, d0 | Ranking criterion

Sustainability

Recyclability | Qualitative | Hard constraint
Biodegradability | Qualitative | Ranking criterion

Biobased content | Qualitative | Ranking criterion

Formability & availability

Material availability | Qualitative | Hard constraint
Material formability | Qualitative | Hard constraint
Instrumentation availability | Qualitative | Hard constraint
Prototyping feasibility | Qualitative | Hard constraint

## Comparison of different materials

Natural stone, concrete, ceramics, glass, metals, plastics, fibre reinforced composites (FRCs) and wood are some of the most used façade cladding materials. With the use of Table 1, materials can be assessed and eliminated or ranked, depending on their assessment. If a material does not comply with a property that is a hard constraint, it can be immediately eliminated as it is not suitable for our project. For this reason, metals and in particular aluminium was eliminated as a potential material as it has a thermal conductivity that far exceeds the threshold (237 W/(m∙K)). Similarly, ceramics have a slightly higher thermal conductivity than the threshold (1.55 W/(m∙K)), as well as a far too high surface density (12mm, 27.8 kg/m²) and was therefore also eliminated.

Different types of plastics are used as cladding (PE, PP, PVC) as they possess low thermal conductivity, high flexibility, corrosion resistance and are low density and cheap (Riahinezhad et al., 2021). However, there are concerns about the weather durability of plastics. Depending on the type of plastic, different type of environmental conditions can significantly affect the durability of plastic (Riahinezhad et al., 2021). For example, UV radiation can cause photochemical degradation in several organic-based polymers, leading to micro-cracking, colour degradation, embrittlement, increasing water absorption rates and loss of strength (Andrady et al., 2023; Riahinezhad et al., 2021). In addition to the concerns about weather durability, plastics are eliminated based on their recyclability. Most plastics are technically recyclable, but require complex, multistage techniques and therefore often end up being landfilled or degraded into microplastics, which impacts the health of the soil, oceans, plants and animals (Lalrinfela et al., 2024; Naderi Kalali et al., 2023). Lastly, most plastics are considered combustible and therefore should be restricted in their application in the building industry (Sandak et al., 2019).

Glass is a common material used for the exterior layer of buildings, especially in curtain wall systems (Sandak et al., 2019). However, the thermal conductivity of different types of glass exceeds the threshold for thermal conductivity for this project. The three types of glass often used for curtain walls, float glass, heat-strengthened glass and tempered glass, all have thermal conductivity values > 0.5 W/(m∙K) (~1 W/(m∙K)) (Geotti-Bianchini & Lohrengel, 1993; Malinarič, 2025). Additionally, although it is often considered lightweight, glass actually has a high density (2200-3000 kg/m³) (İlerisoy & Çolak, 2018). A glass panel with a thickness of 10 mm would then have a surface density of 22-30 kg/m², which would exceed the threshold of 10 kg/m². As a final constraint, glass is difficult to form in the 3D-geometrical shape that is needed for our project. Additionally, we lack the instrumentation to create complicated shapes with glass and because of all these reasons, glass is also eliminated as a potential material for our project.

A wide range of materials can be categorized under fibre reinforced polymer composites (FRPCs), of which 25% is produced for the construction industry (Effing, 2018; Q. Nguyen et al., 2013). The combination of matrix of a polymer and a fibre as reinforcement offers increased mechanical, thermal and insulating properties (Bedon, 2016). Fibers can be natural, organic, metal or inorganic. As for polymers, in the building industry, three main groups can be identified, thermoplastics, elastomers and thermosets (Bedon, 2016). However, there is increasing interest towards bio-composites, which consists of natural fibres and a biological polymer (Manu et al., 2022). 99% of the composites produced are glass-fibre reinforced polymers (GFRPs) (Effing, 2018). FRPCs contain, next to the previously named properties, other properties which makes them appealing for the construction industry. They are mouldable and have excellent corrosion resistance (Qureshi, 2022). However, similarly to glass, they are often considered lightweight, while in reality GFRPs have a density ranging from 2270 to 2500 kg/m³ and carbon fibre 1700-1800 kg/m³ (Shakir Abbood et al., 2021). This would make their surface density 1.7-2.5 kg/m² per mm thickness. With a standard 6-8 mm thick façade panel, this implies that the weight is exceeding the threshold. Additionally, FRPCs are difficult to recycle, especially ones with thermoset and rubber-based matrices that are widely used, which makes it an unsuitable material for our project (Ghosh, 2023; Radu et al., 2026) .

FRPCs can also be composed of biopolymers, natural fibres and bio-fillers. When made from natural materials, they can be categorized as: fully green bio-composites and partially green composites (Shelly et al., 2025). Fully green composites use a biobased matrix in addition to natural fibres and bio-fillers. Partially green bio composites are composed of natural fibres and a petrochemical matrix. Partially green bio composites can face difficulties with recycling, depending on the type of petrochemical matrix that is used (thermoset or thermoplastic), but are still considered recyclable four to six times until a degradation of thermomechanical properties is observed (Zhao et al., 2022). Fully green bio composites however can be composted or biodegraded, offering inherent benefits sustainability-wise (Faheem & Khan, 2025; Fartash Naeimi et al., 2025).

Students at Eindhoven University of Technology developed a façade panel with a similar 3D geometry as the design of our project, using a bio-composite from the Dutch company NPSP. Nabasco® 8010, the bio composite that was used, is one of the leading biobased materials in the Netherlands that is used for façade cladding and is therefore an interesting material option for our project. It consists of flax, reed, cotton, sisal or jute, lime and a biobased polyester resin (Pujadas-Gispert, Alsailani, van Dijk (Koen), et al., 2020a; Vancso et al., 2024; Verspeek & Burgh, 2019). The product has been used in numerous projects in collaboration with many companies, such as Staatsbosbeheer, Rijkswaterstaat and Province Noord-Brabant, and has built a reputation for being a reliable bio composite for façade cladding (Ortega Exposito et al., 2023). It is reported to have similar mechanical properties and density to glass and certified with fire safety class B-s1, d0 (NPSP, 2025a; Pujadas-Gispert, Alsailani, van Dijk (Koen), et al., 2020a). Additionally, it is reported by the manufacturer to have an estimated lifespan of 50-100 years (Romano, 2023; Vancso et al., 2024), can be mechanically recycled by crushing it and reusing the residual as raw material for new panels (NPSP, 2025b) and can be formed into advanced three-dimensional shapes by using moulding techniques and hot pressing (Romano, 2023).

However, besides the observed benefits of Nabasco®, some material properties do not fulfil the requirements of our project. First, the surface density of Nabasco® 8012, a following iteration on Nabasco® 8010, has a surface density of 10.7 kg/m², which exceeds the threshold of 10 kg/m² (Vancso et al., 2024). Additionally, Nabasco® 8010/8012 is produced by a private company, which makes the material difficult to obtain within our project, and requires a steel or aluminium mould to form complex 3D-shapes, which is costly. Lastly, the paper from Pujadas-Gispert et al. ( 2020) was conducted in Dubai, a hot and dry climate, whereas the panel for our project is meant to be developed for use in the Netherlands. In that paper, the dimensions of the panels had decreased because of the hygrothermal conditions of Dubai. The Netherlands has a more demanding climate regarding moisture, which increases insecurity about the dimensional stability of Nabasco®. Additionally, some parts of the panel, such as the small flaps at the tile edges were prone for breaking, which impacted the functionality of the tiles. All these considerations decided us to not pursue Nabasco® as a material for our project.

Historically, wood is a commonly used material for façade cladding in Europe. Buildings from as far back as the Stone Age have been discovered which used wood for external walls (Hill et al., 2022). When brick became a cheaper material, popularity of wood for building façades declined. Additionally, for multi-story buildings, there were concerns regarding the durability and fire safety of wood. However, over the last 20 years, wood started a revival. Sustainability is gaining importance in the building industry and wood modification techniques are becoming more advanced (Hill et al., 2022). Wood complies with most of the requirements of our project. The thermal conductivity of wood depends on the type, as density, structure and moisture content affect the value (Pelaz et al., 2017; Sonderegger & Niemz, 2009; Suleiman et al., 1999). However, the thermal conductivity of soft- and hardwood is below the threshold of 0.5 W/(m∙K) with a safe margin (Cabral & Blanchet, 2021). Additionally, the density of most wood species and types is below 1000 kg/m³, which would make the surface density of a 10 mm thick panel below the threshold of 10 kg/m² (Gérard et al., 2011).

Wood is a material that is readily available (depending on the species), within budget and complex 3D shapes can be developed with instrumentation that is available for us, which makes it an appealing material. Additionally, wood is a sustainable material as it is inherently biodegradable, 100% biobased and recyclable. The two properties in which timber does not excel are durability and fire resistance. However, the durability depends on the type of wood that is used. Different natural durability classes of wood are provided through the EN 350 standard, whereas the natural durability is defined as the natural ability of the wood to protect itself against biological wood-destroying agents (fungi, beetles, termites and marine organisms (EN, 2016; Hill et al., 2022). Class 5 (non-durable) is the lowest, whereas 1 (very durable) is the highest (EN, 2016). Wood types considered class 3 or lower are suitable for outdoor purposes such as cladding.

Lignin within wood is susceptible to solar radiation, specifically UV light. This can result in colour change, depolymerization of lignin and cellulosic polymers, and eventually erosion within the wood (Jirouš-Rajković & Miklečić, 2021). Similarly, moisture is a common degradation agent of wood. However, both these concerns can be resolved by applying moisture and UV resistant coatings to the wood, which are readily available, or by thermally or chemically modifying the wood which alters its properties.

Overall, wood meets most of the material requirements, which is why the next section assesses which type of wood would be most suitable for our project. Different treatments and coatings are also discussed, which can be used so wood complies with all the material requirements for our project.

### Wood as a cladding material

In Europe, the tree species considered most suitable for timber cladding are larch (Siberian or European) (Larix sibirica or Larix decidua), fir (Abies spp.), Douglas fir (Pseudotsuga menziesii), spruce (Picea spp.), pine (Pinus spp.), European oak (Quercus robur) and western red cedar (Thuja plicata) (Hill et al., 2022; Ivanović-Šekularac et al., 2016; Svensson Meulmann & Sjökvist, 2023). These species can be categorized in several ways, such as natural durability classes, hard- or softwood and European native or non-native species. It is notable that some of the species (spruce, fir and pine) listed by Hill et al. (2022) are not necessarily durability class 3, as previously described needed for cladding applications. However, by treating them they are still often used as façade cladding materials. Some papers even investigated the possibility of using some of these species untreated for façade applications (Svensson Meulmann & Sjökvist, 2023).

Other notable species are European oak, as this is the only hardwood in the list, and western red cedar. Hardwoods are generally stronger and more durable than softwoods, but more difficult to process, heavier, pricier and more susceptible to shape deformation and crack formation (Hill et al., 2022; Štěrbová et al., 2021). However, because of its strength, durability, wide availability and aesthetic look, European oak is still used for façade cladding purposes despite its downsides. Western red cedar is a non-European wood type that is native to North America and therefore needs to be imported to Europe. It is however a very suitable wood type, as it is lightweight, considered durability class 2 and keeps good dimensional stability.

Plywood consists of sheets of plies (thin layers) of wood veneer, stacked and glued together. The wood veneers are stacked in such a way that the grain of each layer is perpendicular to its adjacent layers (cross laminated). This method is applied to mitigate the disadvantages of wood, such as poor dimensional stability or poor processing, and protect its advantages. Wood types often used for plywood are larch, pine, oak, fir, birch and poplar (Tangellamudi et al., 2025).

To assess which wood type is most suitable for our project, a systematic comparison is going to be made between each type by looking at the natural durability class per EN 350, density, price and the supplier (Table 2). Additionally, different types of modifications and treatments can be done to improve the properties of wood types, such as thermal modification, impregnation, acetylation, coating or surface modification. Therefore, wood types that might have worse properties than others, might be improved significantly with modification techniques and should not be disregarded as easily. In the end, a final recommendation will be made for the most suitable wood type and modification for our project based on our assessment. Siberian larch is excluded from the comparison as it is unavailable since the invasion of Ukraine by Russia.

Table 2: Comparison of wood species properties used for species selection.

Durability class (EN 350)

Density at 12% MC (kg/m³)

Price (low, medium or high)

Supplier

### Comparison of different types of wood

The data on the durability class and densities of the different types of wood is sourced from houtinfo.nl by Centrum Hout, the online version of Houtvademecum, a wood catalogue of over 250 species used by architects and constructors for information about wood types (Centrum Hout, z.d.-a). The values from this database have been cross-referenced with the CIRAD Tropix database, a French agricultural research institute (Gérard et al., 2011). This provides ranges for the durability classes and densities, which is usual as wood as a natural material varies in terms of its properties. The price for the different types of wood is qualitatively assessed based on current supplier prices, rather than specific prices, as they constantly fluctuate depending on supplier, grade, dimensions and other factors. The supply of the wood will be categorized on three levels: national, regional and continental. National means that the wood type is grown and sold in the Netherlands, regional means that it is grown and sold in Europe, whereas continental means it needs to be imported from different continents. For most species, it will be a mix, as 94.8% of all the wood in the Netherlands used for material application is imported (Teeuwen et al., 2025).

Spruce
Table 3: Material properties of spruce (Picea abies).
Durability class (EN 350) | 4
Density at 12% MC (kg/m³) | 450-460
Price | Low
Supplier | National / Regional

Spruce is a softwood which originates from a vast area in Europe, from Scandinavia to the Balkan and the alpine regions of Central Europe (Seim et al., 2022). It is low weight with relatively good strength and although it is considered durability class 4 if not treated, it can be argued that due to its pit aspiration it can perform well as cladding material (Table 3)(Hill et al., 2022). Generally, spruce wood is widely available in hardware stores in the Netherlands and is considered an inexpensive type of wood. Most of the spruce wood is imported from Northern- and Central Europe, however, 4% of Dutch forests consist of Spruce trees (Assink et al., 2022). Spruce is considered a refractory wood species; a wood type difficult to penetrate with preservatives (Gérard et al., 2011). On one hand this means that it is difficult to impregnate, but also that it naturally limits moisture uptake, in the form of liquid water, when uncoated (Hill et al., 2022). It is still, however, susceptible to vapor sorption. Spruce has a moderate volumetric shrinkage coefficient (0.37% per %), which is not a problem with proper detailing. However, spruce has a 2.1 St/Sr ratio, which means it shrinks 2.1 times as much tangentially as radially, which can lead to warping (Gérard et al., 2011).

European larch
Table 4: Material properties of European larch (Larix decidua).
Durability class (EN 350) | 3-4
Density at 12% MC (kg/m³) | 600-650
Price | Medium
Supplier | National / Regional

European larch is a tree species commonly found in the Alp mountains and Central Europe (Gérard et al., 2011). It is one of the heaviest and more durable European softwoods and commonly used for cladding (Table 4). European larch is generally slightly more expensive than spruce, pine or fir but cheaper than other hardwoods and mostly imported from other parts in Europe, although 5% of the trees in Dutch forests are larch trees (Assink et al., 2022). European larch is considered non-permeable, which makes it more difficult to impregnate but again also naturally more durable (Gérard et al., 2011). Additionally, wood from European larch is prone for warping due to its high St/Sr ratio (2.0) and relatively high coefficient of volumetric shrinkage (0.48% per %) (Gérard et al., 2011). One important remark is that with a 15 mm thick panel made from European Larch, the surface density of a panel would come close to 10 kg/m², which is undesirable. Therefore, the eventual chosen thickness is important for the final material decision.

Scots pine
Table 5: Material properties of Scots pine (Pinus sylvestris).
Durability class (EN 350) | 3-4

Density at 12% MC (kg/m³) | 550
Price | Low
Supplier | National / Regional

Scots pine is a tree species native to large parts of North, North-East and Central Europe and introduced in large parts of Western Europe and Great Britain (Gérard et al., 2011). It is a relatively heavy softwood compared to spruce but less heavy than European larch or other hardwoods (Table 5). Scots pine is the most common tree species in Dutch forests (32% of all trees) (Assink et al., 2022), which partially contributes to the low price it has in retail. Scots pine has the same permeability as spruce, poorly to non-permeable (Gérard et al., 2011). Similar to European larch, Scots pine has a relatively high coefficient of volumetric shrinkage (0.45% per %), but a lower St/Sr ratio (1.6) (Gérard et al., 2011). However, despite this lower St/Sr ratio when compared to spruce, it has been found that Scots pine is more prone to cupping than spruce, presumably because of the low pit aspiration degree compared to spruce (Virta et al., 2005).

Douglas fir
Table 6: Material properties of Douglas fir (Pseudotsuga menziesii).
Durability class (EN 350) | 3-4
Density at 12% MC (kg/m³) | 480-540
Price | Low - Medium
Supplier | National / Regional / Continental

Douglas fir is a tree species native to the west of North America, there referred to as Oregon pine, but introduced in large parts of Europe (Centrum Hout, z.d.-b). Douglas fir has a similar density to Scots Pine and is reported to have better compression strength than spruce and pine, but less than larch (Table 6)(Zeidler et al., 2022). It is considered moderate to poorly durable (class 3-4), similar to Scots pine and European larch. However, reports have suggested that the natural durability of Douglas fir in outdoor applications might be better than expected and that it can be used for outdoor applications without any preservative treatment. This might be due to the refractory nature of both the sapwood and heartwood of Douglas fir to water uptake (Kutnik et al., 2011).

In terms of impregnability it is non-permeable, similar to European larch (Gérard et al., 2011). Douglas fir is considered moderately prone to warping, with a low St/Sr ratio (1.6) but moderately high coefficient of volumetric shrinkage (0.46% per %) (Gérard et al., 2011). 6% of the trees in Dutch forest are Douglas firs, which means that most of the Douglas fir wood is imported from other European countries

Douglas fir from North American has different properties than Douglas fir from Europe. North American Douglas fir grow slower, which makes them dimensionally more stable and less resinous than European Douglas firs (Humar et al., 2022). The price of Douglas fir is considered to be low to medium, as in Western Europe it is approximately 25% more expensive than spruce, which is considered one of the most inexpensive types of wood (Pulkrab et al., 2014).

Fir
Table 7: Material properties of European silver fir (Abies alba).
Durability class (EN 350) | 4
Density at 12% MC (kg/m³) | 500-540
Price | Low
Supplier | National / Regional

The European silver fir (Abies alba), commonly referred to as fir, is a tree species that naturally grows in forests in the Alps, Pyrenees and Balkan and has been introduced in forests in Western- and Northern Europe (Mauri et al., 2016). The natural durability of fir wood is similar to spruce, class 4, but with a higher density, similar to Douglas fir and Scots pine (Table 7). Less than 4% of the trees in Dutch forests are firs, which makes them the least abundant coniferous tree species of the ones assessed in this report (Assink et al., 2022). It is considered an inexpensive type of wood with reasonable strength. A downside of fir is that, based on market research conducted in this project, it is not as widely available across the Dutch hardware stores as other types of softwood like spruce and Scots pine. Additionally it is often used for construction application, not for higher-end applications (Centrum hout, z.d.). Fir wood is moderately prone to warping with a coefficient of volumetric shrinkage of 0.44% per % and a St/Sr ratio of 2.2. It is however easier to impregnate fir wood, with an impregnability rating of 2-3, which translates to poorly to moderately permeable (Gérard et al., 2011).

European oak
Table 8: Material properties of European oak (Quercus robur).
Durability class (EN 350) | 2
Density at 12% MC (kg/m³) | 670-760
Price | Medium
Supplier | National / Regional

European oak is the only hardwood listed in this comparison, which is also determined due to the density, which is the highest among all tree species (Table 8). This already raises weight concerns as the surface density would exceed the threshold of 10 kg/m² with a thickness over 15 mm. However, due to its density it is also one of the most durable tree type in this list, with natural durability class 2 (Gérard et al., 2011). Hardwoods are typically stronger than softwoods, which highlights the structural integrity of European oak. It is the most abundant deciduous tree species in the Netherlands (18%) but also gets imported from other parts of Europe (Assink et al., 2022; Oldenburger, 2009). European oak is considered difficult to impregnate (not permeable) (Gérard et al., 2011). Good quality oak wood is often more expensive than the other tree types in this comparison as it is often used for veneer or furniture production. Besides that, oak is particularly prone to greying as a result of UV exposure (Oldenburger, 2009).

Western red cedar
Table 9: Material properties of Western red cedar (Thuja plicata).
Durability class (EN 350) | 2
Density at 12% MC (kg/m³) | 330-390
Price | High
Supplier | Regional / Continental

Western red cedar is a tree species that originates from North America and is still mostly imported from there, but it has also been introduced to Great Britain, Germany, Italy, Denmark, Norway and Finland (Aldana et al., 2023). As a softwood it is both the most naturally durable (class 2) and lightweight species in this comparison, which also translates to its price (Table 9)(Gérard et al., 2011; Oldenburger, 2009). Despite its relatively high price, it is still one of the most popular choices of wood for façade cladding in the Netherlands, as it has moderate to good dimensional stability, does not need any preservative treatment for outdoor application and is aesthetically wanted (Gérard et al., 2011; Oldenburger, 2009). However, the main downside of Western red cedar is that it needs to be imported from North America, as the Western red cedars grown in Great Britain have a lower natural durability (Centrum Hout, z.d.-c). This raises concerns about sustainability regarding the environmental output needed for import as well as the price.
Plywood
Plywood has similar or even increased mechanical properties compared to solid wood. However, due to the method of manufacturing, the variability of mechanical properties is reduced (Castanié et al., 2024). Additionally, it can have a lower density than solid wood, depending on veneer species, and have higher resistance to cleaving and warping (Hrázský & Král, 2014).

The main problem of plywood is its durability, in particular their resistance to moisture. Alternating wetting and drying of plywood could cause reduction of mechanical properties of plywood (W. Li et al., 2016). Especially the sawn edges of plywood are prone for moisture and need primer finish when used outdoors. Additionally, most plywood types use urea-formaldehyde resin glue, which is not water-proof and therefore unsuitable for outdoor use (Liang et al., 2023). However, there are moisture-resistant plywood types on the Dutch market.

Table 10: Material properties of Okoume plywood at 12 mm thickness.

Use class (EN 636) | 3 (Exterior)
Bonding quality (EN 314) | 3 (Weather and Boil Proof (WBP))
Density at 12% MC (kg/m³) | 500
Price | Medium - High
Supplier | Continental

Plywood made from Okoume, a tree species native to West-Africa, is considered moisture resistant which makes it usable for outdoor applications. It is often used for boatbuilding, as it is lightweight, durable and marine resistant (Negro et al., 2011). It is, however, more expensive than plywood made from other tree species, depending on the thickness (Table 10). Plywood is excluded from EN 350 natural durability classification, as wood veneers are made from sapwood which is excluded from the norm. Therefore, in this table, EN 636 (use class) and adhesive bonding quality (EN 314) are included.

Okoume 12 mm plywood both has use class 3 and bonding quality class 3, which means it can be used outdoors and the glue is WBP (Okoumé multiplex FSC 12 mm 250 x 122 cm, z.d.). It has similar density to other softwood types. The price of Okoume plywood however is higher than other types of plywood and needs to be imported from West-Africa. Similar to western red cedar, this impacts the sustainability of this type of plywood. Additionally, the phenol-formaldehyde adhesive used for this type of plywood is petrochemical-based, which reduces it the biobased content of plywood and increases its environmental output (Kariuki et al., 2019).

Modification methods of wood
Commercially sold wood is often modified to improve its mechanical properties and dimensional stability (Hill et al., 2022). Thermal modification, impregnation and acetylation are commonly used techniques to improve wood properties. In this section, several modification methods will be discussed and assessed for our project. The chemical processes used for modification are reported in the literature but are not relevant for the scope of this report. Therefore, the focus will mainly be on the alteration of material properties as a result of the modifications.

### Thermal modification

Thermal modification is a process in which wood is heated to a temperature between 160 °C and 240 °C in absence of oxygen, which leads to the degradation of the least heat-resistant components of cell wall polymers (mainly hemicelluloses), which are also the most prone to moisture induced deformation. This process can improve the natural durability, dimensional stability and reduce weight of wood (Jančíková & Jablonský, 2025). It is also reported that thermal modification can improve the fire resistance (Čekovská et al., 2016). In terms of produced volume of modified wood, thermally modified wood (TMW) has the biggest market share in Europe, also for cladding purposes (D. Jones et al., 2020a). The biggest downside of thermal modification is that it reduces the mechanical strength of wood, however, façade cladding is often not load-bearing, which reduces the severity of this problem (Hill et al., 2022; Jančíková & Jablonský, 2025).

Compared to other modified wood types, TMW is the most inexpensive and widely available type (Brelid, 2016). The wood types most commonly used for thermal modification are spruce and Scots pine (van Blokland et al., 2020). Their durability classes can be pushed up to 2 when thermally modified (Jebrane et al., 2018; van Blokland, 2020). Additionally, both species lose 7-9% of their mass due to thermal modification, which is directly linked to the improved durability and reduced mechanical properties (Jebrane et al., 2018). Furthermore, the equilibrium moisture content (EMC) is lower in TMW, which increases the dimensional stability. The EMC is the point at which moisture content of the wood is in balance with its environment (air humidity). When the EMC is reduced, it means wood can absorb less moisture at any given humidity, which decreases its degree of swelling and therefore improves its dimensional stability (Esteves & Pereira, 2008). The loss of EMC in TMW can go up to 50-60%, leading to increased dimensional stability (van Blokland et al., 2020).

Two important remarks need to be made regarding TMW for this project, which is about coating adhesivity and price. In our project, reflective or radiative coatings will be applied to the panel. The adhesion quality of coatings can be affected with TMW (Chu et al., 2023). For spruce and Scots pine specifically, the coating penetration was reported to be the same compared to untreated wood (Altgen & Militz, 2017). The adhesion strength however is coating-system dependent. Certain waterborne systems showed reduced adhesion while others performed sufficiently. Therefore, if TMW ends up being the final material for our project, compatibility with a radiative or reflective coating needs to be verified before application. Furthermore, TMW is more expensive than untreated wood, which also is an important factor in our project. It is however still less expensive than Western red cedar.

Acetylation
Wood treated with acetic anhydride has changed material properties. Accoya™ is the only commercially available acetylated wood product, which involves the reaction of acetic anhydride with the polymers in the wood cell wall. This reaction forms ester-bonded acetyl groups, which occupy space in the cell wall. This so-called bulking effect expands the cell wall, which reduces the available space for water molecules to penetrate. As a result, less water can be taken up by the wood, making it more moisture resistant and dimensionally stable (Dunningham et al., 1992). Other benefits of acetylated wood are improved UV and erosion resistance, as well as natural durability class 1 (Sandak et al., 2021; Slabohm et al., 2023). Additionally, it has been reported that the acetylation of wood increases the performance of coatings as the interface between the wood and the coating is more stable due to the reduced swelling of acetylated wood (Rowell & Bongers, 2015).

A downside of acetylation is that it makes the wood less fire resistant, which needs to be accounted for when using it for cladding purposes (Rabe et al., 2020). Another downside is that the aesthetics of acetylated wood deteriorate in a similar way as untreated wood, which means it loses its appearance within the first few years (Sandak et al., 2021). But the biggest downside of acetylated wood is its price tag, as it is considered a premium type wood, sometimes more expensive than tropical hardwoods or high quality oak (Zelinka et al., 2022). Impregnation
Impregnation is a method to modify the properties of wood by applying a monomer that polymerizes with wood cell wall polymers or fills cell cavities without any chemical reaction (Hill et al., 2022). When an impregnating agent reacts with the cell wall polymers and changes the wood properties, it is called active modification, whereas passive modification is where no chemical reaction is present (Augustina et al., 2023). Wood impregnation can increase the natural durability of wood and its dimensional stability.

Impregnating compounds can be divided into three categories: nonbonded-leachable (oils and waxes), nonbonded-nonleachable (thermosetting resins) and bonded-nonleachable (anhydrides and organic acids). One important remark needs to be made about thermosetting resins, which is that they are petrochemical based, which increases the environmental impact of wood when applied (J. Liu et al., 2021). Nonbonded-leachable impregnating agents however, like oils and waxes, are biobased and would therefore be an option to use for impregnation. Other benefits include that it is widely available, relatively inexpensive and non-toxic (Chau et al., 2015; J. Chen et al., 2020). The limitation of oils however, is that they can only improve water repellency, not dimensional stability, especially not in the long-term, which is an important reason for wood modification (Augustina et al., 2023).

Additionally, all impregnating compounds do significantly increase the weight of the wood. This is an important remark, as the weight gain can go up to 60%, which impacts the suitability of these woods for our project (Augustina et al., 2023; Ulvcrona et al., 2006). Furthermore, some species are less permeable than others, which limits their suitability for impregnation. Like noted before in the wood type comparison, species like spruce and Scots pine are less permeable than species like fir, which makes them less easy to impregnate than fir (Augustina et al., 2023; Hill et al., 2022). Therefore, if impregnation is chosen as a method to modify the wood, the type of wood needs to be carefully chosen.

## Mycelium-Based Composites

Most conventional materials used in the construction sector are nonrecyclable, energy-consuming, costly and therefore greatly environmentally unfriendly (Alemu et al., 2022). In 2010 in developing countries, the production of construction materials like concrete, accounted for about 32% of the total energy consumption, as well as 19% of the greenhouse gas emissions (Intergovernmental Panel Climate Change et al., 2014). If the use of cement and other high-CO2 emitting construction materials isn’t reduced, it is expected that this will be doubled or even tripled by 2050. Therefore, the search for sustainable and durable biomaterials is seen as the future, with increasing research being done in the field (Alemu et al., 2022). Bio-based materials are seen as the ideal combination of low embodied energy and carbon, lower production costs, recyclability, often available as waste or able to grow on waste and byproducts and can be locally available, reducing the need for long distance transportation. One of the most promising upcoming biomaterial options is mycelium. Mycelium has already been utilized for some time now to produce bioactive molecules in the medicinal industry, as well as to produce dietary supplements. Evidence from Ötzi the iceman even demonstrates the early human use of fungi, as he carried Fomes fomentarius most probably to start fires and as a medicine (Peintner et al., 1998) In recent years this research has gone a lot further, with mycelium being used as a biomaterial in self-healing concrete, biocement, synthetic leathers, wall and ceiling panels, packaging items, and even furniture (Appels & Wösten, 2021; Dougoud, 2018; Joshi et al., 2020; Menon et al., 2019).

Mycelium as a Biomaterial
In nature, fungi gather the organic compounds needed as energy and carbon sources in several ways. Fungi can establish mutualistic interactions with plants, bacteria, and animals, where they exchange essential nutrients and compounds with the other mutualist, in exchange for necessary compounds like sugars (Appels & Wösten, 2021). In addition, fungi can acquire food by degrading dead organic matter. Their hyphae secrete enzymes that break down the substrate into molecules that can be taken up as nutrients. For instance, enzymes like laccase, lignin peroxidase, and manganese peroxidase degrade lignin, cellulose and hemicellulose in wood-like substrates. However, the breakdown process is relatively slow explaining why a large part of the particles in the wood substrate are bound together by the hyphae (Alemu et al., 2022). This binding activity explains why fungi can make mycelium-based composites (MBCs). These MBCs can be produced by several ways. The most conventional method is to stop the growth of the mycelium before full degradation of the substrate, thereby also preserving the structural integrity of the substrate (M. Jones, Bhat, Huynh, et al., 2018). Mycelium inactivation can be achieved by drying the mycelium, which places the fungus in a kind of dormant ‘hibernation’ state. This state can therefore be reactivated when the material is rehydrated, which would give MBCs regenerative properties
(H. Wang et al., 2024). Mycelium inactivation can also be done by thermal treatment. This method kills the fungus and can therefore not be reversed (M. Jones, Bhat, Huynh, et al., 2018). This method addresses the public misconception that MBCs are alive (Bonenberg et al., 2023).

MBCs can also be produced by mixing pure mycelium⁹ with other fibres to reinforce the material, which is a more controlled but less conventional process (Appels & Wösten, 2021). MBCs have also been explored using more than just bio-based materials, as research has also been done on mixing pure mycelium with materials like metals or ceramics. This could potentially shift and broaden the applications for these composite materials, also for the usage in façade panels, or other applications in the construction industry.

The final properties of a MBC are highly dependent on multiple varying factors, including the fungal species used, the substrate composition, the growth conditions and post-processing of the material (Rovers & Wösten, 2026). An analysis by Rovers & Wösten (2026) showed that the growth conditions of MBCs are the most influential variable in the compression strength of the material. As differences in substrate led to a maximum absolute increase of 4.03 MPa, second was the composition (3.74 MPa), followed by the fungal species (1.63 MPa), and post-processing (0.82 MPa) (Fig 4a). For tensile strength, the difference is even larger when changing conditions (Fig 4b). Here, Rovers & Wösten (2026) showed that difference in species had the most impact, and strains led to a maximum absolute increase of 42.5 MPa. This was followed by substrate (26.4 MPa), growth conditions (24.8 MPa), and post-processing (17.2 MPa). In the next section, the influence of each of these factors on MBC

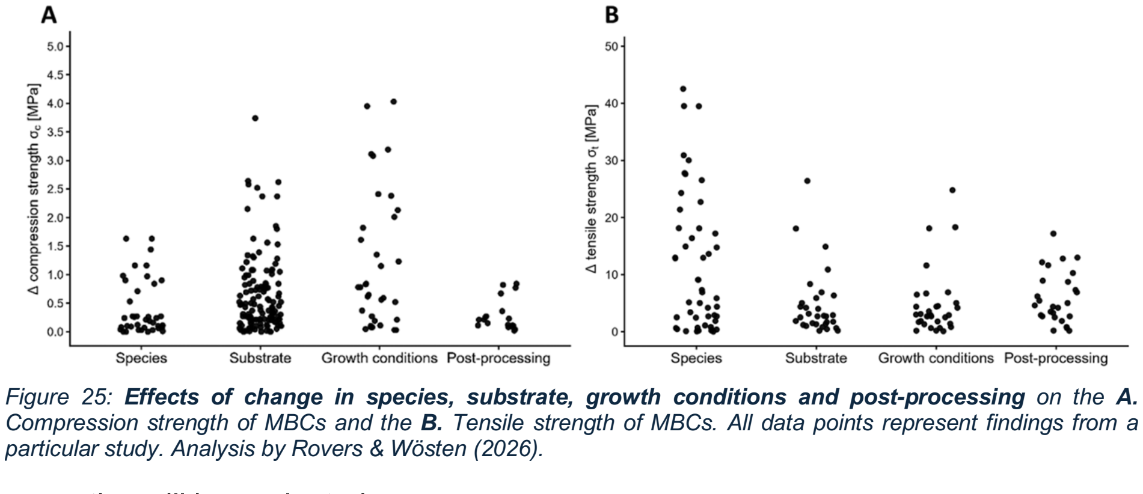
[picture p78: figure]

properties will be evaluated.

Species Selection
Many criteria must be considered for selection of a fungal species to produce MBCs for façade panels. Properties like mycelium density and growth-rate, cost of growth, toxicity or harmfulness to humans or other organisms, ease of cultivation, and most importantly the mycelium structure, must be considered (Alemu et al., 2022). Although research on many different strains has been done for mycelium materials in general, 96% of the species that have been used so far are of the Basidiomycota species (Rovers & Wösten, 2026). This

9 Pure mycelium is the fungal network (the hyphae) of a fungus, grown without added substrate (Appels & Wösten, 2021).

Figure 25: Effects of change in species, substrate, growth conditions and post-processing on the A. Compression strength of MBCs and the B. Tensile strength of MBCs. All data points represent findings from a particular study. Analysis by Rovers & Wösten (2026).

emphasis is justified, as these fungi can grow large mycelial networks and can excrete lignolytic enzymes, and are therefore able to use lignocellulosic agricultural waste streams as substrate.

Appels et al. (2019) demonstrates how the choice of a fungi strain can influence the formation of MBCs. In a comparison between Pleurotus ostreatus and Trametes multicolor, it was shown that the largest differences were observed in characteristics like fungal skin thickness, substrate colonization behaviour, and water resistance. T. multicolor consistently formed a thicker, softer, more velvety fungal skin¹⁰, which led to better water resistance of the MBC, together with a better surface integrity of the layer. This thicker skin also led to improved mechanical properties, as this layer of the composite is more resistant to bending than the part around the substrate. P. ostreatus demonstrated more brittle, but dense material properties. However, (type of) pressing impacts the tensile strength and elasticity of the materials significantly more than the type of fungus.

Another widely used mycelium strain is Fomes fomentarius, which is commonly known as the tinder fungus and has only recently been introduced into research on composite materials (Pohl et al., 2022). The fruiting body of the fungus can grow a dense outer mycelium layer and a hierarchical structure that combines low weight with great mechanical performance (Pylkkänen et al., 2023). The outer layer of the mycelium consists of tightly packed hyphae that provide protection of the inside, as well as hydrophobicity and mechanical strength. These characteristics make it a suitable choice for MBC usage. Fomes inzengae was recently reclassified as a new species distinct from Fomes fomentarius. F. inzengae will be used in the project, because of availability and good experiences in the fungal lab of Han Wösten over the last couple of years.

Substrate
The properties of MBCs are influenced by the choice of the organic substrate, as this is what the composite consists of largely (Rovers & Wösten, 2026). The analysis by Rovers & Wösten (2026) showed that the composition of the substrate of an MBC is the second most influential variable in the compression strength, as well as the tensile strength of the material. As differences in substrate led to a maximum absolute increate of 3.74 MPa and 26.4 MPa respectively (Fig. 4). Appels et al. (2019) demonstrated this by growing Pleurotus ostreatus and Trametes versicolor on beech sawdust, rapeseed straw and cotton waste. They found that substrate type had significant influence on the material properties. T. multicolor grown on rapeseed straw showed the highest tensile strength, while T. multicolor grown on beech sawdust showed the highest Young’s module¹¹. Elsacker et al. (2019) compared T. versicolor MBCs resulting from the lignocellulosic substrates hemp, flax, flax waste, straw and softwood, while using different types of fibre processing (loose, chopped, dust, pre-compressed, and

10 ‘Fungal skin’ is a term that is ofen used in literature to describe the thin surface layer of mycelium growth (Appels & Wösten, 2021). Usually this is the sof, white outer layer of MBCs, when they’ve been incubated again afer being taken outside of the mold.
11 The Young’s module is the s=ffness of a material, and how much it resists elas=c deforma=on when force is applied.

tow). While differences in mechanical properties were observed between the different fibre types, the conducted tests revealed that the mechanical performance of MBCs depends more on the processing of said fibres. Overall, dust was found to be a poor substrate for mycelium growth, most likely due to the availability of nutrients and absence of air voids for the mycelium to grow into. Wood and straw-based substrates resulted in varying growth of the fungus, making them less reliable choices for the project. On the contrary, hemp, flax, and flax waste as substrates resulted in reliable results and well-developed composites.

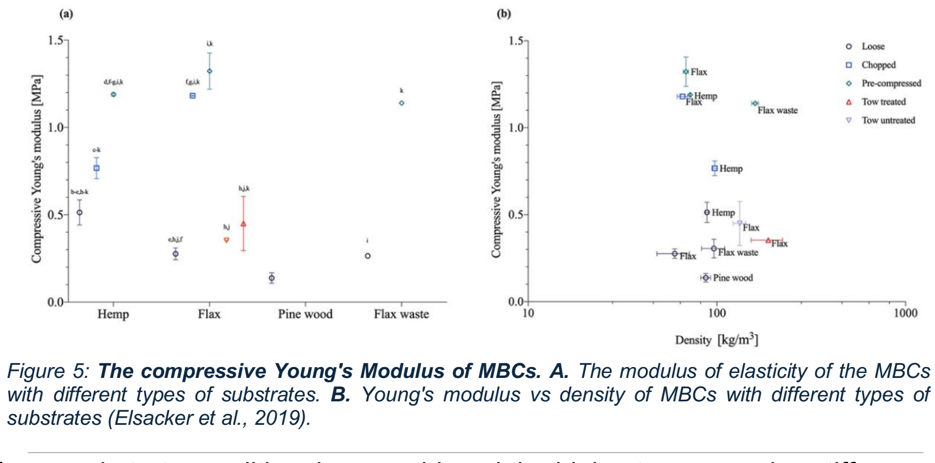
[picture p79: figure]
substrates (Elsacker et al., 2019).

In loose substrate condition, hemp achieved the highest compressive stiffness of 0.51 MPa, followed by flax waste that scored 0.31 MPa (Fig 5a) (Elsacker et al., 2019). When these fibres were cut < 5 mm, the stiffness significantly improved across all substrate types, with flax reaching 1.18 MPa and hemp reaching 0.77 MPa. Elsacker et al. (2019) attribute this to better packing of the substrate and a higher number of contact points for mycelium binding. Pre-compression of the substrate scored highest in compressive stiffness, which resulted in the Young's modules of 1.32 MPa for flax, 1.19 MPa for hemp, and 1,14 MPa for flax waste (Fig 5b). For the water absorption of the separate substrates, hemp-based MBCs demonstrated the most favourable behaviour, absorbing only 24.45% of the substrate weight after 24 hours, while straw absorbed 26.78% and flax 30.28% (Elsacker et al., 2019). This is attributed to the denser hydrophobic outer skin that the T. versicolor mycelium develops when grown on hemp, as this slows the absorption of water into the MBC. Together, pre-compressed hemp seems like the most favourable substrate, as it has the most favourable combination of stiffness and water resistance among the substrates that were tested.

Figure 5: The compressive Young's Modulus of MBCs. A. The modulus of elasticity of the MBCs with different types of substrates. B. Young's modulus vs density of MBCs with different types of

Post-processing of Mycelium-Based Composites As figure 4 and the analysis by Rovers & Wösten (2026) has shown, the least research has been conducted on the effects of post-processing on the material properties out of the four variables. However, the analysis showed that difference in post-processing was the least influential variable for tensile and compression strength. Appels et al. (2019) also conducted tests on the effects of pressing the MBCs into board-like materials. In these experiments, the non-pressed material was compared to cold-pressed and heat-pressed equivalents. This turned out to be the most dominant factor in determining the material performance, in comparison to substrate or even fungal strain.

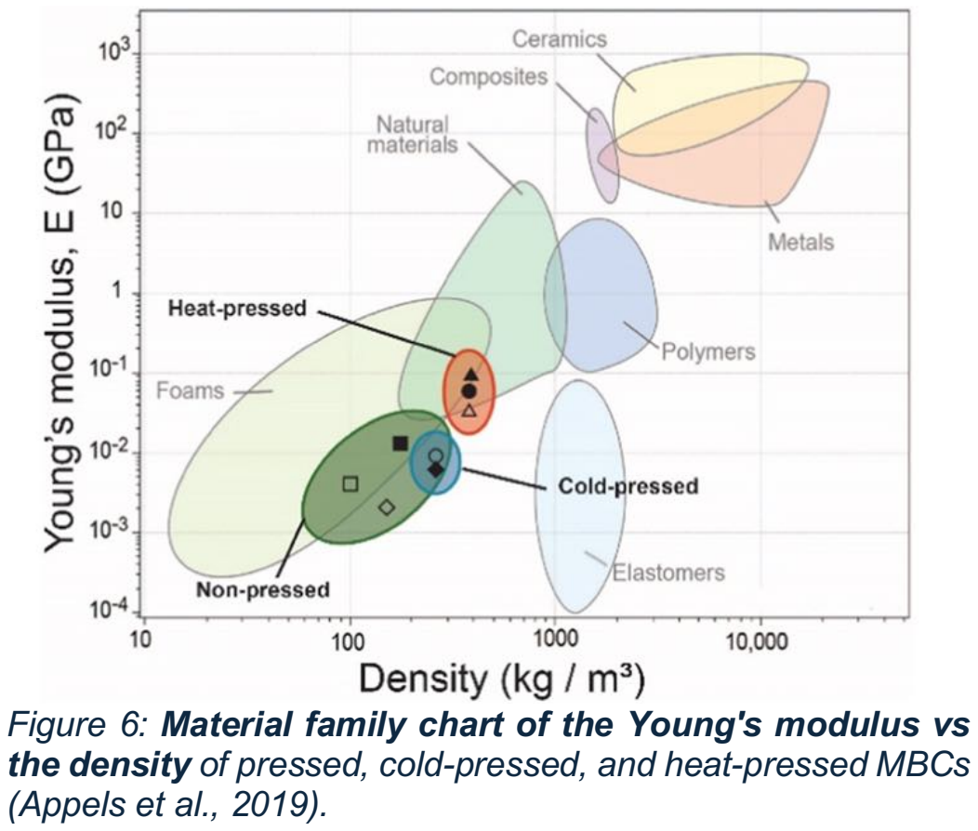
[picture p80: figure]
(Appels et al., 2019).

As seen in figure 6, heat-pressed MBCs have a significantly higher density and Young’s module than cold-pressed and non-pressed equivalents. Cold pressing the material increases the density about two times (from 0.10–0.17 g/cm³), while heat-pressing increased the density three or more times (up to 0.35–0.39 g/cm³). This results in significantly higher tensile strength for the heat-pressed material, moving from 0.01 – 0.05 MPa in the non-pressed material to 0.13 – 0.24 MPa in the heat-pressed material. Lastly, the Young’s module increases from 2 – 13 MPa in the non-pressed material to 35 – 97 MPa in the heat-pressed material.

Pressing of MBCs thus significantly enhances the material properties and performance, moving from a foamy material-like performance more to a natural material-like performance (Fig 6). Heat-pressing the material improves the homogeneity and reduces the variation in between different individual units (Fig 7). This provides more homogenous and predictable performance of the material. In addition, post-processing of the MBCs makes the material much more suited for usage as a façade material slowly shifting the applicability from indoor

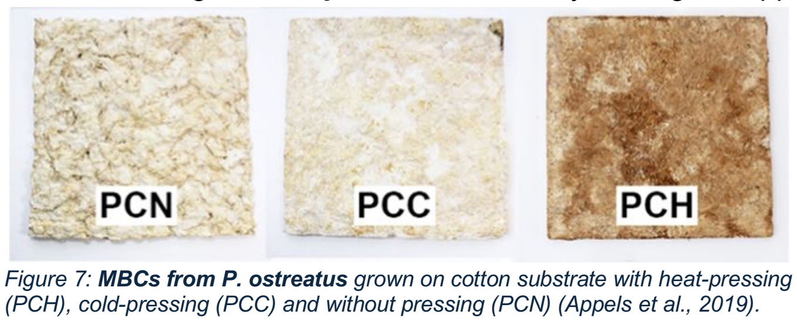
[picture p81: figure]

to outdoor usage.

Figure 6: Material family chart of the Young's modulus vs the density of pressed, cold-pressed, and heat-pressed MBCs

Figure 7: MBCs from P. ostreatus grown on cotton substrate with heat-pressing (PCH), cold-pressing (PCC) and without pressing (PCN) (Appels et al., 2019).

Additionally, coatings or resins could be applied to the (pressed) mycelium material to make the material more durable and the material properties more desirable for façade panel usage. In nature, mycelium can grow an outer fungal skin that protects the inner core of the mycelium from environmental elements like moisture and heavy rainfall (M. Zhang et al., 2023). Research has shown that this skin contributes heavily to the hydrophobicity of the material, as the absence of the fungal skin led to poor hydrophobicity of the outer layer. This is underlined by the fact that the filamentous fungi contain hydrophobic proteins and lipids, attributing to the hydrophobicity of the material.

But in the case of heat-pressed MBC’s, this hydrophobic outer skin and its function is mostly diminished and/or demolished. Hence, to improve hydrophobicity bio-based coatings could be explored to improve the lifespan of the material in outdoor application. For example, Farrahnoor et al. (2024) demonstrated that the usage of a beeswax-coconut oil mixture as a coating onto non-pressed MBCs led to a significant decrease of water absorption after submerging. While the non-coated MBC control absorbed about 261.65% of its own weight in water after five days, the MBC with 100% beeswax content only absorbed about 18.02% of its own weight. In addition, the coated units also showed a lower contamination rate by other fungi, as well as significantly slower material degradation. The 100% beeswax coating led to 20.57% weight loss after being buried in soil for four weeks, while the non-coated unit lost 88.72% of its weight. Although this research has been done on non-pressed MBCs, it could prove to be transferable when applied onto heat-pressed MBCs, pending further research in the Major Innovation Project.

For the application of façade panels, post-processing of MBCs, heat-pressing and coatings show significantly improved material properties and suitability compared to non-pressed and non-treated materials. The increase in density, stiffness, and tensile strength results in a more homogenous and reproducible material, which is essential for structural integrity and weather durability in the outdoor application of a façade panel. Additionally, the transition from a material in the foam category to more natural wood-like properties enhance the resistance to (permanent) deformation and stress. Applying bio-based coatings like beeswax could further improve the material properties needed for façade panels. However, despite these improvements, MBCs still need a lot of improving to be used in real construction purposes and façade panels.

Material properties needed for façade materials
A list of criteria has been drawn up to ensure that the selected materials meet the requirements for the installation of façade panels. Although great advances have been made in the field of mycelium materials in the last decennium, there are still significant shortcomings based on these criteria. This chapter will list and critically evaluate heat-pressed MBCs for the usage in façade panels and will show where the further research possibilities lie.

As mentioned before, the material properties of MBCs are dependent of type of species, substrate composition, growth conditions, and post-processing (Rovers & Wösten, 2026). The right combination of fungal strain and substrate can lead to thermal conductivity of as low as

0.026 W/mK. MBCs are one of the pioneering biomaterials in the field of insulation materials. MBCs have a thermal conductivity between 0.03 – 0.07 W/mK, which is comparable to the conventional insulation materials EPS with ~0.035 W/mK, and mineral wool with 0.04 W/mK (Elsacker et al., 2019; Pohl et al., 2022). This performance is attributed to the porosity of the hyphae network, which traps the pockets of air. F. fomentarius composites offer potential, combining good insulation, improved fire resistance, and a sustainable alternative to conventional wooden particle boards when pressed (H. Chen, 2026). However, the air bubbles inside provide the insulation properties, which would mean that heat-pressed mycelium would have less favourable insulation properties. Yet, more research needs to be done on the thermal conductivity of heat-pressed MBCs.

Furthermore, criteria were set for the weather resistance needed for a material used for façade panels. No research has currently been done on the UV resistance of MBCs, which is explained by the fact that MBCs have been mainly developed for indoor applications out of direct sunlight. This presents an interesting new avenue of research to be done on heat-pressed and non-pressed MBCs to move towards outdoor application. Water absorption rate and hydrophobicity however have been researched thoroughly. While MBCs with a thick velvety fungal skin show greater hydrophobicity, because of the hydrophobic proteins and lipids, this is diminished when the skin is taken away, as well as when the material is heat-pressed (M. Zhang et al., 2023). When pressed and non-pressed mycelium materials were placed in contact with water, all samples increased in mass, indicating significant moisture uptake (Appels et al., 2019). The sample with skin did, again, show significantly lower moisture uptake. In addition, the stability of the materials was affected by the environmental humidity. All materials showed significant expansion at 60% and 80% relative humidity for 192 hours. But the heat-pressed samples showed most significant gain at 80%, while staying more stable at 60%. The authors reason this could be because the increased moisture content from 60% to 80% leads to structural changes in the material, potentially leading to collapse of the inner porous structure. It was suggested that MBCs should be used in a layered system, sandwiched between two water-resistant layers to reduce expansion or deformation of the material while still retaining its mechanical qualities (Schultz et al., 2024). Schultz et al. (2024) has described how MBCs behave under simulated, accelerated weathering conditions. The MBCs showed limited structural degradation after weathering in the mycelium fibres, but cracking and damage to the fibres of the substrate. The combined application of increased heat and humidity reduced the water absorption of the material; this suggests that temperature plays a larger role in the degradation of the material than humidity. The experiments also showed that water absorption by the fibrous substrate led to a decrease in hardness of the material, but not in the overall durability of the composite. Based on the findings, it can be expected that freeze-thaw cycles mostly imitate moisture-related damage, such as internal substrate cracking and softening, rather than structural failure of the composite. It should be noted that a hydrophobic outer layer can prevent moisture from getting into the composite, which avoids these outcomes. Again, pointing at the importance of a much-needed bio-based coating for the pressed-MBCs used for façade panels.

Façade materials, to be applied onto high rise buildings have to be fireclass B, s2, d0. Lingam et al. (2023) showed that the best-performing MBC took more than 16 minutes before the heat fully penetrated the composite, which adheres to the “Ignitability with a small flame (EN ISO 11925-2): flame spread ≤ 150 mm within 20 seconds, following a 15-second exposure” of fireclass B (Measurlabs, 2026). S2 means that there is limited contribution to smoke production, which would need to be further investigated. Additionally, d0 means that no flaming droplets need to be produced in a fire. This seems highly unlikely, as the substrate inside the mycelium would most likely lead to separate flaming droplets falling. Once again, the application of a bio-based coating needed for fire resistance should be investigated. Usage of beeswax for example seems unlikely in that sense, as the material reaches its flash point and ignites and combusts at 204 °C (Huanbutta et al., 2026)

As mentioned before, the usage of MBCs in façade materials would most definitely become one of the more sustainable material options in the construction sector. As a comparative LCA showed, usage of MBCs have better climate change impact, compared to the conventional insulation materials EPC, sandwich panels, foam concrete and rockwool (Volk et al., 2024a). In addition, the usage of waste materials from the agriculture sector reduces the environmental impact even further. By growing on waste materials, that would otherwise be burned and emit CO2 in the process, MBCs act as a CO2 sink (Livne et al., 2022). Further analysis by Livne et al. (2022) showed that the incubation stage of MBCs makes up about 73% of the overall energy used to produce the material. Further advances in energy usage of the incubator could reduce the environmental impact of MBCs even further. It should be noted that end-of-life and usage was not considered in this LCA, but we will conduct an own comparative LCA on this matter soon (Volk et al., 2024a).

Table 11: Table of completed criteria for the Mycelium-Based Composites.

Criterion | Threshold or qualitative | Hard constraint or ranking criterion | Does the MBC comply

Cooling function

Thermal conductivity | Below 0.5 W/(m∙K) | Hard constraint | Yes, non-pressed MBCs: 0.03 – 0.07 W/mK (Elsacker et al., 2019; Pohl et al., 2022) Pressed MBCs: to be examined

Paint/coating

Paint/coating compatibility | Qualitative | Hard constraint | Yes, (bio-based) coatings and/or paint can be applied.

Weather resistance

UV resistance | Qualitative | Ranking criterion | To be examined in further research
Water absorption rate | Qualitative | Ranking criterion | At 60% relative humidity: 7% bodyweight increase At 80% relative humidity: 11% bodyweight increase (Appels et al., 2019)
Freeze-thaw resistance | Qualitative | Ranking criterion | To be examined in further research

Weight

Surface density | Below 10 kg/m² | Minimum requirement – Ranking criterion | Heat-pressed MBCs: up to 0.35–0.39 g/cm³ (Appels et al., 2019)

Fire resistance

Fire resistance | Fireclass B, s2, d0 | Ranking criterion | Fireclass B seems likely, but s2 and d0 less so

Sustainability

Recyclability | Qualitative | Hard constraint | 100% recyclable and renewable (Alemu et al., 2022)
Biodegradability | Qualitative | Ranking criterion | 100% biodegradable
Biobased content | Qualitative | Ranking criterion | 100% biobased

Formability & availability

Material availability | Qualitative | Hard constraint | Available in the fungal lab of Han Wösten
Material formability | Qualitative | Hard constraint | Further research should be done on the possibility of heat-pressing MBCs

| | | into a mold. Possibly to be investigated in this project.
Instrumentation availability | Qualitative | Hard constraint | Available in the fungal lab of Han Wösten
Prototyping feasibility | Qualitative | Hard constraint | To be further investigated

## Recommendations

The aim of our project is to design a façade panel that reduces the urban heat island effect. The design of the façade panel is built upon previous projects, where a specific three-dimensional shape was implemented to create a panel which exhibits convective cooling. In our project, we want to try and add radiative and/or reflective cooling properties to the panel by using a reflective or radiative coating or paint. Combining these two cooling strategies could potentially enhance the cooling properties of the panel. In this report, a literature review has been conducted to give recommendations which is the most suitable material for our project.

A specific set of requirements was used to systematically assess whether a material would be suitable for our project. This consisted of requirements on the thermal conductivity, weather resistance, weight, fire resistance, sustainability, formability, availability and paint or coating compatibility. It was concluded that wood would be the most suitable material for our project. Next, we assessed which type of wood would be the most suitable material.

Looking at the scope of our project, which excludes testing the durability of wood for an extended period of time but mainly focuses on the cooling properties of the panel, it can be concluded that the natural durability is of lesser concern, at least for the prototyping. Therefore, heavier, more durable wood species and types, such as modified wood (thermally or acetylated), oak, western red cedar and European larch can be eliminated for the final wood type choice. The main reason for this is that these types of wood are more expensive than the other types of wood and it is unnecessary to buy more expensive types of wood just because they are more durable, as durability testing will be outside of the scope of our project.

This leaves spruce, Scots pine, fir and Douglas fir as final potential wood types for the prototyping part of our project. As we want to apply specific radiative or reflective coatings on the wood, the coating/painting compatibility of the different types of wood is important to assess. Scots pine is a highly resinous tree species and resins can bleed through the surface with UV exposure, affecting the coating adhesion (Hill et al., 2022). The same can be said about spruce, which has a slightly lower resin content but still experiences the same problem, which is why both wood types can be eliminated.

Douglas fir has the benefit that it is naturally more durable, however, it is less permeable, which makes it more difficult to impregnate. Fir on the other hand is less durable but more permeable than Douglas fir. Fir, however, has one big downside, which is that it is not widely available in Dutch hardware stores. For this reason, in addition to the lower durability, it can be concluded that Douglas fir would be the most suitable wood type for our project.

However, after talking with CNC-milling and prototyping experts about our choice of material, we came to the conclusion that Douglas fir would be too thick for the design of the panel. This is why we chose to use plywood for the construction of our first prototype. Plywood can be as thin as 3 mm, can be easily milled with a CNC and is available in the facilities in which we are constructing our first prototype. The concern about the durability of plywood is less important, as we are first testing other properties of the panel, like convection and the ideal thickness of the material. If the design of the panel is optimized and needs to be tested for durability, specific moisture resistant and suitable outdoor plywood such as Okoume plywood is recommended.

For a design with thicker materials and a higher TRL, thermally modified spruce or pine or western red cedar would be the best type of wood. Both types have high natural durability, are lightweight and do not need extra treatment (apart from the prior thermal modification) for outdoor applications. However, for the scope of this project, where durability is not tested, price, sustainability and available thicknesses are more important, plywood is the recommended material, and the coating system must be selected and verified to be compatible with the wood prior to application.

MBCs are also a highly promising biomaterial for construction applications. One of the main advantages of MBCs is their low environmental impact and footprint, as they are produced from agricultural waste streams and require relatively low energy input in comparison to conventional materials like concrete, EPS, or stone wool (Volk et al., 2024a). Additionally, MBCs are fully circular, being 100% recyclable and renewable, biodegradable and are therefore extremely future-proof biomaterials. The material’s lightweight nature (with heat pressed MBCs at 0.35–0.39 g/cm³) makes them the ideal weight for façade panel materials and handle structural load requirements. Furthermore, their low thermal conductivity (0.03 – 0.07 W/mK for non-pressed MBCs) is comparable to that of conventional insulation materials and highlights their potential in that field, however, the performance of the heat-pressed MBCs needs more evaluation. This could be something that we investigate in this project.

However, MBCs have several limitations when applied as façade panel materials. One of the main drawbacks is the high water absorption of the material, losing its hydrophobic outer skin when heat pressed. Even when coatings are applied, high humidity or absorption can lead to swelling, deformation or degradation of the material. The mechanical strength also remains low in comparison to conventional materials. Even when heat-pressed, the material still performs like the least strong natural materials, not being near the Young’s modules of synthetic composites, ceramics or metals (Fig 5). Another concern that needs further investigation is the fire resistance performance of the material. Although fireclass B seems likely, s2 and d0 would seem less likely and need further investigation. In addition, long-term weather durability, like UV resistance and freeze-thaw conditions remain unexplored. These limitations clearly define our scope for further research.

Despite these challenges, MBCs are still selected as a material for this project. This is due to their significant potential in the future as sustainable biomaterials, as well as material availability and prototyping potential. As shown in this report, methods such as heat-pressing and application of coatings already significantly improve the material properties of MBCs, suggesting that current limitations could be diminished through further research. By investigating the formability of the heat-pressed MBCs in our façade panel shape, together with investigating weather resistance, the project aims to contribute to adding to the current knowledge gaps that are still in the field of MBCs in outdoor environment applicability.

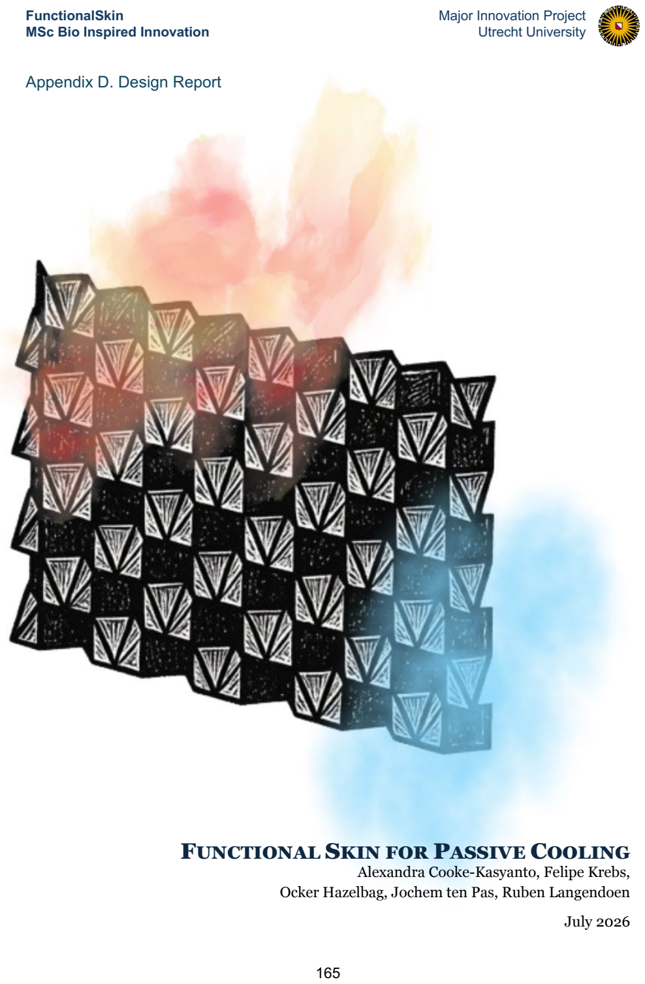
[picture p82: page 166]

Appendix D. Design Report

FUNCTIONAL SKIN FOR PASSIVE COOLING Alexandra Cooke-Kasyanto, Felipe Krebs, Ocker Hazelbag, Jochem ten Pas, Ruben Langendoen

July 2026

Index

This report is to follow the Biological Cooling Mechanisms report and will refer to it throughout. The contents of this report entail the design process following that research.
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
