OckerHazelbag/FunctionalSkin/Software/Arduino code/5b5cbd98-d906-4104-834a-2551902b59cb.JPG

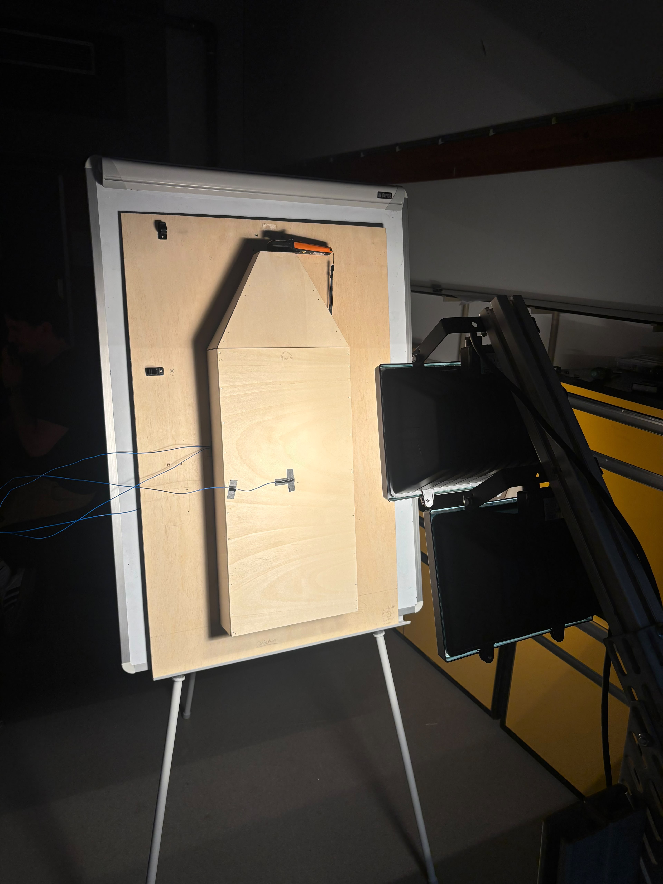
Software/Arduino code/5b5cbd98-d906-4104-834a-2551902b59cb.JPG
