OckerHazelbag/FunctionalSkin/Software/Fusion360 Files/Glue up mold jig.step

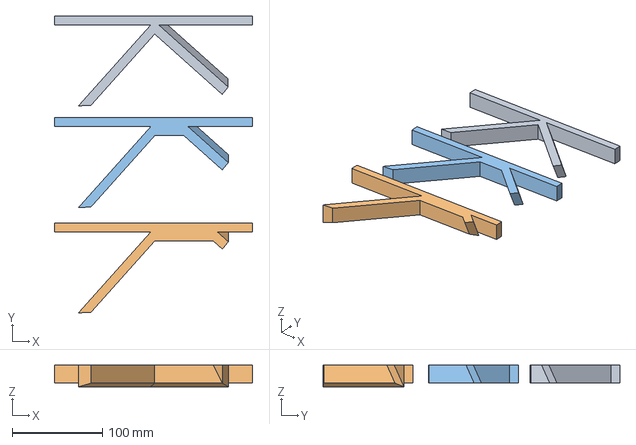
[picture p86: CAD file, 2026-10-22]
Software/Fusion360 Files/Glue up mold jig.step
220.0 x 329.9 x 24.1 mm
