OckerHazelbag/FunctionalSkin/Software/Fusion360 Files/Paneel rechts.stp

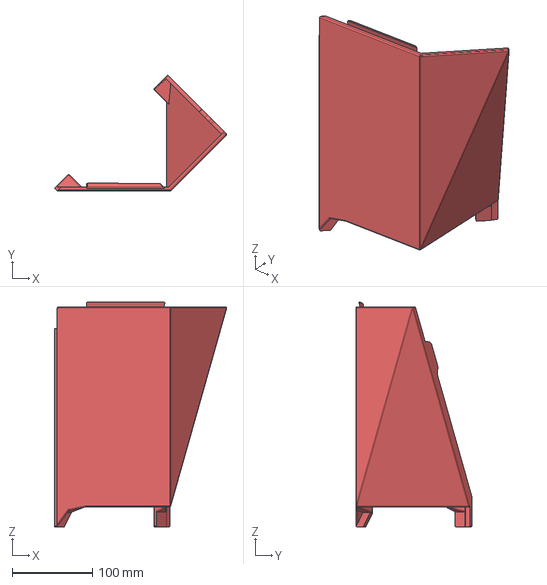
[picture p87: CAD file, 2026-10-22]
Software/Fusion360 Files/Paneel rechts.stp
215.0 x 145.0 x 281.0 mm
