OckerHazelbag/FunctionalSkin/(list of files, cad)

Other CAD files:
Software/Fusion360 Files/CAD-BLOCK-aanzichten.dwg
Software/Fusion360 Files/Insubark Panel.f3d
Software/Fusion360 Files/Mould texture v1.f3d
Software/Fusion360 Files/block design_.f3d
Software/Fusion360 Files/mould basic ridges v1.f3d
Software/Fusion360 Files/mould basic ridges v2 cleaned up.f3d
Software/Fusion360 Files/mould orgago v1.f3d
Software/Fusion360 Files/orgago shape v1 (cleaned up).f3d
Software/Fusion360 Files/orgago shape v2-for CNC and 3Dprinting.f3d
Software/Fusion360 Files/pressed block design v1.f3d
