OckerHazelbag/FunctionalSkin/Results/_readme.md

# Results
_For measurement or functional devices, it is good to report some results as a benchmark for others who try to replicate the project.
At a minimum, this would include some photos of your finished prototype in action and comments on its functioning. You are encouraged to include experimental data as well._
