OckerHazelbag/FunctionalSkin/Results/Figure A1 - Negative control.png

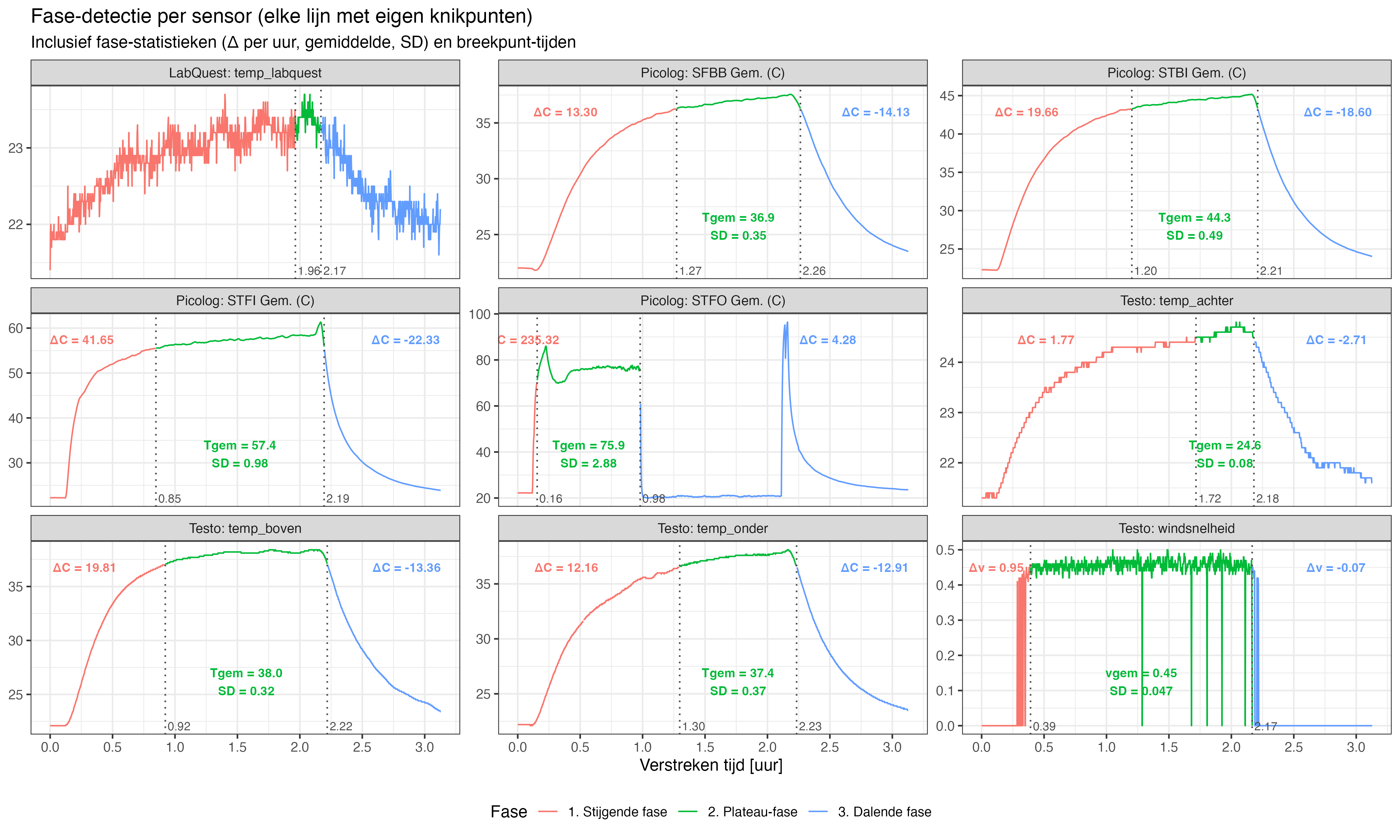
Results/Figure A1 - Negative control.png
