OckerHazelbag/FunctionalSkin/Results/Simplified panel experiments/Figure A2 - Standard panel.png

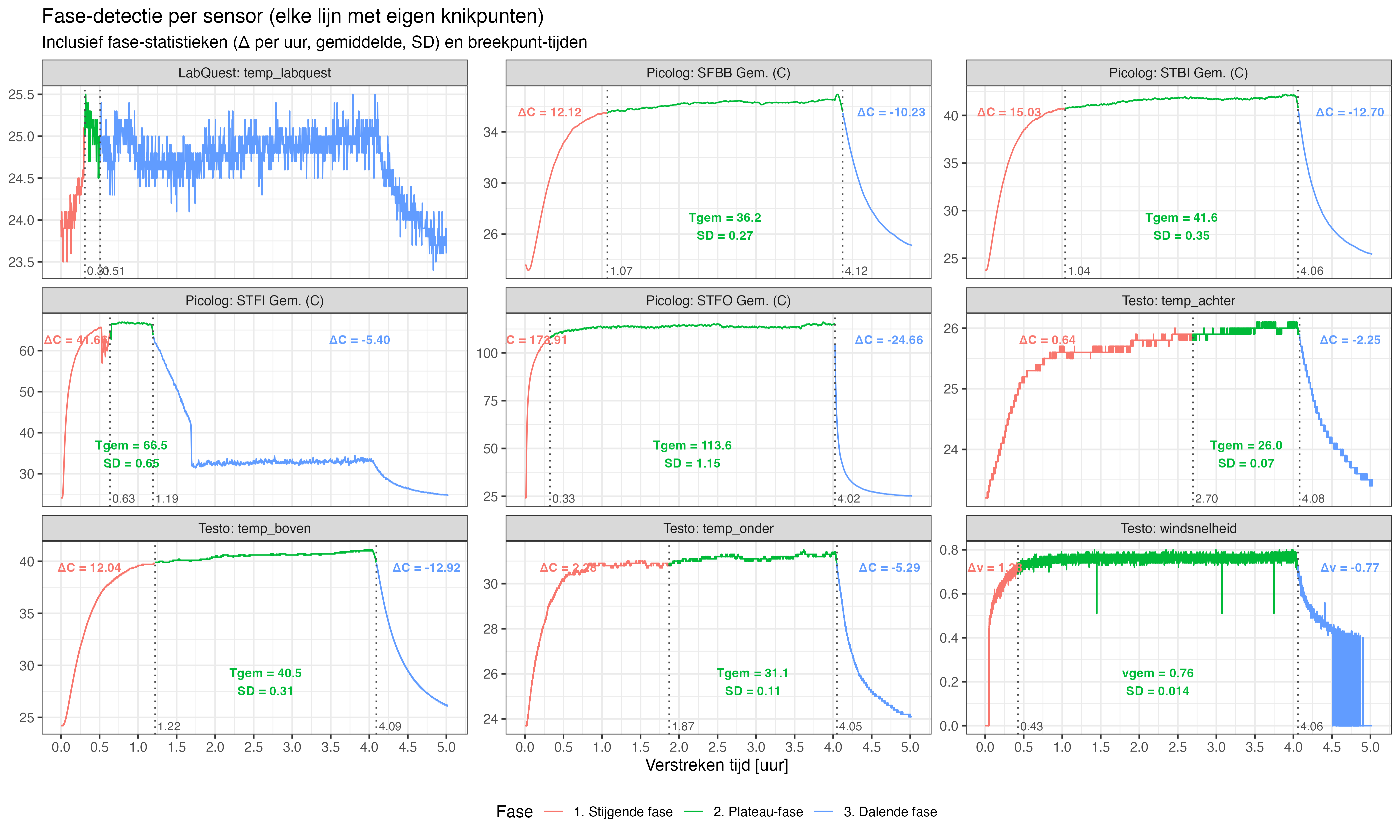
Results/Simplified panel experiments/Figure A2 - Standard panel.png
