OckerHazelbag/FunctionalSkin/Results/Simplified panel experiments/Figure A3 - Deep cavity panel.png

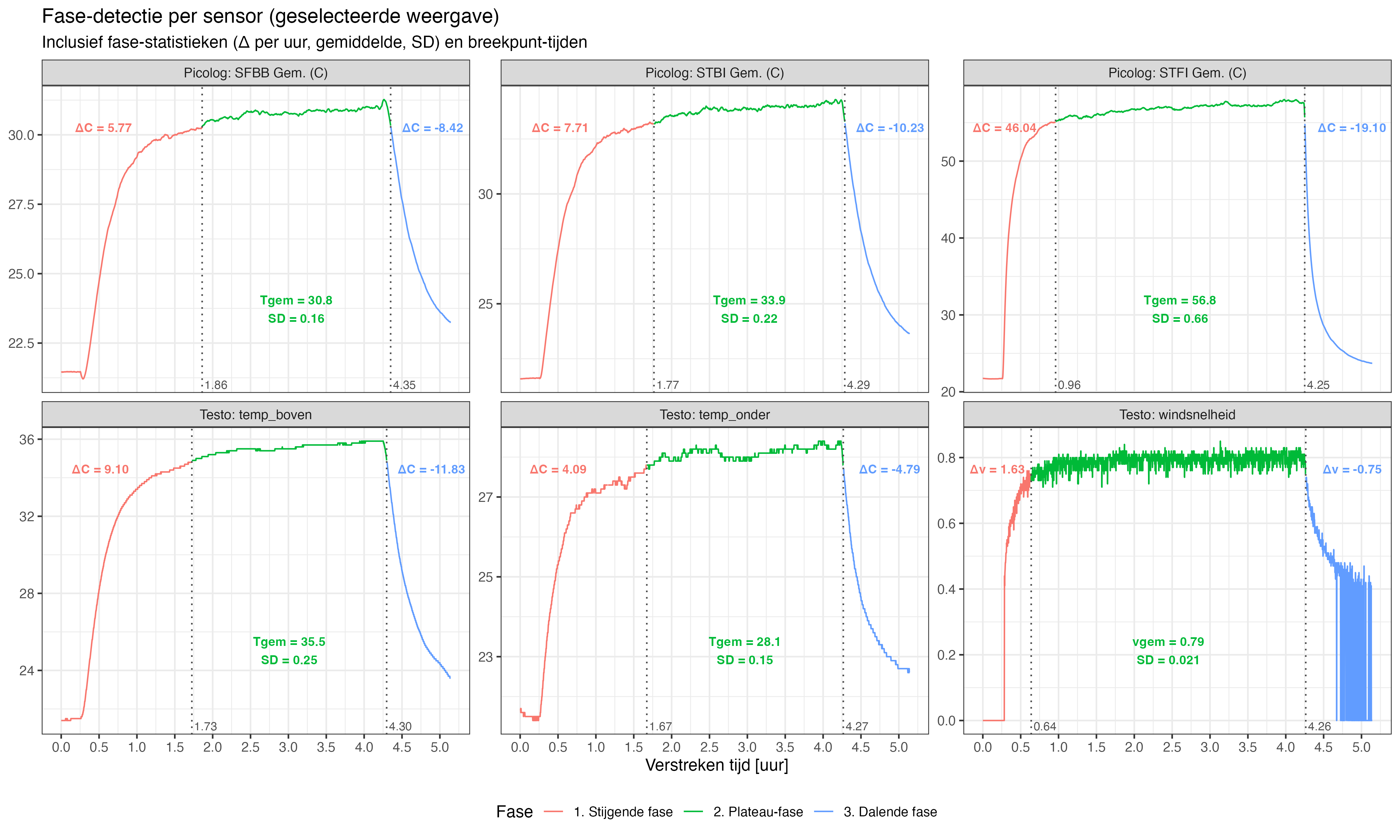
Results/Simplified panel experiments/Figure A3 - Deep cavity panel.png
