OckerHazelbag/FunctionalSkin/Results/Simplified panel experiments/Figure A5 - 12 mm plywood panel.png

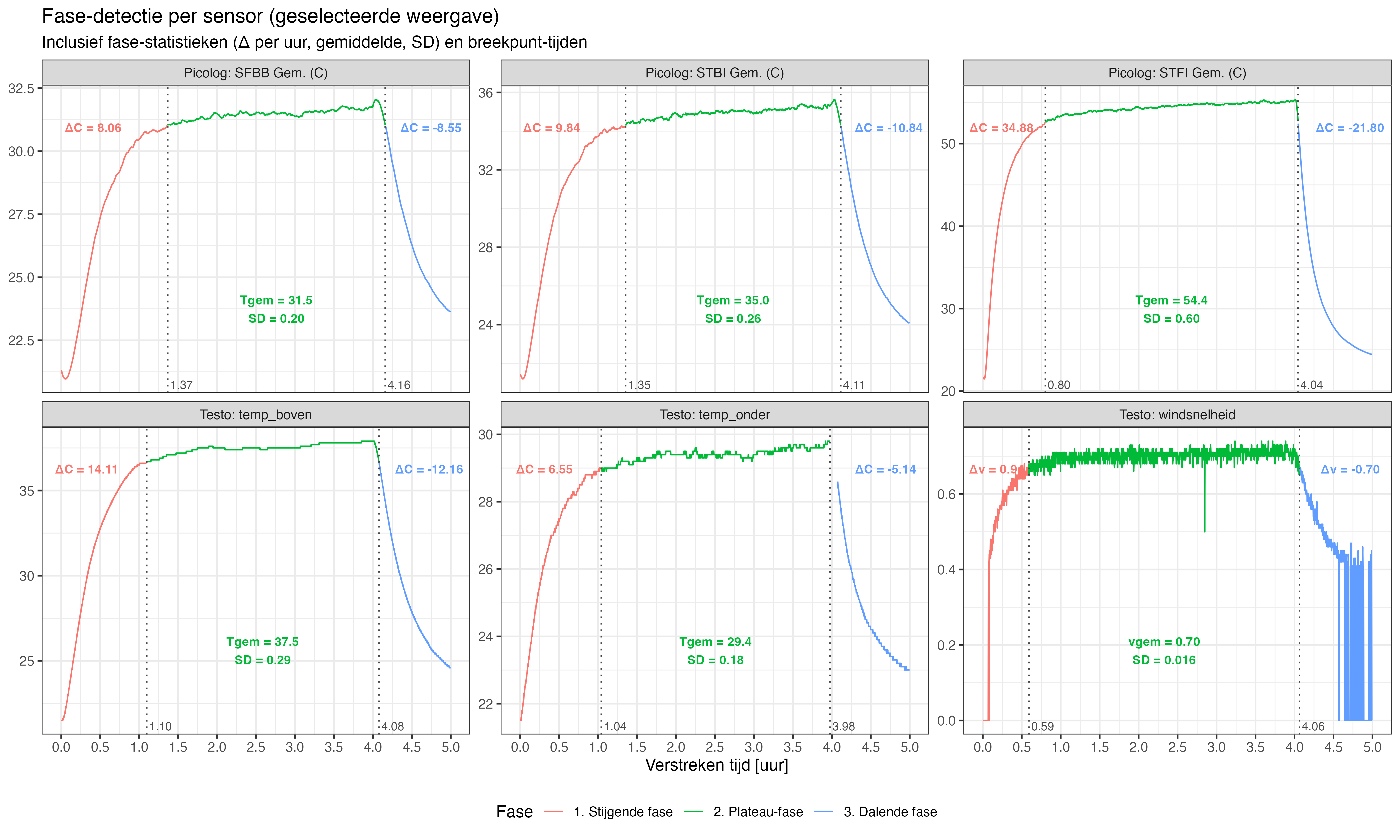
Results/Simplified panel experiments/Figure A5 - 12 mm plywood panel.png
