OckerHazelbag/FunctionalSkin/Results/Simplified panel experiments/Figure A6 - Albedo coated panel #1.png

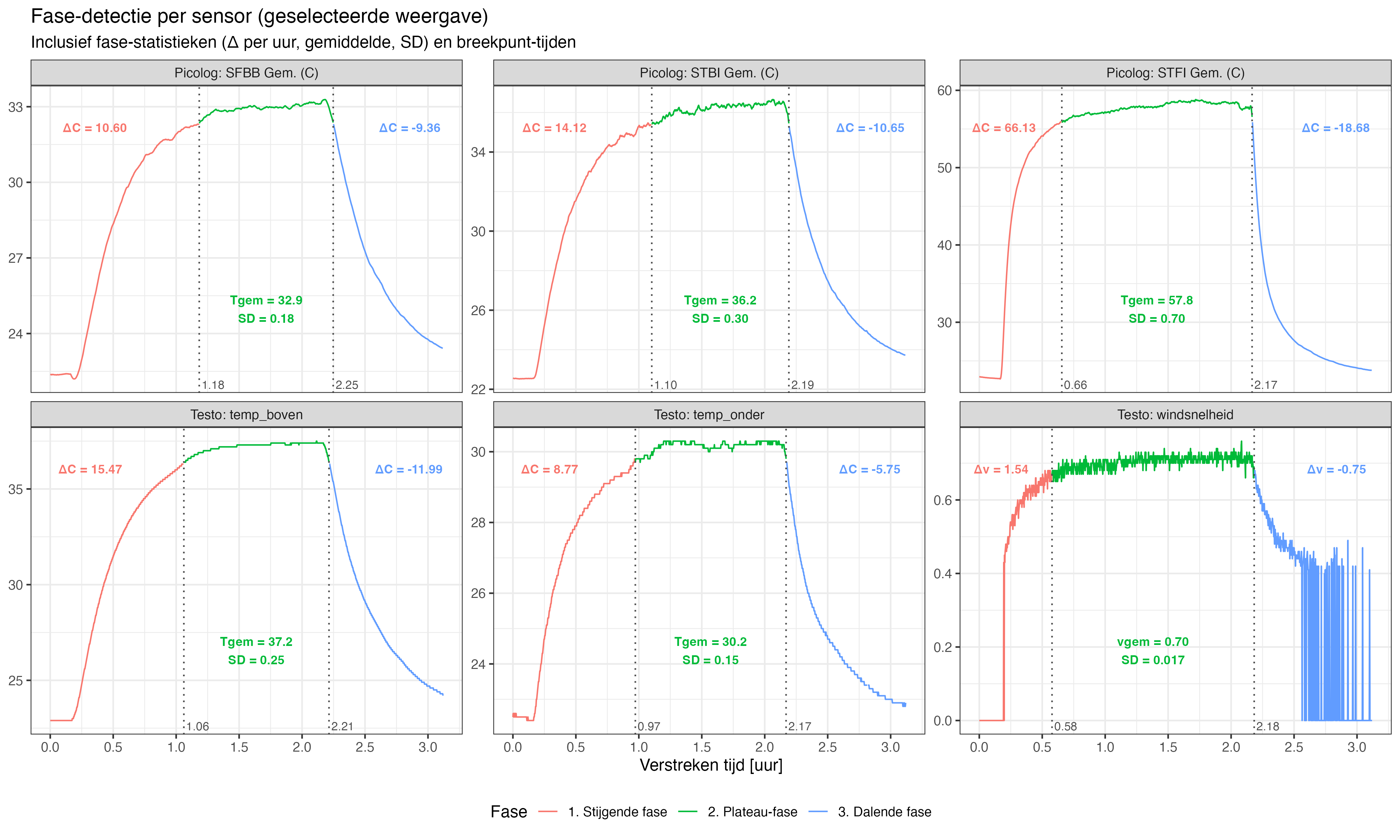
Results/Simplified panel experiments/Figure A6 - Albedo coated panel #1.png
