OckerHazelbag/FunctionalSkin/Results/Simplified panel experiments/Figure A8 - Cryopaint-coated panel #1.png

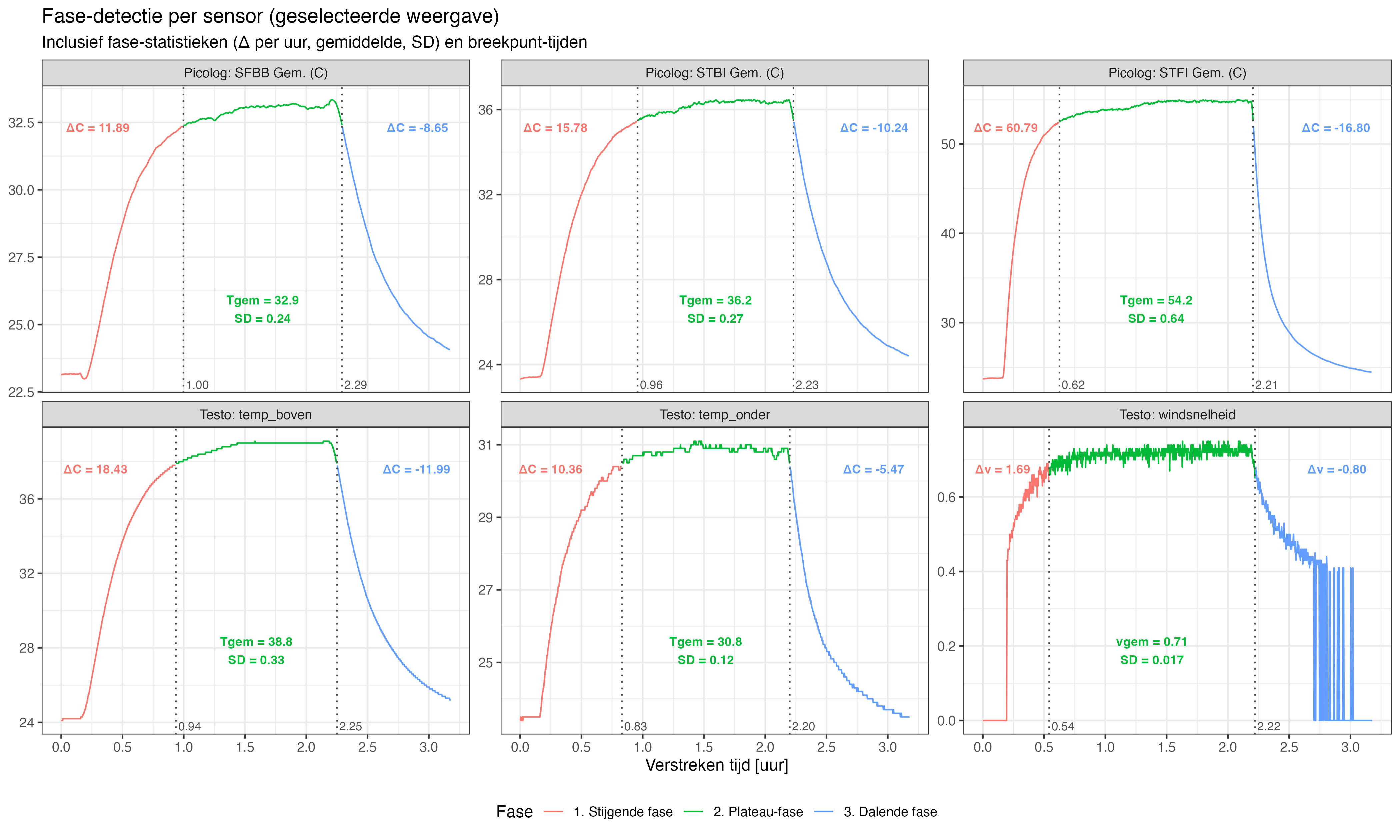
Results/Simplified panel experiments/Figure A8 - Cryopaint-coated panel #1.png
