OckerHazelbag/FunctionalSkin/(commit log)

2026-10-14 Revise README for clarity and structure
    Updated the README to reflect the current repository structure and build instructions.
2026-10-14 Update README with project features and structure
    Added details about the project's features, materials, and repository structure.
2026-10-14 Revise README introduction for better readability
    Reorganize introduction for clarity and flow.
2026-10-22 Update hardware description and build instructions
    Expanded the hardware description to include detailed information about the FunctionalSkin prototype, parts list, fabrication methods, tools, and build instructions. Added a section for a second prototype made of mycelium tiles.
2026-10-22 Revise material list with supplier details
    Updated supplier information and estimates for materials.
2026-10-22 Create Arduino
2026-10-22 Add files via upload
    This is the sketch where all 6 sensors were attachted to the arduino
2026-10-22 Supplementary figures and performance summary table
    Added supplementary figures and performance summary for shaft experiments, detailing sensor responses, phase segmentation, and key findings for various panel configurations.
2026-10-22 Supplementary figures and performance metrics
    Updated supplementary figures descriptions and performance summary table for shaft experiments.
2026-10-22 Rename Sketch_SDlogging_6sensors.ino to Arduino 6 sensor setup code
